Connicpu/thermostat/README.md

# Thermostat V3

Shared as-is — not seeking contributions or pull requests.

ESP32-C6 Zigbee thermostat for single-stage HVAC (R/C/W/Y/G), with e-paper display, SHT40 temperature/humidity sensor, and triac outputs. Designed for JLCPCB assembly.

## Gallery

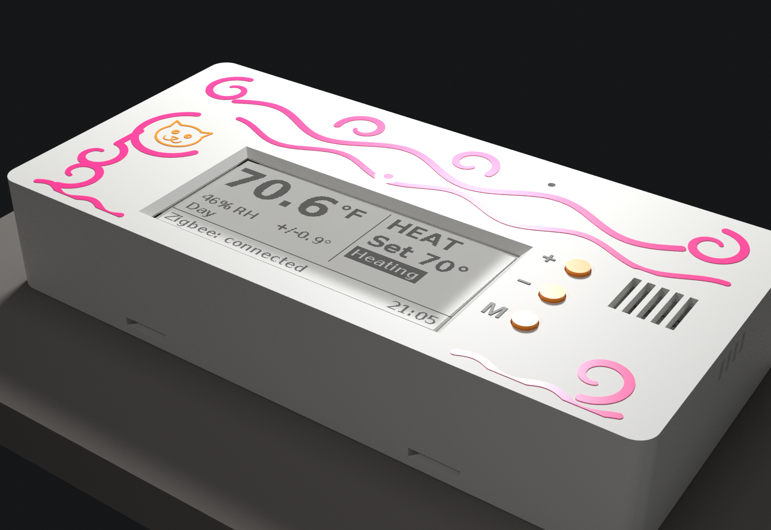
[picture p1: renders/v3-assembled.png]
Assembled V3 case — home screen at 70.6 °F, heating to 70°, Zigbee connected, 21:05 (Day)


On-device screens (296×128 e-paper, shown at 2×; °F):

| Home | Menu |
|---|---|
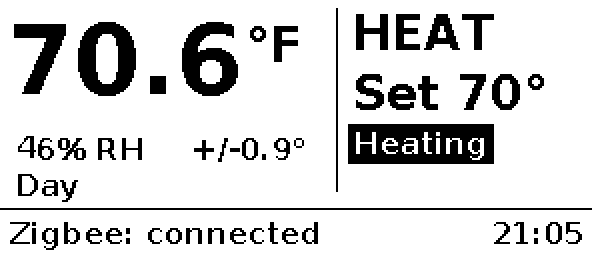
[picture p2: firmware/docs/display_preview.png]
home screen, 21:05
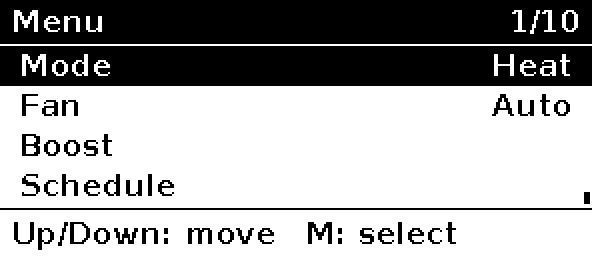
[picture p3: firmware/docs/display_menu_main.png]
main menu
|  |  |
| **Schedule** | **Boost to** |
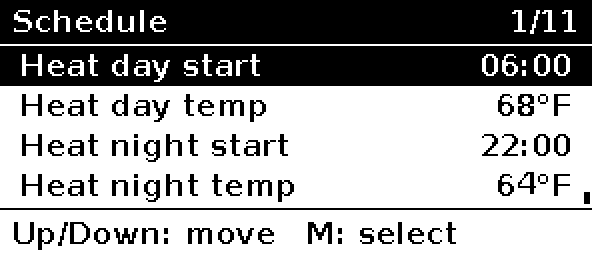
[picture p4: firmware/docs/display_menu_schedule.png]
schedule menu
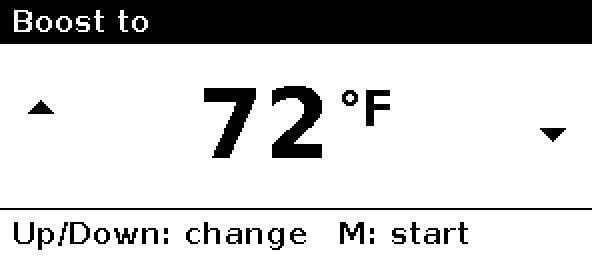
[picture p5: firmware/docs/display_menu_boost_target.png]
boost to target
|  |  |

Home Assistant Lovelace card ([install](firmware/ha/lovelace-card/README.md)):

| Heat, day (light) | Cool, night (dark) | Timed heat boost (dark) |
|---|---|---|
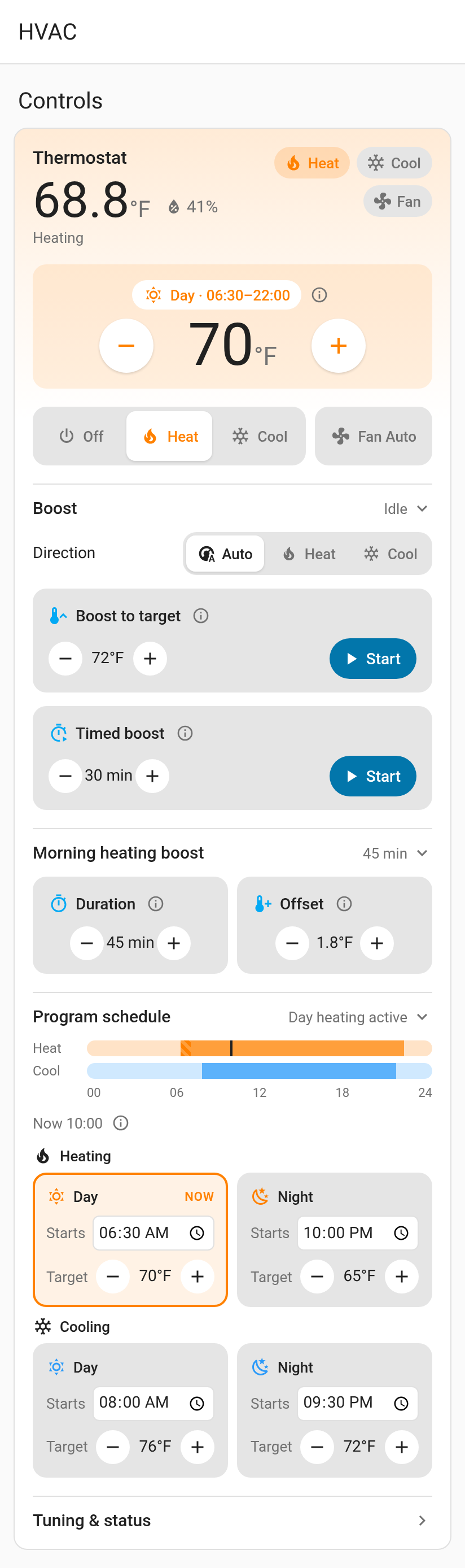
[picture p6: firmware/ha/lovelace-card/screenshots/heat-day-light.png]
card, heating by day, light theme
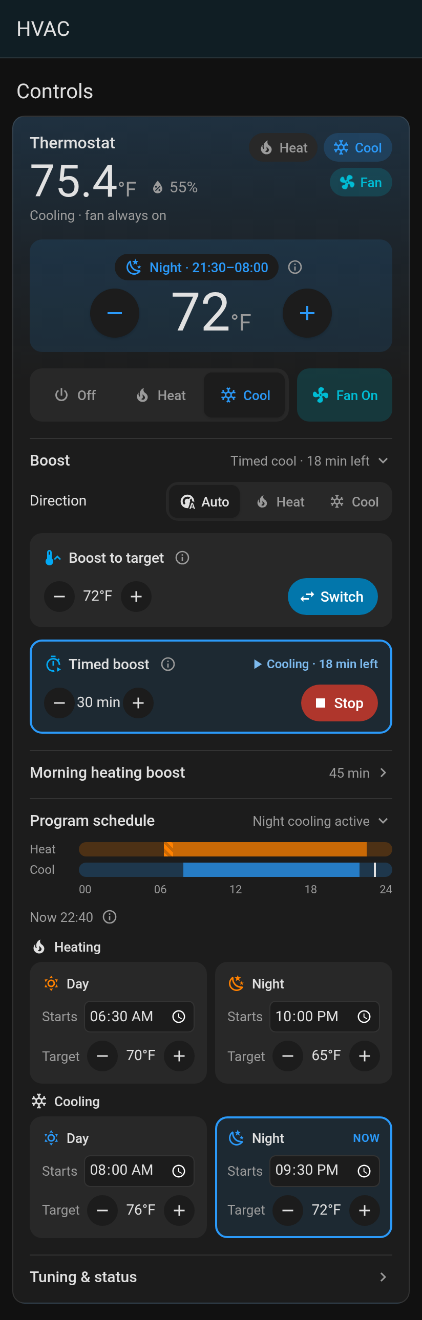
[picture p7: firmware/ha/lovelace-card/screenshots/cool-night-dark.png]
card, cooling at night, dark theme
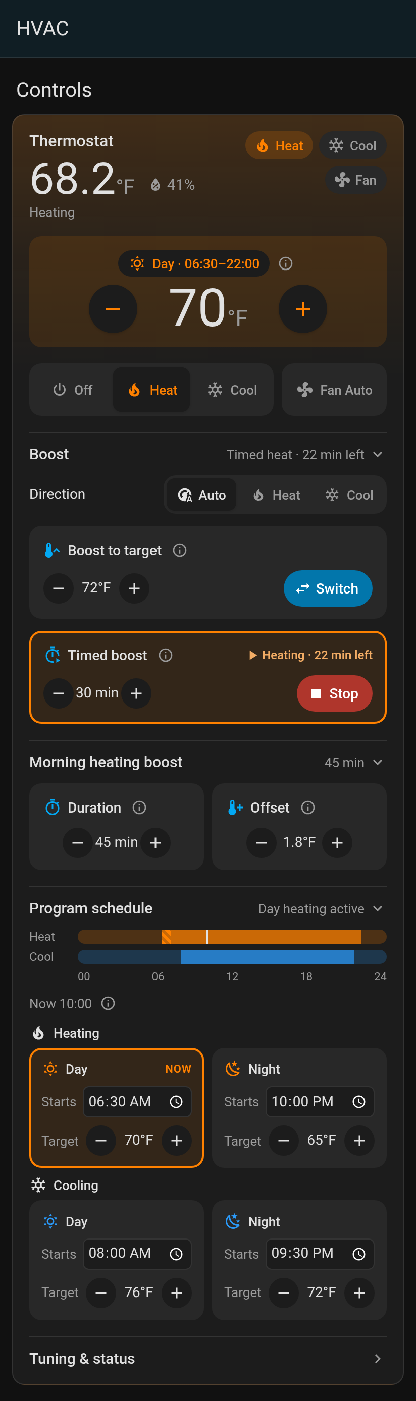
[picture p8: firmware/ha/lovelace-card/screenshots/heat-boost-dark.png]
card, timed heat boost running, dark theme
|  |  |  |

More: case renders in [case/](case/), every menu screen in [firmware/README.md](firmware/README.md).

## Case

The case (`case/thermostat_case.scad`) is a 147 × 71 × 26.25 mm PETG shell, backplate, and panel carrier for a Bambu P2S with a 0.4 mm nozzle. The carrier holds the display panel with its nominal back 4.45 mm above the board. The panel rests on stops 0.15 mm under that, located by the long-edge fences and the cable-end posts. Four bridges in the shell press the border. The flex plugs into J4 with the display panel seated on the stops. A thin corner can leave J4; the shell comes off, the tail is pressed back in, and the slider is closed. A fingernail shuts the slider on the ear's +x face, and a fingertip on the carrier push opens it toward +x. The shell clips to the backplate. It does not clamp the board. The three buttons snap into the face from the inside and stay in the shell. Each cap is a 65° cone and one 0.40 mm leaf. The leaf is a cantilever, free length 4.35 mm, and it only keeps the cap in the face. The print adds a 0.34 mm nub on the cone top under the free end so the leaf's bed-facing face is a bridge, and that nub is snapped off before the cap goes into the tube. [case/ASSEMBLY.md](case/ASSEMBLY.md) is the build order, the fold dimensions, and the service steps.

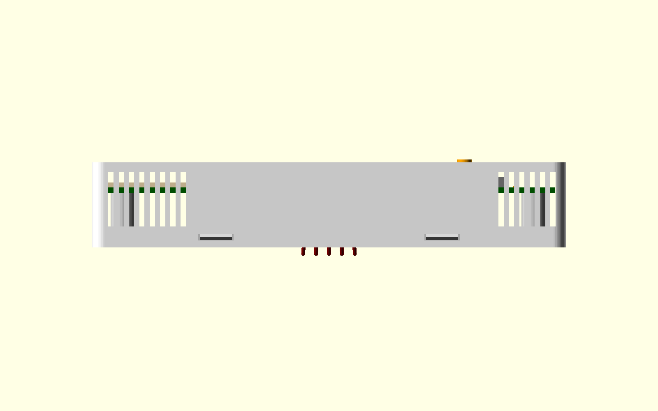
[picture p9: case/case-section-airflow.png]
Section through the sensor duct at the SHT40 (board y = 32). The two ribs divide the rear cavity; the front curtain and partition divide the face side.


Air inside the case is split into three zones:

- **Hot zone** (left). The triacs, the opto drive side, the buck, and the bridge. Slots in the bottom edge and the lower left wall let room air in. Matching slots in the top edge and the upper left wall let it out. A front curtain just left of the display keeps that air from spilling under the panel.
- **Middle zone.** The ESP32-C6, the display, and the wiring hole. This zone has no vents of its own. Close the hole in the wall around the cable with a printed PETG plug so that air stays in the middle zone.
- **Sensor duct** (right). The SHT40 island. Bottom-edge slots and a band of slots on the right wall feed it. The top-edge slots and the front island slots exhaust it. Two ribs on the backplate and a partition in the shell separate it from the middle zone. The backplate under the island is solid, because slots there would face the drywall and open the duct onto the wall.

The ribs stop 0.4 mm short of the board, and above the lip they run out to the lip's outer face so they come within 0.3 mm of the shell. The zone walls keep at least 0.5 mm off the parts, including the USB-C shield legs and locating peg on the back of the board. Front clearances include the ±0.16 mm board-thickness tolerance.

**Expected benefit.** A zonal model puts the triac-induced sensor rise about **10–25% lower** than the same case with one undivided cavity (no ribs, partition, or curtain). That is a model, not a measurement. Most of the remaining error is heat flowing along the PCB ground pour, which a case cannot stop, and the vents themselves carry only a small share of the hot zone's heat. The walls matter more than the hole count: they also help keep wall-cavity air from the wiring hole away from the sensor.

**Check it.** Log a heat call and a cool call against a reference thermometer, with a clamp meter on W, Y, and G. Taping the edge slots removes only the vents, about 6% of the modeled sensor rise; the ribs, partition, and curtain stay, so expect little difference. Measuring what the walls do needs a second print without the ribs, partition, and curtain. The two offsets add, so use only one. `CONFIG_THERMO_SELF_HEAT_OFFSET_C100` is build-time (`menuconfig`, then a reflash) and defaults to 0. ZHA sets the thermostat's LocalTemperatureCalibration attribute, in 0.1 °C steps over ±2.5 °C, applied on top of that build-time offset. About −0.1 °C is an unmeasured guess until a reference-thermometer log exists.

`board.stl` is not in the repo. From the repo root, export the populated board with KiCad 9 (do not pass `--drill-origin`; `scripts/case_fit.py` places the model):

```
kicad-cli pcb export stl -o board.stl --force --cut-vias-in-body kicad/thermostat-v3.kicad_pcb
```

The script header also has the OpenSCAD lines for the assembly-frame `back.stl`, `shell.stl`, `carrier.stl`, and the seated and pressed button meshes it checks against. The flex fold, the tail insertion, the carrier clearances, and the button travel run even when `board.stl` is absent.

- kicad/: KiCad 9 project
- fab/: Gerbers plus JLC BOM/CPL
- part-plan.md: part choices, sources, cost estimate
- v2-original/: the previous V2 design

Warning: don't connect USB while 24VAC is wired unless you use a USB isolator.
First-time flashing on Arch Linux: [docs/flashing-arch.md](docs/flashing-arch.md).

This project is shared as-is. It is not seeking contributions or pull requests.

## License

MIT — see [LICENSE](LICENSE). Third-party notices (Lit, Material Design Icons, DejaVu/Bitstream,
Espressif, Good Display sequences, LCSC STEP models, …) are in [NOTICE](NOTICE).

## Security

This is a DIY thermostat that switches 24 VAC HVAC loads. Treat the Zigbee network perimeter as
the security boundary:

- **OTA is unsigned.** The device accepts Zigbee OTA images and installs them with `esp_ota_*`
  (rollback via pending-verify exists). Anyone who can run an OTA server the device trusts can
  push firmware. There is no image signature check.
- **Join policy is open.** `install_code_policy` is false, so pairing uses the Zigbee 3.0
  well-known trust-center link-key path (normal for Home Assistant / ZHA). Don't leave the
  network open to joining when you aren't pairing.
- **USB Serial/JTAG console** is enabled in `sdkconfig.defaults`. Physical USB access to the
  board gives a console.
- Factory reset from the on-device menu is intentional.

See also [MANUFACTURER_ID.md](MANUFACTURER_ID.md) for the Zigbee manufacturer code (`0x434E`:
this project's DIY code from the quiet `0x3000`–`0x5FFF` band; not CSA-assigned, not certified).

## Third-party / display provenance

E-paper driver sequences in `firmware/components/display/ssd1680.c` follow Good Display's
GDEY029T94 sample/datasheet (not a verbatim copy of their sample tree). Full attribution is
in [NOTICE](NOTICE).
