Connicpu/thermostat/firmware/ha/lovelace-card/README.md

# Connie Thermostat V3 card

A custom Lovelace card for the thermostat, for Home Assistant with ZHA and the
[`connie_thermostat_v3` quirk](../zha_quirk/). It replaces the stock thermostat tile and the plain
number tiles with a single card that covers everything the quirk exposes.

| Light | Dark |
|---|---|
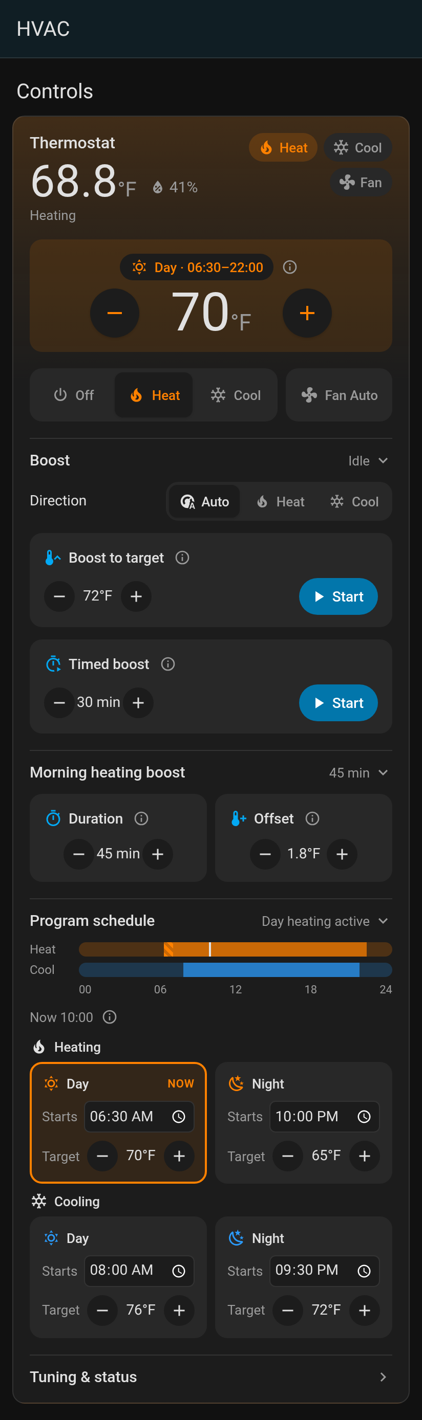
[picture p31: firmware/ha/lovelace-card/screenshots/heat-day-dark.png]
|  |  |
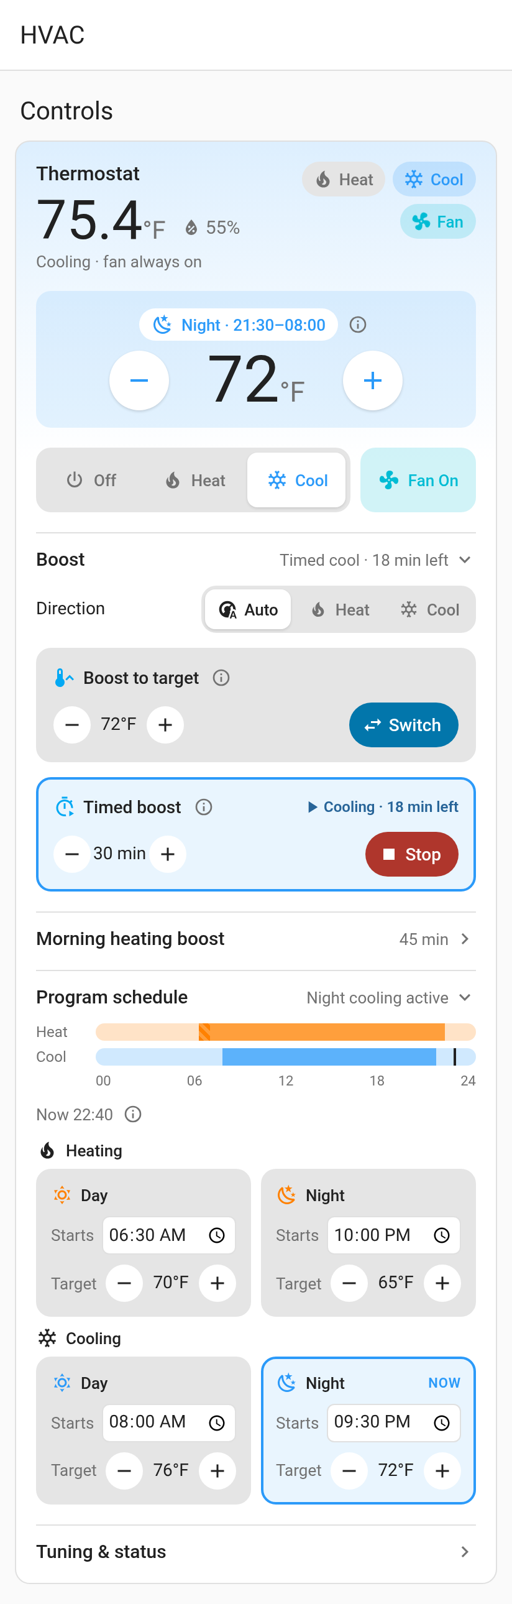
[picture p32: firmware/ha/lovelace-card/screenshots/cool-night-light.png]
|  |  |

## What it shows

* **Room:** temperature and humidity, plus Heat / Cool / Fan chips for the running state (`hvac_action`, fan mode).
* **Setpoint:** − / + buttons with a badge for the active program period (Day, Night, Morning boost, or
  "Day (no clock)") and its hours. The (i) next to the badge names the program value the buttons change,
  e.g. *Changes the Day heating program setpoint*. On the thermostat, the setpoint *is* the current
  period's program temperature. Taps are batched (0.5 s) into one `climate.set_temperature`; an unsent value shows in italics
  with a dotted underline, and screen readers hear "sending…". The value is a keyboard slider: arrows ±1 step,
  PageUp/PageDown ±5, Home/End min/max.
* **Mode:** Off / Heat / Cool only (any Auto / heat_cool is filtered out), plus a **Fan On / Auto** toggle.
* **Boost** (first, starts open): a Direction switch (Auto / Heat / Cool), then one tile per boost.
  *Boost to target* holds the target stepper and its Start button on one line; *Timed boost* does the same with the
  length. A running boost outlines its tile, shows the time left there, and its button turns into Stop.
  The other tile's button reads *Switch*, because the firmware replaces a running boost with a new one
  (`CtrlBoostStart`). Start flushes a not-yet-sent target or length first, so it never starts with a stale
  value. Start, Stop and Direction are disabled while the thermostat is unavailable.
* **Morning heating boost:** two tiles, Duration and Offset, each with its own stepper.
* **Program schedule:** a 24 h timeline for heating and cooling (day solid, night light, morning boost
  hatched, a marker for now). Below it, Day and Night tiles for each mode with the start time and target;
  the tile in use is outlined and tagged NOW.
* **Tuning & status:** temperature swing, temperature offset, program period, last boost result. Starts closed.
* **Help text** sits behind small (i) buttons, so the card stays quiet. Each opens on hover, focus or tap,
  closes on Esc (consumed only when a tooltip was open) or a click elsewhere, opens above its row (the setpoint one opens in place, on click/tap only, and pushes the value down), and is linked with `aria-describedby`.
* **Warnings** always stay visible: device unavailable, no clock yet (holding the day program), and failed boosts (rejected, failsafe, limit).
* **Failed writes:** if Home Assistant rejects a change, or doesn't answer within 10 s, the card drops the
  unsent value, doesn't start a boost that depended on it, and shows an error banner. The banner closes
  by itself after 10 s or with its × (Dismiss error) button.

Boost, Morning heating boost, Program schedule and Tuning & status collapse. The browser remembers
each section on its own for this card's climate entity and restores it when the dashboard is opened
again. Cards for different thermostats remember separately. Two cards or tabs on the same climate
entity each keep their own in-memory open and closed sections until a reload, which restores the
remembered state. `collapsed` adds sections that start closed when nothing is remembered for them;
a remembered choice wins. If storage is unavailable, the choice lasts for this visit and the next
visit uses the defaults.

While the thermostat is actively heating or cooling (its `hvac_action`), the top of the card
gets a soft orange or blue tint, like HA's own thermostat card. Idle, off and fan-only show no tint.

### Units
Temperatures follow Home Assistant's unit system. HA already converts the climate entity and the
temperature-class number entities, e.g. to °F. The swing, the morning-boost offset and the temperature
offset are temperature *differences*, so they have no temperature device class and HA leaves them in °C.
For a °F user the card shows them ×1.8 (0.5 °C → 0.9 °F, 0.1 °C → 0.2 °F) and still writes °C values
in the entity's own step. The offset entity is ZHA's standard *Local temperature calibration* number
(±2.5 °C, step 0.1), not a quirk entity. ZHA turns that number into the raw int8 with `int(°C / 0.1)`,
which is one tenth low for some steps (0.3 °C would be stored as 0.2). The card adds 1e-8 °C away
from zero on the write only, then clamps that number to the entity's −2.5 to 2.5 °C limits. The two
end steps already land on ±25, so they are sent unchanged. The tenth on screen is the tenth stored,
and the shown value stays on the 0.1 °C grid.

## Install

The card is the single file `dist/connie-thermostat-card.js`. Lit and the icons are bundled in, so it
makes no network requests.

**Manual (Lovelace resource)**
1. Copy `dist/connie-thermostat-card.js` to `/config/www/connie-thermostat-card.js`.
2. Go to Settings → Dashboards → ⋮ → Resources → Add resource, enter URL `/local/connie-thermostat-card.js`
   and pick type *JavaScript module*. In YAML mode, add it under `lovelace: resources:` instead.
3. Reload the browser, then edit the dashboard → Add card → **Connie Thermostat V3**.

**HACS (custom repository)**
1. HACS → ⋮ → Custom repositories → `https://github.com/Connicpu/thermostat`, type *Dashboard*.
2. HACS installs `connie-thermostat-card.js` from the **GitHub release asset** (see the root `hacs.json`).
   The release workflow attaches it (see *Releasing*). This repo keeps the card in a subfolder, and HACS
   only looks in the repo root, its `dist/`, or release assets.

## Configure
The visual editor has a device picker, filtered to manufacturer `Connie` / model `thermostat-v3`, a name,
section toggles, and an *Entity overrides* panel. With no device set, the card uses the first Connie
thermostat it finds. Entities are matched on the device by the quirk's `translation_key`, then by
entity_id suffix (e.g. `_day_heating_start`). The editor reports how many of the 25 entities it found.
YAML options are in [`example.yaml`](example.yaml):

| Option | Default | Meaning |
|---|---|---|
| `device_id` | first Connie thermostat-v3 | Device to show |
| `name` | device name | Card title |
| `show_schedule`, `show_morning_boost`, `show_manual_boost`, `show_status` | `true` | Show or hide a section |
| `collapsed` | `[status]` | Sections that start closed (`schedule`, `morning`, `boost`, `status`) when this browser has no remembered choice for them. They can still be opened by tapping, and that choice is what the next visit restores. Listing a section here only adds to the defaults |
| `entities` | auto | Override any discovered entity (keys as in `src/model.js` `ENTITY_KEYS`) |

## Releasing
Push a tag named `card-vX.Y.Z` (e.g. `git tag card-v1.0.0 && git push origin card-v1.0.0`).
`.github/workflows/card-release.yml` runs the tests, checks that `dist/` matches a fresh build, then
attaches `dist/connie-thermostat-card.js` and `dist/THIRD_PARTY_LICENSES.txt` to that tag's GitHub release, creating the release if needed.
The workflow has only `contents: write`, and every action is pinned by SHA. Bump `CARD_VERSION`
(`src/connie-thermostat-card.js`) and `package.json` first. Firmware tags don't trigger it.

**HACS installs from the newest GitHub release in this repo, whatever kind it is.** If a release without
`connie-thermostat-card.js` (e.g. a firmware release) becomes the latest, HACS can't install or update the card.
There is no firmware release workflow today, so this is enforced by hand: every release in this repo must have
`connie-thermostat-card.js` attached. For a manual firmware release, upload `dist/connie-thermostat-card.js`
too (`gh release upload <tag> firmware/ha/lovelace-card/dist/connie-thermostat-card.js`). Any future
firmware release workflow should attach it the same way `card-release.yml` does.

## Develop

```sh
npm ci
npm test              # vitest + happy-dom, mocked hass (test/mock-hass.js)
npm run build         # esbuild -> dist/connie-thermostat-card.js (commit it; CI checks it's up to date)
CHROME_PATH=/usr/bin/google-chrome npm run screenshots
                      # headless Chrome renders demo/ to screenshots/*.png (light + dark, plus boost close-ups),
                      # then opens every tooltip at 412 and 320 px and fails if one leaves the card or
                      # covers its own row's controls, and checks the run chip and Start/Switch/Stop text
                      # reach 4.5:1 contrast in both themes
```

`npm run screenshots` (and its geometry check) needs a local Chrome or Chromium. It uses `CHROME_PATH`, or
`--chrome /path`, and falls back to `/usr/bin/google-chrome`. playwright-core never downloads a browser.

`demo/index.html` loads the built card with the mock hass and HA's default light/dark theme variables.
Serve this folder and open `demo/?theme=dark&scenario=cool-night`. The scenarios are `heat-day`,
`cool-night`, `morning-boost` and `tooltip` (the setpoint tooltip pinned open).

Source: `src/model.js` (discovery, units and schedule maths; no DOM), `src/connie-thermostat-card.js`,
`src/editor.js`, `src/styles.js` and `src/icons.js`.

## License

MIT (repo root). Bundled Lit (BSD-3) and @mdi/js (Apache-2.0 / Pictogrammers) notices ship in `dist/connie-thermostat-card.js`; the full Lit BSD-3 text is in `dist/THIRD_PARTY_LICENSES.txt` (also attached to each card release); see also the repo [NOTICE](../../../NOTICE).

## Changelog

* **1.3.0**: Tuning & status has a temperature offset control. It writes ZHA's Local temperature calibration number, ±2.5 °C in 0.1 °C steps, and shows that difference in the display unit.
* **1.2.0**: text on the card can be selected. Each collapsible section remembers whether it is open or closed, stored in the browser per climate entity, and falls back to the defaults when storage is unavailable.
* **1.1.1**: a running boost tile (and its run chip) uses the heat or cool colour of the boost, with "Heating"/"Cooling" in the chip text; unknown direction keeps the theme accent. Morning boost tiles use the heat colour while running. New heat-boost demo scenario. Run chip and Start/Switch/Stop text meet 4.5:1 contrast in both themes (checked by the screenshot script).
* **1.1.0**: boost redesign (each value sits on the control that sets it; Start/Switch/Stop on the same
  tile); boosts above the schedule; explainers moved into info tooltips; accessible setpoint slider;
  Start waits for pending writes; 10 s service-call timeout; dismissible error banner; heating/cooling
  tint on the top of the card.
* **1.0.0**: first release.
