Connicpu/thermostat/part-plan.md

# Thermostat V3 – Part Plan (current: rev 14, 2026-10-13)
This top section describes the board. The sections under "Change history" further down are kept for traceability; parts named there (BT136S, T435, SMBJ40A, 100 µF bulk, 68 µH / 3 Ω EPD boost, Si1308) are **superseded**.
The authoritative BOM is fab/thermostat-v3-BOM-JLC.csv, with prices and stock in fab/bom_prices.json (JLC API).

## Architecture (current)
- **24VAC input:** R goes through F1 (mSMD050-60V, a 0.5 A 60 V PTC) to the MB10S bridge D1. D1 + goes through R51 (3.3 Ω 0.75 W pulse-proof) to VIN_HV.
  - VIN_HV has D2 (SMBJ40CA TVS), C1/C2/C41/C42 (4.7 µF 100 V X7R 1210) and C43 (47 µF 63 V, 8x9 THT, back side, hand-soldered).
  - D1 − is board GND, so board GND is **not** HVAC C.
- **3.3 V supply:** an LMR16006XDDCR buck (60 V, 0.6 A, 700 kHz) with L1 (22 µH SWPA6045S220MT, Isat 2.2 A), D4 (SS210) and an FB divider of 33k/10k (3.29 V). R50 (100k) pulls EN up to VIN.
- **USB (flash only):** USB-C J2, with VBUS going through D3 (SS210) into VIN_HV, so it can't backfeed from 24 V. D+/D- go to C6 IO13/IO12 with USBLC6 ESD, and CC1/CC2 have 5.1k each.
  - **Never connect USB while 24VAC is wired.** There is a silk warning beside J2 and near the buttons.
- **MCU:** ESP32-C6-WROOM-1-N8, Zigbee sleepy end device.
- **HVAC outputs W/Y/G:** GPIO → 220R → MOC3063S (zero-cross; 10k pull-downs on the drive lines). The opto output gets 100R from R, there's 1k from gate to MT1, and the triac is a **T405-600B** (ST logic-level, IGT 5 mA, IH 10 mA, 4 A 600 V, DPAK; tab = MT2 = R).
  - The RC snubbers (R24/R34/R44 100R + C20/C21/C22 100 nF) are **DNP**.
- **Watchdog:** STWD100NYWY3F, with WDO going to EN. ~EN has a 10k pull-up, so it stays disarmed until firmware drives IO11 low; firmware kicks it on IO10.
- **Display:** GDEY029T94 2.9" (SSD1680) on J4, an AFC07 24-pin 0.5 mm FPC, wired for 4-wire SPI (BS1 to GND).
  - Boost: L2 47 µH (ANR3015T470M), Q1 AO3400A, R16 2.2 Ω RESE, R15 1M gate pull-down, D6-D8 B5819W, C40 4.7 µF 25 V, plus 1 µF 50 V on VSH1/VSH2/VSL/VGH/VGL/VCOM and 1 µF on VDD.
- **Sensor:** SHT40-AD1B (0x44) on a slotted thermal island; only +3V3/GND/SDA/SCL may enter (DRC rule). There's also a Stemma QT port (J3, DNP).
- **UI:** UP/DOWN/MODE buttons (IO4/IO5/IO3), RESET, BOOT (IO9) and a red LED on IO8.
- **Hand-soldered / not assembled by JLC:** J1 (15EDGRC-3.5-05P right-angle header, back side, with the 15EDGK-3.5-05P plug) and C43. J3 is optional.

## Current BOM (JLC assembled; 37 lines)
| Refs | Value | Footprint | LCSC | JLC type | Notes |
|---|---|---|---|---|---|
| R21,R31,R41 | 220R | R_0402_1005Metric | C25091 | basic |  |
| C40 | 4.7uF 25V | C_0805_2012Metric | C1779 | basic |  |
| L2 | 47uH | L_APV_ANR3015 | C7427088 | extended |  |
| C30,C31,C32,C33,C34,C35 | 1uF 50V | C_0603_1608Metric | C15849 | basic |  |
| Q1 | AO3400A | SOT-23_AO3400A | C20917 | basic |  |
| Q2,Q3,Q4 | T405-600B | TO-252_BT136S | C283473 | extended | T405-600B-TR (ST T4 logic-level, IGT 5mA IH 10mA) |
| R2,R5,R6,R7,R8,R9,R11,R12,R20,R30,R40 | 10k | R_0402_1005Metric | C25744 | basic |  |
| C4,C5,C7,C39 | 10uF | C_0603_1608Metric | C19702 | basic |  |
| C3,C8,C10,C11 | 100nF | C_0402_1005Metric | C1525 | basic |  |
| D3,D4 | SS210 | SMA_SS210 | C14996 | basic | SS210 100V 2A Schottky |
| C6,C9,C36,C38 | 1uF | C_0402_1005Metric | C52923 | basic |  |
| SW1,SW2,SW3,SW4,SW5 | TS-1187A-B-A-B | SW_TS1187A | C318884 | basic |  |
| R1 | 33k | R_0402_1005Metric | C25779 | basic |  |
| U1 | LMR16006XDDCR | SOT-23-6_LMR16006 | C87080 | extended |  |
| R23,R33,R43 | 1k | R_0805_2012Metric | C17513 | basic |  |
| J2 | USB-C | USB_C_Receptacle_HRO_TYPE-C-31-M-12 | C165948 | extended |  |
| R22,R32,R42 | 100R | R_0805_2012Metric | C17408 | basic |  |
| U3 | ESP32-C6-WROOM-1-N8 | ESP32-C6-WROOM-1 | C5366877 | extended |  |
| R3,R4 | 5.1k | R_0402_1005Metric | C25905 | basic |  |
| D5 | RED | LED_0603_KT | C2286 | basic |  |
| R13,R14 | 4.7k | R_0402_1005Metric | C25900 | basic |  |
| R50 | 100k | R_0402_1005Metric | C25741 | basic | 0402WGF1003TCE |
| U4 | STWD100NYWY3F | SOT-23-5_STWD100 | C46043 | extended |  |
| U5 | SHT40-AD1B | Sensirion_DFN-4_1.5x1.5mm_P0.8mm_SHT4x_NoCentralPad | C2909890 | extended |  |
| C1,C2,C41,C42 | 4.7uF 100V X7R | C_1210_3225Metric | C381466 | extended | FS32X475K101EGG |
| J4 | 2.9in EPD FPC | FPC24_AFC07 | C262567 | extended |  |
| U6,U7,U8 | MOC3063S | MOC3063S | C77950 | extended |  |
| R16 | 2.2R | R_0603_1608Metric | C22939 | basic |  |
| R15 | 1M | R_0402_1005Metric | C26083 | basic |  |
| D6,D7,D8 | B5819W | SOD-123_B5819W | C8598 | basic |  |
| D1 | MB10S | MBS_MB10S | C2488 | basic |  |
| D2 | SMBJ40CA | SMB_SMBJ40A | C19077590 | preferred-ext | SMBJ40CA (bidirectional, JLC preferred-extended) |
| F1 | 0.5A 60V PTC | F1812_PTC | C70113 | extended | mSMD050-60V |
| R10 | 1k | R_0402_1005Metric | C11702 | basic |  |
| R51 | 3.3R 0.75W pulse | R_1206_3216Metric | C844038 | extended | CRCW12063R30FKEAHP (Vishay pulse-proof, 750 mW) |
| L1 | 22uH | L_Sunlord_SWPA6045S | C83454 | extended | SWPA6045S220MT 22uH Isat 2.2A 89mOhm |
| U2 | USBLC6-2SC6 | SOT-23-6_USBLC6 | C7519 | extended |  |

## Layout rules (kicad/thermostat-v3.kicad_dru)
- `hv_to_lv_clearance`: at least **0.6 mm** between HVAC_*, R_FUSED, VIN_RECT, OPTO_MT2_*, GATE_* and SNUB_* and any other net (IPC-2221B B2, 31-100 V).
- `hv_pour_clearance`: the GND pour stays at least **1.0 mm** from those nets.
- OPTO_GAP_U6/U7/U8: keepouts on both F.Cu and B.Cu over the isolation gap between each opto's output pins (4-6) and LED pins (1-3), x 132.3-137.1 mm. They block tracks, vias and copper pour, so the gap has 0 mm² of copper. `opto_gap_no_lv` remains as a backstop.
- Thermal island: only sensor nets, with traces of 0.25 mm max. Antenna keepout under the C6 antenna.

## Pin map (ESP32-C6-WROOM-1) – matches firmware/main/board.h
| Pin | GPIO | Net |
|---|---|---|
| 8 / 9 / 27 | IO0 / IO1 / IO2 | DRV_W / DRV_Y / DRV_G |
| 4 / 5 / 26 | IO4 / IO5 / IO3 | BTN_UP / BTN_DOWN / BTN_MODE (10k pull-ups) |
| 6 / 7 | IO6 / IO7 | I2C SDA / SCL (4.7k) – SHT40 + Stemma QT |
| 10 | IO8 | LED_STAT (active-low, 10k pull-up, strap) |
| 15 | IO9 | BOOT button (strap) |
| 11 / 12 | IO10 / IO11 | WD_WDI / WD_EN (active-low arm) |
| 13 / 14 | IO12 / IO13 | USB D- / D+ |
| 16–21 | IO18–23 | EPD MOSI, SCK, CS, DC, RST, BUSY |
| 23, 24, 25 | IO15, RXD0, TXD0 | not connected |

## Installation notes
1. Turn off power to the furnace/air handler (24 VAC transformer) before touching the wires.
2. Mount the backplate on the drywall with the anchors, pulling the R, C, W, Y and G wires through the centred hole.
3. **Close the wire hole** with a printed PETG plug around the cable, the same material as the case. Wall-cavity drafts otherwise blow over the SHT40 and skew the reading.
4. Wire the 15EDGK plug: R, C, W, Y, G left to right, as printed on the back silk under J1. Then plug the board in and close the case.
5. Never connect USB while the 24 VAC plug is in, because board GND is the bridge's negative node. Flash on the bench.

---
# Change history (superseded entries; kept for traceability)
## (rev 2 original header and architecture – superseded)
> ## Architecture (as implemented in kicad/thermostat-v3.kicad_sch)
> - **24VAC input:** 24VAC R/C goes through a 0.5 A 60 V PTC (F1), an MB10S bridge (D1) and a 3.3 Ω pulse resistor (R51) to VIN_HV, which has the SMBJ40A TVS (D2), 4× 4.7 µF 100 V ceramics and the 47 µF/63 V rear electrolytic (C43).
> - **3.3 V supply:** an **LMR16006X buck (60 V max, 0.6 A, 700 kHz)** with a 22 µH inductor and SS210 catch diode makes +3V3.
>   - The X (700 kHz) version was chosen over the Y (2.1 MHz) version because the minimum on-time at ~40 V in → 3.3 V out is too short at 2.1 MHz.
> - **USB:** USB-C VBUS goes through a B5819W into VIN_HV (diode-OR; the bridge itself is the other "diode"). USB D+/D- go straight to the C6's native USB, with USBLC6 ESD protection.
> - **MCU:** ESP32-C6-WROOM-1-N8 (Zigbee). **Firmware default: Zigbee end device** (rx-off-when-idle / light-sleep between polls) to limit self-heating. A router role is optional later.
> - **HVAC outputs, ×3 (W, Y, G):**
>   - GPIO → 220R → MOC3063 zero-cross opto (10k pull-down on each drive line, so outputs are off when the GPIO is high-Z)
>   - opto → 100R from R, 1k gate-MT1 → BT136S-600D triac switching R onto W/Y/G
>   - **DNP RC snubber footprint per channel** (100R 0805 + 100 nF 50 V 0805, across MT2–MT1)
> - **Watchdog:** STWD100NY (1.6 s), open-drain WDO wired to ESP EN.
>   - Its ~EN pin has a 10k pull-up, so the watchdog is **disarmed at boot and while flashing**.
>   - Firmware arms it by driving IO11 low and kicks it on IO10.
>   - If firmware hangs → watchdog resets the ESP → GPIOs go high-Z → triacs off.
> - **Display:** 2.9" 296×128 SSD1680 panel (GDEY029T94 / Waveshare 2.9" V2) on a 24-pin 0.5 mm FPC.
>   - Onboard boost per the Waveshare reference schematic: **68 µH**, Si1308EDL, **3 Ω sense resistor (B/W 2.9")**, 10k gate pull-down, 3 Schottky pump diodes (B5819W, which is basic, instead of MBR0530), and 1 µF caps on VSH1/VSH2/VSL/VGH/VGL/VCOM/VDD/VPP.
>   - BS1 is tied to GND (4-wire SPI).
> - **Sensor:** SHT40 on a slotted thermal island (4 slots, power/I2C enter through one bridge, no GND pour on the island), plus a Stemma QT port.
> - **UI:** UP / DOWN / MODE buttons, RESET and BOOT buttons, and one red status LED (IO8; pull-up keeps the strap pin high).
>

## Verified changes since rev 1
| Item | Decision | LCSC | Type | Stock | Unit $ |
|---|---|---|---|---|---|
| Buck | **LMR16006XDDCR** (4–60 V in, 0.6 A, async) | C87080 | ext | 33,642 | 0.57 |
| Buck inductor | SWPA6045S220MT 22 µH, Isat 2.2 A, 89 mΩ, 6×6×4.5 (rev 9; was SWPA4030S220MT C83472) | C83454 | ext | 40,752 | ~0.10 |
| Surge resistor R51 | CRCW12063R30FKEAHP 3.3 Ω 1206 0.75 W pulse-proof (rev 9) | C844038 | ext | 27,862 | ~0.03 |
| Catch diode | SS210 (100 V 2 A) | C14996 | basic | 708,928 | 0.03 |
| Input bulk cap | **100 µF 63 V** 10×10.5 SMD (RVT63V100M10X10) | C51953411 | ext | 26,682 | 0.18 |
| Input ceramic | 2.2 µF 100 V 1206 | C170101 | ext | 166,291 | 0.13 |
| TVS | SMBJ40A (40 V standoff, so a 26–28 VAC line won't conduct) | C114003 | ext | 3,355 | 0.05 |
| PTC | SMD1812P050TF/30 | C12559 | ext | 21,463 | 0.11 |
| EPD boost L | **68 µH** 3×3 (ANR3015T680M) – per Waveshare 2.9" schematic | C7427091 | ext | 4,085 | 0.04 |
| EPD sense R | **3 Ω** 0402 (Waveshare: 3R for 2.9" B/W; 0.47R only for B/C) | C423196 | ext | 36,784 | <0.01 |
| EPD FPC | **Jushuo AFC07-S24FCA-00, bottom contact, flip-lock** (KiCad footprint exists) | C262567 | ext | 49,144 | 0.13 |
| Triac | BT136S-600D TO-252 | C18186224 | ext | 25,450 | 0.10 |
| Watchdog | STWD100NYWY3F (switched from TPS3823 because it has an ENABLE pin, so it doesn't fire during flashing) | C46043 | ext | 21,379 | 0.39 |
| HVAC terminal | 15EDGRC-3.5-05P header (hand-solder) + 15EDGK-3.5-05P plug | C7603439 / C7603433 | ext | 1,234 / 800 | 0.27 / 0.84 |

The full priced BOM is in fab/thermostat-v3-BOM-JLC.csv and fab/bom_prices.json: 38 lines, **18 unique extended parts**.

### FPC contact orientation
- Waveshare's FAQ specifies a "0.5 mm 24-pin rear-flip 2.0H" socket.
- I chose a **bottom-contact** flip connector: with the panel lying face-up on the board's top side and its tail running straight out into the connector, the gold fingers face down (toward the PCB).
- **Before ordering, confirm on a physical panel that the GDEY029T94 fingers are on the side opposite the display face.**
- If they aren't, swap to the double-sided-contact HDGC 0.5K-HX-24PWB (C2919499, 3,685 in stock, contacts on both sides). That part needs a custom footprint.

## Pin map (ESP32-C6-WROOM-1)
| Pin | GPIO | Net |
|---|---|---|
| 8 / 9 / 27 | IO0 / IO1 / IO2 | DRV_W / DRV_Y / DRV_G |
| 4 / 5 / 26 | IO4 / IO5 / IO3 | BTN_UP / BTN_DOWN / BTN_MODE (10k pull-ups) |
| 6 / 7 | IO6 / IO7 | I2C SDA / SCL (4.7k) – SHT40 + Stemma QT |
| 10 | IO8 | LED_STAT (active-low, 10k pull-up, strap) |
| 15 | IO9 | BOOT button (strap) |
| 11 / 12 | IO10 / IO11 | WD_WDI / WD_EN (active-low arm) |
| 13 / 14 | IO12 / IO13 | USB D- / D+ |
| 16–21 | IO18–23 | EPD MOSI, SCK, CS, DC, RST, BUSY |
| 23, 24, 25 | IO15, RXD0, TXD0 | spare / NC |

## Cost estimate – 5 assembled boards + 2 panels
| Item | Basis | USD |
|---|---|---|
| PCB, 2-layer 140×64 mm, qty 5 | JLC standard price for >100 mm boards (estimate) | ~7 |
| PCBA setup + stencil (Economic) | $8 + $1.50 | 9.50 |
| Extended-part feeder fees | 18 × $3 | 54.00 |
| Components ×5 boards | priced from JLC API (bom_prices.json); +~5% for attrition/min-qty | ~53 |
| Solder joints | ~420 joints × 5 × $0.0017 | ~3.60 |
| **JLC subtotal** | | **~127** |
| Shipping to US incl. tariff/duty | **Assumption:** standard/DHL ~$20–30; using $30 | 30 |
| HVAC headers + plugs ×5 | C7603439 + C7603433 at ~$1.11/set; add to the same JLC order as unassembled parts (or LCSC + ~$9 ship) | ~6 (≤15) |
| 2× GDEY029T94 2.9" panels | buy-lcd.com $6.46 each – https://buy-lcd.com/products/29-inch-e-paper-screen-296x128-raspberry-pi-spi-display-gdey029t94 ; shipping not verified, assume ~$10 | ~23 |
| **Total** | | **~$186 (worst case ~$195)** |

Under the $200 target, but with little margin. If needed, these trims save ~$3 per removed extended part:
- Replace the PTC with a 0 Ω jumper (lose fusing).
- Replace the 3 Ω sense resistor with a basic value. Check the boost first.
- Drop U4 (STWD100) and rely on the C6's internal watchdogs plus the default-off pull-downs.

The ESP32 module ($21) and SHT40 ($9.50) dominate the parts cost; SHT40 → AHT20 would save ~$7 at the cost of accuracy.

## Concerns / to verify
1. **USB + 24VAC ground hazard.** Board GND is the bridge's negative node, not HVAC C. Never connect USB to a mains-earthed PC while 24VAC is attached, unless the transformer secondary is floating; one rectifier diode can then conduct through the PC's ground. Flash on the bench, or use a USB isolator. Optionally add a silkscreen warning.
2. **LMR16006 output caps:** 2×10 µF is used. The TI datasheet table may recommend more for 3.3 V at 700 kHz; check and consider 2×22 µF (basic 0805 parts exist).
3. **ESP32-C6-WROOM-1 footprint** is custom (tstat.pretty), built from Espressif datasheet v1.4 Fig. 11-1. The pad rows (±8.75 mm, 1.27 mm pitch, pin 1 7.49 mm from the top) follow the drawing; **the exposed-pad position is approximate.** Verify against Espressif's land-pattern source or JLC's footprint before ordering.
4. **JLC CPL rotations** for the SOT-23, SOT-323, TO-252, SMDIP, FPC and USB-C parts usually need offset fixes. Check them in JLC's placement preview.
5. **Triac leakage:** zero-cross optos plus snubberless triacs leak µA-level current when off; this is normally fine with contactor/relay-based furnace and AC control boards. Snubber footprints are present but not populated (DNP), so they can be fitted if a control board chatters.
6. Firmware must interlock W/Y, enforce minimum compressor off-time, arm the watchdog only after boot, and refresh the e-paper ≥180 s apart (Waveshare guidance) with the panel put to sleep in between.

---
## Rev 3 (phase 4 verification, 2026-10-13 PT)
Verified:
- ESP32-C6-WROOM-1: Espressif datasheet v1.4 (Fig. 11-1 / p.44) vs EasyEDA C5366877 footprint; switched to EasyEDA footprint (EP centre corrected to x-1.5,y+0.42). Module top flush to board edge, antenna keepout zone, no copper under antenna.
- All custom footprints replaced with EasyEDA versions via easyeda2kicad (MOC3063S wide 10.16 mm, terminal drill 1.4 mm, MB10S pinout fixed, etc).
- GDEY029T94 (Good Display datasheet p.7, p.29): contacts on display-face side; FPC folded 180 deg under panel -> contacts face down -> bottom-contact Jushuo AFC07-S24FCA-00 (C262567, 49k stock). Boost per GD reference: 47 uH (C7427088), 2.2 R, 1 M, 4.7 uF 25 V, VPP NC.
- LMR16006 (TI SNVSA24): internal compensation, Vref 0.765 V; 22 uH + 2x10 uF, 33k/10k, 0.1 uF boot OK; Ton(min) margin at 40 V OK. No change.
- CPL rotations: EasyEDA footprints = JLC orientation (0 offset); KiCad USB-C HRO position corrected by local y -1.575 mm (EasyEDA pad comparison); KiCad passives/switch/SHT4x 0.
Results: ERC 0; DRC 0 errors, 0 unconnected, schematic parity clean (104 cosmetic silk warnings + 1 lib_footprint_mismatch warning on U3).
Cost (5 boards): parts $50.59 + 18 extended x $3 = $54 + PCB/assembly setup ~ $22 + shipping ~$30 + terminals ~$6 + panels ~$23 => ~$186.

## Display fit check (2026-10-13 PT)
Source: GD GDEY029T94 datasheet p.7 (mechanical drawing), p.6 (79.0x36.7x1.2, AA 66.896x29.056).
- FPC tail: 12.50 wide, 14.40 free length beyond outline, 24 contacts at 0.5 pitch (span 11.50), contact length 3.66 with stiffener, 0.3 thick; contacts on display-face side. Tail edge is 11.50 mm from the outline edge nearest pin 24; pin 1 is 23.5 mm from that edge.
- Board: J4 at (100,44) rot 90, mouth faces +x at x~103.8, pad 1 y=49.74, pad 24 y=38.24.
- Panel placement (face up, FPC on right edge, 180 deg fold under): outline x 29.46..108.46, y 26.24..62.94, panel bottom 5.0 mm above PCB (M2.5x5 standoffs or case ledge). Bend r~2.15 mm, ~6.8 mm of tail in the bend, ~3.0 mm inserted. Pin 1 / pad 1 y match exactly (49.74). Contacts face down -> bottom-contact AFC07 correct.
- Panel standoff height must be >= ~4.5 mm (MOC3063S optos ~4 mm under the display panel). Every +1 mm of height pulls the tail ~1.6 mm out of the connector. The case nominal back is 4.45 mm above the board. The display panel sits on a stop 0.15 mm under that, and shell bridges press the border. A thin corner can leave J4; reseat is the shell off, the tail pressed back in, and the slider closed.
- No copper change; only the Cmts.User panel outline moved (-0.54, +1.24). Image: fab/display-fit.png

## Rev 4 – JLC upload fixes (2026-10-13 PT)
- CPL/gerber origin: aux/drill/grid origin set at board bottom-left (abs 100,164). Gerbers exported with --use-drill-file-origin, drill with --drill-origin plot, CPL = (x-100, 164-y). Verified: CPL range x 13.5..128, y 3.5..59; U5 pad 1 at (127.3, 32.4) flashes at X127.3 Y32.4 in F_Cu/F_Paste gerbers.
- Switches: EasyEDA footprint for C318884 (TS-1187A-B-A-B, 5.1x5.1 4-pad, pads 1/2 -> pin 1, 3/4 -> pin 2); BOM grouped by LCSC+footprint -> one line "TS-1187A-B-A-B" SW1..SW5.
- Extended->basic swaps: Q1 SI1308EDL (C469327) -> AO3400A (C20917, SOT-23, 30 V/5.7 A, same G/S/D pinout); R16 2.2R 0402 (C25101) -> 2.2R 0603 (C22939); C2 2.2uF 100V (C170101) -> 2.2uF 50V X7R 1206 (C50254, VIN_HV <= ~37 V, TVS standoff 40 V); J3 Stemma QT (C51940130) -> DNP (hand-solder if wanted).
- Kept extended (no basic equivalent with same function): ESP32-C6, SHT40, LMR16006, MOC3063S, BT136S, STWD100, USBLC6, USB-C, FPC conn, 22uH/47uH inductors, SMBJ40A, PTC, 100uF/63V.
- Silkscreen: refs 0.8/0.15 mm auto-placed, footprint silk trimmed at pads/edge; 0 silk DRC warnings. Cat logo + "Connie's Super Awesome Thermostat / VERSION 3.0" on bottom silk.

## Rev 5 – case + rear terminal (2026-10-13 PT)
- J1 -> vertical-entry MX15EDGVC-3.5-05P (C5188321) on the BACK + 15EDGK-3.5-05P plug (C5188252): wires come straight out of the wall into the plug. Hand-soldered; front shows only THT pins (x 4.5-12 mm, clear of panel at x>=29.5).
- C1 100uF/63V 10x10 (10.5 mm tall, overlapped panel corner) -> 22uF/50V 6.3x5.4 (C72505), moved to (24.6,56.2) outside panel. Ripple at ~15 mA input ~5 V; TVS standoff 40 V.
- SHT40 island: rule area ISLAND + kicad_dru rule: only +3V3/GND/I2C_SDA/I2C_SCL tracks (<=0.25 mm) allowed; routing keepout during autoroute. Verified: 8 tracks inside, all sensor nets, 0.2 mm, F.Cu.
- Case: case/thermostat_case.scad (backplate, front shell, button caps), STLs + Bambu P2S 3MF.

## Rev 6 – drywall case, 100 V bulk caps, multi-colour (2026-10-13 PT)
- C1 (22uF/50V e-cap) and C2 (2.2uF/50V) -> 4x 4.7uF 100V X7R 1210 (C381466 FS32X475K101EGG, ~153k stock) as C1,C41,C42 (bulk, left of panel) + C2 (at LMR16006 input). ~3.3 uF each at 34 V DC bias -> ~13 uF; ripple at 15 mA: 0.015/(120 Hz*13 uF) ~ 9.6 V p-p, Vmin ~24 V nominal (~18 V at 20 VAC low line), above LMR16006 4.3 V min. 2.5 mm tall. No basic 63 V+ part exists in this range.
- Case: drywall anchors only, 146 x 70 x 16.8 mm; no USB opening; RESET pinhole only (BOOT needs USB anyway).
- Multi-colour: white shell/backplate, black inlay text, orange cat inlay + button caps, translucent pink LED light pipe; 3MF with per-part filament slots 1-4.

## Rev 7 – centred wire hole, rear right-angle terminal (2026-10-13 PT)
- J1 -> 15EDGRC-3.5-05P-14-00A(H) right-angle header (C7603439, ~1.2k stock) on the BACK at board (70,58), pins along x (pin1 R at x=63 ... pin5 G at x=77), mating face toward -y (toward the centred wire hole). Plug 15EDGK-3.5-05P-14-00A(H) (C7603433). Wire the plug with the backplate on the wall, then plug the board in. Back silk labels R C W Y G under each pin.
- Schematic nets / GPIO map unchanged (firmware pin map above still valid).
- 24VAC nets (HVAC_*, R_FUSED, SNUB_*) are >= 43 mm from the SHT40 island; island crossings still only +3V3/GND/SDA/SCL (0.2 mm).
- Case: standoffs 4 -> 12 mm (header+plug ~10.5 mm), depth 16.8 -> 24.8 mm; centred 25x20 mm wire hole; 146 x 70 mm unchanged; anchors clear.

## Rev 8 - independent review fixes (2026-10-13)
See `review/pcb-review.md` (the review) and `review/rev8-response.md` (the fixes, with full supply calculations).
- **J1 really at board (70,58), B.Cu, mating face toward -y.** Verified in PTH.drl (X63-77, Y6) and in the copper gerbers. `gen_pcb2.py` asserts the position and also sets the aux origin, so regeneration can't revert it.
- **D3:** B5819W 40 V -> SS210 100 V (C14996, basic).
- **F1:** -> mSMD050-60V (C70113).
- **R50:** 100k (C25741) in series with LMR16006 SHDN (new net BUCK_EN).
- **C43:** 47 uF 63 V 8x9 THT (C19270693) on the BACK at (55,58), hand-soldered, excluded from the JLC BOM/CPL. Bulk is now about 59 uF effective. Vmin at 18 VAC and 0.88 W in is about 18 V.
- **Triacs Q2-Q4:** BT136S-600D (sensitive gate) -> **T435-600B** (ST, standard gate IGT 35 mA, Snubberless, 4 A 600 V, C145128). This matches V1's standard-gate BT136-600. The 100R opto feed gives 35 mA gate current at about 8 V instantaneous line voltage.
- **Optos stay MOC3063S (zero-cross), snubbers stay DNP.** Field evidence: the user's working V1 ran the same zero-cross opto family (MOC3033) with no snubbers on this exact HVAC system.
- **Antenna keepout:** widened to x 61-89, y 0-6.4 on both layers. SW1/SW2/R6 moved +2 mm in x (RESET pinhole now at (93,5) in the case).
- **USB-C J2:** moved flush with the board edge (y 60.35). The CPL offset -1.575 mm was re-verified against EasyEDA C165948.
- **GND pour:** custom DRC rule keeps the pour >= 1.0 mm from all 24 VAC/triac/opto-output nets.
- **Test pads (back side, no BOM):** TP1 VIN_HV, TP2 GND, TP3 +3V3, TP4 VBUS.
- **Firmware pins:** unchanged; board.h untouched.
- **Known, accepted:** buck hot loop about 7 mm (not re-laid out). (SMBJ40A clamp and L1 Isat were fixed in rev 9.)

## Rev 9 - supply margin fixes (2026-10-13)
See `review/rev9-notes.md` for calculations and the final review.
- **R51 3.3 Ω 1206 pulse-proof (CRCW12063R30FKEAHP, C844038, extended)** in series from the bridge + (new net VIN_RECT) to VIN_HV (bulk caps, TVS, buck). The TVS now sits behind R51, so a surge that used to push 9.3 A / 64.5 V into it now gives ~5 A / ~58 V at U1 VIN (under the 60 V recommended).
- **L1 -> SWPA6045S220MT (C83454)**, 22 µH, Isat 2.2 A (Irms 1.8 A), 89 mΩ, footprint Inductor_SMD:L_Sunlord_SWPA6045S. Above the LMR16006X 1.2 A typ peak current limit, so a shorted output no longer saturates it. C4/C5 moved 1.3 mm right to make room.
- R50 rotated 180° (EN pad toward U1) so the EN net routes cleanly.
- No basic-part 1206 low-ohm resistor exists at JLC; +1 extended fee (~$3).

## Rev 11 (2026-10-13)
- **Triacs Q2-Q4:** T435-600B (IH 35 mA max) -> **ST T405-600B-TR** (C283473, extended, 5,771 in stock at JLC). It is a 4 A 600 V DPAK part in the same T4 family, with the same pinout (1 = A1/MT1, tab/2 = A2/MT2, 3 = G).
  - IGT is 5 mA max (Q1-Q3), IH 10 mA max, IL 10/15 mA max. The old T435 was 35/35/50.
  - Low-current furnace and air-handler inputs now latch and hold, which V1's BT136 (IH about 15 mA) also managed.
  - Gate drive: the 100R opto feed reaches 5 mA plus the 1.3 mA bled by the 1k gate-MT1 resistor at about 3 V instantaneous, so it has a big margin.
  - Commutation: (dI/dt)c is at least 0.9 A/ms at (dV/dt)c 10 V/us. A 1 A rms 60 Hz load needs 0.53 A/ms, so it can run without a snubber at 24 VAC.
  - Static dV/dt is at least 20 V/us, lower than the T435's 400. The 1k gate-MT1 resistor improves it, and the 24 VAC transformer secondary is a soft source. The snubbers (C20-22, R24/34/44) stay DNP and are available if any false triggering shows up.
  - The MOC3063 stays.
- **C40:** stays 4.7 uF 25 V (C1779, basic). JLC has no basic or preferred 4.7 uF 50 V 0805, and the cheapest extended one (C2903668) would add a $3 loading fee for a margin-only change.
- **L1:** C83454 SWPA6045S220MT has 40,741 in stock (checked 16:3x PT).

## Rev 12 (2026-10-13): cutting JLC loading fees
I checked every extended line against JLC's live library: basic, preferred-extended (no Economic loading fee, per the JLC FAQ), or plain extended.
- **D2:** SMBJ40A C114003 -> **SMBJ40CA C19077590** (preferred-extended, 61k stock). It's the same SMB footprint. Standoff is 40 V, min breakdown 44.4 V, and the clamp is 64.5 V at 9.3 A, the same as the unidirectional part in the positive direction. The R51 surge analysis is unchanged (about 57.7 V at the buck, under its 60 V recommended and 65 V abs max), and so is the ripple. Bidirectional also takes polarity out of the placement check.
- **Kept extended, with no safe basic or preferred equivalent:**
  - C1/C2/C41/C42 4.7 uF 100 V: no basic or preferred cap at 100 V or above.
  - R51: 3.3 R basic resistors are only 250 mW thick film (C17945 isn't basic either). The rms ripple current needs 0.75 W pulse-rated.
  - F1: basic and preferred PTCs are rated 6-30 V; this one needs 60 V.
  - J2: there's no basic or preferred USB-C, and swapping would change the footprint.
  - J4: no preferred 24P 0.5 mm FPC connector.
  - L1: needs Isat of at least 1.6 A, and no basic or preferred power inductor meets it.
  - L2: the only preferred 22-47 uH parts are 5 mA multilayer chips.
  - Q2-Q4 T405, U3 C6 module, U6-U8 MOC3063: locked.
  - U1 LMR16006, U2 USBLC6, U4 STWD100, U5 SHT40: no basic or preferred equivalents.
- **Duplicate values:** none worth merging. The only duplicate is 1k in 0402 and 0805, and both are basic.

## Rev 13 (2026-10-13): second-review fixes (Ferdinand)
- The GND trace through U8's opto isolation gap is removed. GND now connects through the pour and a re-placed stitching via. The new `opto_gap_no_lv` rule and the OPTO_GAP_U6/U7/U8 rule areas keep any LV copper out of those gaps on F.Cu.
- The new `hv_to_lv_clearance` rule (0.6 mm) forced these fixes:
  - Removed redundant GND traces (pour plus stitching vias carry GND instead).
  - Rerouted VIN_RECT left of D1's GND pad.
  - Moved the HVAC_C via, the HVAC_Y via and VIN_HV on B.Cu.
  - Narrowed a 2 mm HVAC_R stub beside C2 to 0.6 mm.
- `hv_pour_clearance` (1.0 mm) is moved to the end of the rules file so it still governs the GND pour.
- Footprints renamed, with identical geometry: TO-252_BT136S -> TO-252-2_TRIAC_DPAK and SMB_SMBJ40A -> D_SMB_TVS. All board footprints are now in sync with tstat.pretty (0 library-mismatch warnings).
- D1 has a custom symbol BRIDGE_MB10S with pin labels matching C2488 (1 = +, 2 = −, 3/4 = ~). The pads are unchanged.
- Added an "! NO USB WITH 24VAC" silk note right beside J2 and the installation notes above (including sealing the wire hole).

## Rev 14 (2026-10-13): Ferdinand re-review of 28d5e9a
- The opto gaps are now F.Cu and B.Cu keepouts that block tracks, vias and pour, so the gap holds 0 mm² of copper on either layer.
  - OPTO_MT2_G was moved out of the U8 gap. Its via is now at (131.9, 143.05) and the B.Cu track runs down to the existing via at (133.316, 145.94).
  - The HVAC_W B.Cu diagonal was routed around the U7 gap through (142, 130) and (124.629, 130).
  - GND is still a single connected cluster.
- HV clearances were raised from 0.6 to 0.8 mm:
  - HVAC_R vs R50 is 0.801 mm, because HVAC_R moved to y = 147.979.
  - HVAC_C vs VIN_HV is 0.800 mm, because VIN_HV on B.Cu moved to x = 114.45.
  - VIN_RECT vs D1's GND pad is 0.825 mm, because a jog was added at x = 116.925.
  - The lowest HV-to-LV clearance left is 0.723 mm (the HVAC_R stub vs C2's GND pad). The rule stays at 0.6 mm.
- Both silkscreen USB warnings are now 1.0 mm tall with a 0.15 mm stroke. The upper one is split onto two lines.
- The gerbers were exported again after a zone refill. The BOM and CPL did not change.
