Connicpu/thermostat/case/case-back-angle.png

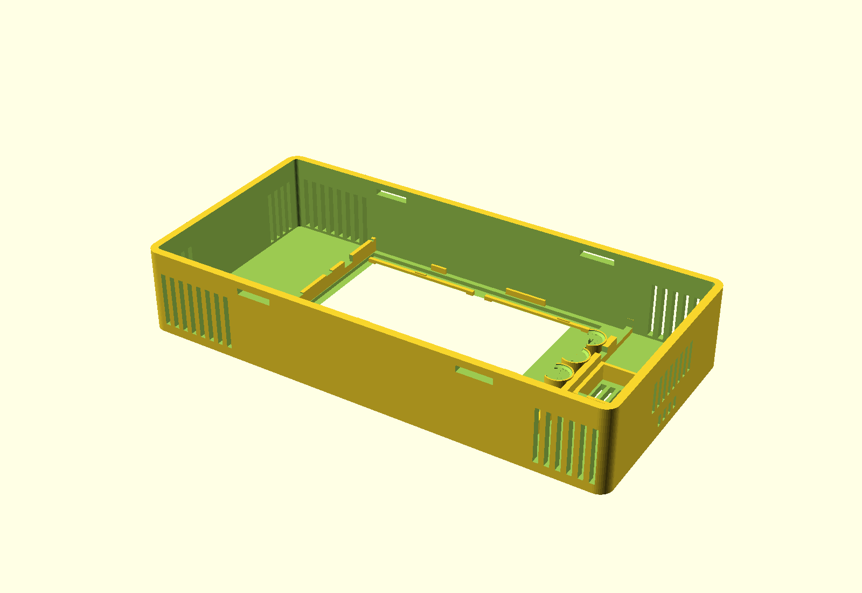
case/case-back-angle.png
