Connicpu/thermostat/case/case-back-section.png

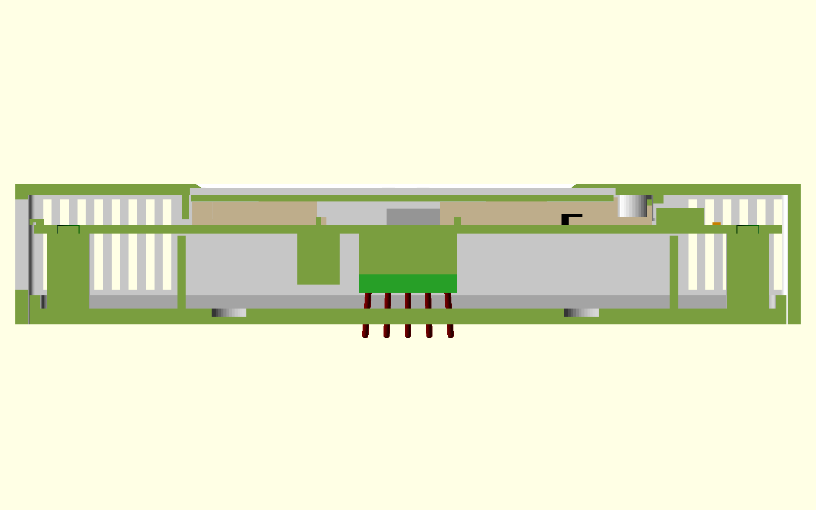
case/case-back-section.png
