Connicpu/thermostat/case/case-back.png

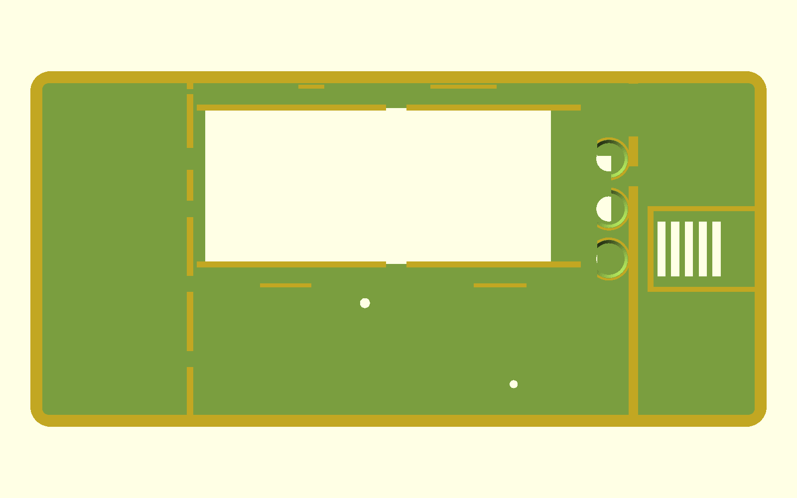
case/case-back.png
