Connicpu/thermostat/case/case-backplate.png

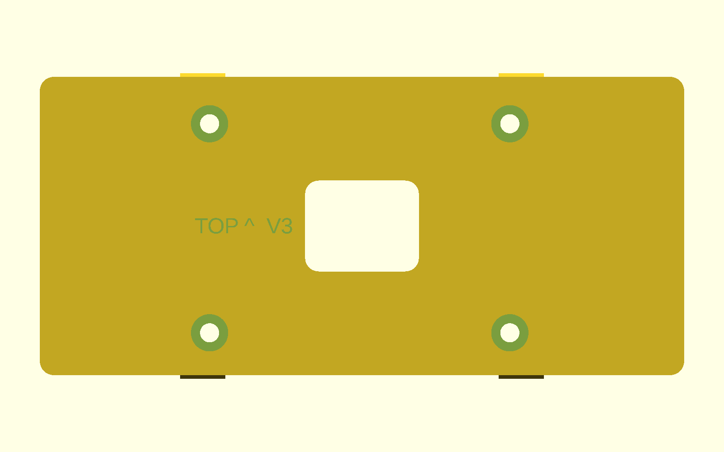
case/case-backplate.png
