Connicpu/thermostat/case/case-curl-zoom.png

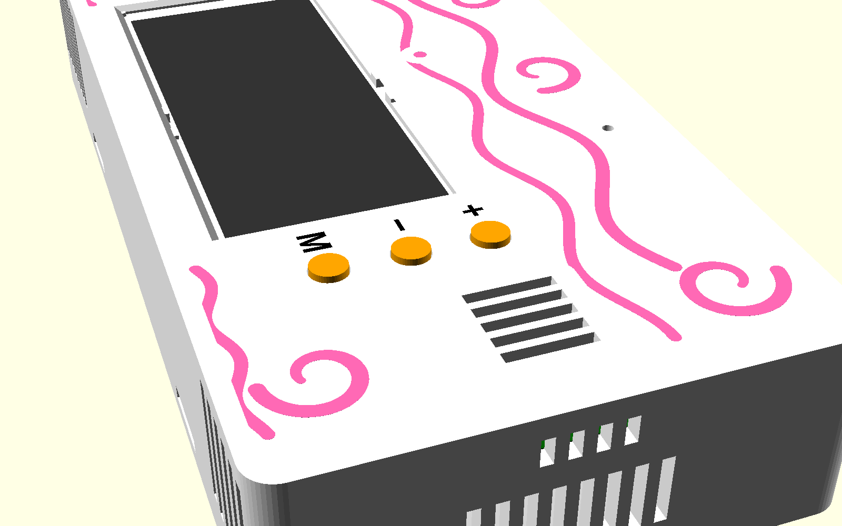
case/case-curl-zoom.png
