Connicpu/thermostat/case/case-exploded.png

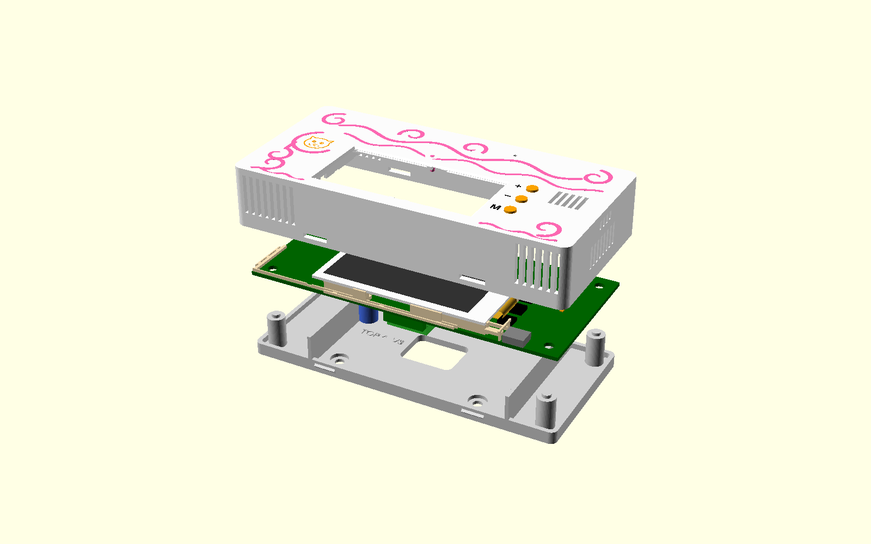
case/case-exploded.png
