Connicpu/thermostat/case/case-front-swirls-bold.png

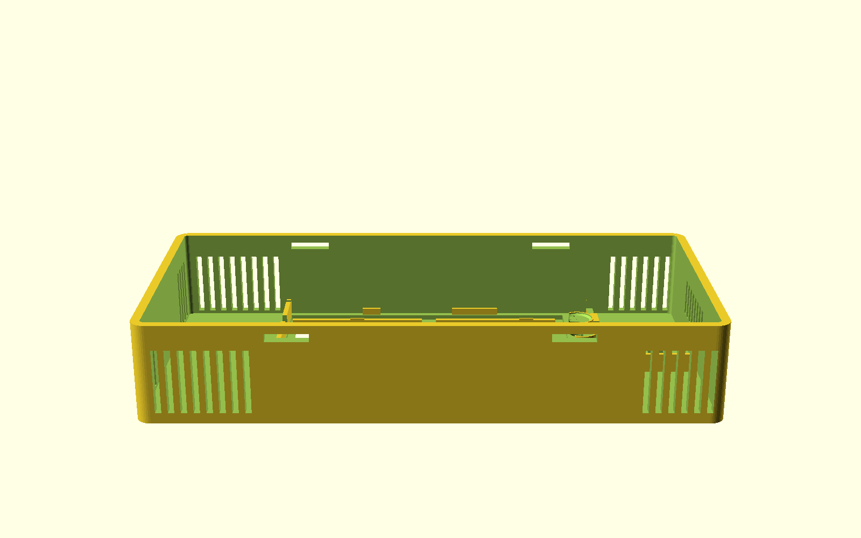
case/case-front-swirls-bold.png
