Connicpu/thermostat/case/case-front-swirls-subtle.png

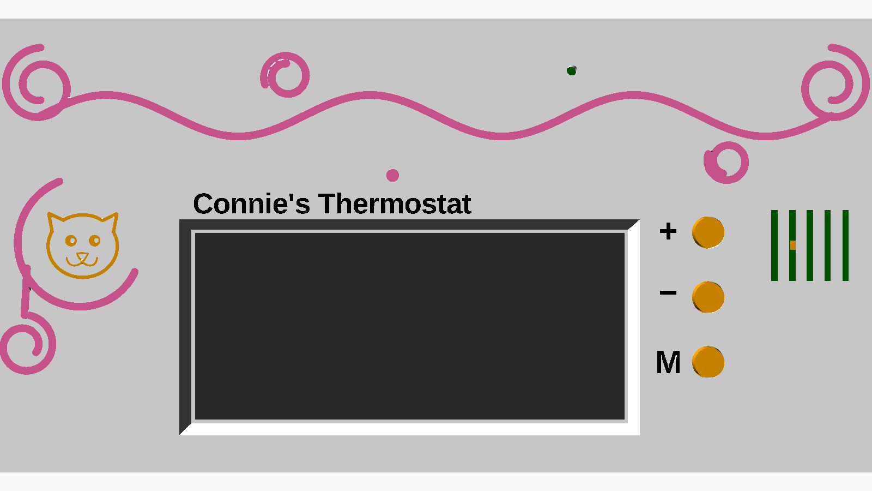
case/case-front-swirls-subtle.png
