Connicpu/thermostat/case/case-front.png

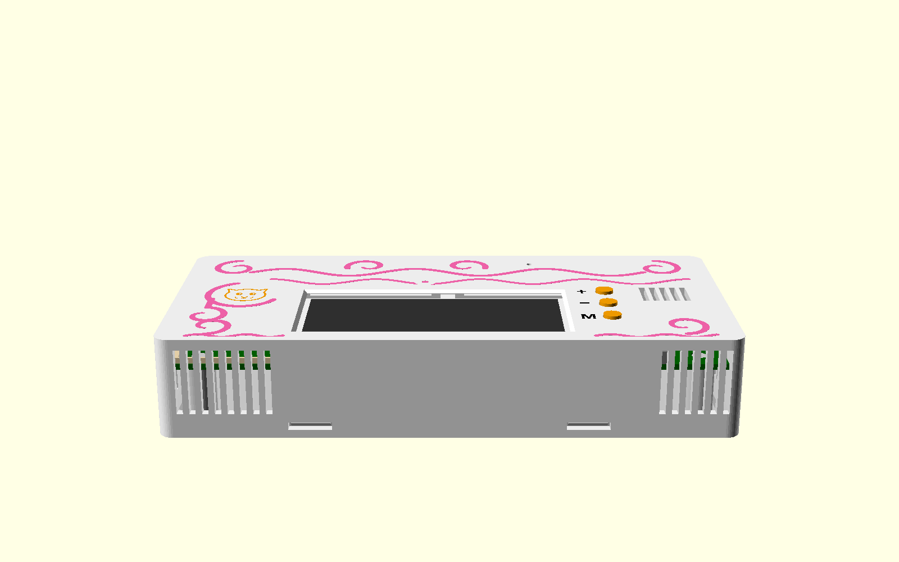
case/case-front.png
