Connicpu/thermostat/case/case-section-hooks.png

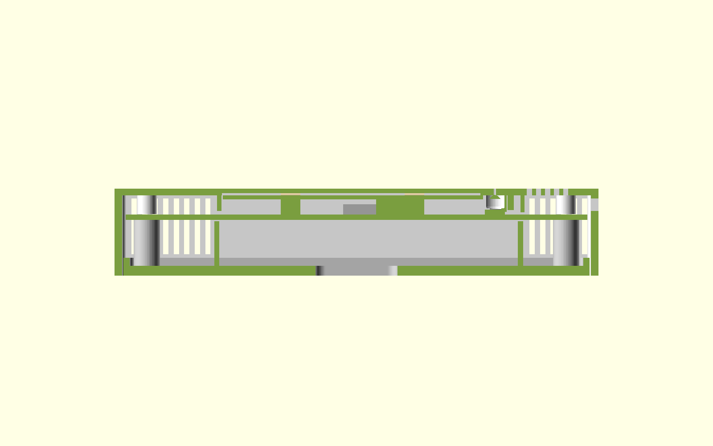
case/case-section-hooks.png
