Connicpu/thermostat/case/case-section-j1-c43.png

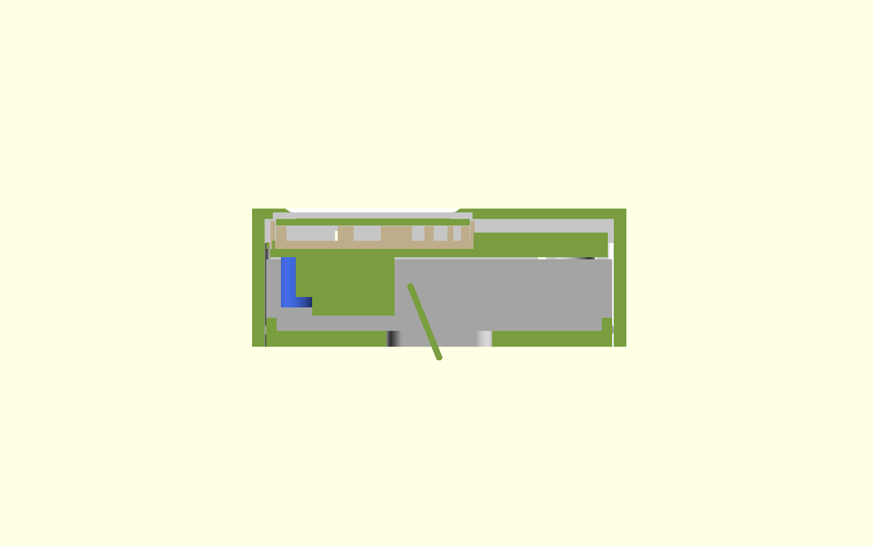
case/case-section-j1-c43.png
