Connicpu/thermostat/case/case-section-j1.png

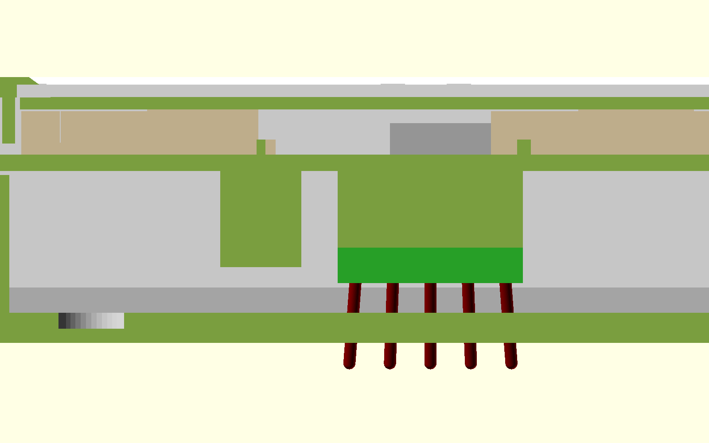
case/case-section-j1.png
