Connicpu/thermostat/case/case-section-j4.png

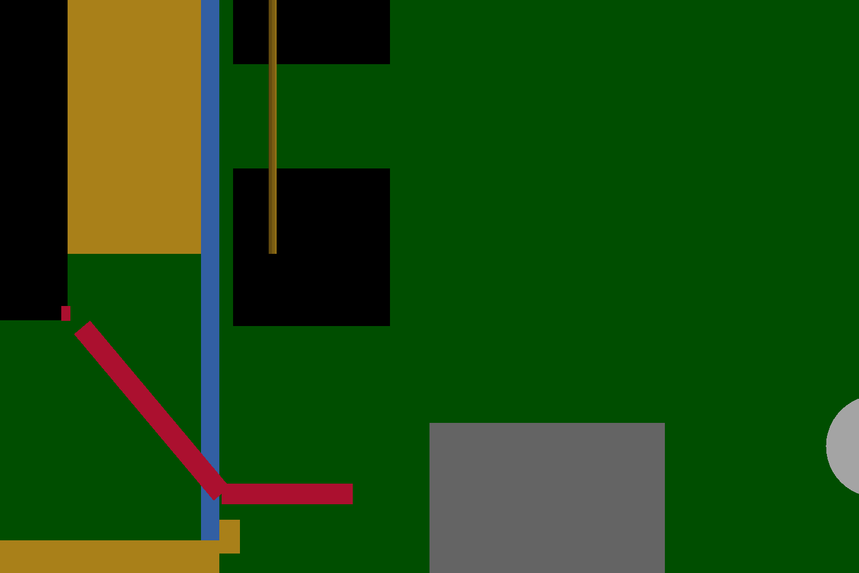
case/case-section-j4.png
