Connicpu/thermostat/case/case-section-release-out.png

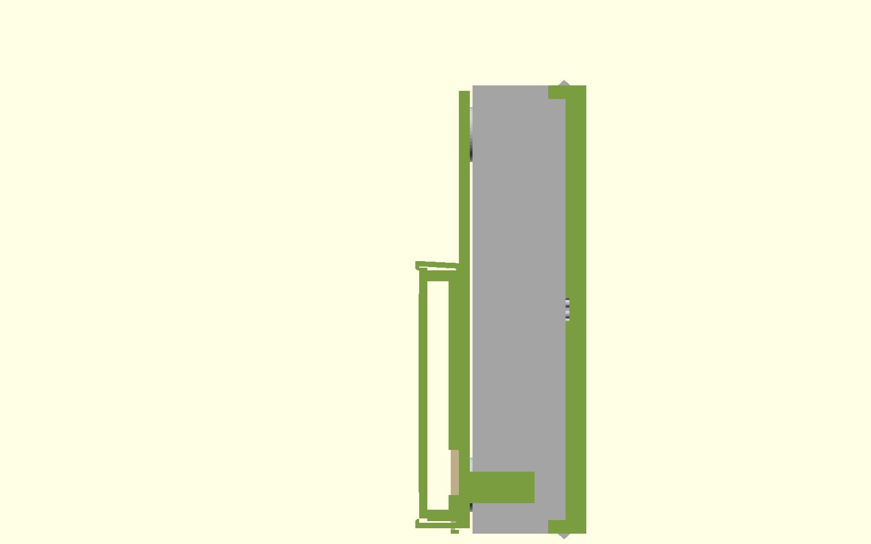
case/case-section-release-out.png
