Connicpu/thermostat/case/case-section-release.png

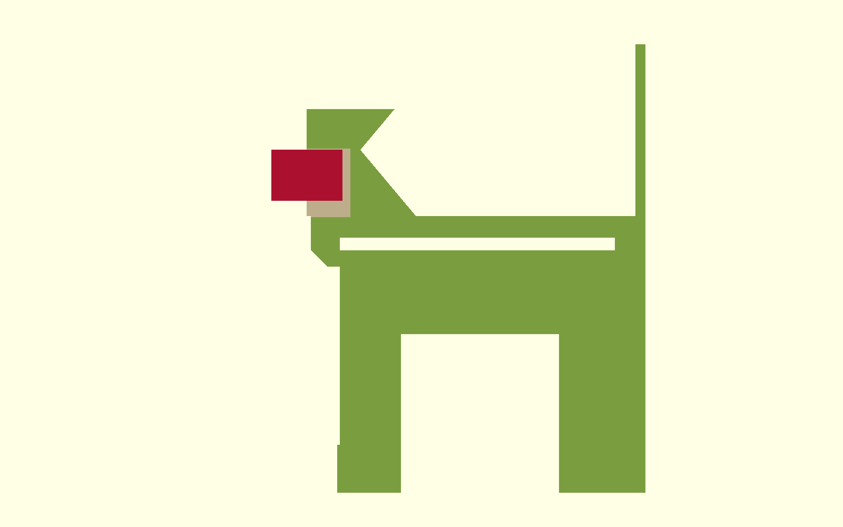
case/case-section-release.png
