Connicpu/thermostat/case/case-snap-window.png

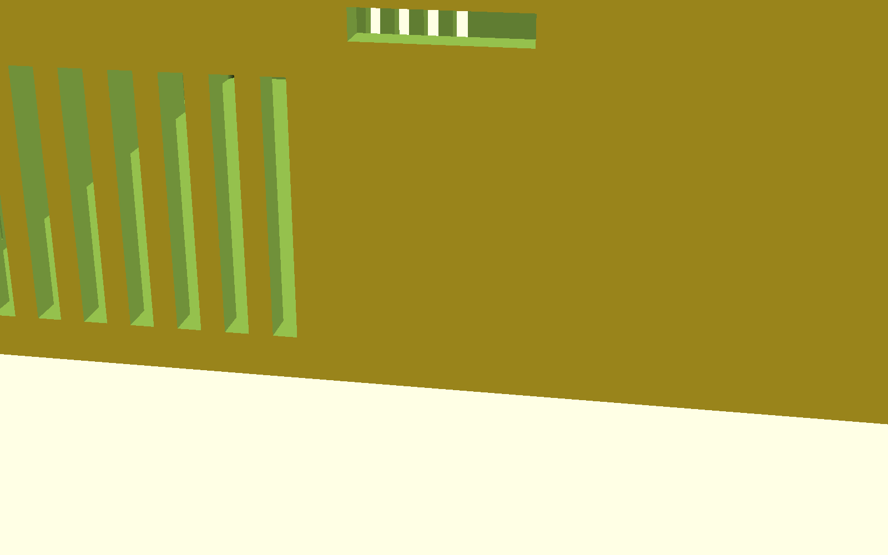
case/case-snap-window.png
