Connicpu/thermostat/docs/case-r7/exploded.png

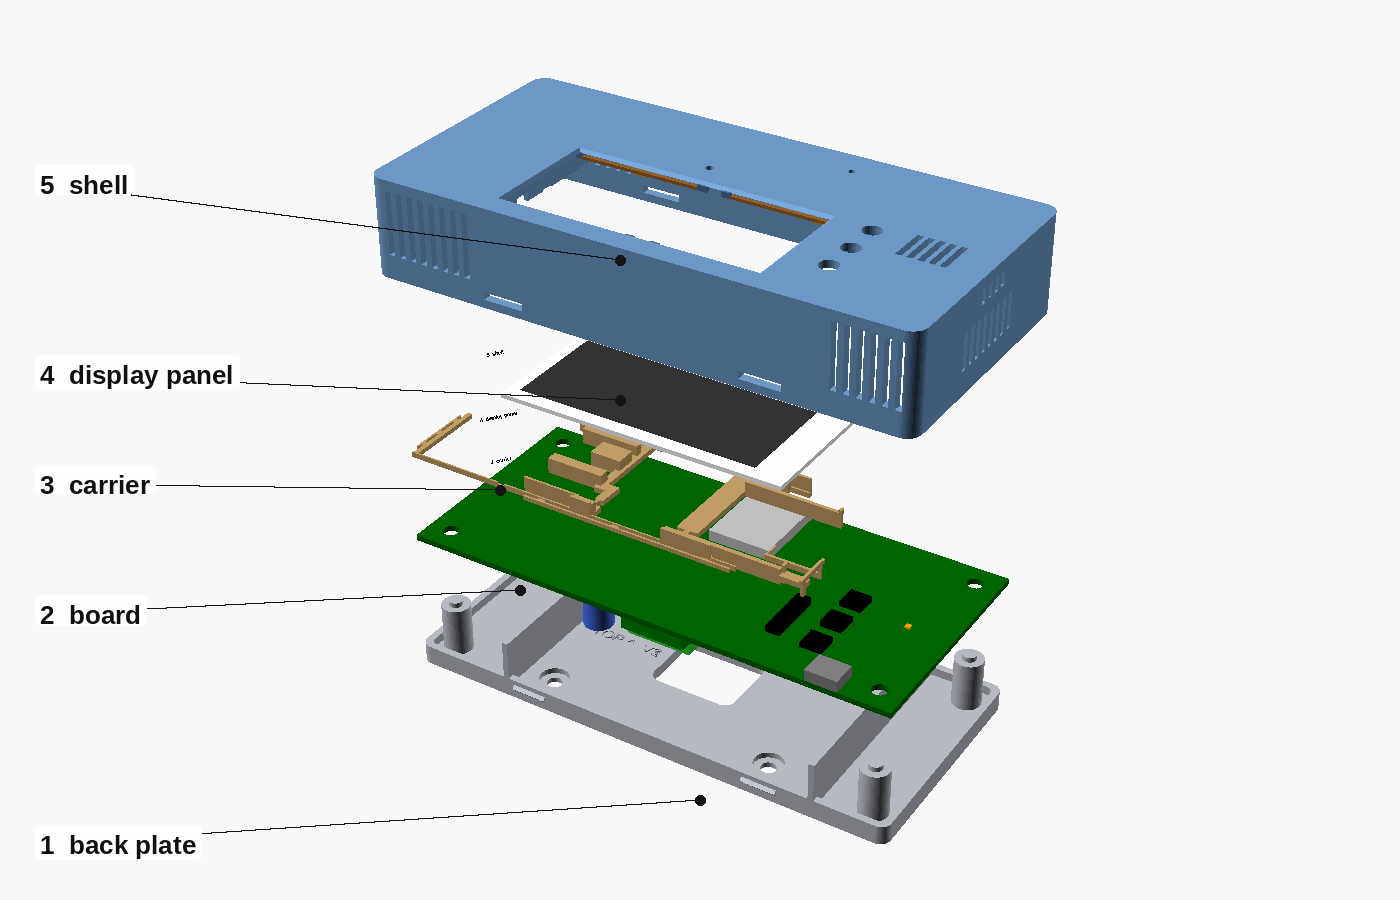
docs/case-r7/exploded.png
