Connicpu/thermostat/docs/case-r7/j4-closeup.png

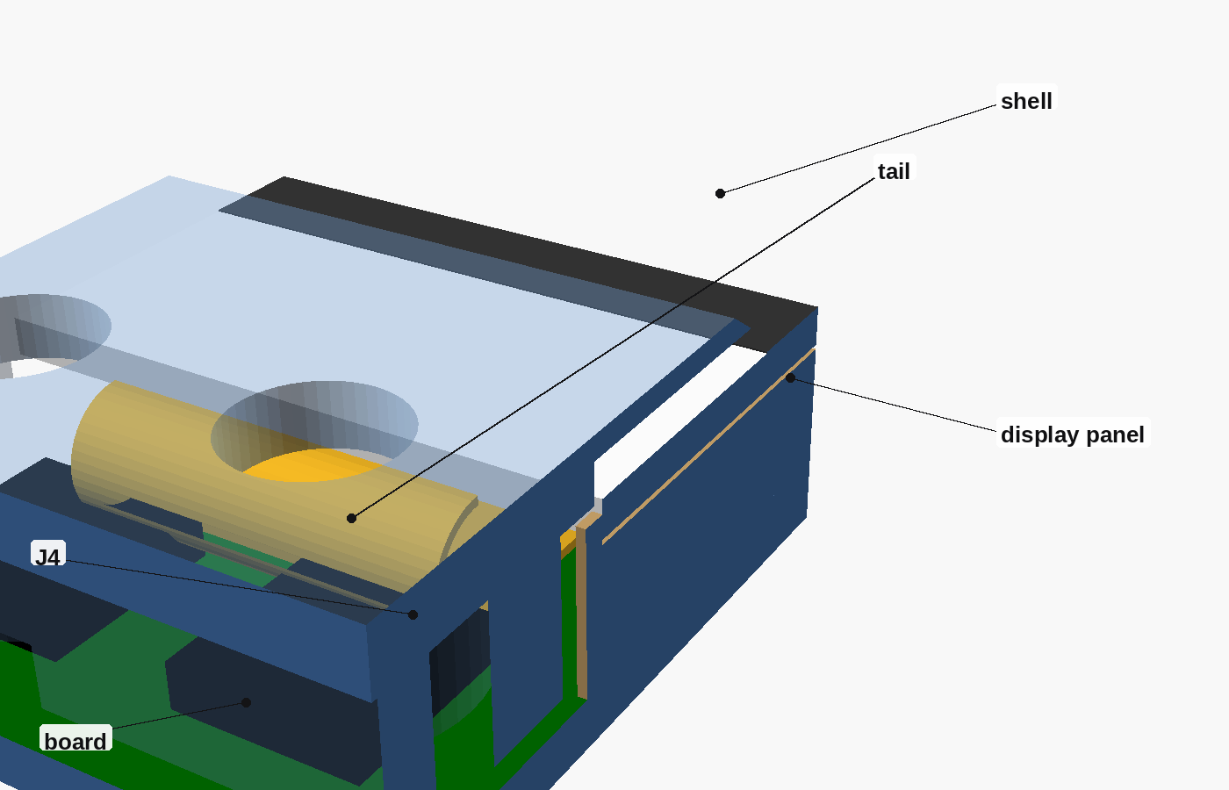
docs/case-r7/j4-closeup.png
