Connicpu/thermostat/docs/case-r7/section-bridge.png

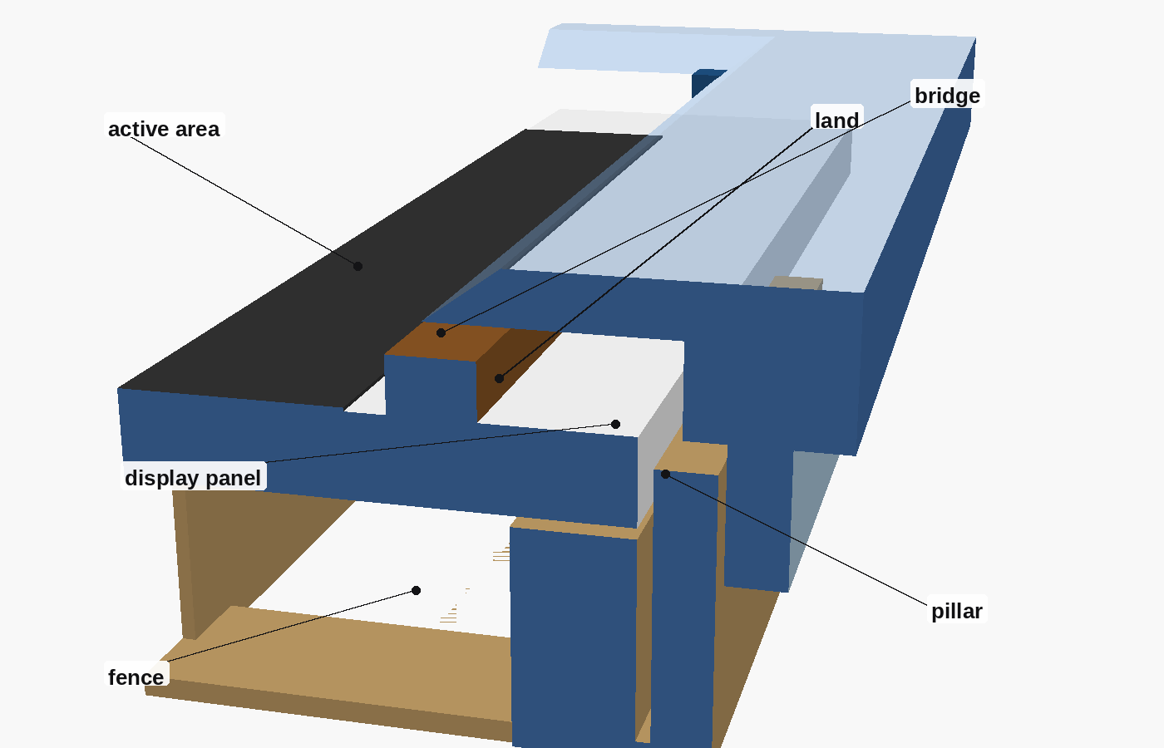
docs/case-r7/section-bridge.png
