Connicpu/thermostat/docs/case-r7/section-j4.png

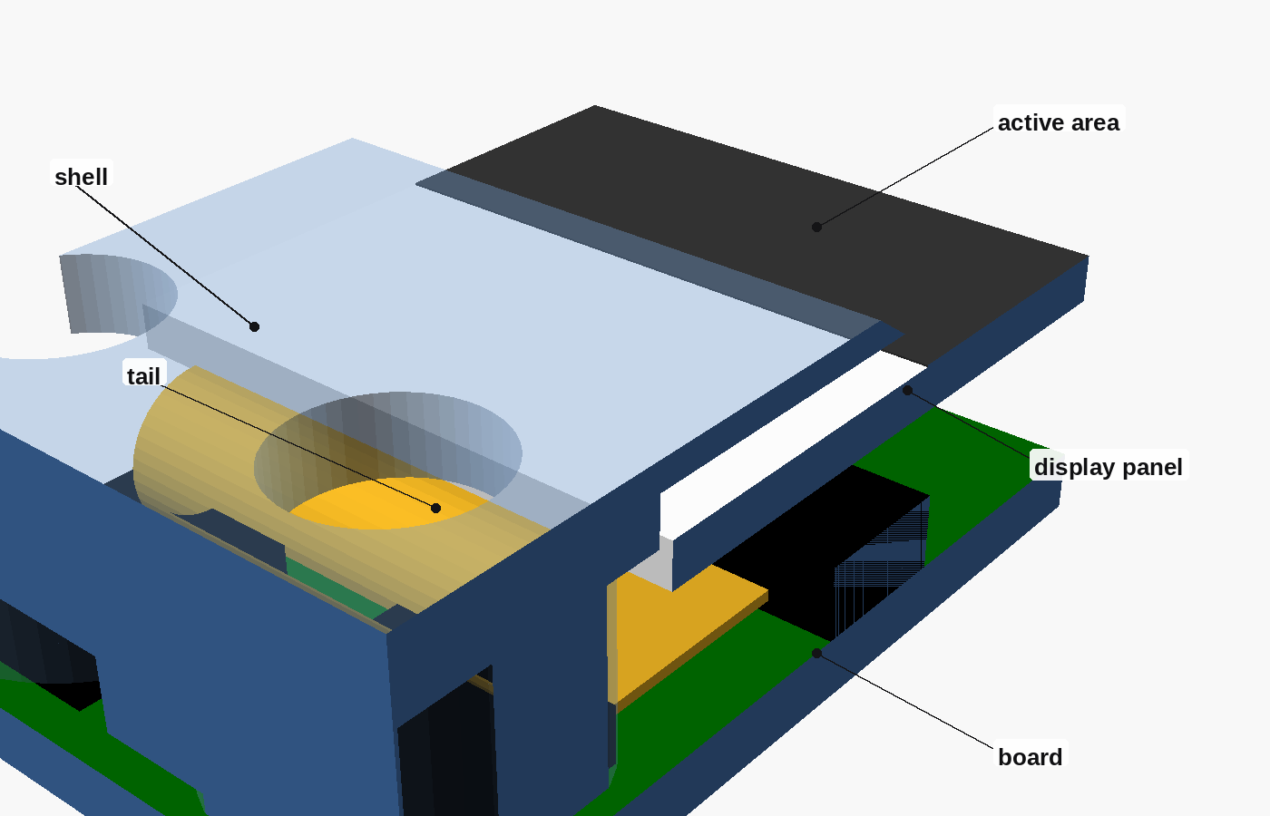
docs/case-r7/section-j4.png
