Connicpu/thermostat/docs/case-r7/section-pillar.png

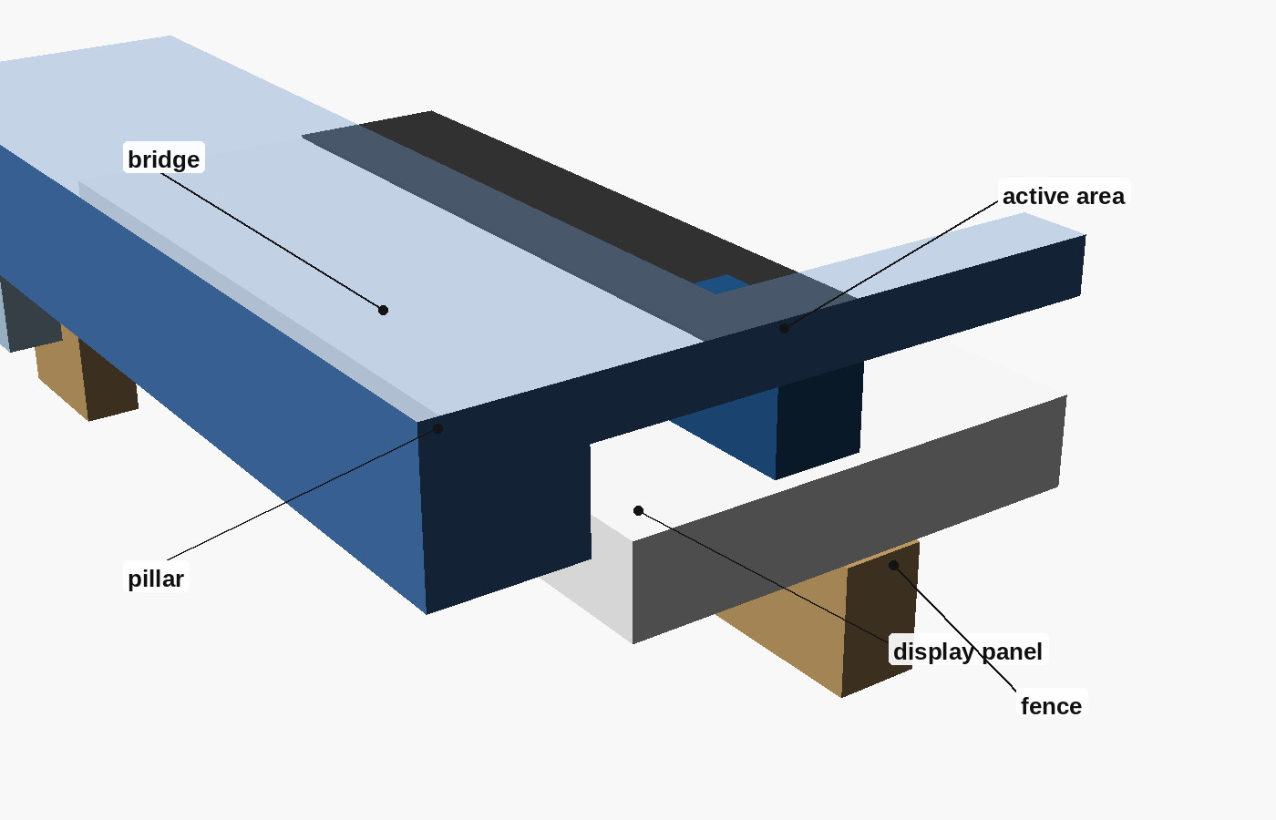
docs/case-r7/section-pillar.png
