Connicpu/thermostat/docs/case-r7/section-u7.png

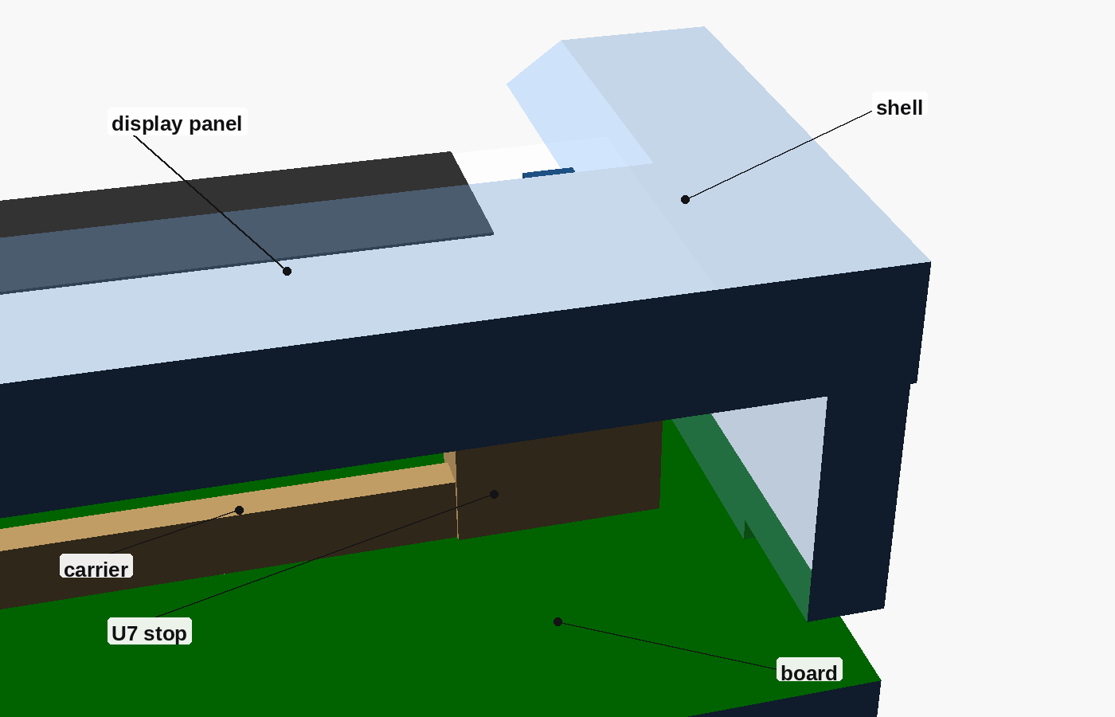
docs/case-r7/section-u7.png
