Connicpu/thermostat/docs/case-r7/shell-hold-plan.png

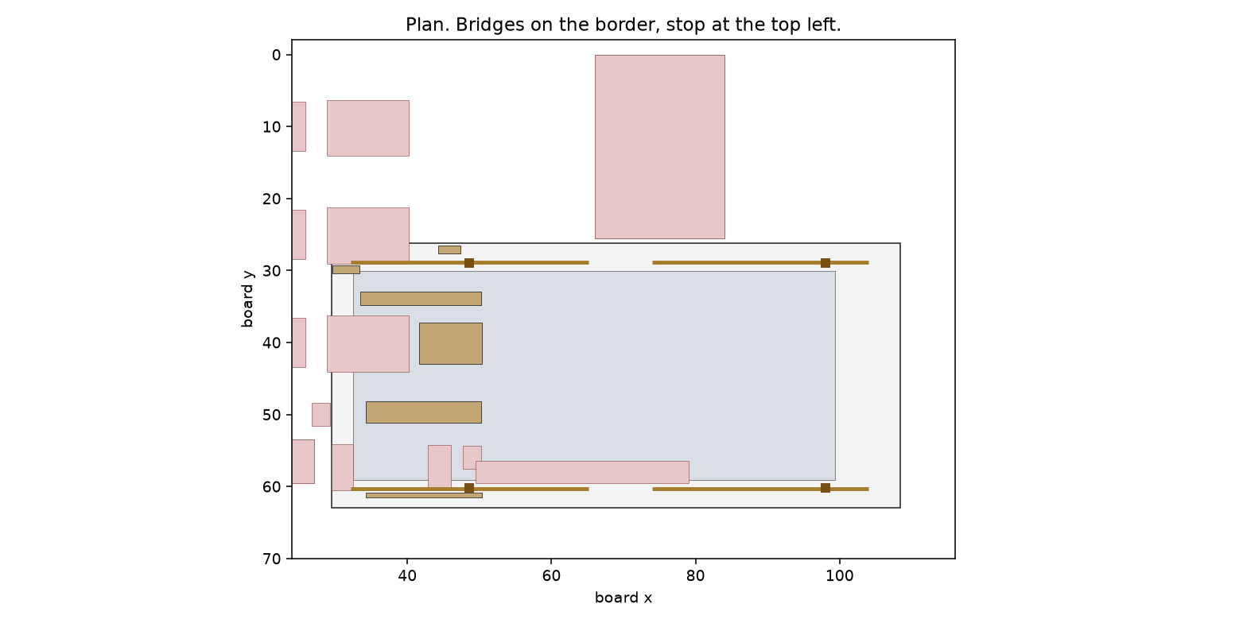
docs/case-r7/shell-hold-plan.png
