Connicpu/thermostat/docs/case-r7/shell-off.png

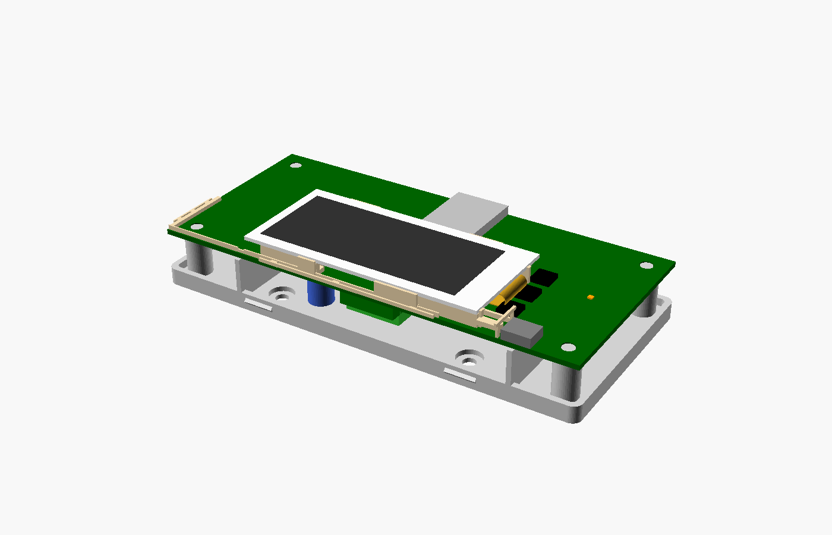
docs/case-r7/shell-off.png
