Connicpu/thermostat/docs/case-r7/shell-on-top.png

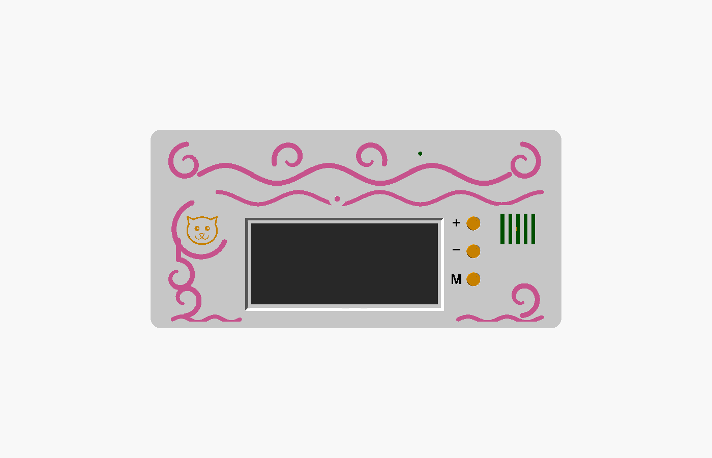
docs/case-r7/shell-on-top.png
