Connicpu/thermostat/fab/display-fit.png

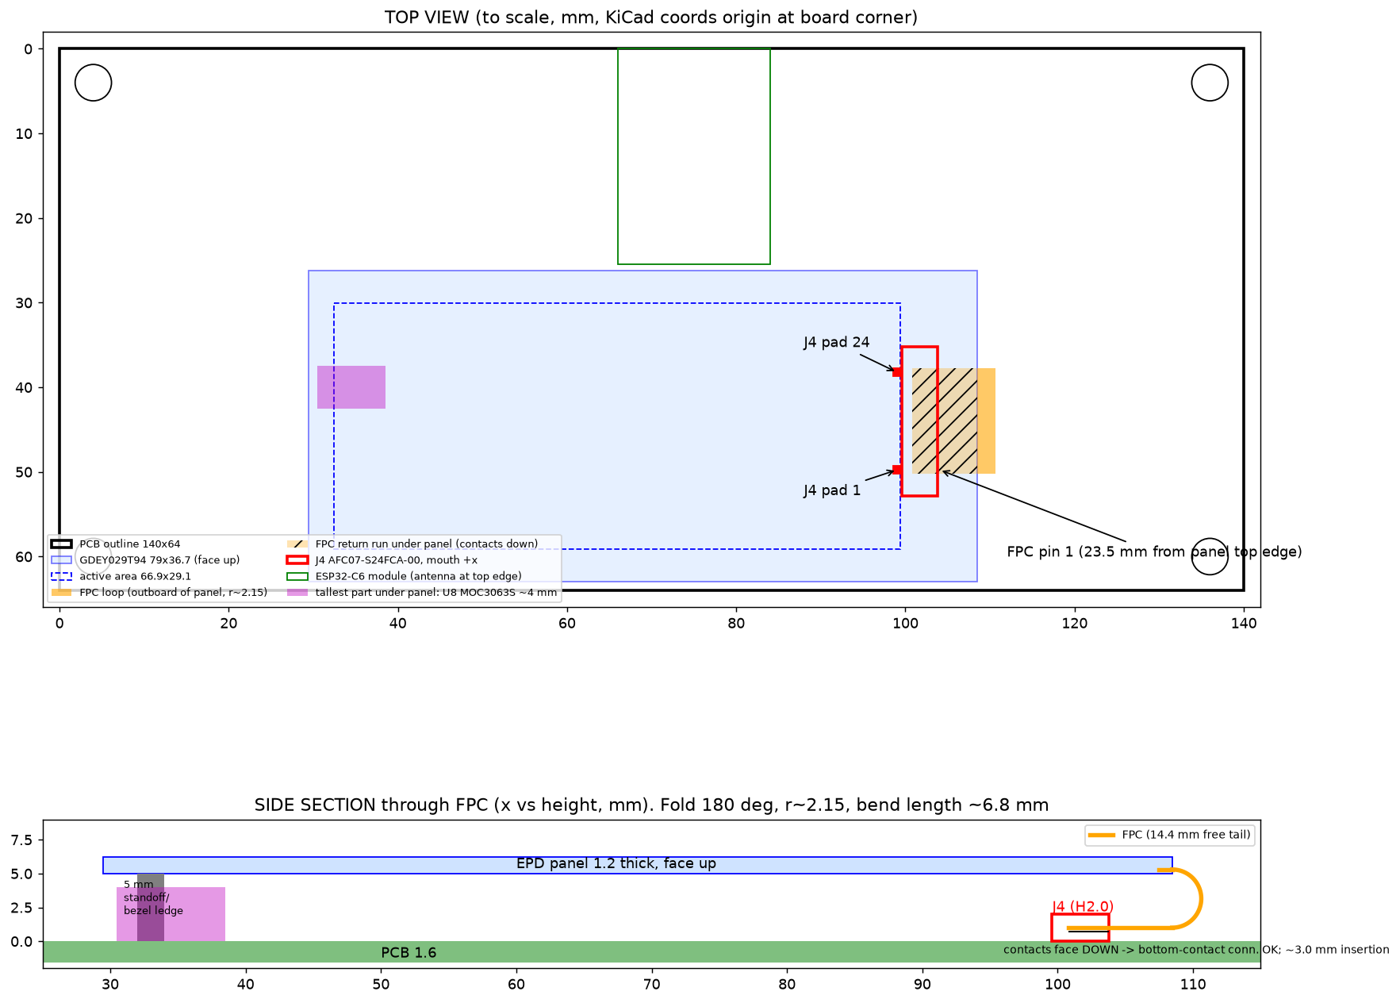
fab/display-fit.png
