Connicpu/thermostat/fab/jlc-placement.png

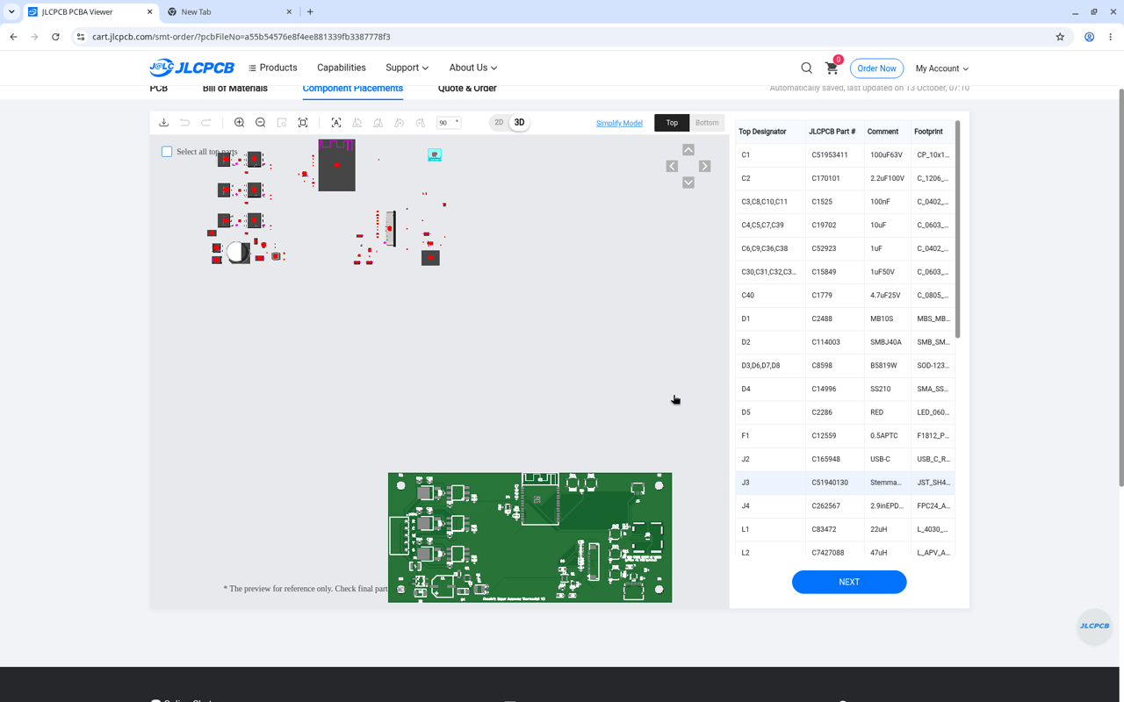
fab/jlc-placement.png
