Connicpu/thermostat/fab/thermostat-v3-3d-bottom.png

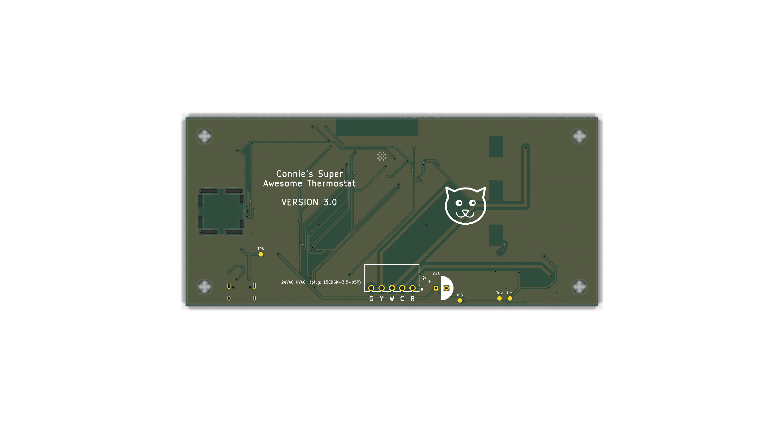
fab/thermostat-v3-3d-bottom.png
