Connicpu/thermostat/fab/thermostat-v3-island-zoom.png

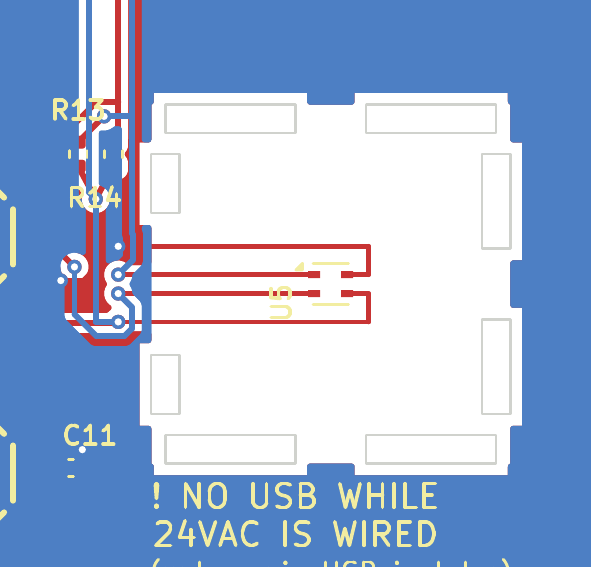
fab/thermostat-v3-island-zoom.png
