Connicpu/thermostat/fab/thermostat-v3-pcb-bottom.png

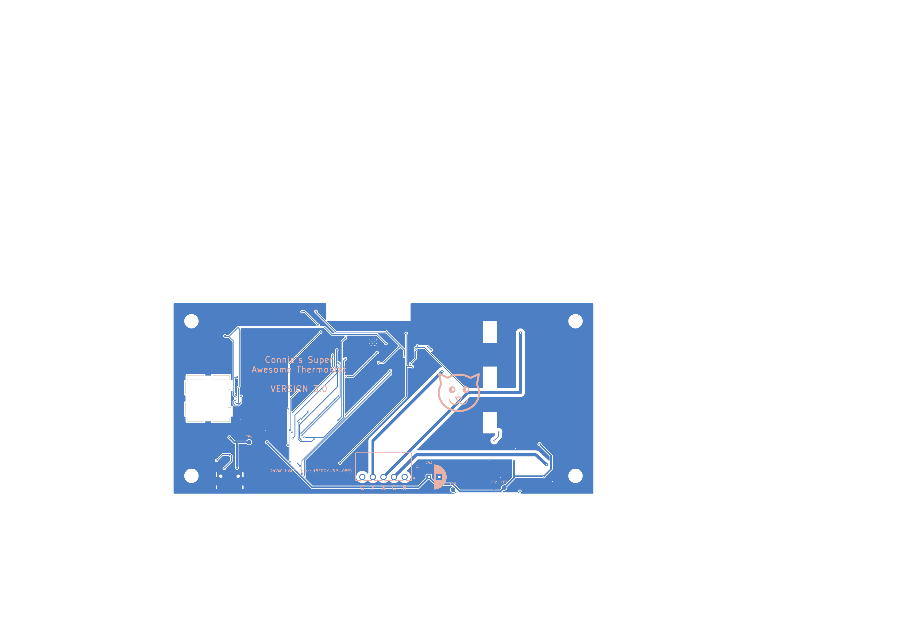
fab/thermostat-v3-pcb-bottom.png
