Connicpu/thermostat/fab/thermostat-v3-pcb-top.png

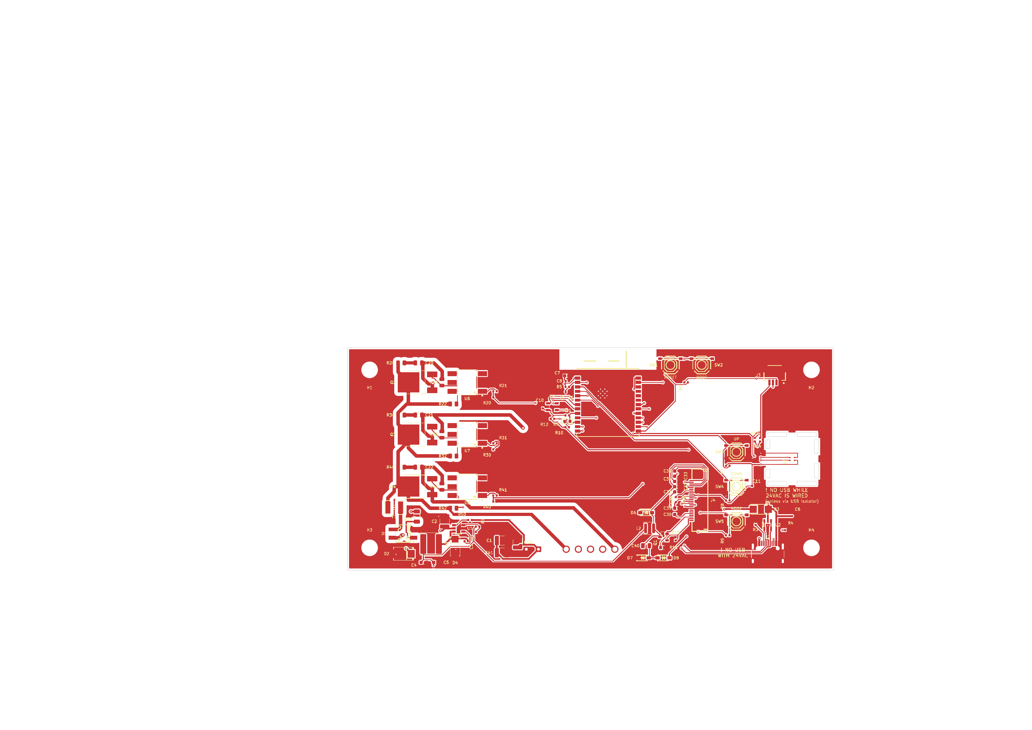
fab/thermostat-v3-pcb-top.png
