Connicpu/thermostat/fab/thermostat-v3-silk-bottom.png

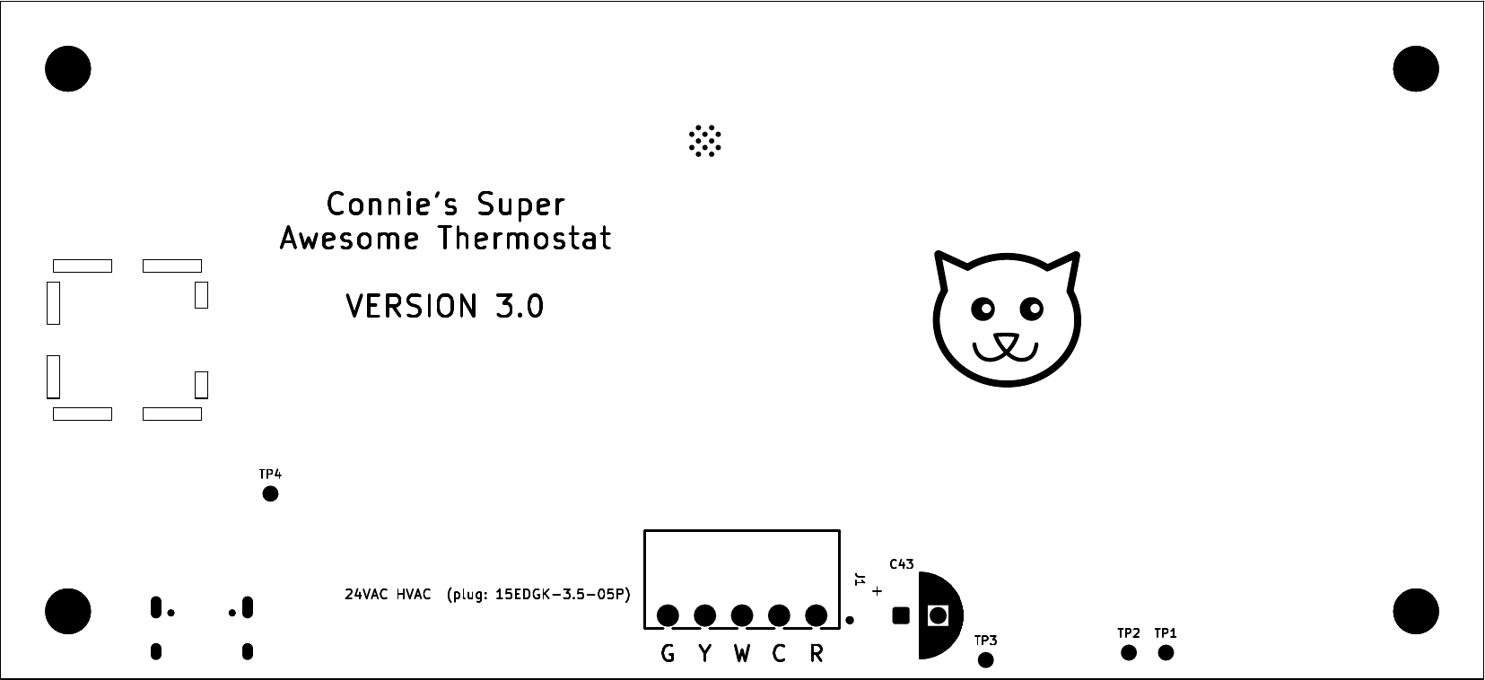
fab/thermostat-v3-silk-bottom.png
