Connicpu/thermostat/fab/thermostat-v3-silk-top.png

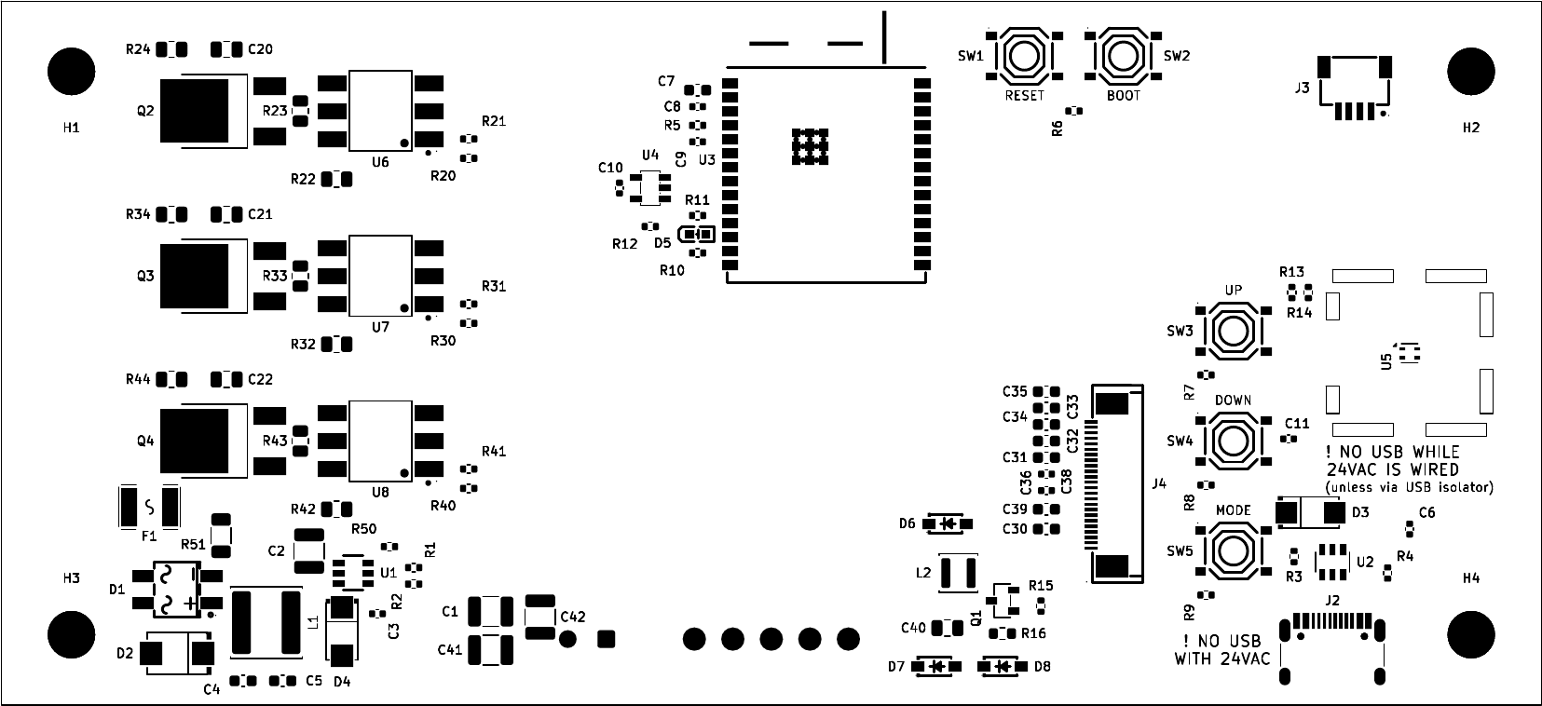
fab/thermostat-v3-silk-top.png
