Connicpu/thermostat/firmware/docs/display_preview_auto_c.png

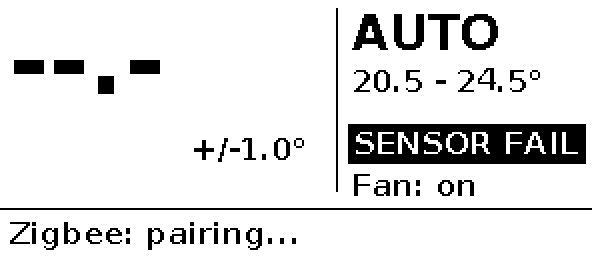
firmware/docs/display_preview_auto_c.png
