Connicpu/thermostat/firmware/ha/lovelace-card/screenshots/closeup-boost-dark.png

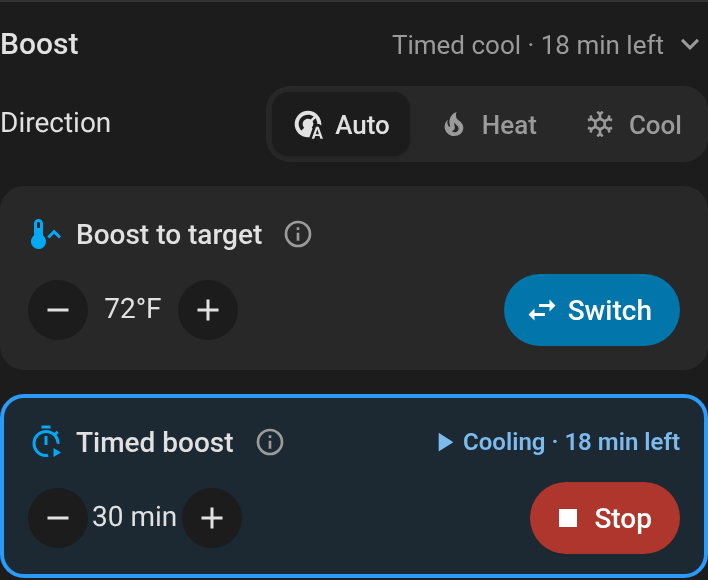
firmware/ha/lovelace-card/screenshots/closeup-boost-dark.png
