Connicpu/thermostat/firmware/ha/lovelace-card/screenshots/closeup-boost-light.png

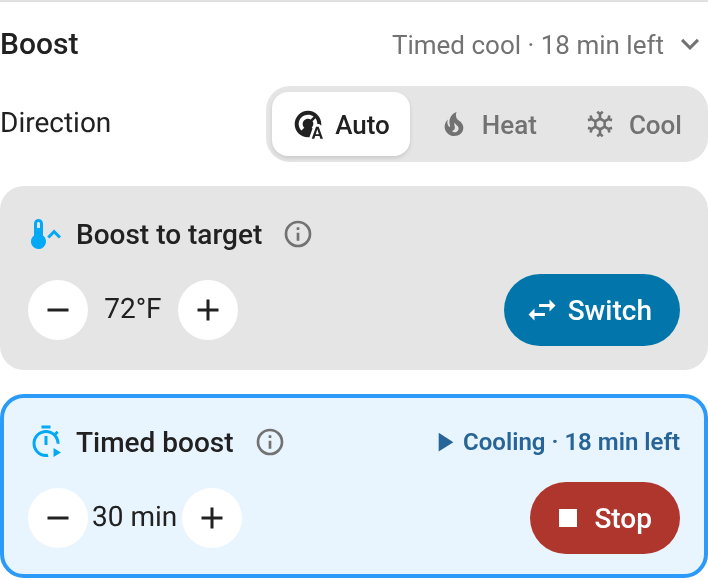
firmware/ha/lovelace-card/screenshots/closeup-boost-light.png
