Connicpu/thermostat/firmware/ha/lovelace-card/screenshots/closeup-morning-boost-dark.png

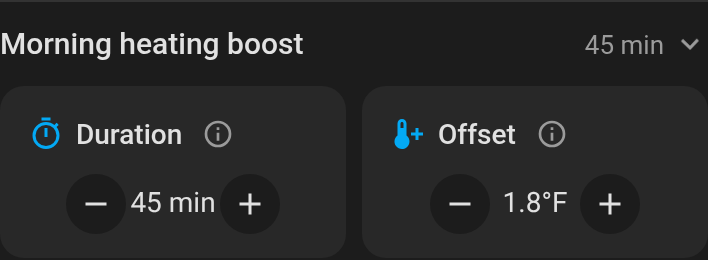
firmware/ha/lovelace-card/screenshots/closeup-morning-boost-dark.png
