Connicpu/thermostat/firmware/ha/lovelace-card/screenshots/closeup-morning-boost-light.png

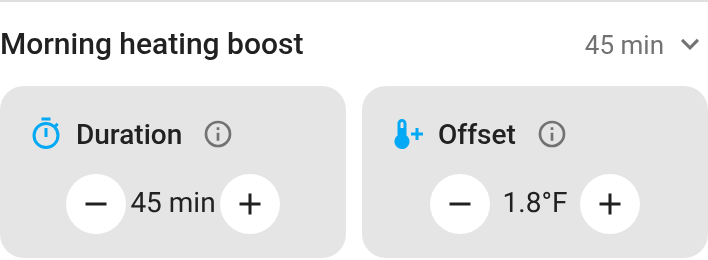
firmware/ha/lovelace-card/screenshots/closeup-morning-boost-light.png
