Connicpu/thermostat/firmware/ha/lovelace-card/screenshots/morning-boost-dark.png

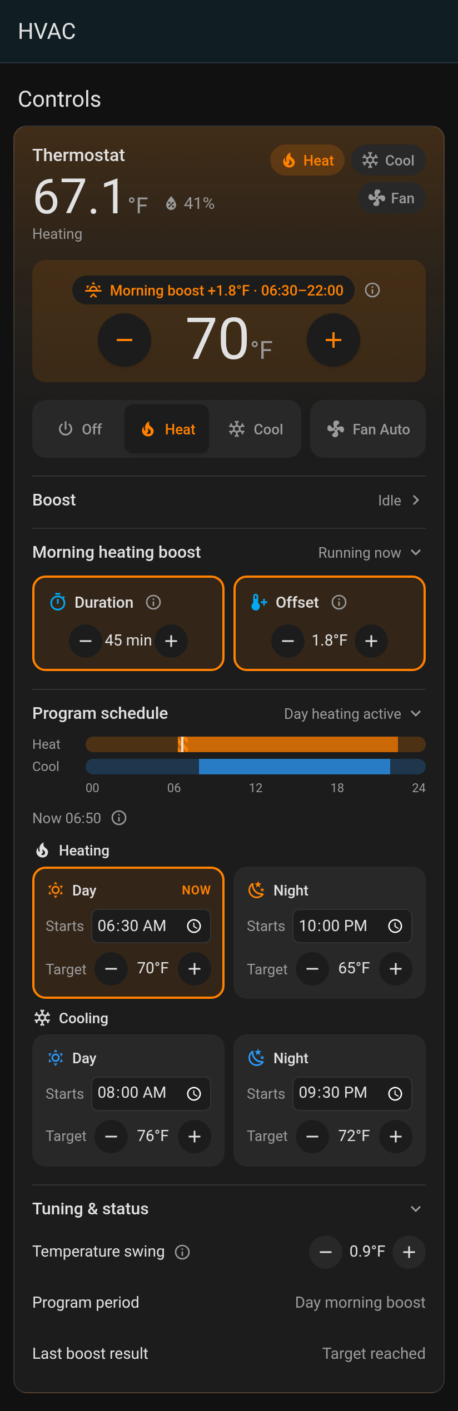
firmware/ha/lovelace-card/screenshots/morning-boost-dark.png
