Connicpu/thermostat/firmware/ha/lovelace-card/screenshots/morning-boost-light.png

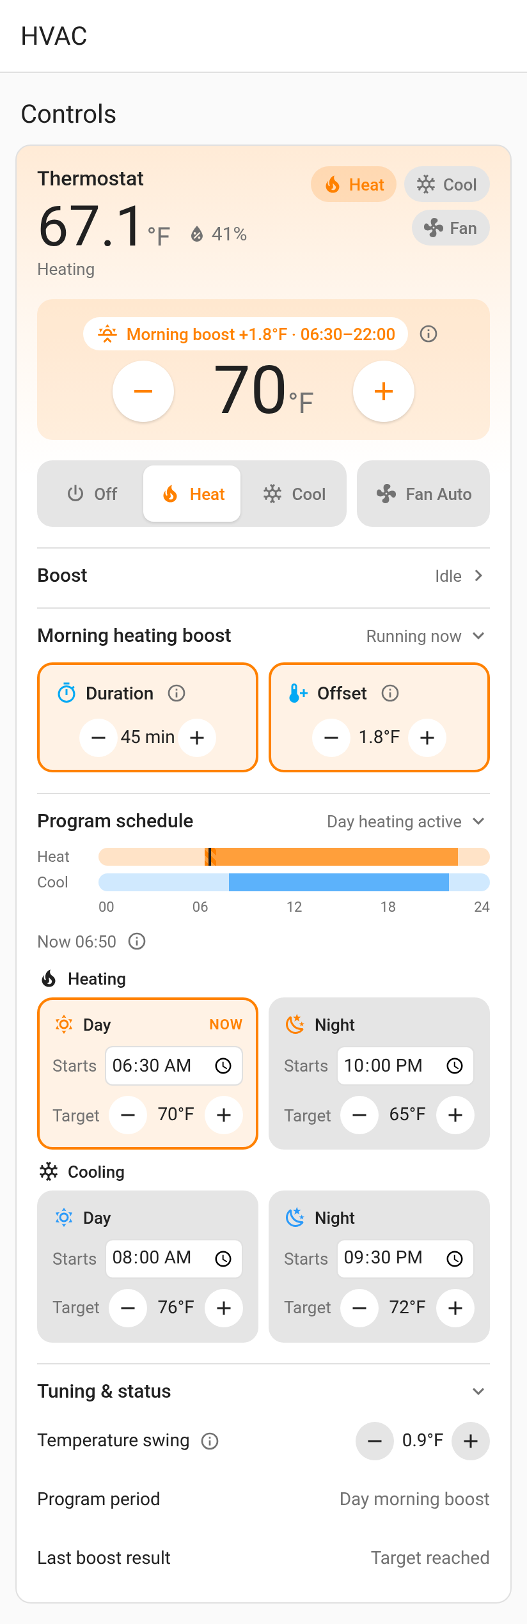
firmware/ha/lovelace-card/screenshots/morning-boost-light.png
