Connicpu/thermostat/firmware/ha/lovelace-card/screenshots/tooltip-dark.png

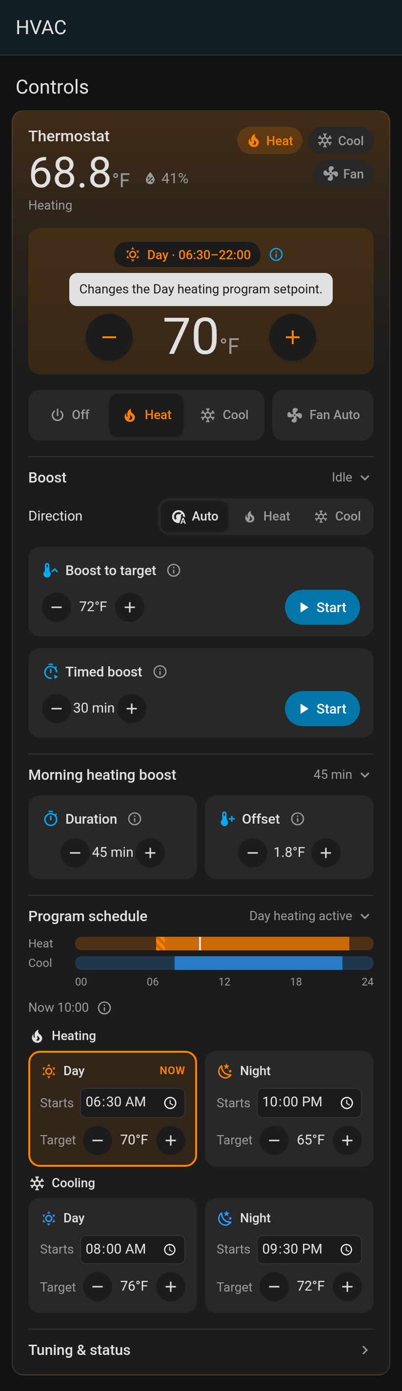
firmware/ha/lovelace-card/screenshots/tooltip-dark.png
