Connicpu/thermostat/firmware/ha/lovelace-card/screenshots/tooltip-light.png

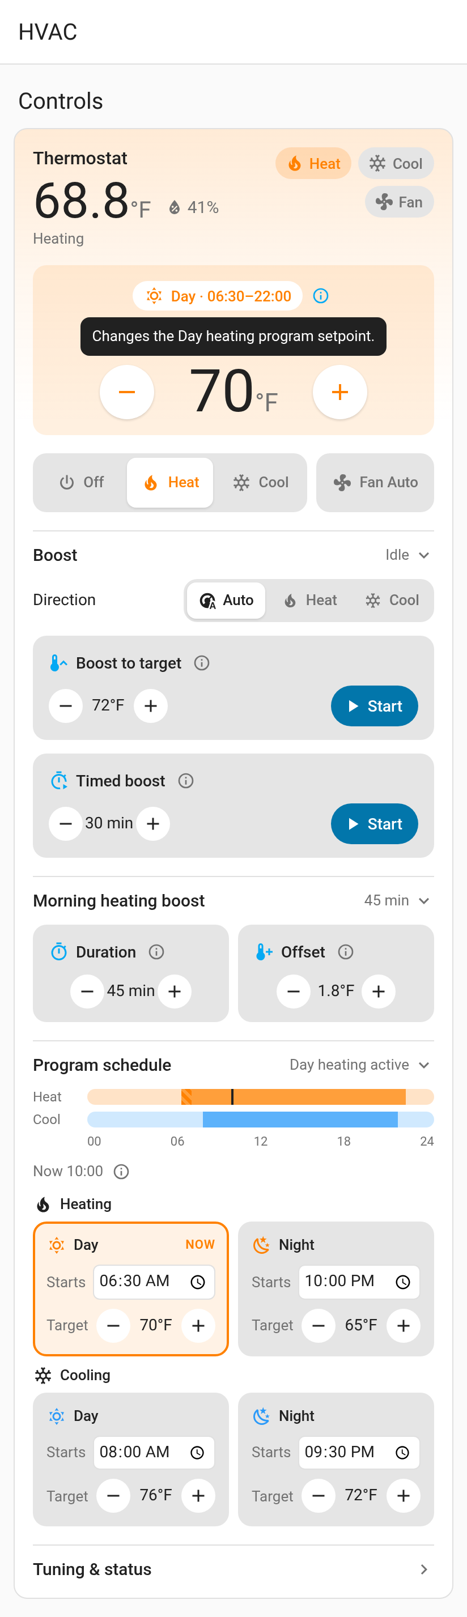
firmware/ha/lovelace-card/screenshots/tooltip-light.png
