Connicpu/thermostat/renders/v3-exploded-34.png

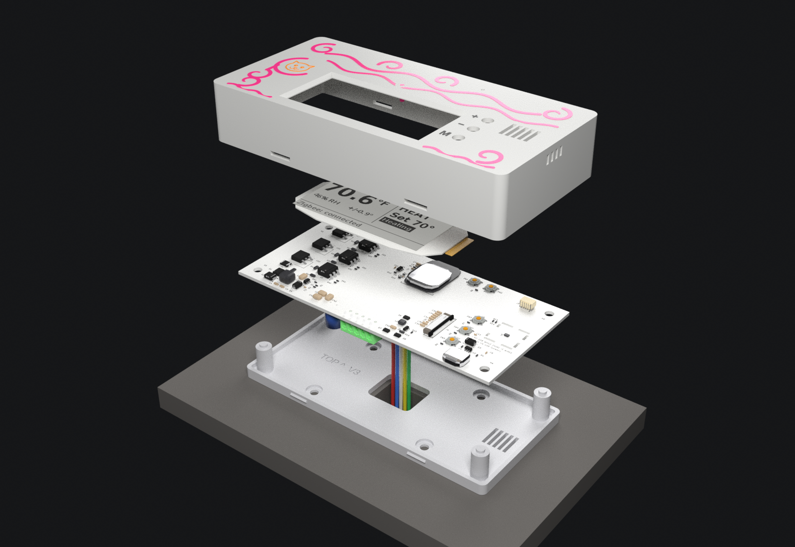
renders/v3-exploded-34.png
