Connicpu/thermostat/renders/v3-exploded-side.png

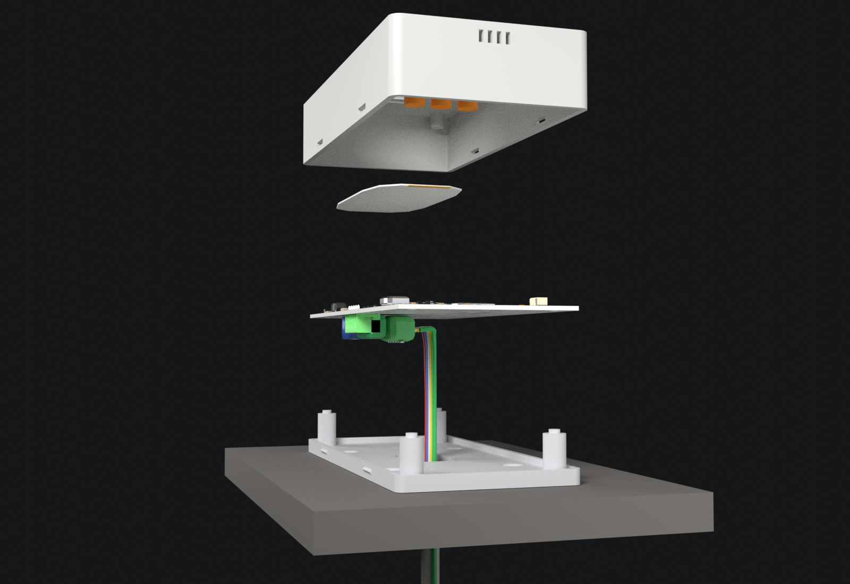
renders/v3-exploded-side.png
