Connicpu/thermostat/review/annot-top.png

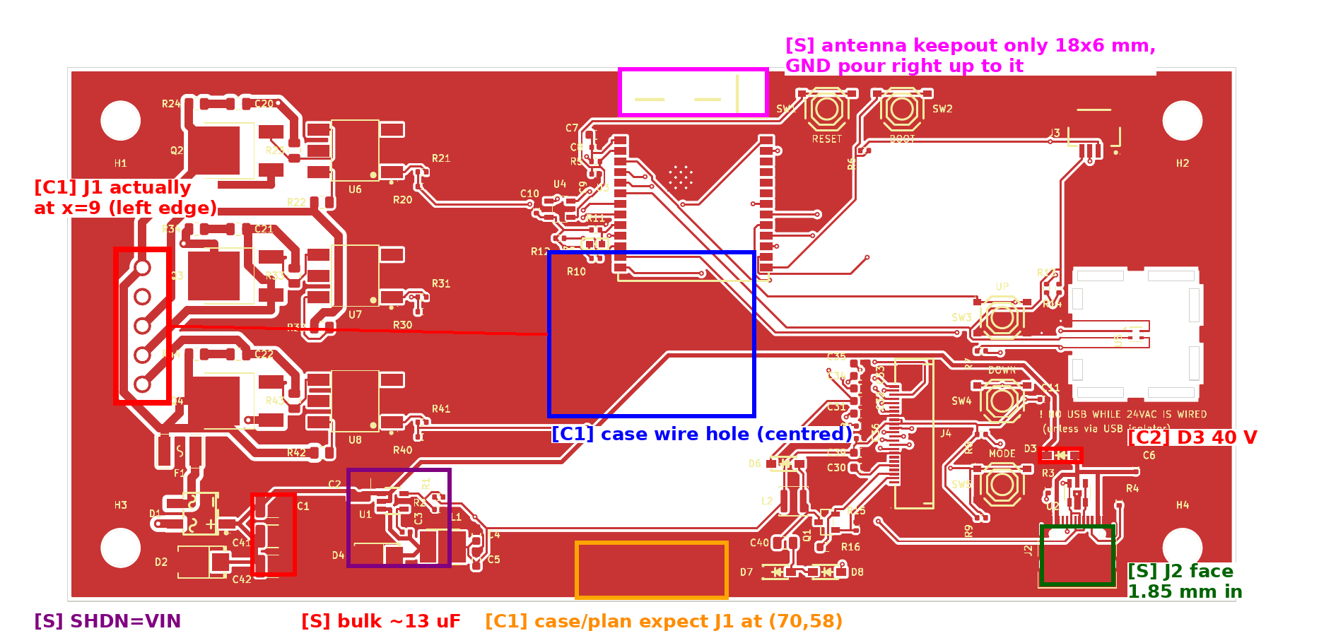
review/annot-top.png
