Connicpu/thermostat/fab/thermostat-v3-BOM-JLC.csv

Comment | Designator | Footprint | LCSC Part #
220R | R21,R31,R41 | R_0402_1005Metric | C25091
4.7uF 25V | C40 | C_0805_2012Metric | C1779
47uH | L2 | L_APV_ANR3015 | C7427088
1uF 50V | C30,C31,C32,C33,C34,C35 | C_0603_1608Metric | C15849
AO3400A | Q1 | SOT-23_AO3400A | C20917
T405-600B | Q2,Q3,Q4 | TO-252-2_TRIAC_DPAK | C283473
10k | R2,R5,R6,R7,R8,R9,R11,R12,R20,R30,R40 | R_0402_1005Metric | C25744
10uF | C4,C5,C7,C39 | C_0603_1608Metric | C19702
100nF | C3,C8,C10,C11 | C_0402_1005Metric | C1525
SS210 | D3,D4 | SMA_SS210 | C14996
1uF | C6,C9,C36,C38 | C_0402_1005Metric | C52923
TS-1187A-B-A-B | SW1,SW2,SW3,SW4,SW5 | SW_TS1187A | C318884
33k | R1 | R_0402_1005Metric | C25779
LMR16006XDDCR | U1 | SOT-23-6_LMR16006 | C87080
1k | R23,R33,R43 | R_0805_2012Metric | C17513
USB-C | J2 | USB_C_Receptacle_HRO_TYPE-C-31-M-12 | C165948
100R | R22,R32,R42 | R_0805_2012Metric | C17408
ESP32-C6-WROOM-1-N8 | U3 | ESP32-C6-WROOM-1 | C5366877
5.1k | R3,R4 | R_0402_1005Metric | C25905
RED | D5 | LED_0603_KT | C2286
4.7k | R13,R14 | R_0402_1005Metric | C25900
100k | R50 | R_0402_1005Metric | C25741
STWD100NYWY3F | U4 | SOT-23-5_STWD100 | C46043
SHT40-AD1B | U5 | Sensirion_DFN-4_1.5x1.5mm_P0.8mm_SHT4x_NoCentralPad | C2909890
4.7uF 100V X7R | C1,C2,C41,C42 | C_1210_3225Metric | C381466
2.9in EPD FPC | J4 | FPC24_AFC07 | C262567
MOC3063S | U6,U7,U8 | MOC3063S | C77950
2.2R | R16 | R_0603_1608Metric | C22939
1M | R15 | R_0402_1005Metric | C26083
B5819W | D6,D7,D8 | SOD-123_B5819W | C8598
MB10S | D1 | MBS_MB10S | C2488
SMBJ40CA | D2 | D_SMB_TVS | C19077590
0.5A 60V PTC | F1 | F1812_PTC | C70113
1k | R10 | R_0402_1005Metric | C11702
3.3R 0.75W pulse | R51 | R_1206_3216Metric | C844038
22uH | L1 | L_Sunlord_SWPA6045S | C83454
USBLC6-2SC6 | U2 | SOT-23-6_USBLC6 | C7519
