Connicpu/thermostat/case/shell_white.stl

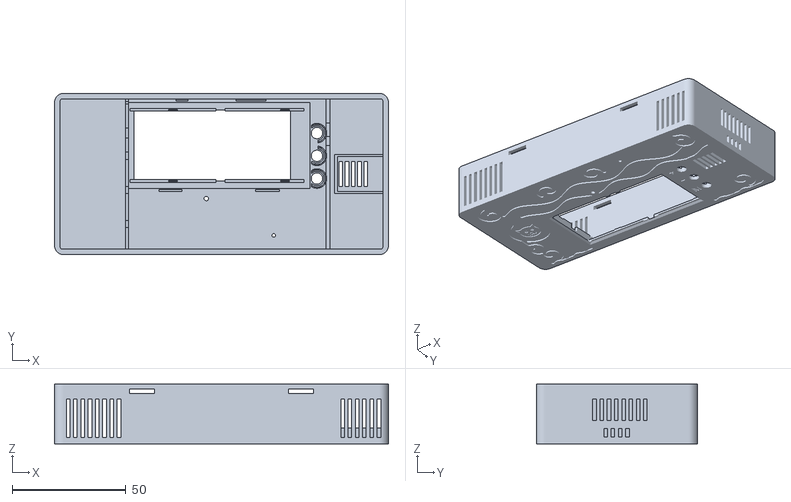
[picture p78: CAD file, 2026-10-29]
case/shell_white.stl
147.0 x 71.0 x 26.2
