Connicpu/thermostat/case/carrier.stl

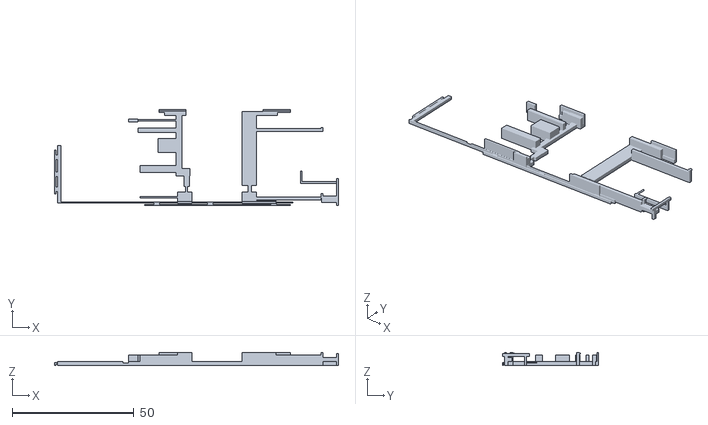
[picture p79: CAD file, 2026-10-29]
case/carrier.stl
116.4 x 39.5 x 5.25
