Connicpu/thermostat/docs/case-r7/carrier.3mf

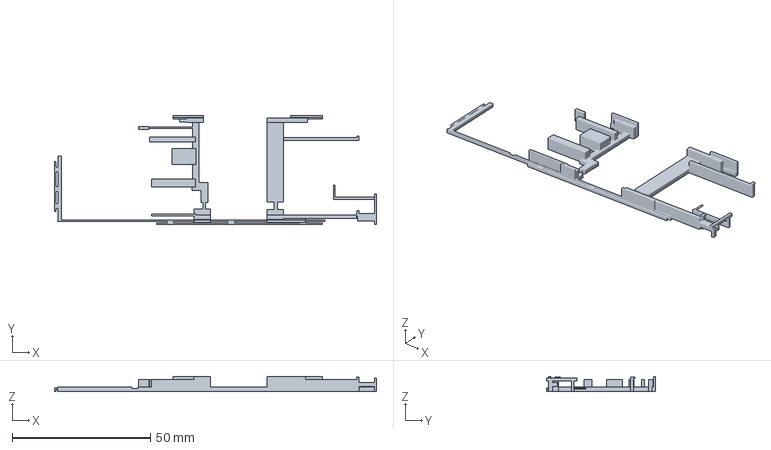
[picture p80: CAD file, 2026-10-29]
docs/case-r7/carrier.3mf
116.4 x 39.5 x 5.25 mm
