Connicpu/thermostat/case/thermostat-case-P2S.3mf

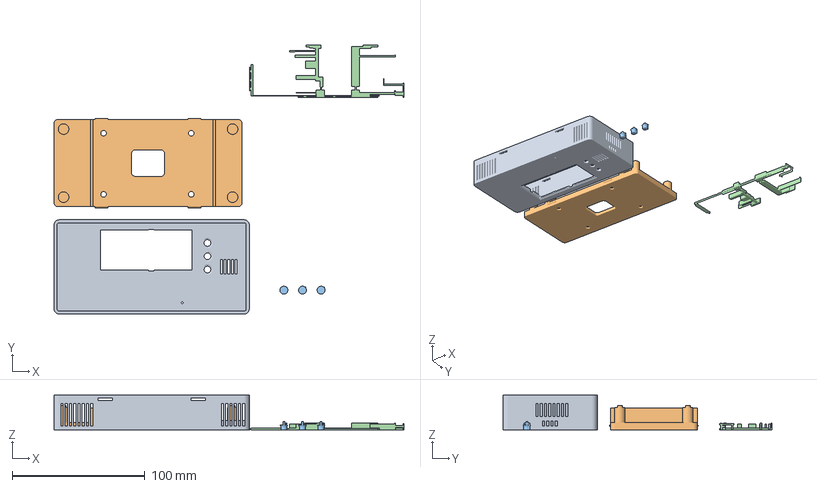
[picture p81: CAD file, 2026-10-29]
case/thermostat-case-P2S.3mf
263.4 x 202.5 x 26.2 mm
front_shell
backplate
button_caps_x3
panel_carrier
