Connicpu/thermostat/docs/case-r7/backplate.3mf

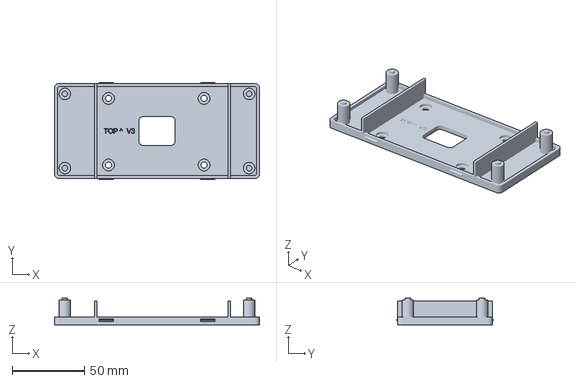
[picture p82: CAD file, 2026-10-29]
docs/case-r7/backplate.3mf
141.6 x 67.2 x 18.4 mm
