Connicpu/thermostat/case/shell_pink.stl

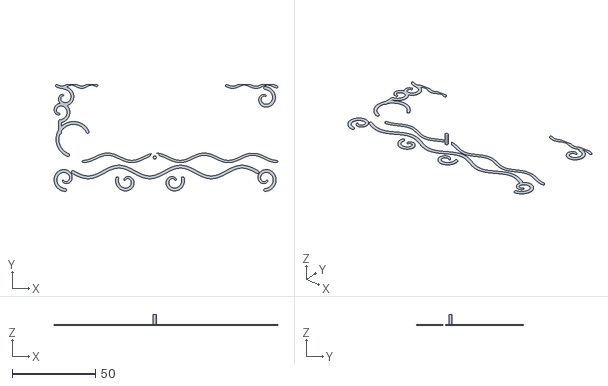
[picture p83: CAD file, 2026-10-27]
case/shell_pink.stl
134.3 x 64.2 x 6.65
