Connicpu/thermostat/docs/case-r7/buttons.3mf

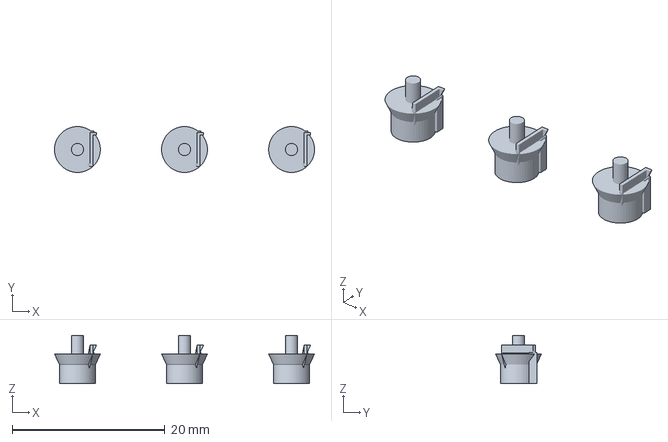
[picture p84: CAD file, 2026-10-29]
docs/case-r7/buttons.3mf
34.0 x 6.00 x 6.32 mm
