Connicpu/thermostat/case/backplate.stl

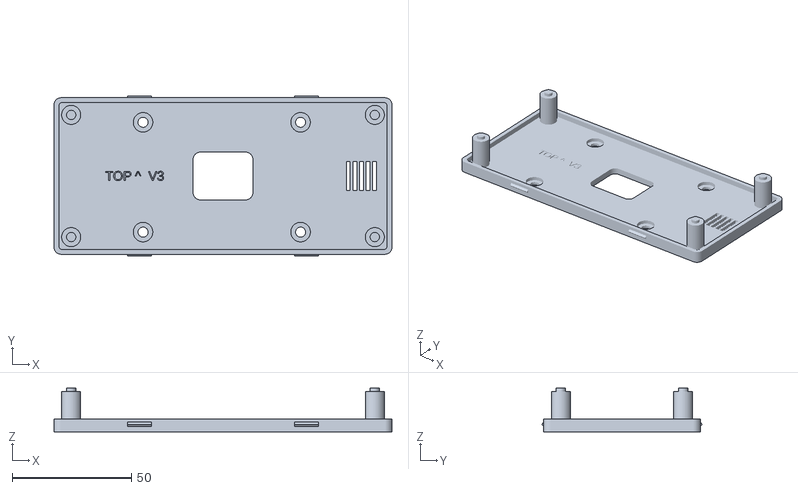
[picture p85: CAD file, 2026-10-13]
case/backplate.stl
141.6 x 67.2 x 18.4
