Connicpu/thermostat/case/shell_black.stl

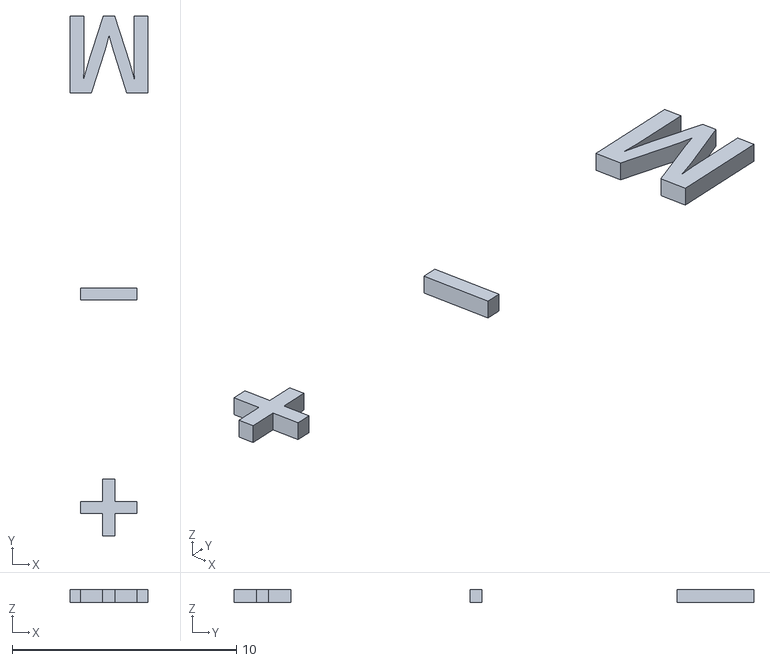
[picture p86: CAD file, 2026-10-13]
case/shell_black.stl
3.50 x 23.2 x 0.6
