Connicpu/thermostat/case/shell_orange.stl

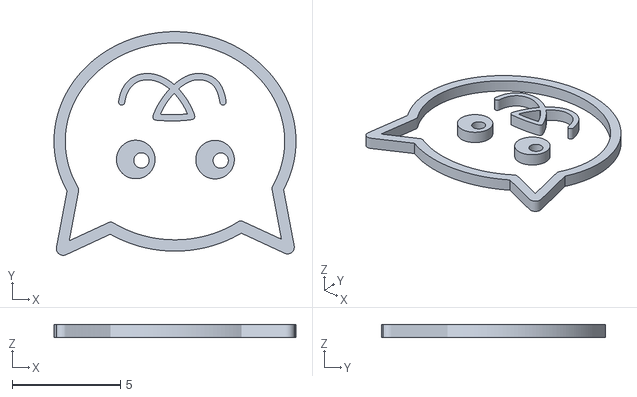
[picture p87: CAD file, 2026-10-13]
case/shell_orange.stl
11.2 x 10.4 x 0.6
