Connicpu/thermostat/case/shell.stl

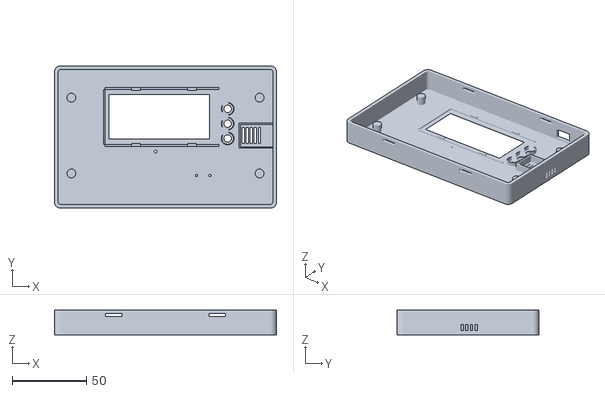
[picture p88: CAD file, 2026-10-13]
case/shell.stl
150.0 x 96.0 x 16.8
