Connicpu/thermostat/case/cat_logo.scad

// V2 cat logo outline (bitmap2component), units mm, centred
cat_w=13.999; cat_h=12.939;
module cat2d(){
 polygon([[-6.434,6.469],[-6.408,6.467],[-6.384,6.463],[-6.361,6.457],[-6.335,6.448],[-6.326,6.445],[-6.320,6.442],[-6.307,6.436],[-6.287,6.427],[-6.260,6.415],[-6.226,6.399],[-6.187,6.381],[-6.141,6.360],[-6.090,6.336],[-6.034,6.310],[-5.972,6.282],[-5.906,6.251],[-5.835,6.219],[-5.761,6.184],[-5.682,6.148],[-5.599,6.110],[-5.514,6.070],[-5.425,6.029],[-5.334,5.986],[-5.240,5.943],[-5.143,5.898],[-5.045,5.853],[-5.025,5.844],[-4.927,5.798],[-4.831,5.753],[-4.737,5.710],[-4.646,5.667],[-4.557,5.626],[-4.471,5.587],[-4.389,5.549],[-4.310,5.512],[-4.235,5.477],[-4.165,5.445],[-4.099,5.414],[-4.037,5.386],[-3.981,5.360],[-3.930,5.336],[-3.884,5.315],[-3.845,5.297],[-3.811,5.281],[-3.784,5.269],[-3.764,5.260],[-3.751,5.254],[-3.745,5.251],[-3.744,5.251],[-3.739,5.252],[-3.727,5.257],[-3.710,5.265],[-3.689,5.276],[-3.664,5.289],[-3.636,5.304],[-3.622,5.312],[-3.401,5.428],[-3.177,5.536],[-2.949,5.637],[-2.719,5.729],[-2.485,5.814],[-2.249,5.891],[-2.010,5.961],[-1.768,6.022],[-1.524,6.075],[-1.277,6.121],[-1.027,6.158],[-0.776,6.188],[-0.706,6.194],[-0.613,6.202],[-0.524,6.209],[-0.437,6.214],[-0.349,6.218],[-0.260,6.221],[-0.168,6.223],[-0.070,6.224],[-0.004,6.224],[0.133,6.224],[0.263,6.221],[0.389,6.216],[0.512,6.209],[0.634,6.200],[0.757,6.189],[0.882,6.175],[0.968,6.165],[1.218,6.129],[1.466,6.085],[1.711,6.033],[1.953,5.973],[2.193,5.906],[2.430,5.830],[2.664,5.747],[2.895,5.656],[3.123,5.557],[3.347,5.450],[3.568,5.336],[3.772,5.223],[3.835,5.186],[5.093,5.770],[5.190,5.815],[5.286,5.860],[5.379,5.903],[5.470,5.945],[5.559,5.986],[5.644,6.026],[5.726,6.064],[5.804,6.100],[5.878,6.134],[5.949,6.167],[6.014,6.197],[6.075,6.225],[6.131,6.251],[6.182,6.275],[6.227,6.296],[6.266,6.314],[6.299,6.329],[6.326,6.341],[6.345,6.350],[6.358,6.356],[6.363,6.359],[6.364,6.359],[6.418,6.375],[6.474,6.384],[6.530,6.385],[6.586,6.377],[6.641,6.362],[6.694,6.339],[6.730,6.318],[6.751,6.302],[6.774,6.282],[6.797,6.258],[6.818,6.234],[6.836,6.211],[6.842,6.202],[6.866,6.158],[6.883,6.115],[6.894,6.069],[6.900,6.021],[6.900,5.991],[6.900,5.932],[6.591,4.299],[6.282,2.666],[6.333,2.568],[6.432,2.369],[6.524,2.166],[6.607,1.961],[6.683,1.754],[6.751,1.545],[6.811,1.334],[6.862,1.121],[6.906,0.908],[6.941,0.692],[6.968,0.476],[6.979,0.364],[6.993,0.150],[6.999,-0.066],[6.998,-0.283],[6.988,-0.499],[6.985,-0.544],[6.965,-0.762],[6.937,-0.979],[6.901,-1.195],[6.857,-1.408],[6.804,-1.621],[6.744,-1.831],[6.675,-2.039],[6.599,-2.245],[6.515,-2.448],[6.423,-2.649],[6.324,-2.847],[6.216,-3.042],[6.102,-3.234],[5.980,-3.423],[5.850,-3.609],[5.797,-3.680],[5.663,-3.853],[5.521,-4.023],[5.373,-4.190],[5.218,-4.352],[5.057,-4.509],[4.892,-4.662],[4.767,-4.769],[4.584,-4.918],[4.396,-5.061],[4.201,-5.199],[4.002,-5.330],[3.797,-5.454],[3.588,-5.572],[3.375,-5.684],[3.158,-5.788],[2.937,-5.885],[2.793,-5.943],[2.559,-6.031],[2.322,-6.111],[2.082,-6.183],[1.840,-6.247],[1.596,-6.303],[1.349,-6.351],[1.101,-6.391],[0.850,-6.423],[0.598,-6.447],[0.447,-6.457],[0.371,-6.461],[0.289,-6.464],[0.203,-6.467],[0.115,-6.468],[0.027,-6.469],[-0.060,-6.469],[-0.144,-6.469],[-0.222,-6.467],[-0.286,-6.465],[-0.489,-6.455],[-0.692,-6.439],[-0.892,-6.419],[-0.979,-6.409],[-1.222,-6.374],[-1.463,-6.332],[-1.701,-6.282],[-1.937,-6.224],[-2.170,-6.160],[-2.399,-6.088],[-2.626,-6.009],[-2.849,-5.923],[-3.069,-5.830],[-3.285,-5.730],[-3.496,-5.624],[-3.704,-5.511],[-3.907,-5.391],[-4.106,-5.265],[-4.300,-5.133],[-4.489,-4.995],[-4.673,-4.850],[-4.851,-4.700],[-5.025,-4.543],[-5.192,-4.381],[-5.354,-4.214],[-5.509,-4.040],[-5.659,-3.862],[-5.738,-3.760],[-5.871,-3.583],[-5.997,-3.401],[-6.116,-3.215],[-6.228,-3.025],[-6.333,-2.831],[-6.431,-2.635],[-6.521,-2.436],[-6.604,-2.235],[-6.679,-2.033],[-6.745,-1.828],[-6.800,-1.637],[-6.853,-1.424],[-6.898,-1.212],[-6.934,-1.000],[-6.963,-0.787],[-6.983,-0.574],[-6.995,-0.361],[-6.999,-0.180],[-6.344,-0.180],[-6.337,-0.388],[-6.323,-0.597],[-6.321,-0.610],[-6.298,-0.814],[-6.267,-1.017],[-6.227,-1.219],[-6.180,-1.418],[-6.124,-1.615],[-6.061,-1.811],[-5.990,-2.004],[-5.911,-2.194],[-5.825,-2.382],[-5.731,-2.566],[-5.631,-2.748],[-5.522,-2.927],[-5.407,-3.102],[-5.285,-3.273],[-5.155,-3.441],[-5.019,-3.605],[-4.876,-3.764],[-4.727,-3.919],[-4.571,-4.070],[-4.408,-4.216],[-4.327,-4.286],[-4.149,-4.429],[-3.967,-4.565],[-3.779,-4.695],[-3.586,-4.819],[-3.389,-4.935],[-3.187,-5.045],[-2.982,-5.148],[-2.772,-5.244],[-2.558,-5.333],[-2.341,-5.414],[-2.120,-5.489],[-1.896,-5.556],[-1.670,-5.615],[-1.440,-5.667],[-1.208,-5.711],[-1.079,-5.732],[-0.900,-5.757],[-0.720,-5.778],[-0.537,-5.794],[-0.349,-5.806],[-0.202,-5.812],[-0.171,-5.812],[-0.134,-5.813],[-0.091,-5.813],[-0.045,-5.814],[0.003,-5.814],[0.052,-5.813],[0.100,-5.813],[0.145,-5.812],[0.186,-5.812],[0.221,-5.811],[0.233,-5.810],[0.312,-5.807],[0.385,-5.803],[0.455,-5.799],[0.525,-5.795],[0.569,-5.791],[0.807,-5.768],[1.042,-5.737],[1.277,-5.698],[1.509,-5.651],[1.738,-5.597],[1.966,-5.534],[2.190,-5.464],[2.411,-5.387],[2.629,-5.302],[2.844,-5.210],[3.055,-5.110],[3.261,-5.004],[3.464,-4.890],[3.476,-4.883],[3.669,-4.764],[3.857,-4.639],[4.040,-4.509],[4.217,-4.372],[4.388,-4.231],[4.553,-4.083],[4.712,-3.931],[4.865,-3.773],[5.011,-3.611],[5.151,-3.443],[5.284,-3.272],[5.410,-3.095],[5.528,-2.914],[5.623,-2.759],[5.727,-2.574],[5.822,-2.385],[5.910,-2.194],[5.991,-2.000],[6.063,-1.802],[6.127,-1.602],[6.183,-1.402],[6.230,-1.205],[6.268,-1.005],[6.299,-0.804],[6.322,-0.602],[6.337,-0.399],[6.343,-0.195],[6.342,0.008],[6.333,0.210],[6.316,0.411],[6.305,0.505],[6.275,0.707],[6.237,0.907],[6.192,1.105],[6.139,1.301],[6.079,1.495],[6.010,1.688],[5.933,1.879],[5.848,2.069],[5.754,2.259],[5.671,2.414],[5.658,2.439],[5.646,2.462],[5.635,2.483],[5.627,2.500],[5.623,2.512],[5.623,2.512],[5.616,2.534],[5.611,2.560],[5.608,2.585],[5.607,2.608],[5.608,2.620],[5.609,2.625],[5.611,2.639],[5.615,2.660],[5.620,2.689],[5.627,2.724],[5.635,2.766],[5.644,2.815],[5.654,2.870],[5.666,2.931],[5.678,2.997],[5.692,3.069],[5.706,3.145],[5.721,3.226],[5.737,3.312],[5.754,3.401],[5.772,3.495],[5.790,3.591],[5.809,3.691],[5.828,3.794],[5.848,3.900],[5.868,4.007],[5.883,4.087],[5.904,4.196],[5.924,4.303],[5.944,4.407],[5.963,4.509],[5.981,4.607],[5.999,4.703],[6.016,4.794],[6.033,4.882],[6.049,4.966],[6.063,5.045],[6.077,5.119],[6.090,5.189],[6.102,5.252],[6.113,5.311],[6.123,5.363],[6.131,5.409],[6.139,5.448],[6.145,5.481],[6.149,5.507],[6.153,5.525],[6.154,5.535],[6.155,5.537],[6.151,5.536],[6.140,5.531],[6.121,5.522],[6.096,5.511],[6.065,5.497],[6.028,5.479],[5.984,5.459],[5.935,5.437],[5.881,5.412],[5.822,5.385],[5.758,5.355],[5.690,5.324],[5.618,5.290],[5.542,5.255],[5.463,5.219],[5.381,5.180],[5.295,5.141],[5.208,5.100],[5.117,5.058],[5.032,5.019],[4.940,4.976],[4.849,4.934],[4.761,4.893],[4.675,4.853],[4.591,4.815],[4.511,4.778],[4.434,4.742],[4.361,4.708],[4.292,4.676],[4.227,4.647],[4.166,4.619],[4.111,4.593],[4.060,4.570],[4.015,4.550],[3.976,4.532],[3.943,4.517],[3.917,4.505],[3.897,4.496],[3.884,4.491],[3.879,4.489],[3.837,4.480],[3.793,4.479],[3.748,4.486],[3.704,4.501],[3.662,4.522],[3.597,4.562],[3.538,4.598],[3.483,4.631],[3.433,4.661],[3.385,4.688],[3.339,4.714],[3.294,4.739],[3.249,4.763],[3.203,4.788],[3.155,4.813],[3.103,4.839],[3.089,4.846],[2.877,4.948],[2.662,5.043],[2.443,5.130],[2.221,5.209],[1.996,5.280],[1.768,5.344],[1.537,5.400],[1.303,5.448],[1.067,5.488],[0.829,5.521],[0.589,5.545],[0.477,5.554],[0.355,5.561],[0.228,5.566],[0.096,5.568],[-0.037,5.569],[-0.172,5.567],[-0.304,5.563],[-0.433,5.557],[-0.557,5.549],[-0.599,5.545],[-0.838,5.521],[-1.076,5.489],[-1.312,5.449],[-1.545,5.400],[-1.776,5.344],[-2.004,5.280],[-2.229,5.209],[-2.452,5.129],[-2.671,5.042],[-2.886,4.948],[-3.099,4.846],[-3.307,4.736],[-3.491,4.631],[-3.520,4.615],[-3.547,4.599],[-3.573,4.585],[-3.595,4.573],[-3.612,4.564],[-3.624,4.559],[-3.625,4.558],[-3.669,4.546],[-3.714,4.542],[-3.759,4.545],[-3.802,4.556],[-3.805,4.557],[-3.811,4.560],[-3.824,4.565],[-3.844,4.575],[-3.871,4.587],[-3.904,4.602],[-3.943,4.620],[-3.988,4.641],[-4.039,4.664],[-4.095,4.690],[-4.156,4.718],[-4.221,4.748],[-4.291,4.780],[-4.364,4.814],[-4.441,4.850],[-4.522,4.887],[-4.606,4.926],[-4.692,4.966],[-4.781,5.007],[-4.872,5.050],[-4.965,5.093],[-4.973,5.096],[-5.066,5.139],[-5.156,5.181],[-5.245,5.223],[-5.331,5.262],[-5.414,5.301],[-5.494,5.338],[-5.571,5.373],[-5.643,5.407],[-5.712,5.439],[-5.776,5.469],[-5.836,5.496],[-5.891,5.522],[-5.941,5.545],[-5.985,5.565],[-6.023,5.583],[-6.055,5.598],[-6.081,5.609],[-6.100,5.618],[-6.112,5.624],[-6.117,5.626],[-6.117,5.626],[-6.116,5.622],[-6.114,5.610],[-6.110,5.590],[-6.105,5.563],[-6.099,5.529],[-6.091,5.488],[-6.082,5.440],[-6.072,5.386],[-6.061,5.327],[-6.049,5.262],[-6.035,5.191],[-6.021,5.116],[-6.006,5.035],[-5.990,4.951],[-5.973,4.862],[-5.956,4.769],[-5.938,4.673],[-5.919,4.574],[-5.900,4.471],[-5.880,4.366],[-5.860,4.259],[-5.842,4.168],[-5.818,4.037],[-5.795,3.915],[-5.773,3.801],[-5.753,3.694],[-5.734,3.594],[-5.717,3.501],[-5.700,3.414],[-5.685,3.335],[-5.671,3.261],[-5.659,3.193],[-5.647,3.131],[-5.637,3.075],[-5.627,3.023],[-5.618,2.976],[-5.611,2.934],[-5.604,2.896],[-5.598,2.863],[-5.592,2.833],[-5.588,2.806],[-5.584,2.783],[-5.580,2.763],[-5.577,2.746],[-5.575,2.731],[-5.573,2.719],[-5.572,2.709],[-5.571,2.700],[-5.570,2.693],[-5.569,2.686],[-5.569,2.681],[-5.569,2.677],[-5.569,2.673],[-5.569,2.669],[-5.569,2.668],[-5.571,2.647],[-5.573,2.627],[-5.578,2.608],[-5.584,2.589],[-5.594,2.567],[-5.606,2.542],[-5.622,2.513],[-5.635,2.490],[-5.731,2.317],[-5.818,2.145],[-5.898,1.974],[-5.953,1.845],[-6.029,1.650],[-6.097,1.453],[-6.156,1.254],[-6.208,1.053],[-6.251,0.851],[-6.286,0.647],[-6.313,0.441],[-6.331,0.235],[-6.342,0.028],[-6.344,-0.180],[-6.999,-0.180],[-6.999,-0.145],[-6.999,-0.054],[-6.996,0.067],[-6.992,0.182],[-6.985,0.292],[-6.977,0.401],[-6.966,0.509],[-6.952,0.619],[-6.936,0.733],[-6.933,0.757],[-6.895,0.972],[-6.850,1.186],[-6.797,1.398],[-6.735,1.609],[-6.665,1.818],[-6.587,2.026],[-6.500,2.233],[-6.405,2.438],[-6.402,2.444],[-6.391,2.467],[-6.377,2.495],[-6.361,2.526],[-6.344,2.560],[-6.326,2.594],[-6.308,2.628],[-6.291,2.660],[-6.276,2.689],[-6.262,2.714],[-6.252,2.732],[-6.250,2.736],[-6.249,2.737],[-6.249,2.738],[-6.249,2.740],[-6.248,2.743],[-6.248,2.746],[-6.249,2.751],[-6.249,2.757],[-6.250,2.765],[-6.252,2.774],[-6.253,2.786],[-6.256,2.800],[-6.258,2.817],[-6.262,2.837],[-6.266,2.860],[-6.270,2.886],[-6.276,2.916],[-6.282,2.950],[-6.289,2.987],[-6.297,3.029],[-6.305,3.076],[-6.315,3.128],[-6.325,3.184],[-6.337,3.246],[-6.350,3.313],[-6.363,3.386],[-6.378,3.466],[-6.394,3.551],[-6.412,3.643],[-6.430,3.742],[-6.450,3.847],[-6.472,3.960],[-6.494,4.080],[-6.518,4.209],[-6.544,4.345],[-6.551,4.380],[-6.859,6.012],[-6.859,6.079],[-6.858,6.116],[-6.856,6.148],[-6.851,6.175],[-6.844,6.201],[-6.833,6.228],[-6.824,6.248],[-6.794,6.299],[-6.759,6.344],[-6.718,6.383],[-6.671,6.415],[-6.620,6.441],[-6.564,6.460],[-6.556,6.462],[-6.537,6.466],[-6.513,6.468],[-6.484,6.469],[-6.467,6.469]]);
 polygon([[0.103,-1.306],[0.310,-1.315],[0.511,-1.328],[0.664,-1.341],[0.720,-1.347],[0.773,-1.353],[0.823,-1.359],[0.870,-1.365],[0.912,-1.370],[0.949,-1.375],[0.980,-1.380],[1.004,-1.385],[1.021,-1.388],[1.027,-1.390],[1.062,-1.407],[1.092,-1.431],[1.116,-1.459],[1.134,-1.492],[1.145,-1.527],[1.148,-1.566],[1.148,-1.576],[1.145,-1.593],[1.139,-1.616],[1.131,-1.646],[1.120,-1.680],[1.107,-1.718],[1.092,-1.760],[1.075,-1.803],[1.058,-1.848],[1.039,-1.893],[1.020,-1.938],[1.011,-1.958],[0.932,-2.125],[0.846,-2.290],[0.752,-2.451],[0.651,-2.608],[0.542,-2.762],[0.427,-2.911],[0.305,-3.056],[0.266,-3.100],[0.212,-3.159],[0.253,-3.194],[0.355,-3.278],[0.456,-3.354],[0.558,-3.422],[0.659,-3.483],[0.759,-3.536],[0.859,-3.581],[0.957,-3.618],[1.055,-3.647],[1.151,-3.667],[1.155,-3.668],[1.220,-3.677],[1.292,-3.682],[1.367,-3.683],[1.443,-3.681],[1.521,-3.675],[1.596,-3.666],[1.668,-3.654],[1.680,-3.651],[1.771,-3.628],[1.856,-3.599],[1.936,-3.564],[2.010,-3.524],[2.080,-3.476],[2.146,-3.423],[2.173,-3.397],[2.229,-3.338],[2.281,-3.274],[2.330,-3.204],[2.374,-3.129],[2.415,-3.047],[2.452,-2.959],[2.486,-2.864],[2.516,-2.762],[2.543,-2.653],[2.568,-2.537],[2.583,-2.447],[2.588,-2.419],[2.593,-2.393],[2.598,-2.370],[2.602,-2.351],[2.605,-2.339],[2.606,-2.337],[2.622,-2.305],[2.645,-2.276],[2.673,-2.253],[2.704,-2.235],[2.739,-2.224],[2.774,-2.220],[2.789,-2.220],[2.827,-2.228],[2.862,-2.243],[2.893,-2.264],[2.919,-2.291],[2.939,-2.322],[2.952,-2.358],[2.957,-2.385],[2.957,-2.401],[2.956,-2.423],[2.953,-2.452],[2.948,-2.486],[2.942,-2.525],[2.935,-2.566],[2.926,-2.611],[2.917,-2.656],[2.908,-2.702],[2.897,-2.748],[2.887,-2.791],[2.879,-2.823],[2.853,-2.918],[2.824,-3.007],[2.793,-3.091],[2.759,-3.172],[2.721,-3.252],[2.671,-3.346],[2.617,-3.433],[2.560,-3.514],[2.498,-3.588],[2.432,-3.657],[2.361,-3.721],[2.355,-3.726],[2.273,-3.789],[2.186,-3.845],[2.094,-3.895],[1.997,-3.937],[1.895,-3.973],[1.791,-4.002],[1.725,-4.016],[1.660,-4.028],[1.593,-4.036],[1.524,-4.042],[1.450,-4.046],[1.370,-4.048],[1.355,-4.048],[1.303,-4.047],[1.259,-4.046],[1.220,-4.045],[1.183,-4.042],[1.148,-4.038],[1.113,-4.033],[1.076,-4.026],[1.035,-4.018],[1.027,-4.017],[0.918,-3.989],[0.808,-3.954],[0.698,-3.911],[0.587,-3.859],[0.475,-3.800],[0.364,-3.733],[0.252,-3.658],[0.140,-3.575],[0.029,-3.485],[-0.008,-3.453],[-0.055,-3.413],[-0.071,-3.427],[-0.179,-3.515],[-0.290,-3.597],[-0.403,-3.673],[-0.518,-3.743],[-0.633,-3.806],[-0.749,-3.862],[-0.865,-3.910],[-0.943,-3.939],[-1.054,-3.973],[-1.166,-4.001],[-1.279,-4.023],[-1.392,-4.039],[-1.503,-4.048],[-1.611,-4.050],[-1.689,-4.048],[-1.809,-4.037],[-1.924,-4.020],[-2.035,-3.996],[-2.140,-3.965],[-2.242,-3.928],[-2.340,-3.883],[-2.434,-3.832],[-2.525,-3.773],[-2.614,-3.707],[-2.619,-3.702],[-2.642,-3.683],[-2.668,-3.659],[-2.697,-3.632],[-2.726,-3.603],[-2.755,-3.574],[-2.782,-3.546],[-2.805,-3.521],[-2.819,-3.504],[-2.894,-3.407],[-2.963,-3.305],[-3.024,-3.198],[-3.080,-3.087],[-3.129,-2.970],[-3.171,-2.847],[-3.207,-2.720],[-3.237,-2.587],[-3.252,-2.509],[-3.258,-2.471],[-3.262,-2.439],[-3.264,-2.414],[-3.265,-2.392],[-3.264,-2.374],[-3.261,-2.358],[-3.255,-2.342],[-3.248,-2.325],[-3.247,-2.322],[-3.228,-2.290],[-3.203,-2.264],[-3.174,-2.244],[-3.143,-2.230],[-3.109,-2.222],[-3.074,-2.221],[-3.039,-2.226],[-3.006,-2.238],[-2.975,-2.257],[-2.956,-2.273],[-2.942,-2.288],[-2.931,-2.303],[-2.921,-2.320],[-2.913,-2.340],[-2.906,-2.363],[-2.900,-2.392],[-2.894,-2.428],[-2.890,-2.452],[-2.872,-2.547],[-2.849,-2.643],[-2.821,-2.739],[-2.788,-2.833],[-2.751,-2.923],[-2.710,-3.009],[-2.666,-3.088],[-2.657,-3.103],[-2.599,-3.190],[-2.537,-3.271],[-2.469,-3.344],[-2.398,-3.410],[-2.322,-3.468],[-2.241,-3.520],[-2.156,-3.565],[-2.066,-3.603],[-1.972,-3.633],[-1.873,-3.657],[-1.810,-3.668],[-1.716,-3.679],[-1.619,-3.683],[-1.519,-3.681],[-1.418,-3.673],[-1.317,-3.658],[-1.218,-3.638],[-1.153,-3.621],[-1.043,-3.586],[-0.932,-3.543],[-0.822,-3.491],[-0.712,-3.433],[-0.602,-3.366],[-0.494,-3.293],[-0.388,-3.213],[-0.373,-3.201],[-0.355,-3.187],[-0.340,-3.174],[-0.328,-3.164],[-0.321,-3.158],[-0.320,-3.156],[-0.321,-3.152],[-0.328,-3.143],[-0.338,-3.130],[-0.349,-3.117],[-0.453,-2.999],[-0.554,-2.875],[-0.651,-2.748],[-0.744,-2.618],[-0.833,-2.485],[-0.917,-2.351],[-0.996,-2.216],[-1.068,-2.080],[-1.135,-1.945],[-1.195,-1.812],[-1.241,-1.695],[-0.845,-1.695],[-0.844,-1.699],[-0.840,-1.711],[-0.832,-1.727],[-0.822,-1.749],[-0.810,-1.775],[-0.797,-1.804],[-0.781,-1.836],[-0.768,-1.862],[-0.694,-2.006],[-0.611,-2.150],[-0.522,-2.293],[-0.427,-2.434],[-0.327,-2.571],[-0.222,-2.704],[-0.152,-2.788],[-0.122,-2.822],[-0.097,-2.850],[-0.077,-2.872],[-0.062,-2.887],[-0.053,-2.896],[-0.048,-2.898],[-0.045,-2.895],[-0.036,-2.887],[-0.024,-2.874],[-0.010,-2.858],[0.000,-2.847],[0.112,-2.718],[0.219,-2.583],[0.320,-2.443],[0.415,-2.299],[0.503,-2.152],[0.584,-2.003],[0.620,-1.931],[0.633,-1.903],[0.647,-1.873],[0.661,-1.844],[0.674,-1.815],[0.686,-1.788],[0.696,-1.764],[0.705,-1.744],[0.711,-1.728],[0.714,-1.719],[0.714,-1.716],[0.710,-1.715],[0.698,-1.713],[0.679,-1.711],[0.656,-1.709],[0.629,-1.706],[0.599,-1.703],[0.567,-1.700],[0.534,-1.697],[0.502,-1.694],[0.472,-1.692],[0.309,-1.681],[0.140,-1.674],[-0.031,-1.670],[-0.201,-1.669],[-0.367,-1.671],[-0.429,-1.673],[-0.457,-1.674],[-0.489,-1.675],[-0.524,-1.677],[-0.561,-1.679],[-0.599,-1.680],[-0.638,-1.682],[-0.676,-1.684],[-0.712,-1.686],[-0.746,-1.688],[-0.776,-1.690],[-0.802,-1.691],[-0.823,-1.693],[-0.837,-1.694],[-0.844,-1.695],[-0.845,-1.695],[-1.241,-1.695],[-1.247,-1.680],[-1.266,-1.629],[-1.274,-1.606],[-1.279,-1.589],[-1.282,-1.575],[-1.284,-1.562],[-1.285,-1.548],[-1.285,-1.530],[-1.285,-1.510],[-1.284,-1.495],[-1.282,-1.484],[-1.278,-1.472],[-1.272,-1.459],[-1.270,-1.454],[-1.250,-1.422],[-1.224,-1.394],[-1.194,-1.373],[-1.181,-1.366],[-1.172,-1.362],[-1.164,-1.359],[-1.156,-1.356],[-1.146,-1.354],[-1.135,-1.352],[-1.121,-1.350],[-1.102,-1.348],[-1.078,-1.346],[-1.049,-1.343],[-1.012,-1.340],[-0.999,-1.339],[-0.772,-1.323],[-0.548,-1.311],[-0.327,-1.305],[-0.110,-1.303]]);
 polygon([[-2.256,2.038],[-2.218,2.038],[-2.182,2.037],[-2.150,2.035],[-2.123,2.033],[-2.109,2.031],[-2.011,2.011],[-1.917,1.984],[-1.826,1.949],[-1.739,1.907],[-1.656,1.857],[-1.577,1.800],[-1.558,1.785],[-1.489,1.723],[-1.424,1.654],[-1.366,1.579],[-1.313,1.500],[-1.268,1.417],[-1.230,1.330],[-1.206,1.265],[-1.184,1.187],[-1.169,1.109],[-1.159,1.029],[-1.154,0.958],[-1.155,0.863],[-1.164,0.770],[-1.180,0.679],[-1.205,0.590],[-1.237,0.501],[-1.263,0.445],[-1.300,0.372],[-1.340,0.306],[-1.383,0.245],[-1.432,0.187],[-1.487,0.130],[-1.490,0.127],[-1.540,0.080],[-1.589,0.040],[-1.639,0.003],[-1.693,-0.031],[-1.722,-0.049],[-1.796,-0.086],[-1.874,-0.119],[-1.956,-0.146],[-2.039,-0.167],[-2.121,-0.182],[-2.149,-0.186],[-2.165,-0.187],[-2.187,-0.188],[-2.214,-0.189],[-2.244,-0.189],[-2.275,-0.189],[-2.305,-0.189],[-2.333,-0.189],[-2.357,-0.189],[-2.375,-0.188],[-2.380,-0.187],[-2.466,-0.175],[-2.554,-0.154],[-2.641,-0.127],[-2.726,-0.094],[-2.806,-0.054],[-2.859,-0.024],[-2.908,0.009],[-2.957,0.046],[-3.007,0.088],[-3.054,0.131],[-3.097,0.174],[-3.134,0.216],[-3.134,0.217],[-3.193,0.297],[-3.244,0.380],[-3.287,0.467],[-3.323,0.557],[-3.352,0.651],[-3.372,0.747],[-3.378,0.784],[-3.381,0.819],[-3.384,0.859],[-3.385,0.903],[-3.385,0.948],[-3.384,0.986],[-2.384,0.986],[-2.382,0.930],[-2.372,0.875],[-2.355,0.821],[-2.331,0.769],[-2.300,0.719],[-2.262,0.674],[-2.248,0.659],[-2.201,0.620],[-2.150,0.588],[-2.095,0.563],[-2.036,0.546],[-2.024,0.543],[-1.998,0.539],[-1.967,0.538],[-1.933,0.537],[-1.900,0.539],[-1.871,0.542],[-1.867,0.543],[-1.809,0.557],[-1.754,0.578],[-1.704,0.607],[-1.657,0.641],[-1.616,0.680],[-1.581,0.725],[-1.551,0.774],[-1.528,0.826],[-1.512,0.882],[-1.503,0.940],[-1.502,0.976],[-1.503,1.013],[-1.506,1.045],[-1.512,1.076],[-1.521,1.109],[-1.543,1.165],[-1.571,1.216],[-1.606,1.263],[-1.646,1.305],[-1.691,1.340],[-1.741,1.370],[-1.794,1.393],[-1.850,1.409],[-1.908,1.417],[-1.941,1.419],[-2.003,1.415],[-2.061,1.403],[-2.117,1.383],[-2.170,1.356],[-2.219,1.321],[-2.250,1.293],[-2.290,1.249],[-2.323,1.201],[-2.349,1.150],[-2.368,1.097],[-2.380,1.042],[-2.384,0.986],[-3.384,0.986],[-3.384,0.992],[-3.381,1.032],[-3.378,1.066],[-3.361,1.162],[-3.336,1.256],[-3.303,1.346],[-3.264,1.432],[-3.218,1.514],[-3.165,1.592],[-3.105,1.666],[-3.040,1.733],[-2.968,1.796],[-2.891,1.852],[-2.858,1.874],[-2.776,1.920],[-2.692,1.958],[-2.604,1.990],[-2.512,2.015],[-2.415,2.033],[-2.393,2.035],[-2.365,2.037],[-2.331,2.038],[-2.295,2.038]]);
 polygon([[2.371,2.049],[2.466,2.040],[2.553,2.025],[2.608,2.012],[2.666,1.994],[2.725,1.972],[2.783,1.948],[2.836,1.922],[2.848,1.916],[2.874,1.901],[2.903,1.883],[2.936,1.862],[2.968,1.839],[2.998,1.817],[3.025,1.797],[3.037,1.787],[3.107,1.722],[3.171,1.652],[3.229,1.577],[3.280,1.497],[3.324,1.412],[3.361,1.324],[3.391,1.232],[3.413,1.138],[3.424,1.074],[3.427,1.045],[3.429,1.011],[3.430,0.972],[3.431,0.932],[3.431,0.892],[3.430,0.855],[3.428,0.823],[3.426,0.808],[3.410,0.709],[3.385,0.614],[3.354,0.523],[3.315,0.435],[3.268,0.351],[3.214,0.272],[3.153,0.196],[3.085,0.125],[3.015,0.062],[2.994,0.047],[2.969,0.028],[2.939,0.009],[2.908,-0.011],[2.877,-0.030],[2.849,-0.047],[2.826,-0.059],[2.737,-0.100],[2.646,-0.132],[2.552,-0.157],[2.456,-0.173],[2.440,-0.175],[2.418,-0.177],[2.391,-0.179],[2.360,-0.180],[2.327,-0.181],[2.295,-0.181],[2.265,-0.181],[2.238,-0.180],[2.218,-0.179],[2.216,-0.179],[2.117,-0.164],[2.021,-0.142],[1.928,-0.112],[1.839,-0.075],[1.753,-0.030],[1.671,0.022],[1.620,0.060],[1.597,0.080],[1.569,0.105],[1.541,0.132],[1.512,0.161],[1.484,0.189],[1.461,0.215],[1.447,0.232],[1.393,0.305],[1.345,0.383],[1.303,0.466],[1.267,0.552],[1.239,0.641],[1.223,0.707],[1.216,0.741],[1.211,0.772],[1.207,0.801],[1.204,0.829],[1.202,0.860],[1.202,0.895],[1.201,0.937],[1.201,0.938],[1.202,0.986],[2.202,0.986],[2.206,0.925],[2.217,0.867],[2.236,0.813],[2.263,0.762],[2.297,0.714],[2.329,0.679],[2.374,0.638],[2.421,0.605],[2.470,0.580],[2.524,0.561],[2.568,0.551],[2.594,0.548],[2.625,0.547],[2.659,0.547],[2.692,0.549],[2.722,0.552],[2.746,0.557],[2.806,0.577],[2.861,0.603],[2.911,0.636],[2.955,0.675],[2.994,0.720],[3.027,0.771],[3.034,0.784],[3.059,0.841],[3.075,0.899],[3.083,0.957],[3.084,1.016],[3.076,1.075],[3.060,1.132],[3.036,1.187],[3.012,1.229],[2.994,1.254],[2.971,1.281],[2.946,1.308],[2.920,1.331],[2.907,1.342],[2.885,1.356],[2.858,1.372],[2.827,1.387],[2.797,1.400],[2.769,1.410],[2.755,1.414],[2.697,1.425],[2.638,1.428],[2.580,1.423],[2.523,1.411],[2.469,1.392],[2.417,1.366],[2.369,1.334],[2.326,1.295],[2.294,1.258],[2.260,1.207],[2.234,1.154],[2.215,1.098],[2.205,1.040],[2.202,0.986],[1.202,0.986],[1.203,1.005],[1.207,1.066],[1.215,1.124],[1.226,1.181],[1.241,1.238],[1.255,1.283],[1.289,1.372],[1.329,1.456],[1.375,1.535],[1.428,1.611],[1.462,1.654],[1.478,1.673],[1.500,1.695],[1.524,1.720],[1.550,1.745],[1.576,1.769],[1.599,1.790],[1.617,1.806],[1.677,1.850],[1.743,1.892],[1.814,1.931],[1.887,1.964],[1.961,1.993],[1.998,2.005],[2.089,2.028],[2.181,2.043],[2.275,2.050]]);
}
