Connicpu/thermostat/case/thermostat_case.scad

// Connie's Super Awesome Thermostat V3 - parametric case (OpenSCAD)
// Units mm. Board coords: origin top-left, x right, y down (same as KiCad, board-relative).
// Case coords: origin outer bottom-left of backplate, X right, Y up, Z out of wall (wall surface Z=0).
// Three air zones: hot, middle, and sensor duct.
part = "assembly";   // backplate | shell | carrier | caps | assembly | exploded | section | section_airflow
explode = 0;         // used by "exploded"
$fn = 48;

// ---------------- parameters ----------------
W = 147; H = 71;            // outer footprint (drywall-anchor version); 1.1 mm board-edge gap all round
wall = 2.4;                 // shell side walls (>=2 mm)
clr = 0.3;                  // fit clearance
plate_t = 3.0;              // backplate thickness
standoff_h = 14.0;          // backplate face -> PCB back, so the 11.1 mm 15EDGK plug and 9.5 mm C43 clear a flat plate and lip
pcb_t = 1.6;
panel_gap = 4.45;           // PCB top to the nominal display panel back. The panel sits on the stop, 0.15 mm under this. See case/ASSEMBLY.md
panel_t = 1.2;
front_t = 2.0;              // front face thickness
BW = 140; BH = 64;          // PCB
OX = 3.5;                   // board left edge in case X
OYT = 3.5;                  // board top edge distance from case top
// derived Z
Z_pcb_b = plate_t + standoff_h;
Z_pcb_t = Z_pcb_b + pcb_t;
Z_panel_b = Z_pcb_t + panel_gap;
Z_in = Z_panel_b + panel_t;          // shell inner face = panel front
Z_out = Z_in + front_t;              // total depth
function cx(x) = OX + x;
function cy(y) = H - OYT - y;

// board features (board coords)
holes = [[6.4,6.4],[133.6,6.4],[6.4,57.6],[133.6,57.6]];
bulk = [53.25,58]; bulk_h = 9.5;          // rear C43 8x9 mm electrolytic (+0.5 lead standoff)
plug_w = 18.3; plug_h = 11.1;        // Degson 15EDGK-3.5-05P: (N-1)*3.5+4.3 wide, 11.1 high, 15.6 deep
plug_y0 = 40.45; plug_y1 = 56.05;    // board-y extent of the mated plug (wire entry at y0, toward the hole)
plug_pocket = 0;                     // no plug pocket; the standoffs clear the plug on a flat plate
term = [70,58];                      // rear RA header J1 pin row centre (pins along x, mating face toward -y)
panel = [29.46,26.24,108.46,62.94];  // GDEY029T94 outline (x0,y0,x1,y1)
aa    = [32.46,30.06,99.36,59.12];   // active area (3.0/3.82 mm margins, FPC end on right)
win_m = 0.5;                         // window margin around active area
// GDEY029T94 tail and Jushuo AFC07-S24FCA-00. Drawing numbers; the fold is derived in case/ASSEMBLY.md.
fpc_free = 14.40;                    // free length past the outline
fpc_wide = 12.50;
fpc_guide = 12.60;                   // DIM B, the applicable FPC-width column. Overall length is 17.60.
fpc_thick = 0.30;
fpc_z_ret = 0.50;                    // lower leg. Side view shows 0.50±0.05; it is not labeled as the centerline
mouth_x = 103.77;                    // J4 silk front face. Mouth faces +x
j4_depth = 3.90;                     // unlabelled side-view run back from j4_front. Not DIM B, not a body depth, not a stroke
j4_front = 102.675;                  // housing face 1.10 mm behind the silk mouth
j4_y0 = 36.0;                        // housing body, not the 17.60 mm overall length
j4_y1 = 52.0;
j4_len = 17.60;                      // overall length, ears included, centered on the tail (board y 35.2–52.8)
j4_h = 2.00;                         // titled housing height, and the STEP/WRL extent. No 2.50 or 2.70 callout is in those files
step_mouth = 1.10;                   // silk mouth minus j4_front, from the STEP block in front of that face
fpc_R = (panel_gap - fpc_z_ret) / 2;
fpc_straight = panel[2] - mouth_x;
fpc_arc = PI * fpc_R;
fpc_ins = fpc_free - fpc_arc - fpc_straight;
// A carrier that prints 0.10 mm tall opens the gap by the same amount.
fpc_ins_hi = fpc_free - PI * (panel_gap + 0.10 - fpc_z_ret) / 2 - fpc_straight;
echo(str("FPC R=", fpc_R, " arc=", fpc_arc, " straight=", fpc_straight, " inserted=", fpc_ins, " at +0.10=", fpc_ins_hi));
assert(fpc_ins > 3.0, "FPC tail insertion is short of the connector minimum");
assert(fpc_ins_hi > 3.0, "a tall carrier print drops the FPC below 3.0 mm");
assert(fpc_ins < 4.2, "FPC tail insertion is long");
// 4.0 mm opto under the display panel. The stop sits sh_drop under Z_panel_b.
// The assert below, once sh_drop exists, keeps a short print off the opto tops.
// The display panel rests on the carrier stops. Bridges in the shell press the border.
// The recess over that border is deep enough for a 0.80 mm beam and a 0.45 mm land,
// and it leaves skin under the face. See case/ASSEMBLY.md.
face_recess = 1.26;
xstop_bite = 0.05;                   // +x posts cross the panel edge by this much, so a short print stops the slide
// The outline is 36.70 mm. The datasheet gives that one width.
// 36.50–36.90 is an assumption around it.
panel_lo = 36.50;
panel_hi = 36.90;
panel_h = 36.70;
fence_air = 0.20;                    // air between a long-edge fence and the outline. The fence does not cross the face.
fence_t = 0.80;
// Shell bridges. A 0.50 mm land, 0.45 mm tall, on a 0.80 x 1.20 beam.
// The carrier stop is sh_drop under Z_panel_b. The free land is sh_R_below
// under the nominal panel front when the shell is at the window centre.
sh_root = 2.40;
sh_t = 0.80;
sh_w = 1.20;
sh_y0 = 2.05;
sh_land0 = 2.47;
sh_land1 = 2.97;
sh_nub_h = 0.45;
sh_nub_len = 4.0;
sh_drop = 0.15;
sh_stop = Z_panel_b - sh_drop;
sh_R_below = 0.30;
sh_R = sh_stop + panel_t - sh_R_below;
sh_bite = 0.10;
sh_loc_gap = 0.10;
sh_loc_t = 0.80;
sh_rib_drop = 1.85;
sh_tie_h = 1.20;
sh_ceil_skin = 0.06;
sh_spans = [
  [29.70, 67.50, 0, 48.60],
  [71.60, 106.40, 0, 98.00],
  [29.70, 67.50, 1, 48.60],
  [71.60, 106.40, 1, 98.00]
];
sh_columns = [
  [29.60, 29.30, 33.40, 30.40],
  [33.50, 33.00, 50.20, 34.80],
  [44.30, 26.50, 47.40, 27.70],
  [41.60, 37.20, 50.40, 43.00],
  [34.20, 48.20, 50.20, 51.20],
  [34.20, 60.90, 50.40, 61.55]
];
sh_ties = [
  [33.40, 29.40, 49.50, 30.05]
];
sh_locs = [
  [42.4, 52.6, 0],
  [85.0, 95.6, 0],
  [50.0, 55.2, 1],
  [76.4, 89.6, 1]
];
assert(panel_gap - sh_drop - 0.10 - 4.0 > 0, "panel stop meets the optos");
// Finger push that opens the J4 slider toward +x. The contact face is the -x
// face of the beam. Section is push_t along x and push_h along z, so the bend
// is in the plane of the layers. push_L is the free length from the anchor to
// the free end of that face. Travel is push_defl. E is snap_E.
push_t = 0.80;
push_h = 1.10;
push_defl = 0.75;
push_face_x = 114.80;
push_face_y0 = 53.70;
push_face_y1 = 64.70;
push_z0 = 3.70;                        // mm above the PCB top
push_z1 = 4.80;
push_root_y = 62.50;
push_L = 8.80;
ear_rear_x = 100.767;                  // high-ear rear, WRL slider, board x
shoe_x0 = 100.05;
shoe_x1 = 100.55;
shoe_y0 = 50.45;
shoe_y1 = 51.75;
shoe_z0 = 0.90;
shoe_z1 = 1.20;
// Backplate clips. The polygon apex is 0.80 mm outside the lip face; ±0.90 mm is the bump's z half-span, not the climb.
// The shell inner face is clr off the lip, so the wall moves snap_bump - clr.
// Free length is that wall from the bump up to the front face, which ties the four walls.
// E = 1.8 GPa. Strain = 1.5 t δ / L^2. The 2.4% gate is the Ultimaker PETG flexural strain, 3.6%, divided by 1.5.
// snap_w is the window the bump seats in, and the local width of wall that climbs it.
snap_bump = 0.80;
snap_z = 3.2;
snap_w = 11;
petg_eps = 0.024;
snap_E = 1800;                       // N/mm^2
snap_defl = snap_bump - clr;
snap_L = Z_in - snap_z;
snap_I = snap_w * wall * wall * wall / 12;
snap_eps = 1.5 * wall * snap_defl / (snap_L * snap_L);
snap_F = 3 * snap_E * snap_I * snap_defl / (snap_L * snap_L * snap_L);
echo(str("CLIP L=", snap_L, " defl=", snap_defl, " strain=", snap_eps, " force_N=", snap_F));
assert(abs(panel_h - (panel[3] - panel[1])) < 1e-6, "panel_h is not the outline");
assert(abs((mouth_x - j4_front) - step_mouth) < 0.02, "STEP mouth block is not 1.10 mm");
assert(snap_defl > 0.20, "backplate bump does not reach the shell wall");
assert(snap_L > 11, "backplate clip wall is too short");
assert(snap_eps < petg_eps, "backplate clip strain is past the PETG flexural limit");
assert(snap_F < 8, "backplate clip takes more than a finger");
push_I = push_h * push_t * push_t * push_t / 12;
push_eps = 1.5 * push_t * push_defl / (push_L * push_L);
push_F = 3 * snap_E * push_I * push_defl / (push_L * push_L * push_L);
echo(str("PUSH L=", push_L, " strain=", push_eps, " force_N=", push_F));
assert(abs((push_root_y - push_face_y0) - push_L) < 0.001, "push_L is not the free length");
assert(push_face_y1 - push_face_y0 >= 11, "slider push face is under 11 mm");
assert(push_eps < petg_eps, "slider push strain is past the PETG flexural limit");
assert(push_F < 8, "slider push takes more than a finger");
btn = [[112,30],[112,40],[112,50]];  // UP DOWN MODE
pin = [[93,5]];                      // RESET pinhole only (BOOT is only useful with USB attached)
led = [63.3,21.2];                   // D5 status LED -> light-pipe hole
usb_x = 121;                         // USB-C centre x (mouth faces board bottom edge)
island = [121,25,135,39];            // SHT40 thermal island
anchors = [[40,12],[106,12],[40,58],[106,58]]; // case XY of 4 drywall-anchor screws
anchor_d = 4.2;  anchor_head_d = 8.2; anchor_head_h = 1.6;   // #6 / M3.5 pan head into plastic anchor
wire_open = [25,20];                 // centred drywall wire hole
inlay_d = 0.6;                       // 3 layers @0.2 mm, flush inlays on the face-down surface
include <cat_logo.scad>
cat_xy = [18.5,35]; cat_s = 0.8;     // orange cat inlay left of the window
include <swirls.scad>
show_title = false;                  // no front title; the swirls use that space
swirl_style = "bold";                // "subtle" | "bold" | "none"
swirl_w = swirl_style=="bold" ? 1.8 : 1.2;   // line width (>=3 extrusion widths at 0.4 nozzle)
swirl_margin = 2.0;                  // clearance to window/buttons/holes/lettering/cat

// ---- airflow zones ----
// Front-face clearances include JLCPCB's ±0.16 mm board thickness. The board sits on the
// standoffs, so a thicker board raises the front face and a thinner one does not move the back.
pcb_tol = 0.16;
part_clr = 0.5;
vslot_w = 1.6; vslot_p = 3.2;        // edge-vent slot / web (1.6 = 4 lines at a 0.4 mm nozzle)
vslot_z = [6.5, 23.4];               // above the 5.5 mm lip, 0.85 mm short of the inner face (Z_in = 24.25)
ribL_bx = [26.8, 28.4];              // rear divider, hot zone | middle
// Rib S is at board x 119.0 so the Ø0.65 J2 peg at board x 118.11 keeps >= 0.5 mm
// (118.8 would leave only 0.37 mm). A notch over the peg would open the duct at the inlet.
// The locating pins are Ø3.9 in Ø4.3 holes, so the board can still shift ±0.2 mm.
// Rib S (board x119.0) does not line up with the front partition, which ends at board x117.8.
// That 1.2 mm offset times the 1.1 mm board-edge gap is an ~1.3 mm² leak around the edge,
// between the sensor duct and the middle zone.
ribS_bx = [119.0, 120.6];            // rear divider, middle | sensor duct
rib_gap = 0.4;                       // rib top -> PCB back. Never let the rib touch the board.
rib_end_y = 2.7;                     // lip outer face; caps the rib out to here above the lip
curtain_bx = [27.7, 29.0];           // front curtain, just left of the panel (the outline starts at x 29.46).
                                     // 0.6 mm clear of L1, so that Y-band can sit down near the board.
// C17408 (R22/R32/R42) max body is 2.15 x 1.40 x 0.65. The left edge sits 0.425 mm
// right of this wall. On a +0.16 mm board a 1.0 mm floor leaves ~0.47 mm at the corner;
// 1.1 mm leaves >=0.5 mm. These three sit between the notches, so the floor is what clears them.
curtain_z_floor = 1.1;
// [board y0, y1, height above the PCB]. Lower everywhere the parts allow; C2 holds 3.4.
curtain_notches = [
  [8.4, 11.6, 1.5],                  // R23 0805 (max ~0.65)
  [23.4, 26.6, 1.5],                 // R33
  [38.4, 41.6, 1.5],                 // R43
  [47.8, 52.2, 3.4]                  // C2 1210 at its 2.7 mm max
];
part_bx = [115.9, 117.8];            // front partition. Overlaps the button tubes (fuses a 0.30 mm sliver).
part_z0 = 1.3;                       // clears a 0.55 mm 0402 with the 0.16 mm board tolerance
part_d3_z = 3.2;                     // D3 SMA; raised past Zt+3.0 so +0.16 mm still leaves 0.5
part_j2_z = 4.0;                     // J2 USB-C body is 3.26
baffle_gap = part_clr + pcb_tol;     // 0.66: still 0.5 mm when the board is thick
baffle_x0 = island[0] - 1.25;        // outer left wall, >=0.5 mm clear of R14
baffle_xi = baffle_x0 + 1.2;         // 1.2 mm wall
L_vx = [for (i = [0:7]) 6.0 + i*vslot_p];                 // hot-zone top/bottom slot centres (case X)
S_vx = [for (i = [0:5]) 126.8 + i*vslot_p];               // sensor slots, all to the right of rib S
L_sy = [7.0, 10.2, 13.4, 16.6, 55.0, 58.2, 61.4, 64.6];   // left wall: low inlet, high exhaust (case Y)
S_sy = [for (i = [0:7]) 23.0 + i*vslot_p];                // right wall, rear, island band (case Y)

// ---------------- helpers ----------------
module rrect(w,h,r){ offset(r) square([w-2*r,h-2*r]); }
module rbox(w,h,d,r){ linear_extrude(d) translate([r,r]) rrect(w,h,r); }
module slot2d(l,w){ hull(){ translate([-l/2+w/2,0]) circle(d=w); translate([l/2-w/2,0]) circle(d=w);} }
// Axis-aligned box in board x/y and case z. cy() flips y, so the box is placed at the larger board y.
module board_box(x0, y0, x1, y1, z0, z1) {
  translate([cx(x0), cy(y1), z0]) cube([x1 - x0, y1 - y0, z1 - z0]);
}
// Rear zone wall. Full height inside the lip; above the lip it reaches the lip's outer face
// so the 2.3 x 11.5 mm end windows against the shell close. Prints upright, no supports.
module zone_rib(bx0, bx1) {
  rw = bx1 - bx0;
  ztop = Z_pcb_b - rib_gap;
  translate([cx(bx0), po + lip_t - 0.2, 0])
    cube([rw, ph - 2*lip_t + 0.4, ztop]);
  translate([cx(bx0), rib_end_y, lip_h])
    cube([rw, lip_t + 0.2, ztop - lip_h]);
  translate([cx(bx0), H - rib_end_y - lip_t - 0.2, lip_h])
    cube([rw, lip_t + 0.2, ztop - lip_h]);
}

// ---------------- backplate ----------------
pw = W-2*wall-2*clr; ph = H-2*wall-2*clr; po = wall+clr;
lip_h = 5.5; lip_t = 2;     // 5.5 mm so rear C43 clears the lip by >= 2 mm with no notch
module backplate(){
  difference(){
    union(){
      // plate (flat, no plug pocket)
      translate([po,po,0]) rbox(pw,ph,plate_t,3);
      // perimeter lip that the shell slides over
      // full height all round, no notch under C43
      translate([po,po,0]) difference(){ rbox(pw,ph,lip_h,3); translate([lip_t,lip_t,-1]) rbox(pw-2*lip_t,ph-2*lip_t,lip_h+2,1.5); }
      // snap bumps (45 deg both sides, print without supports). Base embeds 0.1 mm into the lip so the bumps fuse.
      for(s=[[W/2-35,po,0],[W/2+35,po,0],[W/2-35,H-po,180],[W/2+35,H-po,180]])
        translate([s[0],s[1],3.2]) rotate([0,0,s[2]]) rotate([0,90,0]) linear_extrude(10,center=true) polygon([[0.9,0.1],[0.9,0],[0,-0.8],[-0.9,0],[-0.9,0.1]]);
      // PCB standoffs with locating pins
      for(h=holes) translate([cx(h[0]),cy(h[1]),0]){ cylinder(d=8,h=Z_pcb_b); cylinder(d=3.9,h=Z_pcb_b+pcb_t-0.2); }
      zone_rib(ribL_bx[0], ribL_bx[1]);
      zone_rib(ribS_bx[0], ribS_bx[1]);
    }
    // centred drywall wire hole; wires bend into the rear right-angle plug
    translate([W/2,H/2,-1]) linear_extrude(plate_t+2) offset(3) square([wire_open[0]-6,wire_open[1]-6],center=true);
    // 4 drywall anchor screw holes with pan-head recesses
    for(p=anchors) translate([p[0],p[1],-1]){ cylinder(d=anchor_d,h=plate_t+2); translate([0,0,plate_t+1-anchor_head_h]) cylinder(d=anchor_head_d,h=anchor_head_h+0.01); }
    // no drywall-facing island slots: slots there would open the sensor duct onto the wall
    // label recess sits right of rib L so the rib does not cut it
    translate([W/2-26,H/2,plate_t-0.6]) linear_extrude(1) text("TOP ^  V3",size=3.5,halign="center",valign="center");
  }
}

// ---------------- shell bridges ----------------
function sh_y_edge(which) = which == 0 ? panel[1] : panel[3];
function sh_dir(which) = which == 0 ? 1 : -1;

module sh_pillar_pair(x0, x1, y0, y1, z0, z1) {
  board_box(x0, min(y0, y1), x0 + sh_root, max(y0, y1), z0, z1);
  board_box(x1 - sh_root, min(y0, y1), x1, max(y0, y1), z0, z1);
}
module sh_bridge(x0, x1, which, nubx) {
  edge = sh_y_edge(which);
  dir = sh_dir(which);
  y0 = edge + dir * sh_y0;
  y1 = edge + dir * (sh_y0 + sh_w);
  z0 = sh_R + sh_nub_h;
  z1 = z0 + sh_t;
  board_box(x0 + sh_root - 0.12, min(y0, y1), x1 - sh_root + 0.12, max(y0, y1), z0, z1);
  ny0 = edge + dir * sh_land0;
  ny1 = edge + dir * sh_land1;
  board_box(nubx - sh_nub_len / 2, min(ny0, ny1), nubx + sh_nub_len / 2, max(ny0, ny1), sh_R, z0 + 0.02);
}
module sh_pillars(x0, x1, which) {
  edge = sh_y_edge(which);
  dir = sh_dir(which);
  y0 = edge + dir * sh_y0;
  y1 = edge + dir * (sh_y0 + sh_w);
  z0 = sh_R + sh_nub_h;
  z1 = Z_in + face_recess + sh_bite;
  sh_pillar_pair(x0, x1, y0, y1, z0, z1);
}
module sh_loc(x0, x1, which) {
  edge = sh_y_edge(which);
  dir = sh_dir(which);
  y_fence = edge - dir * (fence_air + fence_t);
  y_near = y_fence - dir * sh_loc_gap;
  y_far = y_near - dir * sh_loc_t;
  z0 = Z_in - sh_rib_drop;
  z1 = Z_in + face_recess + sh_bite;
  board_box(x0, min(y_near, y_far), x1, max(y_near, y_far), z0, z1);
}
module sh_beams() { for (s = sh_spans) sh_bridge(s[0], s[1], s[2], s[3]); }
module sh_pillar_all() { for (s = sh_spans) sh_pillars(s[0], s[1], s[2]); }
module sh_loc_all() { for (s = sh_locs) sh_loc(s[0], s[1], s[2]); }
module sh_added() { sh_beams(); sh_pillar_all(); sh_loc_all(); }

// ---------------- front shell ----------------
module shell_plain(pk=true){   // pk=false: preview only, pockets left solid (inlays sit 0.01 proud) to avoid OpenCSG specks
  difference(){
    union(){
      difference(){
        rbox(W,H,Z_out,4);
        translate([wall,wall,-1]) rbox(W-2*wall,H-2*wall,Z_in+1,1.2);   // r1.2: square PCB corners keep >=1 mm
      }
      // The shell does not clamp the board. The locating pins keep the board, and the
      // bumps on the backplate lip are the only clips.
      // thermal baffle around SHT40 island, open to the right wall
      translate([0,0,Z_pcb_t+baffle_gap]) linear_extrude(Z_in-Z_pcb_t-baffle_gap+0.01) difference(){
        translate([cx(baffle_x0),cy(island[3]+1.6)]) square([W-wall-cx(baffle_x0)+0.5, island[3]-island[1]+3.2]);
        translate([cx(baffle_xi),cy(island[3]+0.6)]) square([W, island[3]-island[1]+1.2]);
      }
      // front curtain, hot zone | panel. Sits near the board, notched up over each part.
      difference(){
        translate([cx(curtain_bx[0]), wall-0.01, Z_pcb_t+curtain_z_floor])
          cube([curtain_bx[1]-curtain_bx[0], H-2*wall+0.02, Z_in-Z_pcb_t-curtain_z_floor+0.01]);
        for (n = curtain_notches)
          translate([cx(curtain_bx[0])-1, cy(n[1]), Z_pcb_t-1])
            cube([curtain_bx[1]-curtain_bx[0]+2, n[1]-n[0], 1+n[2]]);
        // carrier rail crosses the curtain at the board's bottom edge. The rail plugs the lower part.
        translate([cx(curtain_bx[0])-0.4, cy(63.90), Z_pcb_t-1])
          cube([curtain_bx[1]-curtain_bx[0]+0.8, 63.90-62.90, 1+1.55]);
      }
      // front partition, buttons | sensor compartment. Notched over D3 and J2.
      difference(){
        translate([cx(part_bx[0]), wall-0.01, Z_pcb_t+part_z0])
          cube([part_bx[1]-part_bx[0], H-2*wall+0.02, Z_in-Z_pcb_t-part_z0+0.01]);
        translate([cx(part_bx[0])-1, cy(48.5), Z_pcb_t-1]) cube([5, 48.5-44.5, 1+part_d3_z]);
        translate([cx(part_bx[0])-1, cy(65), Z_pcb_t-1]) cube([5, 65-54.5, 1+part_j2_z]);
      }
      // button guide tubes. OD 8.6 stays: it overlaps the partition and keeps the 10 mm pitch.
      for(b=btn) translate([cx(b[0]),cy(b[1]),btn_tube_z0]) cylinder(d=btn_tube_od,h=Z_in-btn_tube_z0);
    }
    // e-paper window with 45deg outward chamfer
    translate([cx(aa[0])-win_m, cy(aa[3])-win_m, Z_in-0.5]) cube([aa[2]-aa[0]+2*win_m, aa[3]-aa[1]+2*win_m, 10]);
    hull(){
      translate([cx(aa[0])-win_m, cy(aa[3])-win_m, Z_in+0.85]) cube([aa[2]-aa[0]+2*win_m, aa[3]-aa[1]+2*win_m, 0.01]);
      translate([cx(aa[0])-win_m-1.6, cy(aa[3])-win_m-1.6, Z_out]) cube([aa[2]-aa[0]+2*win_m+3.2, aa[3]-aa[1]+2*win_m+3.2, 0.01]);
    }
    // The shell clears the display panel, including while it lifts off the backplate clips.
    // The button tubes overlap the cable end of the outline. The cut runs down the tube
    // so the lower wall does not sweep the panel on the way off. The catch stays on the
    // partition side of each bore.
    // +1.20 mm past the outline covers the cable-end posts. They stand in this pocket.
    board_box(panel[0]-0.30, panel[1]-0.30, panel[2]+1.20, panel[3]+0.30, Z_pcb_t+0.50, Z_in-0.02);
    // Fold pocket. The bend bulges past the outline, and the lower leg sits near the board.
    board_box(panel[2]-0.40, 37.40, panel[2]+4.0, 50.60, Z_pcb_t+0.40, Z_in-0.02);
    // Land behind the display panel. The bridges sit in this band.
    board_box(panel[0]-0.30, panel[1]-0.55, panel[2]+0.40, panel[3]+0.55, Z_in-0.02, Z_in+face_recess);
    button_void();
    // RESET pinhole, LED light pipe
    for(p=pin) translate([cx(p[0]),cy(p[1]),Z_in-1]) cylinder(d=1.6,h=10);
    // no USB opening: USB-C is only reachable with the board out of the case (ground-loop hazard)
    // vents: front over island (outlet), right side wall, bottom wall below island
    for(i=[0:4]) translate([cx(island[0]+1.5+i*2.75),cy((island[1]+island[3])/2),Z_in-1]) linear_extrude(10) square([1.6,11],center=true);
    for(i=[0:3]) translate([W-wall-1, cy(island[1]+2+i*3.2)-0.8, Z_pcb_t+1]) cube([wall+2,1.6,Z_in-Z_pcb_t-2]);
    // hot-zone chimney: bottom in, top out, left wall low in / high out
    for (x = L_vx) for (y = [-1, H-wall-1]) translate([x-vslot_w/2, y, vslot_z[0]]) cube([vslot_w, wall+2, vslot_z[1]-vslot_z[0]]);
    for (y = L_sy) translate([-1, y-vslot_w/2, vslot_z[0]]) cube([wall+2, vslot_w, vslot_z[1]-vslot_z[0]]);
    // sensor duct: bottom in, top out, plus right-wall rear slots at the island band
    for (x = S_vx) for (y = [-1, H-wall-1]) translate([x-vslot_w/2, y, vslot_z[0]]) cube([vslot_w, wall+2, vslot_z[1]-vslot_z[0]]);
    for (y = S_sy) translate([W-wall-1, y-vslot_w/2, vslot_z[0]]) cube([wall+2, vslot_w, Z_pcb_b-1-vslot_z[0]]);
    // snap windows matching backplate bumps
    for(x=[W/2-35,W/2+35]) for(y=[-1,H-wall-1]) translate([x-5.5,y,3.2-1.0]) cube([11,wall+2,2.0]);
    // inlay pockets (filled by black text / orange cat bodies)
    if(pk) translate([0,0,Z_out-inlay_d]) linear_extrude(inlay_d+1) { marks2d(); cat_place2d(); swirls2d(); }
    // LED light pipe bore (filled by pink body)
    translate([cx(led[0]),cy(led[1]),Z_in-2]) cylinder(d=2.0,h=10);
  }
}
module shell(pk=true){ union(){ shell_plain(pk); sh_added(); } }

// ---------------- multi-colour bodies ----------------
pv_e = 0.01;   // preview-only: inlays grow 0.01 mm (up + sideways) to avoid z-fighting; STL exports use 0
module marks2d(){
  if(show_title) translate([cx(aa[0]),cy(aa[1])+3.0]) text("Connie's Thermostat",size=3.2,font="Liberation Sans:style=Bold");
  for(i=[0:2]) translate([cx(btn[i][0])-6.2,cy(btn[i][1])]) text(["+","\u2212","M"][i],size=3.6,halign="center",valign="center",font="Liberation Sans:style=Bold");
}
module cat_place2d(){ translate(cat_xy) scale(cat_s) cat2d(); }
// keep-out zones on the front face (2D, case XY)
module face_keepout2d(){
  offset(swirl_margin){
    translate([cx(aa[0])-win_m-1.6, cy(aa[3])-win_m-1.6]) square([aa[2]-aa[0]+2*win_m+3.2, aa[3]-aa[1]+2*win_m+3.2]);  // window incl. chamfer
    for(b=btn) translate([cx(b[0]),cy(b[1])]) circle(d=5.0);
    for(p=pin) translate([cx(p[0]),cy(p[1])]) circle(d=1.6);
    translate([cx(led[0]),cy(led[1])]) circle(d=2.0);
    marks2d(); cat_place2d();
    translate([cx(island[0]+1.5)-1,cy((island[1]+island[3])/2)-6.5]) square([2.75*4+3.6,13]);   // front vents
  }
}
module swirls2d(){
  if(swirl_style!="none") difference(){
    intersection(){ swirl_lines(swirl_style,swirl_w); translate([3,2.5]) square([W-6,H-5]); }
    face_keepout2d();
  }
}
module inlay_pink(e=0){ translate([0,0,Z_out-inlay_d]) linear_extrude(inlay_d+e) offset(delta=e) swirls2d(); }
module inlay_black(e=0){ translate([0,0,Z_out-inlay_d]) linear_extrude(inlay_d+e) offset(delta=e) marks2d(); }
module inlay_orange(e=0){ translate([0,0,Z_out-inlay_d]) linear_extrude(inlay_d+e) offset(delta=e) cat_place2d(); }
module light_pipe(){ translate([cx(led[0]),cy(led[1]),Z_pcb_t+1.0]) cylinder(d=1.95,h=Z_out-Z_pcb_t-1.0); }

// ---------------- buttons ----------------
// TS-1187A-B-A-B. Height code A is 1.5±0.05 mm. The drawing says TRAVEL 0.2±0.1 mm;
// the spec table says 0.25 mm. Force code B is 160 gf. Actuator Ø2.0, body 5.1 square, cover 1.2.
// The stem is Ø1.6 and meets the actuator only. A 65° cone seats in the Ø5 hole, so the cap cannot
// leave through the face. One straight leaf on the partition side carries the catch. The leaf is a
// vertical wall, 0.40 mm thick and 4.50 mm long, so a 0.30 mm bend to pass the lip is under 1% strain.
// Print head-down. The cone, the barb underside, and the root rib are 65° from horizontal. The leaf
// is anchored only at that rib: it is a cantilever, not a bridge between two walls. The print pose
// adds a breakaway tie from the cone up to the free end, so the leaf bottom spans rib to tie and
// the slicer can treat it as a bridge. Snap the tie off before the cap goes into the tube.
// pull is unused. The seated mesh has no tie.
sw_h = 1.50;
sw_top = Z_pcb_t + sw_h;
btn_proud = 0.80;
btn_head_d = 4.70;
btn_hole_d = 5.00;
btn_gap = 0.63;                  // seated stem to the actuator on a nominal board
btn_travel = 1.50;               // cone on the hole, to the catch face on the lip
btn_stem_d = 1.60;
btn_cone_d = 6.00;
btn_cone_ang = 65;               // from horizontal. Steeper than a 60° support threshold.
btn_tube_od = 8.60;
btn_tube_z0 = Z_pcb_t + 0.80;    // wall comes down beside the switch body (half-width 2.55 < bore r 3.85)
btn_bore_d = 7.70;               // r 3.85, 0.45 mm wall inside the Ø8.6 tube
btn_lip_d = 6.30;                // r 3.15
btn_flare = 0;                   // no separate print pose; the leaf is not pre-bent
btn_tip_z = Z_out + btn_proud;
btn_stem_z = sw_top + btn_gap;
btn_shelf_z = Z_pcb_t + 1.90;    // lip face the catch reaches after btn_travel. 20.5 at the nominal stack.
leaf_t = 0.40;
leaf_L = 4.50;                   // wall length. The stem rib clamps the first leaf_root of it.
leaf_root = 0.15;
leaf_defl = 0.30;                // tip moves this far in x to clear the lip
leaf_free = leaf_L - leaf_root;
leaf_eps = 1.5 * leaf_t * leaf_defl / (leaf_free * leaf_free);
echo(str("BTN gap=", btn_gap, " travel=", btn_travel, " stroke=", btn_travel - btn_gap, " leaf_strain=", leaf_eps));
assert(btn_gap >= 0.60 && btn_gap <= 0.70, "button gap is outside 0.60..0.70");
assert(btn_travel >= 1.45 && btn_travel <= 1.55, "button travel is outside 1.45..1.55");
assert(leaf_free >= 4.0, "button leaf is shorter than 4 mm");
assert(leaf_eps < 0.020, "button leaf strain is past the PETG limit");

function zl(zw) = btn_tip_z - zw;

// Straight vertical wall, 0.40 mm in x. Root at the -y end. The rib is a 65° web from the
// stem to that root and stays inside the lip, so only the barb crosses the lip. The barb
// underside is the same 65°. tie adds a nub under the free end for the print only.
module btn_catch(tie=false) {
  x_in = 1.65;
  x_out = x_in + leaf_t;
  y0 = -2.25;
  y1 = y0 + leaf_L;
  z_face = zl(btn_shelf_z + btn_travel);   // board face of the catch. Pressed, this lands on the lip.
  z_bot = z_face - 1.05;                   // above the neck collar, so the collar does not brace the leaf
  translate([x_in, y0, z_bot]) cube([leaf_t, leaf_L, z_face - z_bot]);
  x_root = x_in + leaf_t/2;
  y_root = y0 + leaf_root/2;
  // Outer corner of the root. The rib's shallowest face is the line from that
  // corner down to a pad inside the head, at 72° from horizontal, so a 60°
  // support threshold does not touch it.
  r_out = sqrt(x_out*x_out + y0*y0);
  rib_ang = 72;
  run = z_bot / tan(rib_ang);
  ux = x_root / sqrt(x_root*x_root + y_root*y_root);
  uy = y_root / sqrt(x_root*x_root + y_root*y_root);
  // Pad far enough in that the outer corner, not the centre, is the 72° edge.
  inset = run + (r_out - sqrt(x_root*x_root + y_root*y_root));
  hull() {
    translate([x_root - ux*inset, y_root - uy*inset, 0.15]) cube([0.40, 0.40, 0.30], center=true);
    translate([x_in, y0, z_bot]) cube([leaf_t, leaf_root, z_face - z_bot]);
  }
  x_tip = 2.50;                            // 0.30 mm past the lip's x at y = y1
  dz = (x_tip - x_out) * tan(btn_cone_ang);
  yb = y1 - 0.35;
  translate([0, y1, 0]) rotate([90, 0, 0]) linear_extrude(y1 - yb) polygon([
    [x_out, z_bot],
    [x_out, z_face],
    [x_tip, z_face],
    [x_out, z_face - dz]
  ]);
  // Print tie. The block is buried in the head and the cone. Above the cone's
  // wide end it stands 0.34 mm and overlaps the leaf by 0.06 mm, so the leaf
  // bottom bridges from the root rib onto that nub. One corner of the block
  // also meets the bed outside the head. Snap off the part that stands outside
  // the cone before the cap goes into the tube.
  if (tie)
    translate([x_in - 0.10, y1 - 0.90, 0]) cube([leaf_t + 0.20, 1.05, z_bot + 0.06]);
}

module cap(pull=0, drop=0, tie=false) {
  // 65° from horizontal, so the cone reaches the Ø5 hole's inner corner.
  cone_seat = (btn_hole_d - btn_head_d)/2 * tan(btn_cone_ang);
  cone0 = zl(Z_in + cone_seat);
  cone_h = (btn_cone_d - btn_head_d)/2 * tan(btn_cone_ang);
  cylinder(d=btn_head_d, h=cone0);
  translate([0, 0, cone0]) cylinder(d1=btn_head_d, d2=btn_cone_d, h=cone_h);
  // Collar stays clear of the leaf. The leaf is not fused to it.
  translate([0, 0, cone0 + cone_h - 0.40]) cylinder(d=4.4, h=0.20);
  translate([0, 0, cone0 + cone_h - 0.02]) cylinder(d=btn_stem_d, h=zl(btn_stem_z) - (cone0 + cone_h - 0.02));
  btn_catch(tie);
}

// drop>0 is a press: the body moves toward the board until the catch face meets the lip.
module cap_placed(pull=0, drop=0) {
  for (b = btn)
    translate([cx(b[0]), cy(b[1]), btn_tip_z - drop])
      rotate([180, 0, 0])
        cap(pull, drop);
}

// Face hole, upper bore, lip, and the lead-in from the tube mouth. The FPC pocket
// cuts the panel side of the bore. The catch sits on the partition side, where the lip remains.
// The annulus the catch lands on runs from r 3.15 out to r 3.75 (lip + 1.2 mm).
module button_void() {
  neck_h = 0.35;
  lead_h = 0.45;
  ramp_h = 0.55;
  lip_open = btn_lip_d + 1.20;     // r 3.75 at the shelf, so the  r~3.36 catch has a face to hit
  for (b = btn) translate([cx(b[0]), cy(b[1]), 0]) {
    translate([0, 0, Z_in - 0.01]) cylinder(d=btn_hole_d, h=Z_out - Z_in + 2);
    translate([0, 0, btn_shelf_z + ramp_h]) cylinder(d=btn_bore_d, h=Z_in - btn_shelf_z - ramp_h + 0.02);
    translate([0, 0, btn_shelf_z]) cylinder(d1=lip_open, d2=btn_bore_d, h=ramp_h);
    translate([0, 0, btn_shelf_z - neck_h]) cylinder(d=btn_lip_d, h=neck_h);
    translate([0, 0, btn_shelf_z - neck_h - lead_h]) cylinder(d1=btn_bore_d, d2=btn_lip_d, h=lead_h);
    translate([0, 0, btn_tube_z0 - 0.02]) cylinder(d=btn_bore_d, h=btn_shelf_z - neck_h - lead_h - btn_tube_z0 + 0.06);
  }
}

// ---------------- panel carrier ----------------
// One PETG piece. Feet on the PCB. The display panel rests on the pads at panel_gap.
// Fences stand beside the long edges and stop short of the face. They do not hook the panel.
// dir = +1 is the small-y side of the edge (the top of the panel). depth runs inboard.
module support_pad(x0, x1, edge, dir, depth) {
  y_far = edge + dir * depth;
  board_box(x0, min(edge, y_far), x1, max(edge, y_far), Z_pcb_t, Z_panel_b);
}
// Wall beside a long edge. The low tie crosses under the outline so the fence and the pad
// are one solid. The tie stays below the panel, and the fence does not cross the face.
module edge_fence(x0, x1, edge, dir) {
  z0 = Z_pcb_t;
  z_fence = Z_in - 0.40;                 // 0.40 mm under the shell face; a thick board still leaves air
  y_in = edge - dir * fence_air;         // face toward the panel
  y_out = y_in - dir * fence_t;
  board_box(x0, min(y_in, y_out), x1, max(y_in, y_out), z0, z_fence);
  board_box(x0, min(y_in, edge + dir * 0.40), x1, max(y_in, edge + dir * 0.40), z0, z0 + 1.50);
}
// Printed push. A finger on the -x face drives the shoe toward +x into the high
// ear rear. The display panel stays on the pads. The beam is left of the airflow
// partition and above the USB-C body. The rod runs past the MODE tube.
module slider_push() {
  z_lo = Z_pcb_t + push_z0;
  z_hi = Z_pcb_t + push_z1;
  x1 = push_face_x + push_t;
  board_box(push_face_x, push_face_y0, x1, push_face_y1, z_lo, z_hi);
  board_box(push_face_x, push_root_y, x1, 63.90, Z_pcb_t, z_hi);
  board_box(108.70, 60.70, x1, 63.40, Z_pcb_t + 1.70, Z_pcb_t + 3.20);
  board_box(push_face_x, 54.80, x1, 55.60, Z_pcb_t + 1.20, z_hi);
  // The rod stands on a spine to the bed. The shoe bridges the last few millimetres.
  board_box(shoe_x0, 54.80, x1, 55.60, Z_pcb_t, Z_pcb_t + 1.55);
  board_box(shoe_x0, shoe_y0, shoe_x1, 55.60, Z_pcb_t + shoe_z0, Z_pcb_t + shoe_z1);
}
// Posts on the cable side of the panel. +x is the slide that shortens the tail in J4.
// Each post bites xstop_bite onto the outline and stands in the shell's FPC pocket.
// The bands miss the button tubes (they meet the edge near y 30, 40, and 50) and
// the bend bulge (y 37.75–50.25). -x lengthens the inserted tail. The seated tail
// is already against the mouth, so that direction does not unload the connector.
// The front curtain is 0.46 mm from this edge and is clearance, not a stop.
module panel_xstops() {
  z1 = Z_in - 0.45;   // 0.45 mm under the inner face, so a +0.16 mm board still leaves >0.15 mm
  board_box(82.0, 33.20, panel[2], 34.30, Z_pcb_t, Z_panel_b);
  board_box(panel[2] - xstop_bite, 33.20, panel[2] + 0.80, 34.30, Z_panel_b - 0.40, z1);
  board_box(76.0, 61.20, panel[2], 62.50, Z_pcb_t, Z_panel_b);
  board_box(panel[2] - xstop_bite, 60.40, panel[2] + 0.80, 61.70, Z_panel_b - 0.40, z1);
  // The post footprint continues down to the carrier bottom, so that lip is a column.
  board_box(panel[2], 33.20, panel[2] + 0.80, 34.30, Z_pcb_t, Z_panel_b);
  board_box(panel[2], 60.40, panel[2] + 0.80, 61.70, Z_pcb_t, Z_panel_b);
  // Insertion-depth mark. Each fin starts just outboard of the seated edge,
  // overlaps the post, and runs toward the cable, so the edge lines up with
  // the fin when the tail is home. The fin does not cross the face and does not add bite.
  board_box(panel[2] + 0.05, 32.75, panel[2] + 0.75, 33.25, Z_panel_b + 0.20, Z_panel_b + 0.70);
  board_box(panel[2] + 0.05, 59.70, panel[2] + 0.75, 60.45, Z_panel_b + 0.20, Z_panel_b + 0.70);
}
module carrier() {
  difference() {
  union() {
  z0 = Z_pcb_t;
  // left edge fence, 0.25 mm off the board, tied to the spine so the nozzle keeps the gap
  board_box(-0.80, 42.0, -0.25, 60.0, z0, z0 + 1.15);
  board_box(0.40, 40.0, 1.80, 63.55, z0, z0 + 1.20);
  for (y = [44.0, 51.0, 57.2])
    board_box(-0.80, y, 1.70, y + 1.8, z0 + 0.55, z0 + 1.15);
  // bottom rail. The middle span is the curtain crossing, held to 1.00 mm.
  // One solid from the curtain to the right column. No hook notches.
  board_box(0.35, 63.15, 27.25, 63.60, z0, z0 + 1.50);
  board_box(27.15, 63.15, 29.55, 63.60, z0, z0 + 1.00);
  board_box(29.45, 63.15, 97.0, 63.60, z0, z0 + 1.50);
  board_box(36.0, 64.22, 96.0, 64.78, z0, z0 + 1.15);
  for (x = [40.0, 62.0, 88.0])
    board_box(x, 63.40, x + 2.2, 64.78, z0 + 0.55, z0 + 1.15);
  // spine down to the jog, then east of C42, then between the C43 leads
  board_box(49.00, 27.50, 51.40, 50.50, z0, z0 + 1.50);
  board_box(48.95, 49.50, 54.70, 52.50, z0, z0 + 1.50);
  board_box(52.20, 49.90, 54.60, 56.80, z0, z0 + 1.50);
  board_box(52.85, 56.60, 53.70, 59.40, z0, z0 + 1.50);
  board_box(49.55, 59.15, 55.65, 62.90, z0, z0 + 1.50);
  // right column, passing to the right of J1 pin 5, up under the panel edge
  board_box(76.00, 27.60, 82.00, 56.55, z0, z0 + 1.50);
  board_box(78.55, 56.35, 79.90, 59.50, z0, z0 + 1.50);
  board_box(75.95, 59.25, 82.05, 62.90, z0, z0 + 1.50);
  support_pad(47.0, 53.0, panel[1], +1, 1.65);
  support_pad(76.0, 90.6, panel[1], +1, 1.65);
  support_pad(49.6, 55.6, panel[3], -1, 1.65);
  support_pad(76.0, 82.0, panel[3], -1, 1.65);
  // Top fences sit clear of U7 (x to 40.2) and of the ESP32 module (x 66–84, y to 25.5).
  edge_fence(42.0, 53.0, panel[1], +1);
  edge_fence(84.6, 96.0, panel[1], +1);
  edge_fence(49.6, 55.6, panel[3], -1);
  edge_fence(76.0, 90.0, panel[3], -1);
  for (c = sh_columns)
    board_box(c[0], c[1], c[2], c[3], Z_pcb_t, sh_stop);
  for (c = sh_ties)
    board_box(c[0], c[1], c[2], c[3], Z_pcb_t, Z_pcb_t + sh_tie_h);
  panel_xstops();
  slider_push();
  }
  // Rest surfaces under the outline, brought to the stop. Fences stand outboard of this cut.
  board_box(panel[0] - 0.02, panel[1] - 0.05, panel[2] + 0.02, panel[3] + 0.05,
            sh_stop, Z_panel_b + 0.25);
  }
}
module fpc() {
  zc = Z_pcb_t + fpc_z_ret + fpc_R;
  y0 = 44 - fpc_wide/2;
  y1 = 44 + fpc_wide/2;
  x_end = mouth_x - fpc_ins;
  color("goldenrod") {
    board_box(x_end, y0, panel[2], y1, Z_pcb_t + fpc_z_ret - fpc_thick/2, Z_pcb_t + fpc_z_ret + fpc_thick/2);
    // semicircle bulging to +x. rotate(-90) about X sends local +Z to case +Y and local +Y to case -Z,
    // so the circle centre is placed at local y = -zc.
    translate([0, cy(y1), 0]) rotate([-90, 0, 0]) linear_extrude(fpc_wide)
      translate([cx(panel[2]), -zc]) difference() {
        circle(r = fpc_R + fpc_thick/2);
        circle(r = max(fpc_R - fpc_thick/2, 0.2));
        translate([-fpc_R - 2, -(fpc_R + 1)]) square([fpc_R + 2, 2*fpc_R + 2]);
      }
  }
}

// ---------------- reference geometry (for renders) ----------------
module pcb(){ color("darkgreen") translate([OX,cy(BH),Z_pcb_b]) difference(){ cube([BW,BH,pcb_t]); for(h=holes) translate([h[0],BH-h[1],-1]) cylinder(d=4.3,h=5);} 
  color("silver") translate([cx(66),cy(25.5),Z_pcb_t]) cube([18,25.5,3.1]);                 // ESP32-C6
  color("black") for(b=btn) translate([cx(b[0])-3,cy(b[1])-3,Z_pcb_t]) cube([6,6,1.5]);
  color("green") translate([cx(term[0])-9.15,cy(term[1])-1.2,Z_pcb_b-7.6]) cube([18.3,9.2,7.6]);           // rear RA header 15EDGRC
  color("limegreen") translate([cx(term[0])-plug_w/2,cy(plug_y1),Z_pcb_b-plug_h]) cube([plug_w,plug_y1-plug_y0,plug_h]);      // 15EDGK plug (wire entry faces the hole)
  color("darkred") for(i=[0:4]) hull(){ translate([cx(term[0])-7+i*3.5,cy(plug_y0)+3,Z_pcb_b-5.5]) sphere(d=1.2); translate([W/2-8+i*4,H/2,-2]) sphere(d=1.2);} // wires
  color("gray") translate([cx(usb_x)-4.5,cy(BH),Z_pcb_t]) cube([9,7.3,3.2]);                    // USB-C flush with board edge
  color("black") translate([cx(j4_front - j4_depth), cy(j4_y1), Z_pcb_t])
    cube([j4_depth, j4_y1 - j4_y0, j4_h]);      // J4 housing body, y 36–52, +x face at j4_front
  color("royalblue") translate([cx(bulk[0]),cy(bulk[1]),Z_pcb_b-bulk_h]) cylinder(d=8,h=bulk_h);       // C43 47uF/63V THT, back side
  color("orange") translate([cx(127),cy(32.7),Z_pcb_t]) cube([1.5,1.5,0.5]);                 // SHT40
}
module epd(){ color("white") translate([cx(panel[0]),cy(panel[3]),Z_panel_b]) cube([panel[2]-panel[0],panel[3]-panel[1],panel_t]);
  color([0.2,0.2,0.2]) translate([cx(aa[0]),cy(aa[3]),Z_in-0.05]) cube([aa[2]-aa[0],aa[3]-aa[1],0.1]); }

module flipP(){ translate([0,H,Z_out]) rotate([180,0,0]) children(); }
if(part=="backplate") backplate();
else if(part=="shell_white") flipP() shell();
else if(part=="shell_black") flipP() inlay_black();
else if(part=="shell_orange") flipP() inlay_orange();
else if(part=="shell_pink") flipP() { light_pipe(); inlay_pink(); }
else if(part=="shell") translate([0,H,Z_out]) rotate([180,0,0]) shell();   // print face-down
else if(part=="carrier") carrier();
else if(part=="sh_beams") sh_beams();
else if(part=="sh_pillars") sh_pillar_all();
else if(part=="sh_locs") sh_loc_all();
else if(part=="sh_carrier") carrier();
else if(part=="sh_stock") shell_plain();
else if(part=="sh_shell") shell();
else if(part=="sh_shell_print") translate([0,H,Z_out]) rotate([180,0,0]) shell();
else if(part=="sh_carrier_print") translate([0,0,-Z_pcb_t]) carrier();
else if(part=="sh_stock_print") translate([0,H,Z_out]) rotate([180,0,0]) shell_plain();
else if(part=="caps") for(i=[0:2]) translate([i*14,0,0]) cap(0, 0, true);
else if(part=="assembly"){ color("lightgray") backplate(); pcb(); color("wheat") carrier(); epd(); fpc(); color("white") shell(false); color("black") inlay_black(pv_e); color("orange") inlay_orange(pv_e); color("hotpink") light_pipe(); color("hotpink") inlay_pink(pv_e); color("orange") cap_placed(btn_flare); }
else if(part=="exploded"){ color("lightgray") backplate(); translate([0,0,22]){ pcb(); color("wheat") carrier(); epd(); fpc(); } translate([0,0,64]){ color("white") shell(false); color("black") inlay_black(pv_e); color("orange") inlay_orange(pv_e); color("hotpink") light_pipe(); color("hotpink") inlay_pink(pv_e); color("orange") cap_placed(btn_flare); } }
else if(part=="section") difference(){ union(){ color("lightgray") backplate(); pcb(); color("wheat") carrier(); epd(); fpc(); color("white") shell(false); color("black") inlay_black(pv_e); color("orange") inlay_orange(pv_e); color("hotpink") light_pipe(); color("hotpink") inlay_pink(pv_e); color("orange") cap_placed(btn_flare); }
  translate([-1,-1,-30]) cube([W+2, cy(40), 80]); }   // cut through the DOWN button centre (board y=40), the panel, and the FPC
else if(part=="section_j1") difference(){ union(){ color("lightgray") backplate(); pcb(); color("wheat") carrier(); epd(); color("white") shell(false); }
  translate([-1,-1,-30]) cube([W+2, cy(58)+1, 80]); }   // cut along the J1 pin row / C43 centre (board y=58)
else if(part=="section_j1x") difference(){ union(){ color("lightgray") backplate(); pcb(); color("wheat") carrier(); epd(); color("white") shell(false); }
  translate([cx(term[0]),-1,-30]) cube([W, H+2, 80]); }   // cut across J1 + plug + wire bend (board x=70)
else if(part=="section_airflow") difference(){ union(){ color("lightgray") backplate(); pcb(); color("wheat") carrier(); epd(); color("white") shell(false); color("black") inlay_black(pv_e); color("orange") inlay_orange(pv_e); color("hotpink") light_pipe(); color("hotpink") inlay_pink(pv_e); color("orange") cap_placed(btn_flare); }
  translate([-1, cy(32), -30]) cube([W+2, H, 80]); }   // cut at board y=32, through the SHT40 and both zone ribs
else if(part=="open"){ color("lightgray") backplate(); pcb(); color("wheat") carrier(); epd(); fpc(); }
else if(part=="section_bridge") rotate([-90,0,0]) difference(){ union(){ color("lightgray") backplate(); pcb(); color("wheat") carrier(); epd(); color("white") shell(false); }
  translate([-1,-1,-30]) cube([W+2, cy(28.96), 80]); }
else if(part=="section_pillar") rotate([0,90,0]) difference(){ union(){ color("lightgray") backplate(); pcb(); color("wheat") carrier(); epd(); color("white") shell(false); }
  translate([-30,-1,-30]) cube([cx(30.9)+30, H+2, 80]); }
else if(part=="section_u7") rotate([-90,0,0]) difference(){ union(){ color("lightgray") backplate(); pcb(); color("wheat") carrier(); epd(); color("white") shell(false); }
  translate([-1,-1,-30]) cube([W+2, cy(29.85), 80]); }
else if(part=="section_j4") rotate([-90,0,0]) difference(){ union(){ color("lightgray") backplate(); pcb(); color("wheat") carrier(); epd(); fpc(); color("white") shell(false); }
  translate([-1,-1,-30]) cube([W+2, cy(44), 80]); }
// rear clearance check: tallest rear parts must clear the backplate top (plate_t)
assert(Z_pcb_b-bulk_h>plate_t+1, "C43 hits backplate");
assert(Z_pcb_b-plug_h>plate_t-plug_pocket+1, "J1 plug hits backplate");
// all parts laid out for a 256x256 bed (Bambu P2S), print orientation, no supports
if(part=="plate"){
  translate([5,5,0]) translate([0,H,Z_out]) rotate([180,0,0]) shell();
  translate([5,H+12-(wall+clr),0]) backplate();
  for(i=[0:2]) translate([168+ (i*14), 22, 0]) cap(0, 0, true);
  translate([152, 168, -Z_pcb_t]) carrier();
}
