Connicpu/thermostat/scripts/case_fit_export.scad

include <thermostat_case.scad>
if(which=="b") backplate();
else if(which=="c") carrier();
else shell(false);
