Connicpu/thermostat/(list of files, cad)

Other CAD files:
docs/case-r7/shell.3mf
case/caps.stl
