Connicpu/thermostat/case/case-assembled-zoom.png

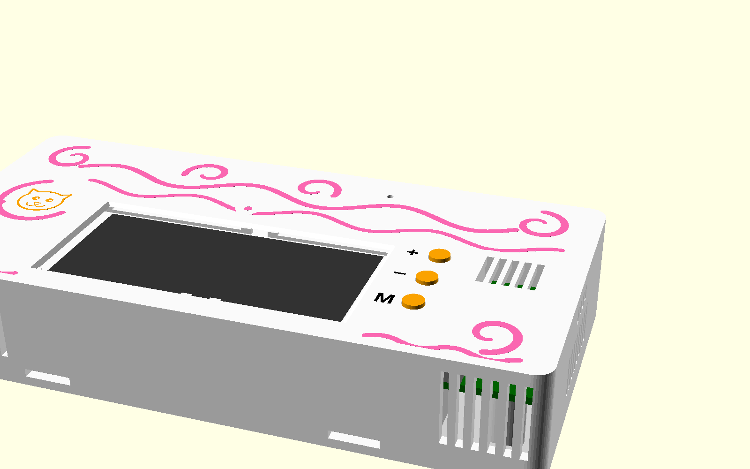
case/case-assembled-zoom.png
