Connicpu/thermostat/case/case-assembled.png

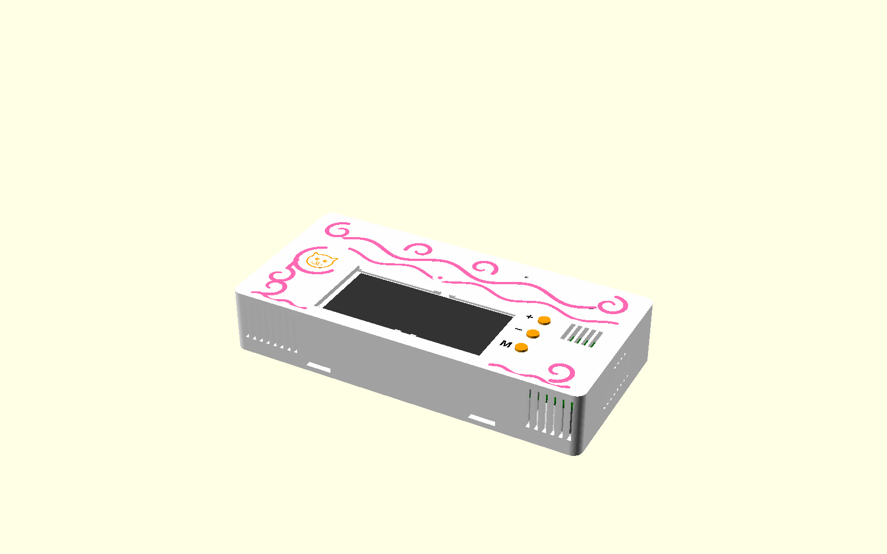
case/case-assembled.png
