Connicpu/thermostat/fab/thermostat-v3-schematic.pdf

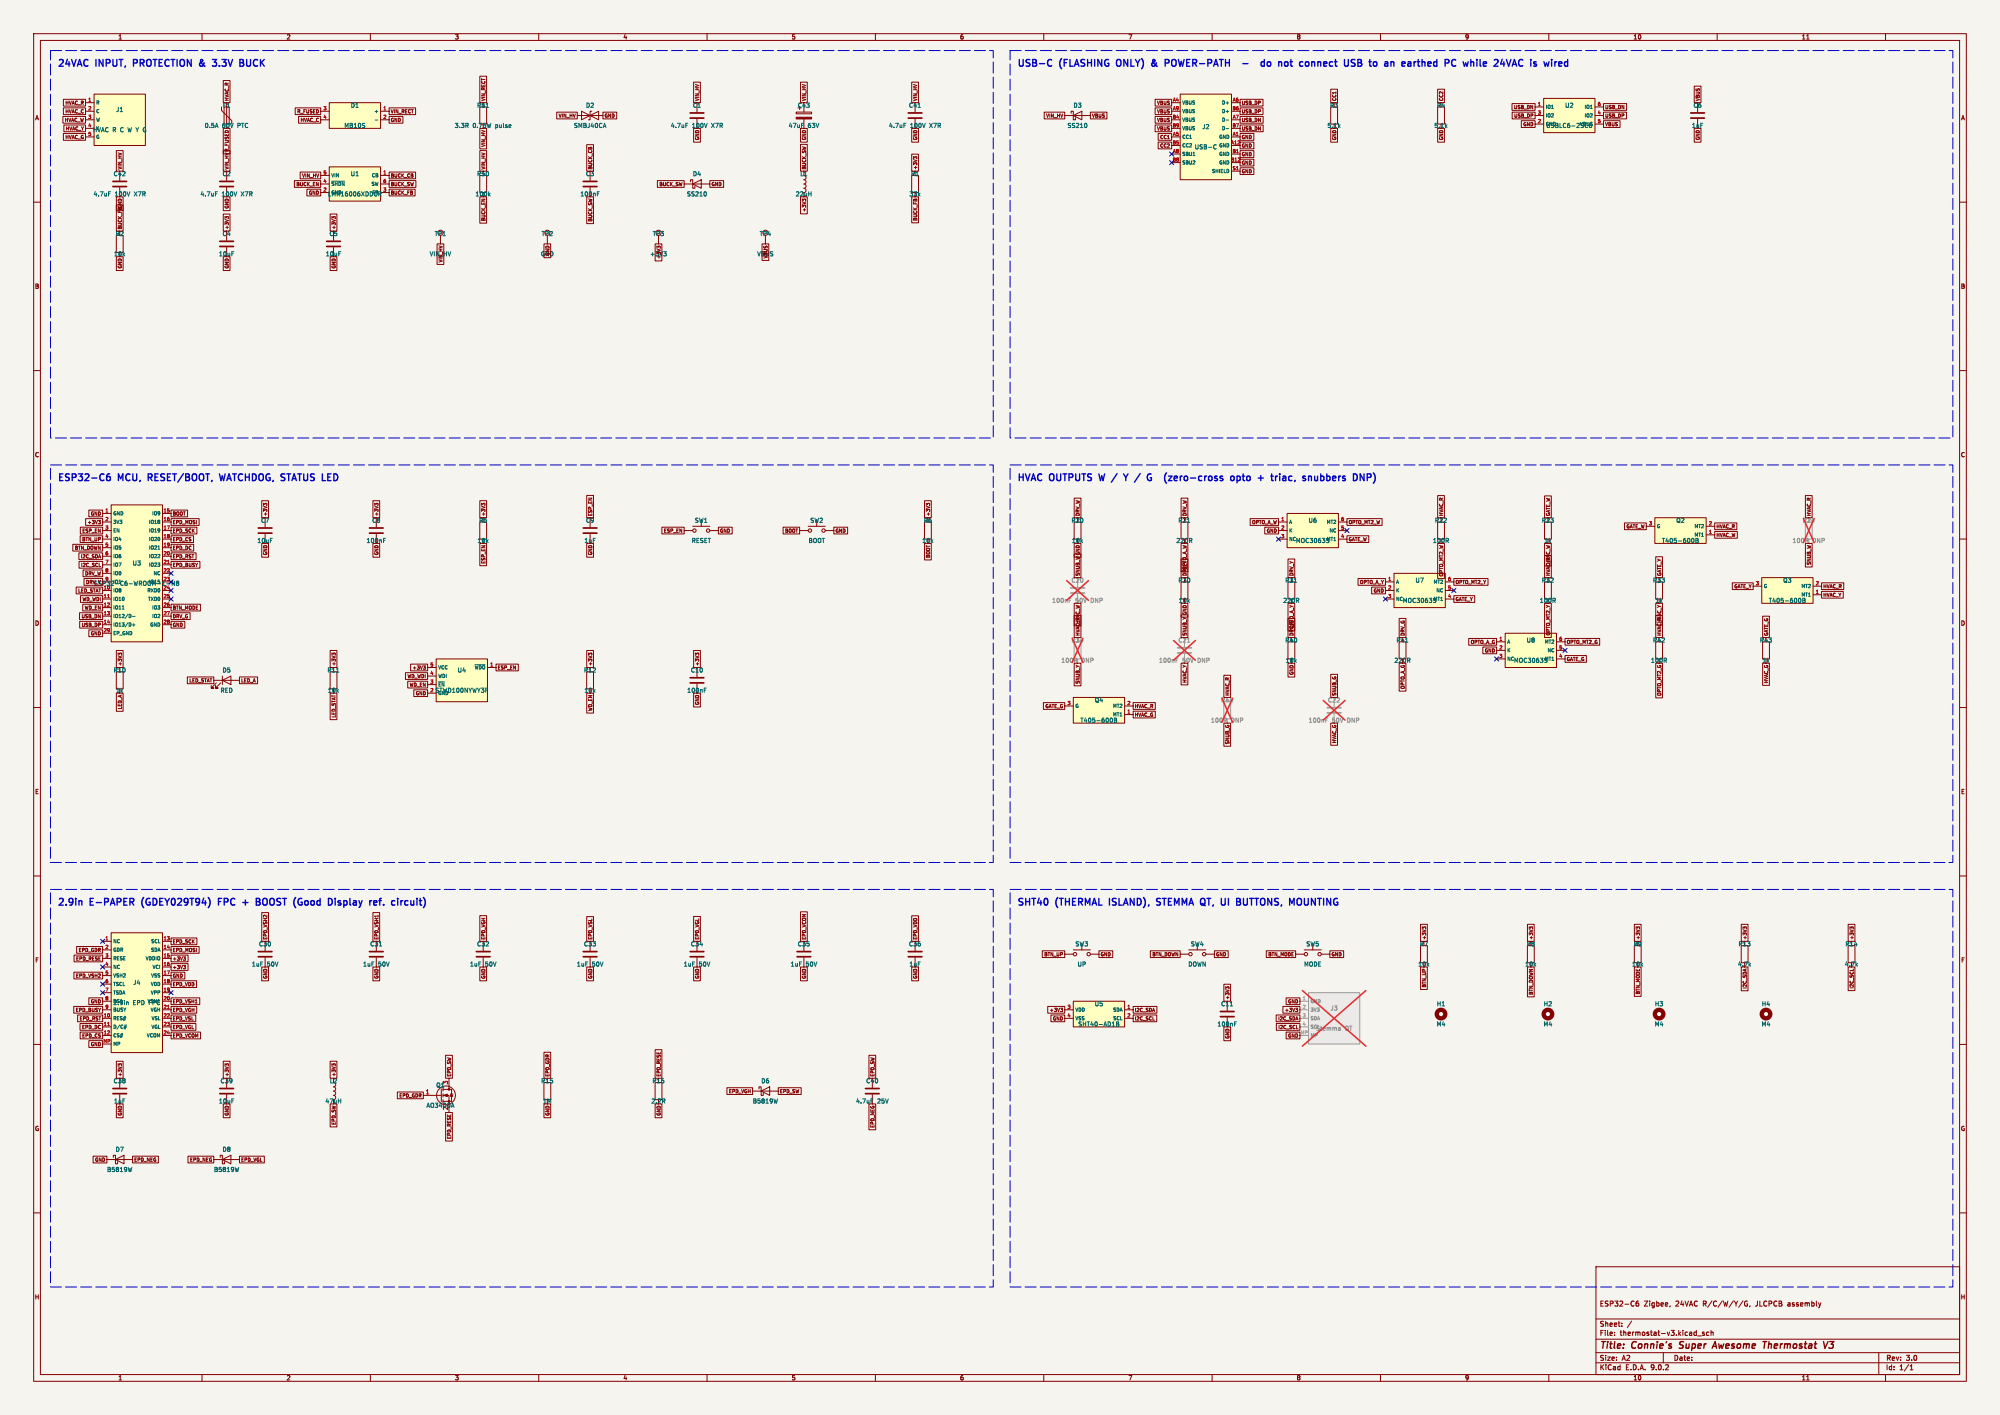
[picture p91: page 1]

NC 1 GDR 2 RESE 3 NC 4 VSH2 5 TSCL 6 TSDA 7 BS1 8 BUSY 9 RES# 10 D/C# 11 CS# 12 MP MP

SHT40 (THERMAL ISLAND), STEMMA QT, UI BUTTONS, MOUNTING

SCL 13 SDA 14 VDDIO 15 VCI 16 VSS 17 VDD 18 VPP 19 VSH1 20 VGH 21 VSL 22 VGL 23 VCOM 24 J4
