Connicpu/thermostat/fab/thermostat-v3-pcb-bottom.pdf

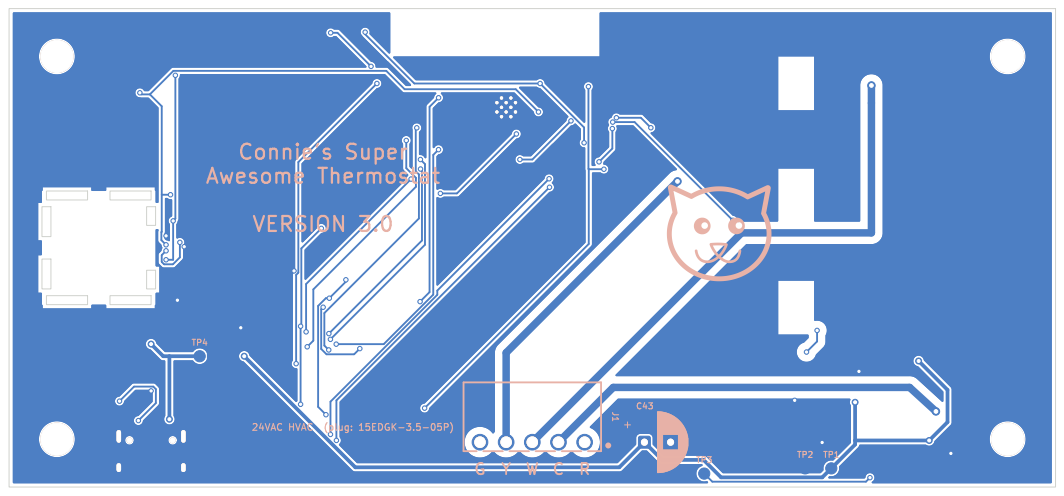
[picture p92: page 1]
