Connicpu/thermostat/fab/thermostat-v3-pcb-top.pdf

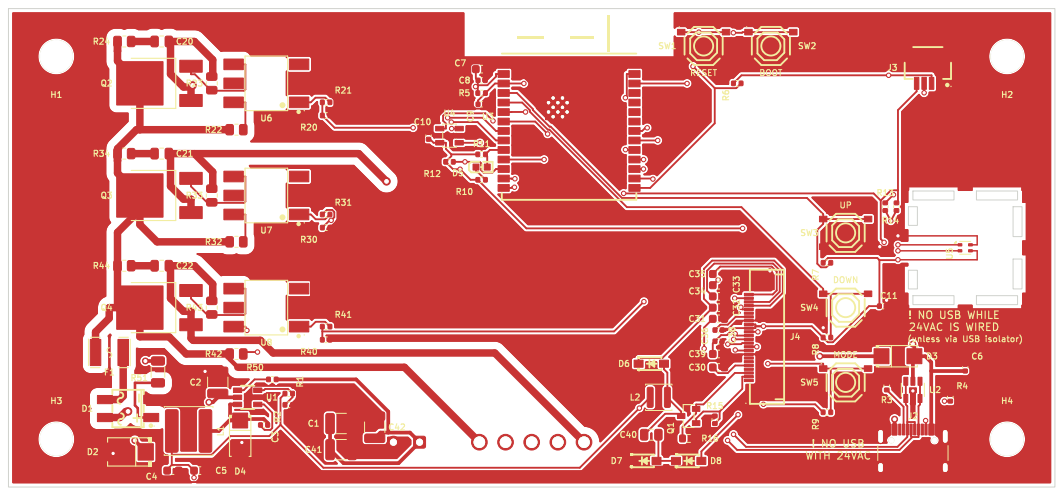
[picture p93: page 1]
