Connicpu/thermostat/kicad/thermostat-v3.kicad_pcb

## KiCad design kicad/thermostat-v3.kicad_pcb (2026-10-14)

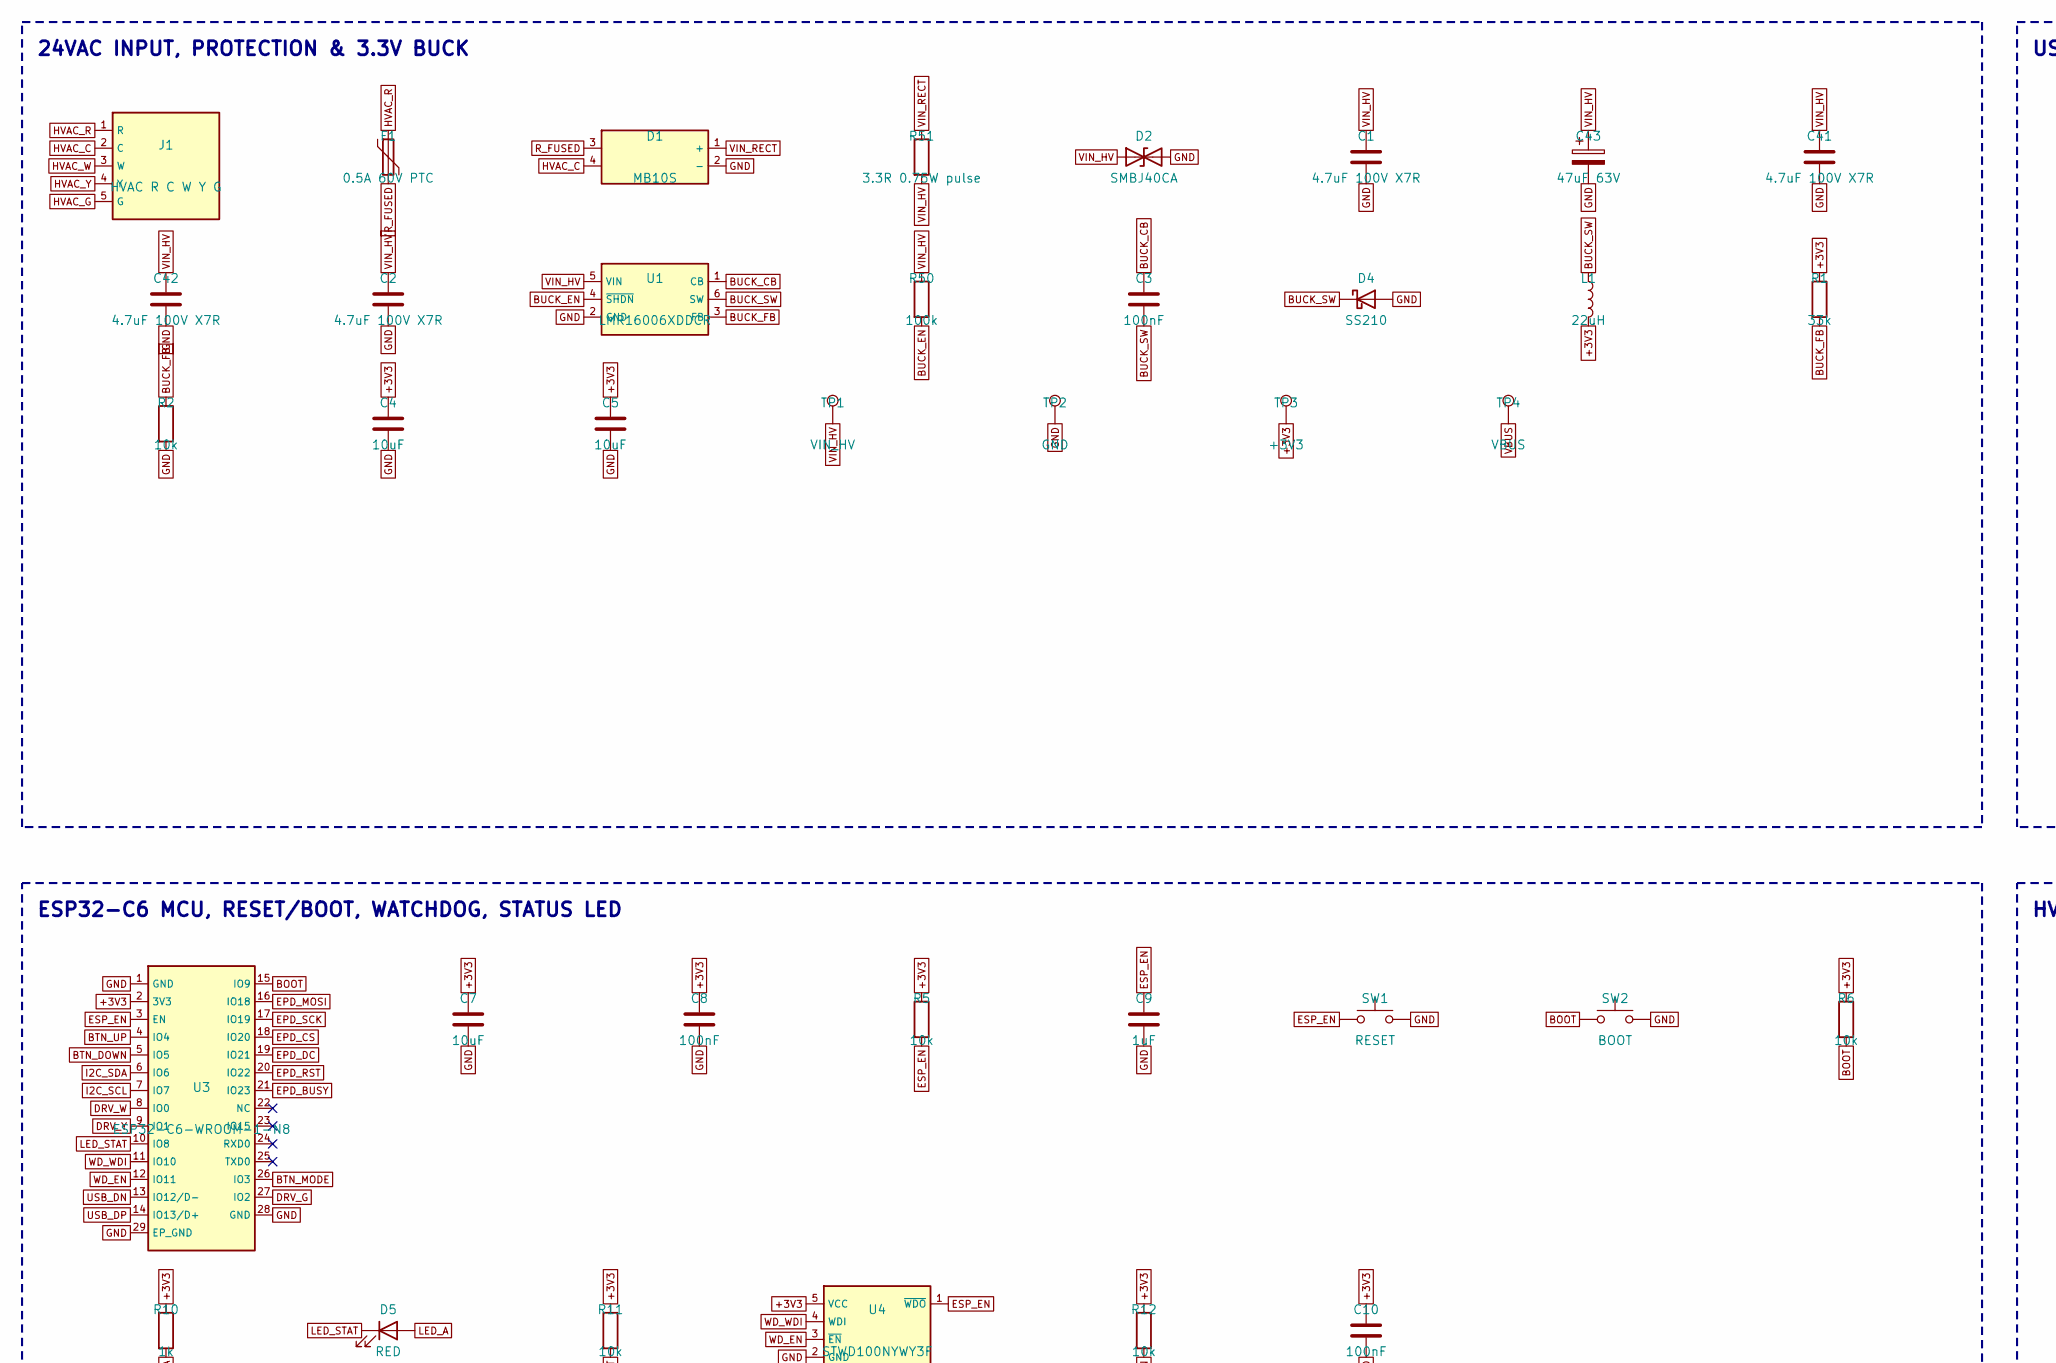
[picture p94: schematic thermostat-v3.kicad_sch, Connie's Super Awesome Thermostat V3, part in row 1, column 1]

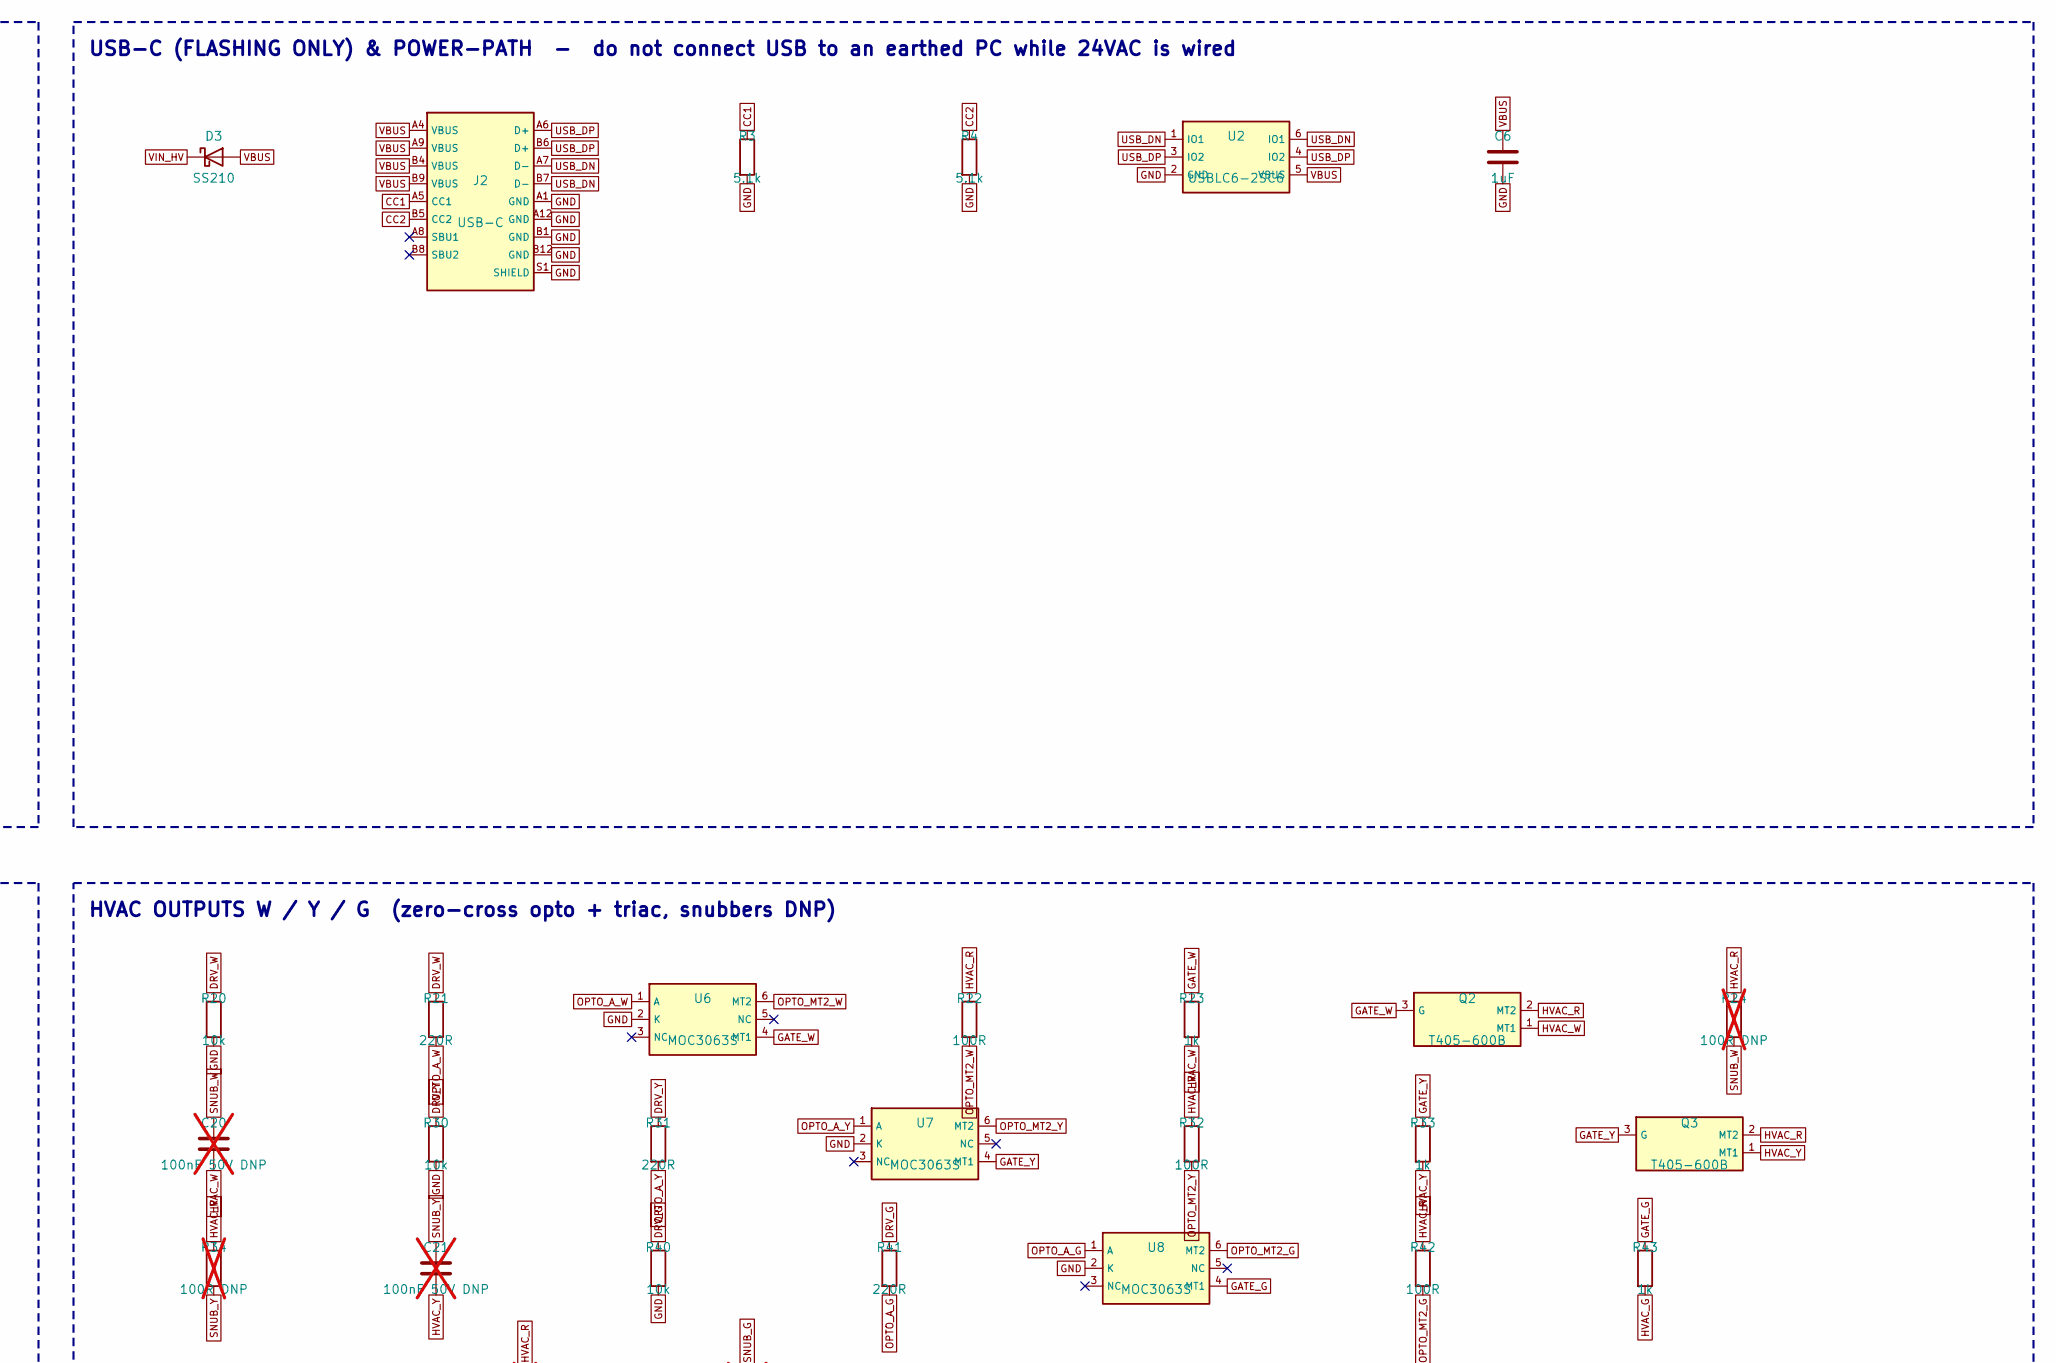
[picture p95: schematic thermostat-v3.kicad_sch, Connie's Super Awesome Thermostat V3, part in row 1, column 2]

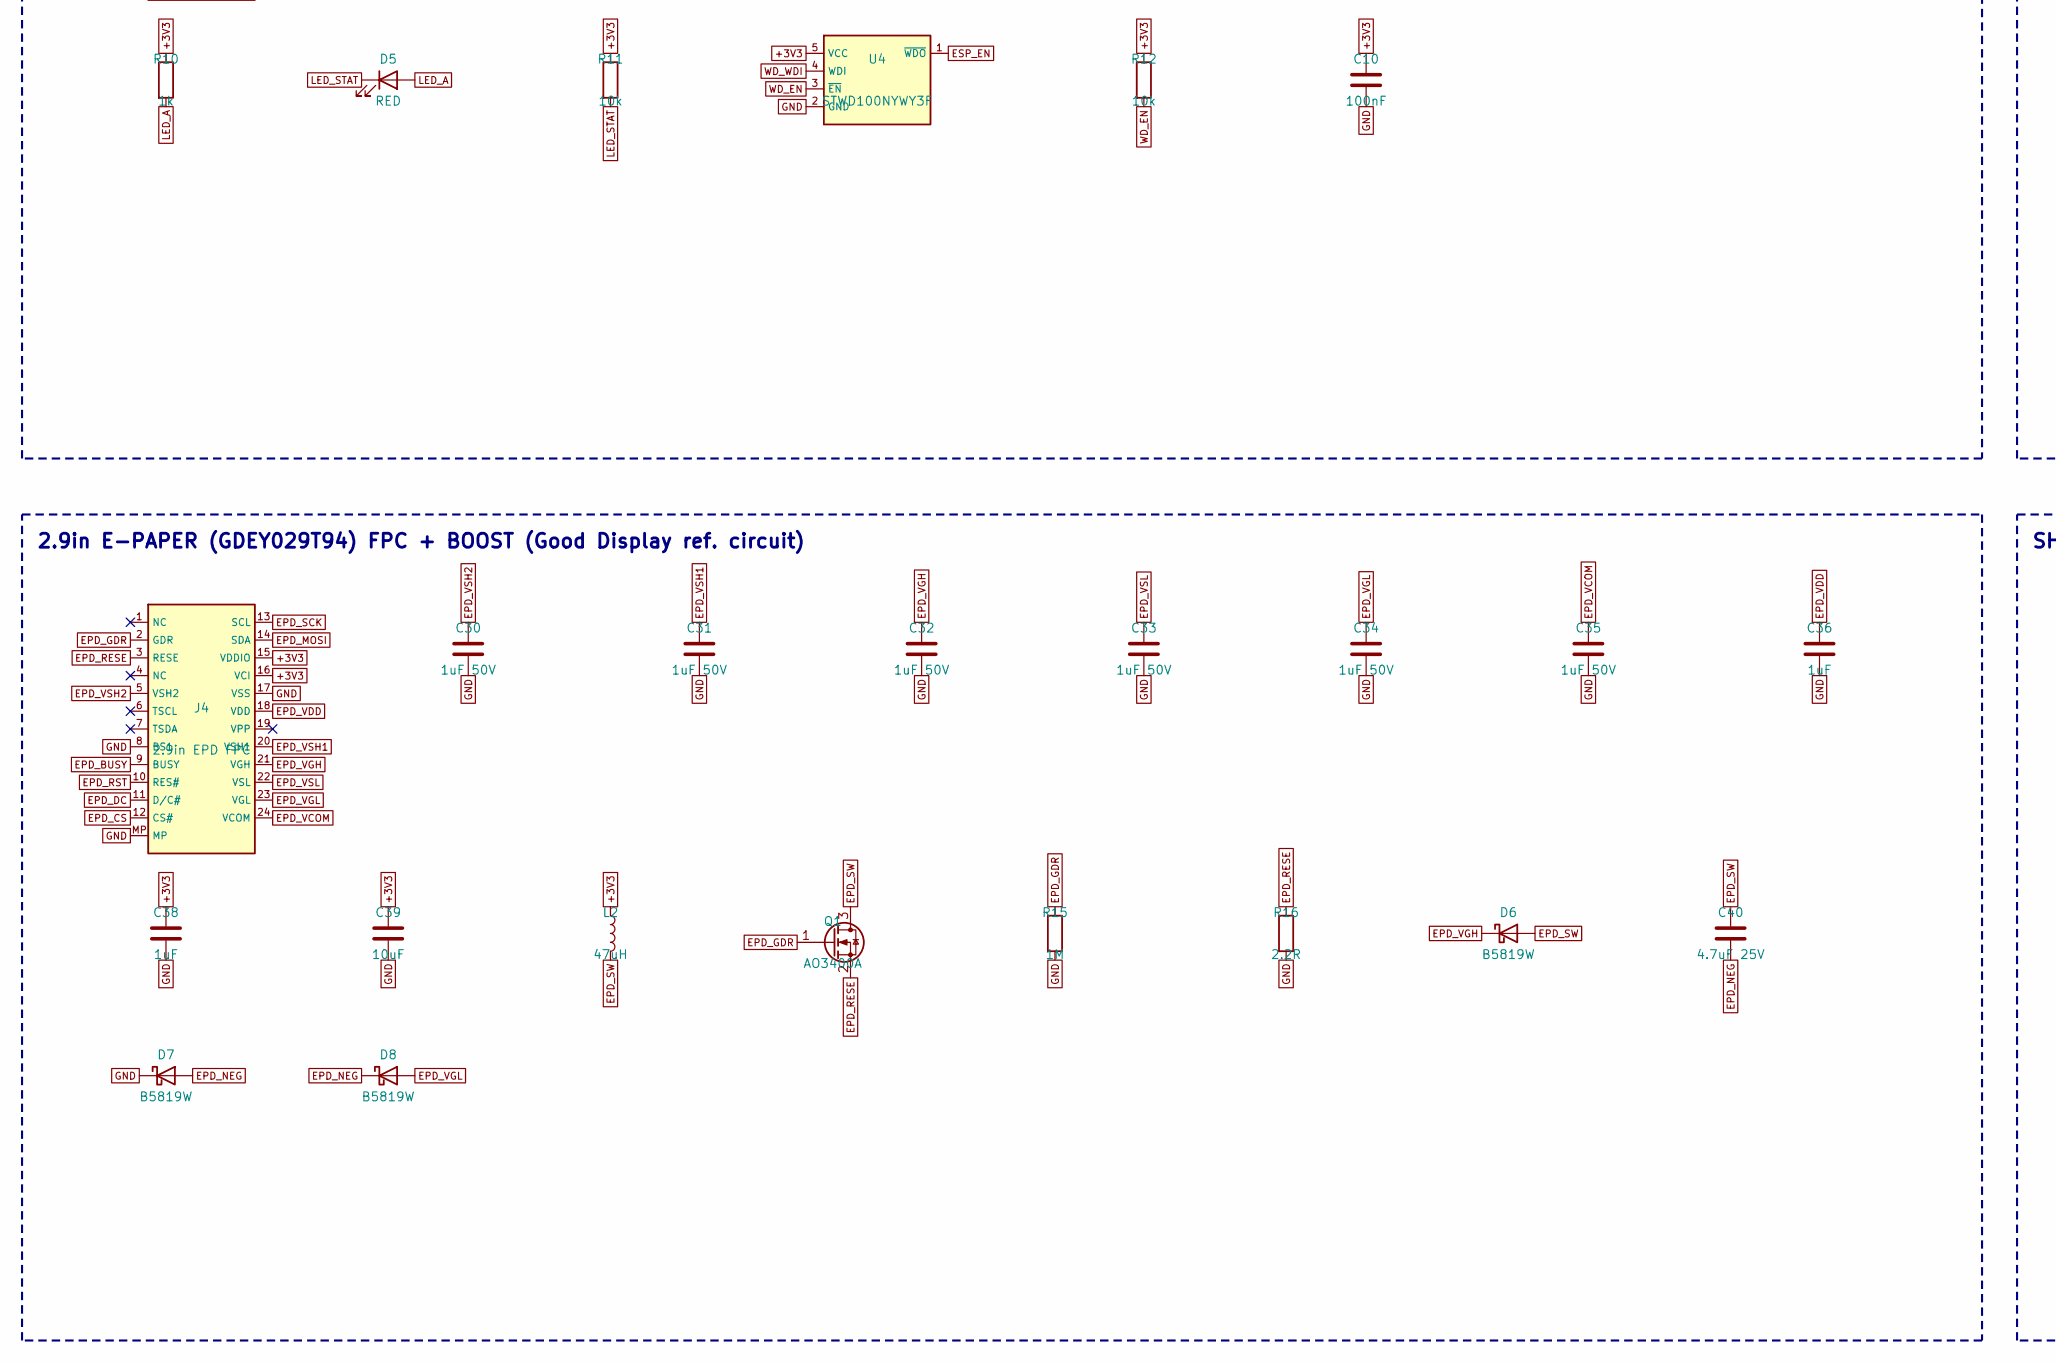
[picture p96: schematic thermostat-v3.kicad_sch, Connie's Super Awesome Thermostat V3, part in row 2, column 1]

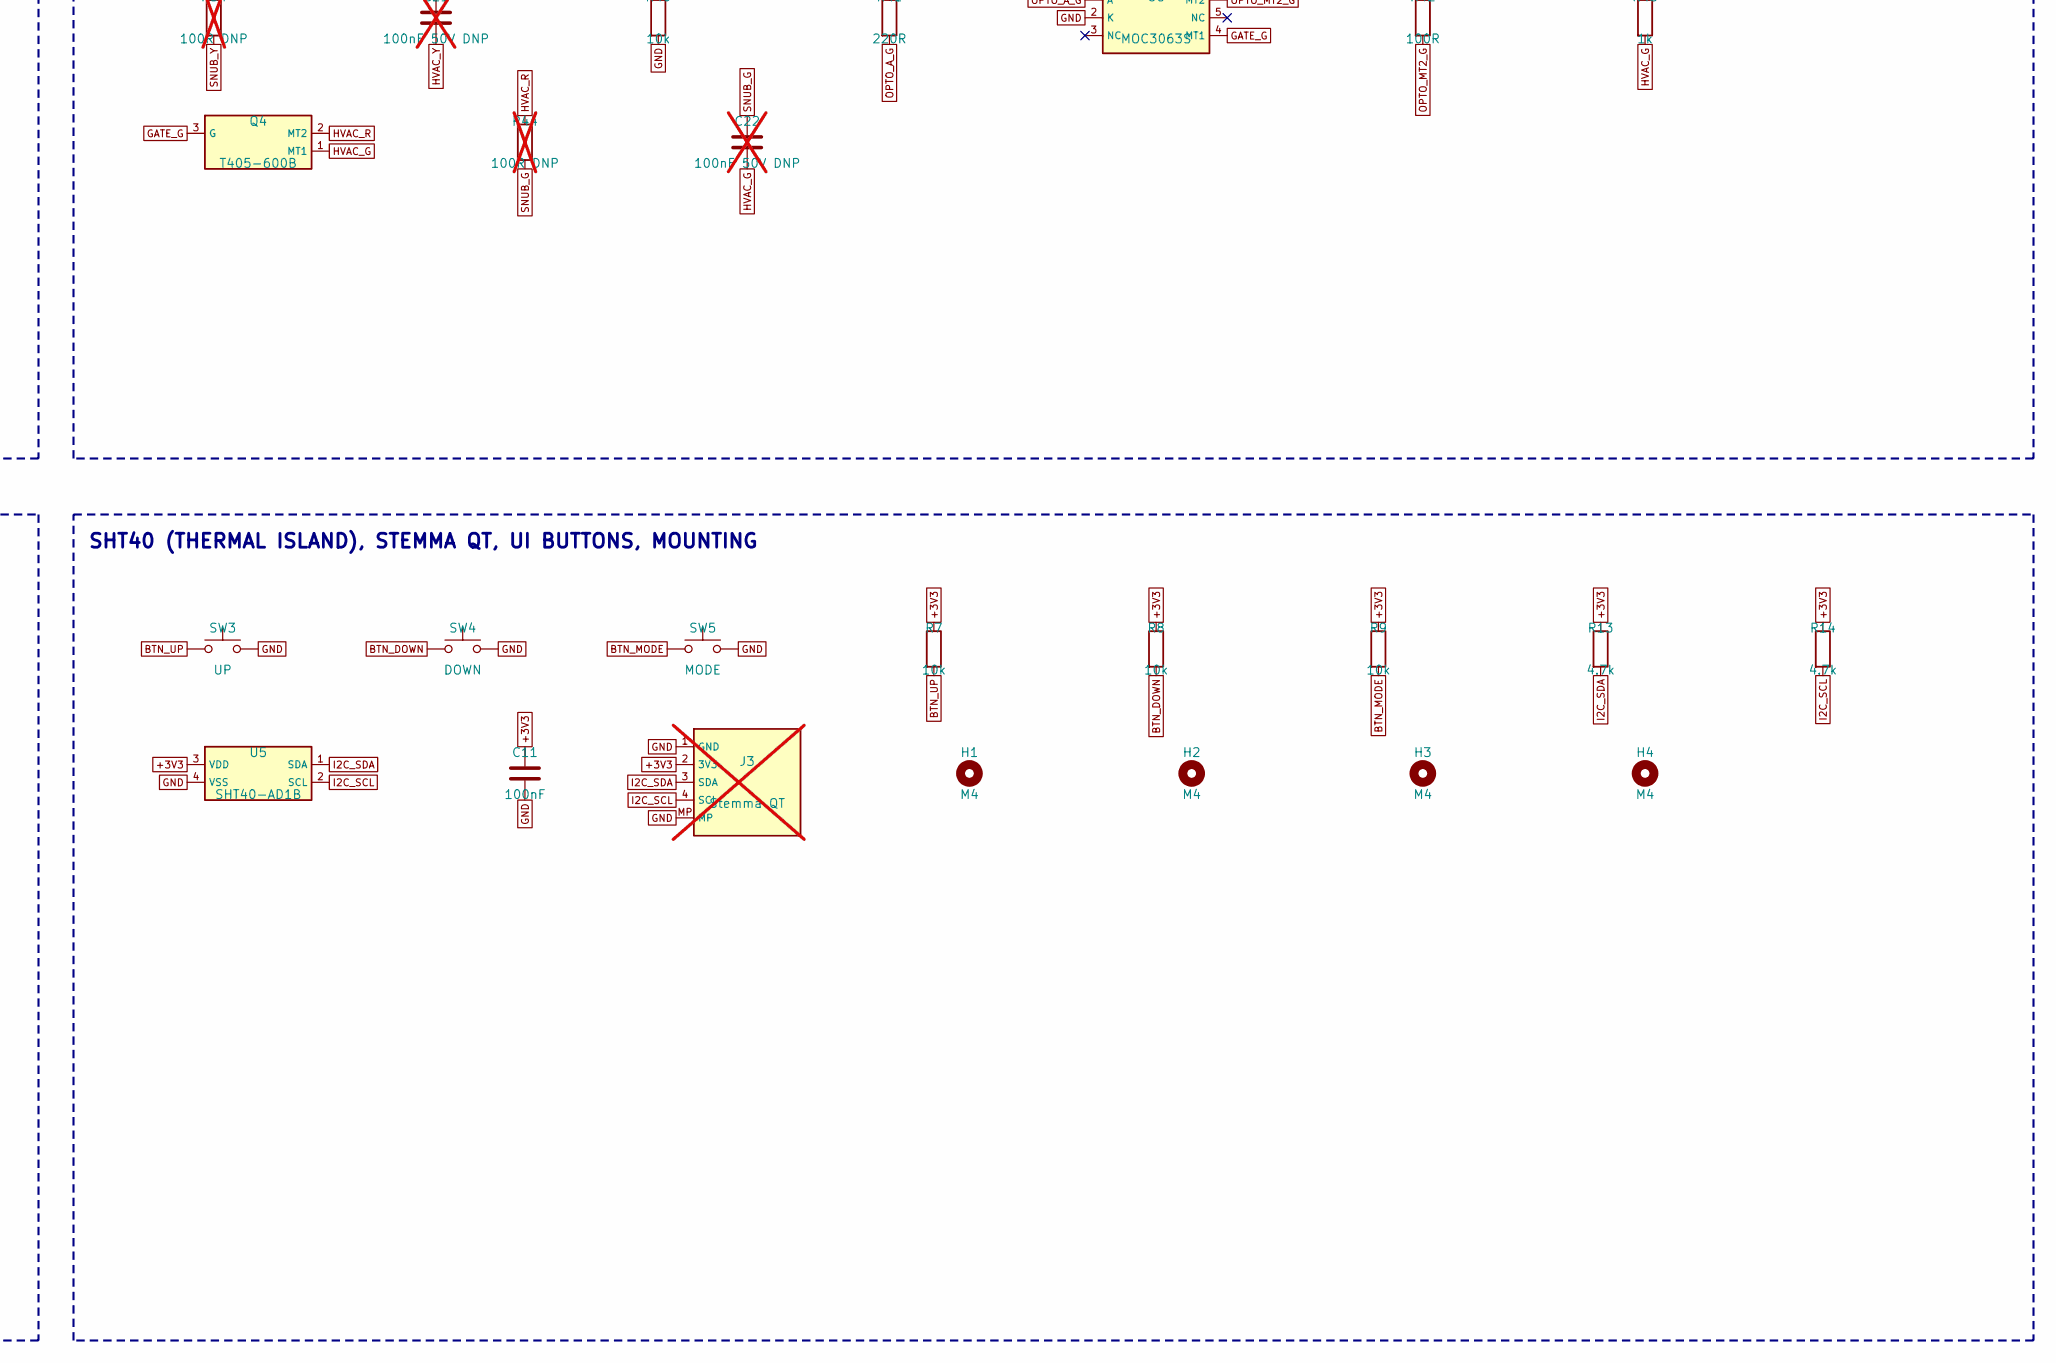
[picture p97: schematic thermostat-v3.kicad_sch, Connie's Super Awesome Thermostat V3, part in row 2, column 2]

Parts:
C1, C2, C41, C42: 4.7uF 100V X7R; C_1210_3225Metric; MPN FS32X475K101EGG; LCSC C381466
C3, C8, C10, C11: 100nF; C_0402_1005Metric; LCSC C1525
C4, C5, C7, C39: 10uF; C_0603_1608Metric; LCSC C19702
C6, C9, C36, C38: 1uF; C_0402_1005Metric; LCSC C52923
C20, C21, C22: 100nF 50V DNP; C_0805_2012Metric; LCSC C49678; not fitted
C30, C31, C32, C33, C34, C35: 1uF 50V; C_0603_1608Metric; LCSC C15849
C40: 4.7uF 25V; C_0805_2012Metric; LCSC C1779
C43: 47uF 63V; CP_Radial_D8.0mm_P3.50mm; MPN JBLH2470M063D090RLM 8x9 THT, BACK side,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; LCSC C19270693
D1: MB10S; MBS_MB10S; LCSC C2488
D2: SMBJ40CA; D_SMB_TVS; MPN SMBJ40CA (bidirectional, JLC preferred-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; LCSC C19077590
D3: SS210; SMA_SS210; MPN SS210 100V 2A Schottky (was B5819W 40V); LCSC C14996
D4: SS210; SMA_SS210; LCSC C14996
D5: RED; LED_0603_KT; LCSC C2286
D6, D7, D8: B5819W; SOD-123_B5819W; LCSC C8598
F1: 0.5A 60V PTC; F1812_PTC; MPN mSMD050-60V; LCSC C70113
H1, H2, H3, H4: M4; MountingHole_4.3mm_M4
J1: HVAC R C W Y G; HVAC_TERM_15EDGRC; MPN 15EDGRC-3.5-05P-14-00A(H) right-angle, 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; LCSC C7603439
J2: USB-C; USB_C_Receptacle_HRO_TYPE-C-31-M-12; LCSC C165948
J3: Stemma QT; JST_SH4_STEMMA; LCSC C51940130; not fitted
J4: 2.9in EPD FPC; FPC24_AFC07; LCSC C262567
L1: 22uH; L_Sunlord_SWPA6045S; MPN SWPA6045S220MT 22uH Isat 2.2A 89mOhm (w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; LCSC C83454
L2: 47uH; L_APV_ANR3015; LCSC C7427088
Q1: AO3400A; SOT-23_AO3400A; LCSC C20917
Q2, Q3, Q4: T405-600B; TO-252-2_TRIAC_DPAK; MPN T405-600B-TR (ST T4 logic-level, IGT 5m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; LCSC C283473
R1: 33k; R_0402_1005Metric; LCSC C25779
R2, R5, R6, R7, R8, R9, R11, R12, R20, R30, R40: 10k; R_0402_1005Metric; LCSC C25744
R3, R4: 5.1k; R_0402_1005Metric; LCSC C25905
R10: 1k; R_0402_1005Metric; LCSC C11702
R13, R14: 4.7k; R_0402_1005Metric; LCSC C25900
R15: 1M; R_0402_1005Metric; LCSC C26083
R16: 2.2R; R_0603_1608Metric; LCSC C22939
R21, R31, R41: 220R; R_0402_1005Metric; LCSC C25091
R22, R32, R42: 100R; R_0805_2012Metric; LCSC C17408
R23, R33, R43: 1k; R_0805_2012Metric; LCSC C17513
R24, R34, R44: 100R DNP; R_0805_2012Metric; LCSC C17408; not fitted
R50: 100k; R_0402_1005Metric; MPN 0402WGF1003TCE; LCSC C25741
R51: 3.3R 0.75W pulse; R_1206_3216Metric; MPN CRCW12063R30FKEAHP (Vishay pulse-proof,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; LCSC C844038
SW1: RESET; SW_TS1187A; LCSC C318884
SW2: BOOT; SW_TS1187A; LCSC C318884
SW3: UP; SW_TS1187A; LCSC C318884
SW4: DOWN; SW_TS1187A; LCSC C318884
SW5: MODE; SW_TS1187A; LCSC C318884
TP1: VIN_HV; TestPoint_Pad_D1.5mm; MPN test pad
TP2: GND; TestPoint_Pad_D1.5mm; MPN test pad
TP3: +3V3; TestPoint_Pad_D1.5mm; MPN test pad
TP4: VBUS; TestPoint_Pad_D1.5mm; MPN test pad
U1: LMR16006XDDCR; SOT-23-6_LMR16006; LCSC C87080
U2: USBLC6-2SC6; SOT-23-6_USBLC6; LCSC C7519
U3: ESP32-C6-WROOM-1-N8; ESP32-C6-WROOM-1; LCSC C5366877
U4: STWD100NYWY3F; SOT-23-5_STWD100; LCSC C46043
U5: SHT40-AD1B; Sensirion_DFN-4_1.5x1.5mm_P0.8mm_SHT4x_NoCentralPad; LCSC C2909890
U6, U7, U8: MOC3063S; LCSC C77950

Connections:
+3V3: C4.1, C5.1, C7.1, C8.1, C10.1, C11.1, C38.1, C39.1, J3.2 (3V3), J4.15 (VDDIO), J4.16 (VCI), L1.2, L2.1, R1.1, R5.1, R6.1, R7.1, R8.1, R9.1, R10.1, R11.1, R12.1, R13.1, R14.1, TP3.1, U3.2 (3V3), U4.5 (VCC), U5.3 (VDD)
BOOT: R6.2, SW2.1, U3.15 (IO9)
BTN_DOWN: R8.2, SW4.1, U3.5 (IO5)
BTN_MODE: R9.2, SW5.1, U3.26 (IO3)
BTN_UP: R7.2, SW3.1, U3.4 (IO4)
BUCK_CB: C3.1, U1.1 (CB)
BUCK_EN: R50.2, U1.4 (~SHDN)
BUCK_FB: R1.2, R2.1, U1.3 (FB)
BUCK_SW: C3.2, D4.1 (K), L1.1, U1.6 (SW)
CC1: J2.A5 (CC1), R3.1
CC2: J2.B5 (CC2), R4.1
DRV_G: R40.1, R41.1, U3.27 (IO2)
DRV_W: R20.1, R21.1, U3.8 (IO0)
DRV_Y: R30.1, R31.1, U3.9 (IO1)
EPD_BUSY: J4.9 (BUSY), U3.21 (IO23)
EPD_CS: J4.12 (CS#), U3.18 (IO20)
EPD_DC: J4.11 (D/C#), U3.19 (IO21)
EPD_GDR: J4.2 (GDR), Q1.1 (G), R15.1
EPD_MOSI: J4.14 (SDA), U3.16 (IO18)
EPD_NEG: C40.2, D7.2 (A), D8.1 (K)
EPD_RESE: J4.3 (RESE), Q1.2 (S), R16.1
EPD_RST: J4.10 (RES#), U3.20 (IO22)
EPD_SCK: J4.13 (SCL), U3.17 (IO19)
EPD_SW: C40.1, D6.2 (A), L2.2, Q1.3 (D)
EPD_VCOM: C35.1, J4.24 (VCOM)
EPD_VDD: C36.1, J4.18 (VDD)
EPD_VGH: C32.1, D6.1 (K), J4.21 (VGH)
EPD_VGL: C34.1, D8.2 (A), J4.23 (VGL)
EPD_VSH1: C31.1, J4.20 (VSH1)
EPD_VSH2: C30.1, J4.5 (VSH2)
EPD_VSL: C33.1, J4.22 (VSL)
ESP_EN: C9.1, R5.2, SW1.1, U3.3 (EN), U4.1 (~WDO)
GATE_G: Q4.3 (G), R43.1, U8.4 (MT1)
GATE_W: Q2.3 (G), R23.1, U6.4 (MT1)
GATE_Y: Q3.3 (G), R33.1, U7.4 (MT1)
GND: C1.2, C2.2, C4.2, C5.2, C6.2, C7.2, C8.2, C9.2, C10.2, C11.2, C30.2, C31.2, C32.2, C33.2, C34.2, C35.2, C36.2, C38.2, C39.2, C41.2, C42.2, C43.2, D1.2 (-), D2.2 (A2), D4.2 (A), D7.1 (K), J2.A1 (GND), J2.A12 (GND), J2.B1 (GND), J2.B12 (GND), J2.S1 (SHIELD), J3.1 (GND), J3.MP, J4.8 (BS1), J4.17 (VSS), J4.MP, R2.2, R3.2, R4.2, R15.2, R16.2, R20.2, R30.2, R40.2, SW1.2, SW2.2, SW3.2, SW4.2, SW5.2, TP2.1, U1.2 (GND), U2.2 (GND), U3.1 (GND), U3.28 (GND), U3.29 (EP_GND), U4.2 (GND), U5.4 (VSS), U6.2 (K), U7.2 (K), U8.2 (K)
HVAC_C: D1.4, J1.2 (C)
HVAC_G: C22.2, J1.5 (G), Q4.1 (MT1), R43.2
HVAC_R: F1.1, J1.1 (R), Q2.2 (MT2), Q3.2 (MT2), Q4.2 (MT2), R22.1, R24.1, R32.1, R34.1, R42.1, R44.1
HVAC_W: C20.2, J1.3 (W), Q2.1 (MT1), R23.2
HVAC_Y: C21.2, J1.4 (Y), Q3.1 (MT1), R33.2
I2C_SCL: J3.4 (SCL), R14.2, U3.7 (IO7), U5.2 (SCL)
I2C_SDA: J3.3 (SDA), R13.2, U3.6 (IO6), U5.1 (SDA)
LED_A: D5.2 (A), R10.2
LED_STAT: D5.1 (K), R11.2, U3.10 (IO8)
OPTO_A_G: R41.2, U8.1 (A)
OPTO_A_W: R21.2, U6.1 (A)
OPTO_A_Y: R31.2, U7.1 (A)
OPTO_MT2_G: R42.2, U8.6 (MT2)
OPTO_MT2_W: R22.2, U6.6 (MT2)
OPTO_MT2_Y: R32.2, U7.6 (MT2)
R_FUSED: D1.3, F1.2
SNUB_G: C22.1, R44.2
SNUB_W: C20.1, R24.2
SNUB_Y: C21.1, R34.2
USB_DN: J2.A7 (D-), J2.B7 (D-), U2.1 (IO1), U2.6 (IO1), U3.13 (IO12/D-)
USB_DP: J2.A6 (D+), J2.B6 (D+), U2.3 (IO2), U2.4 (IO2), U3.14 (IO13/D+)
VBUS: C6.1, D3.2 (A), J2.A4 (VBUS), J2.A9 (VBUS), J2.B4 (VBUS), J2.B9 (VBUS), TP4.1, U2.5 (VBUS)
VIN_HV: C1.1, C2.1, C41.1, C42.1, C43.1, D2.1 (A1), D3.1 (K), R50.1, R51.2, TP1.1, U1.5 (VIN)
VIN_RECT: D1.1 (+), R51.1
WD_EN: R12.2, U3.12 (IO11), U4.3 (~EN)
WD_WDI: U3.11 (IO10), U4.4 (WDI)

Notes on the sheet:
24VAC INPUT, PROTECTION & 3.3V BUCK
USB-C (FLASHING ONLY) & POWER-PATH - do not connect USB to an earthed PC while 24VAC is wired
ESP32-C6 MCU, RESET/BOOT, WATCHDOG, STATUS LED
HVAC OUTPUTS W / Y / G (zero-cross opto + triac, snubbers DNP)
2.9in E-PAPER (GDEY029T94) FPC + BOOST (Good Display ref. circuit)
SHT40 (THERMAL ISLAND), STEMMA QT, UI BUTTONS, MOUNTING

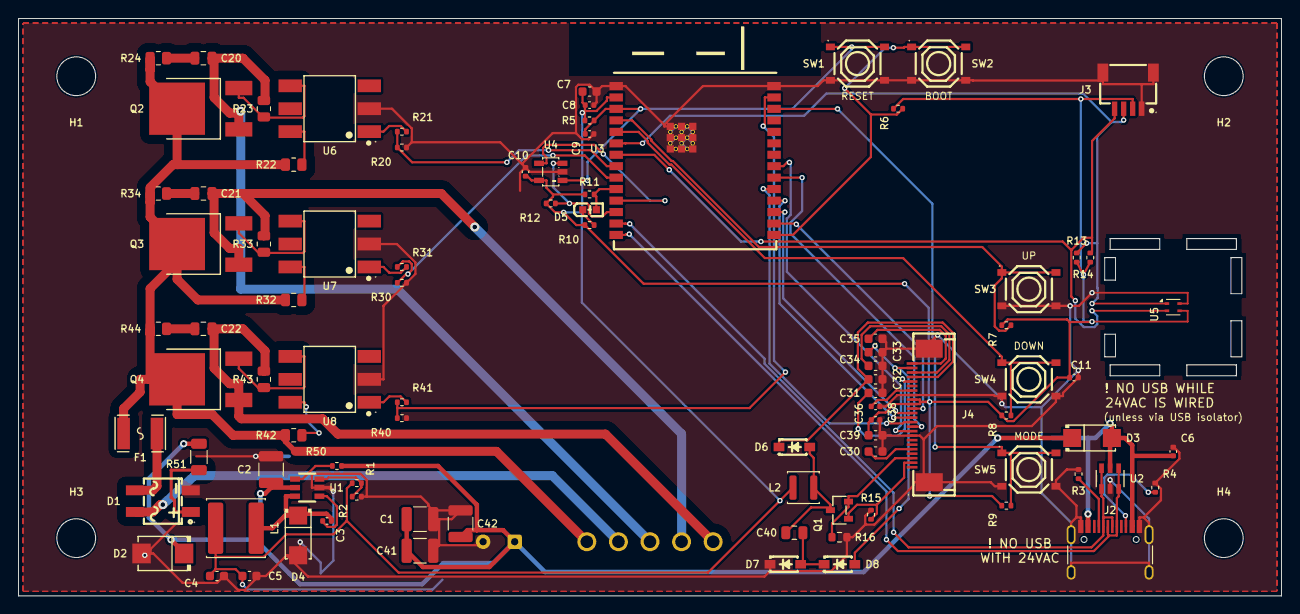
[picture p98: board thermostat-v3.kicad_pcb from above]

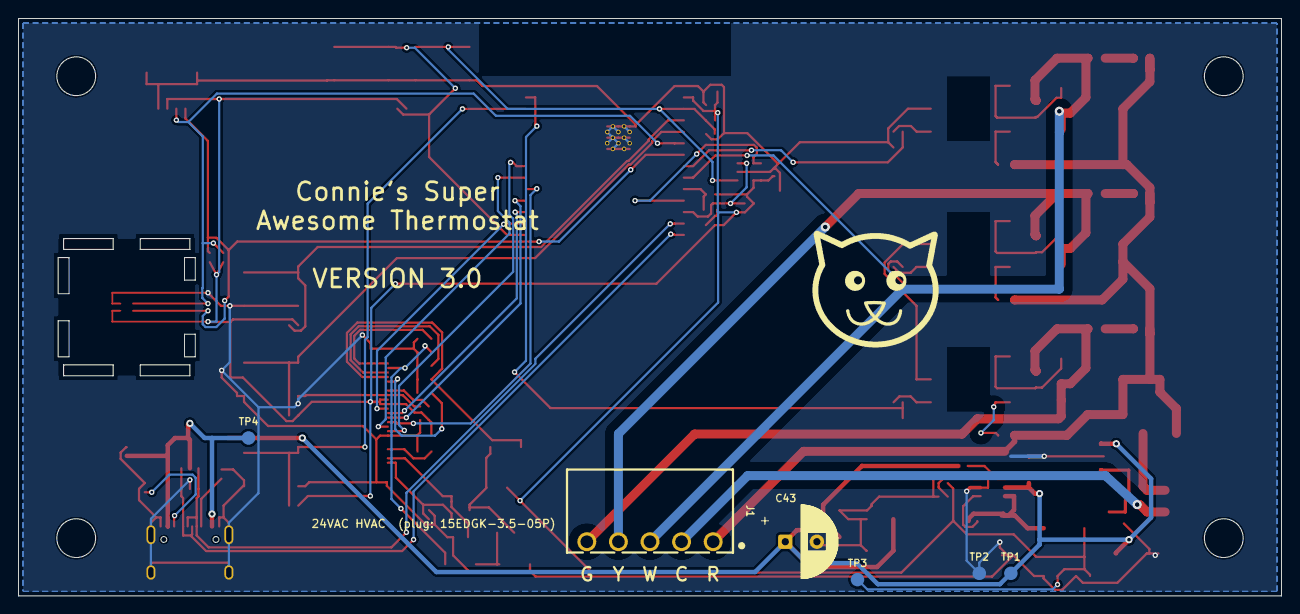
[picture p99: board thermostat-v3.kicad_pcb from below]

Board: 2 copper layers, 140.0 x 64.0 mm, 101 parts (7 on the bottom side), 62 nets.

Other parts of the board:
LOGO1: LOGO; LOGO_CAT
