Connicpu/thermostat/v2-original/Thermostat-V2.kicad_pcb

## KiCad design v2-original/Thermostat-V2.kicad_pcb (2026-10-13)

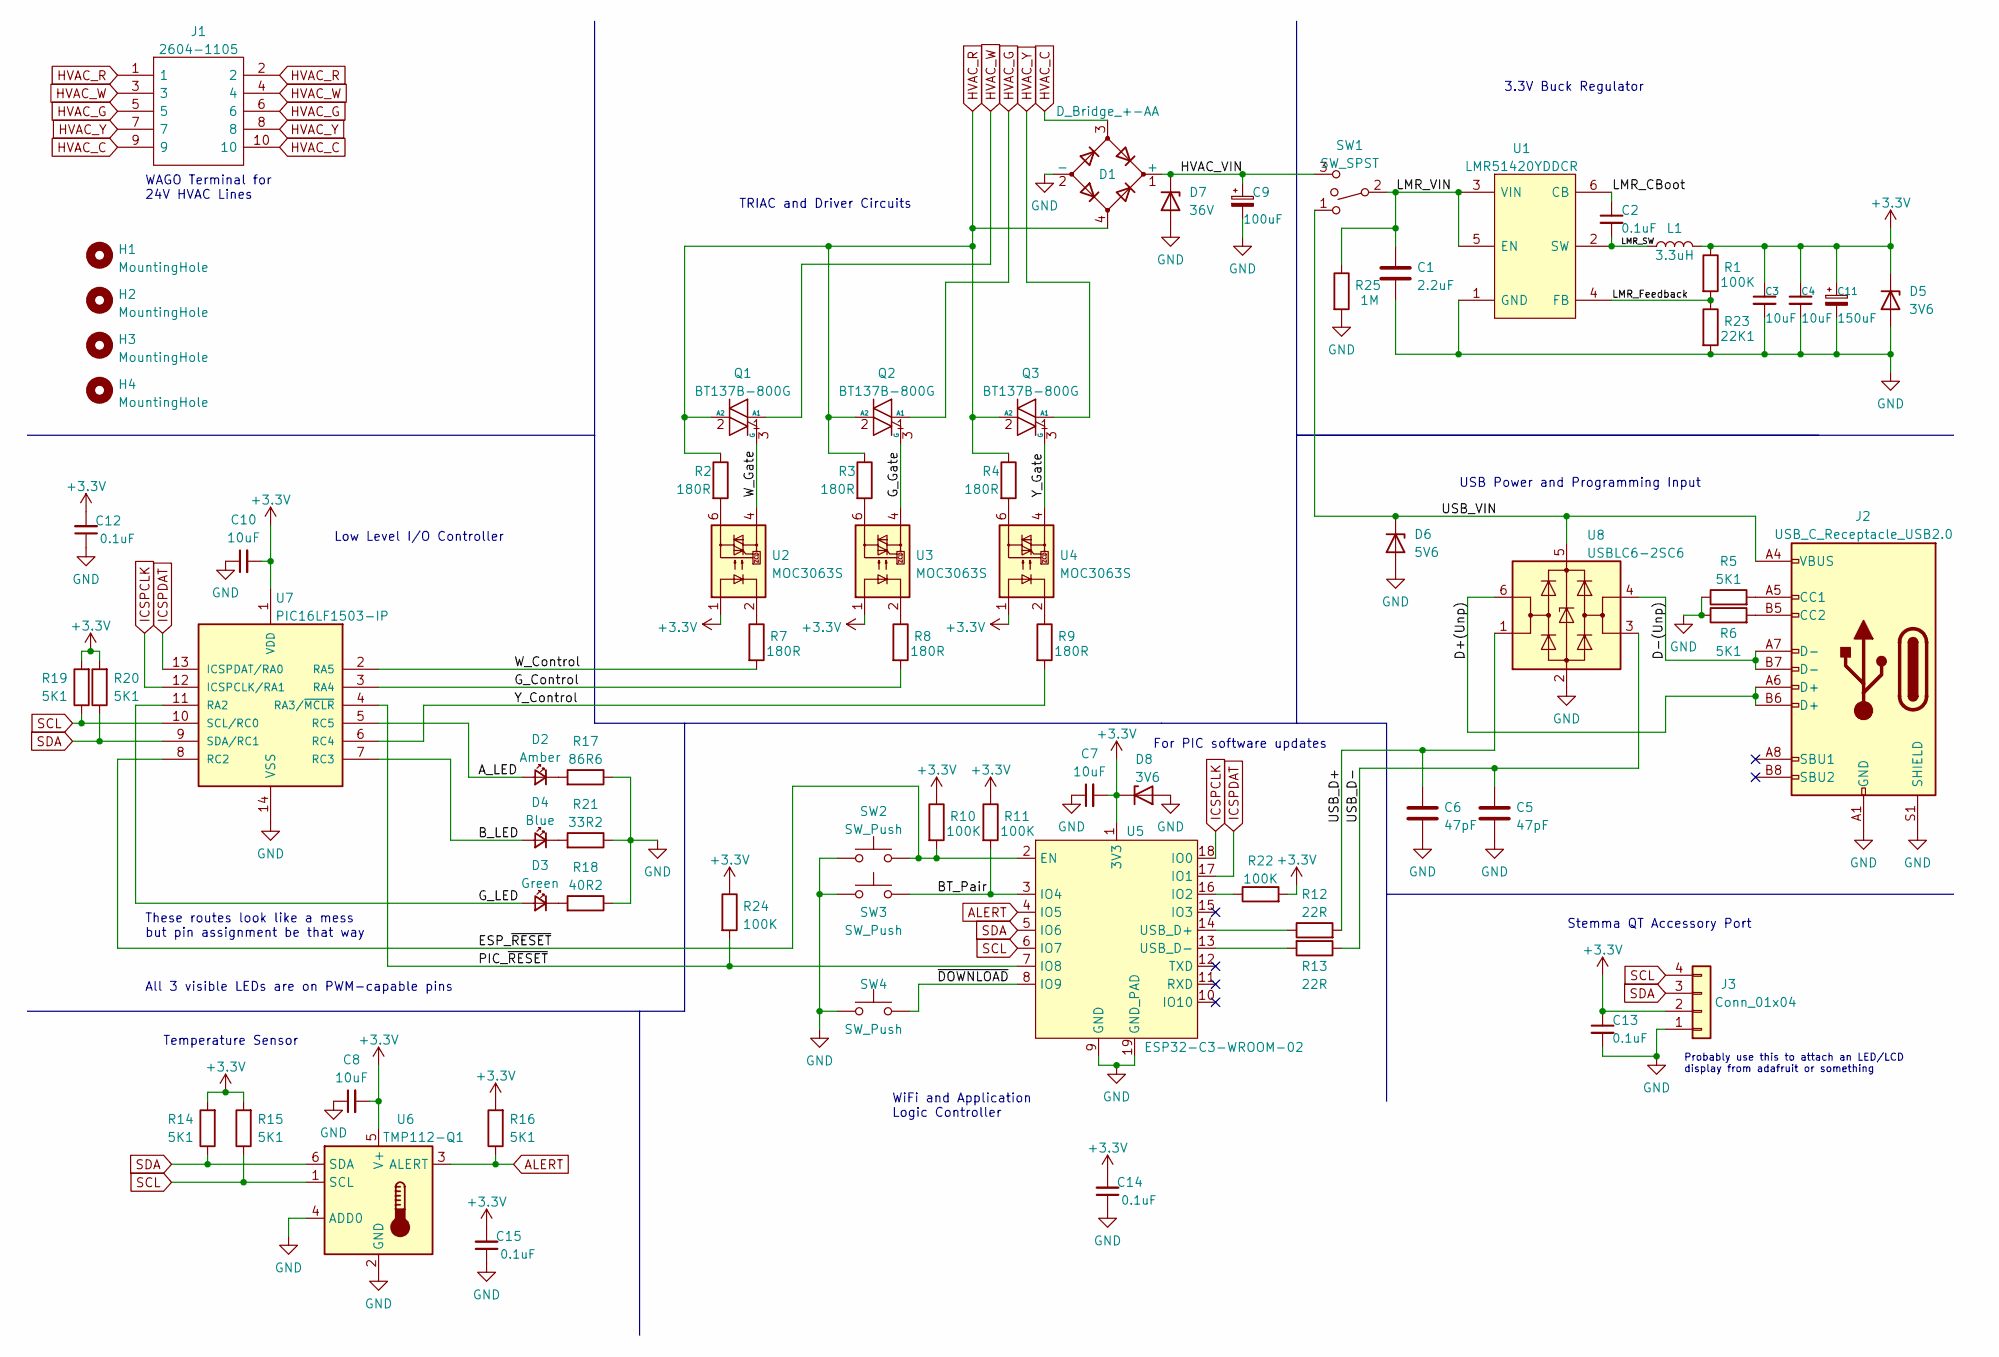
[picture p100: schematic Thermostat-V2.kicad_sch]

Parts:
C1: 2.2uF; C_0603_1608Metric_Pad1.08x0.95mm_HandSolder
C2, C12, C13, C14, C15: 0.1uF; C_0402_1005Metric_Pad0.74x0.62mm_HandSolder
C3, C4, C7, C8, C10: 10uF; C_0805_2012Metric_Pad1.18x1.45mm_HandSolder
C5, C6: 47pF; C_0402_1005Metric_Pad0.74x0.62mm_HandSolder
C9: 100uF; CP_Elec_8x6.9
C11: 150uF; CP_Elec_8x6.9
D1: D_Bridge_+-AA; Diode_Bridge_Diotec_ABS
D2: Amber; D_0603_1608Metric_Pad1.05x0.95mm_HandSolder
D3: Green; D_0603_1608Metric_Pad1.05x0.95mm_HandSolder
D4: Blue; D_0603_1608Metric_Pad1.05x0.95mm_HandSolder
D5, D8: 3V6; SOT-23_Handsoldering
D6: 5V6; SOT-23_Handsoldering
D7: 36V; SOT-23_Handsoldering
H1, H2, H3, H4: MountingHole; MountingHole_4.3mm_M4
J1: 2604-1105; 26041105; Manufacturer_Part_Number 2604-1105
J2: USB_C_Receptacle_USB2.0; USB_C_Receptacle_HRO_TYPE-C-31-M-12
J3: Conn_01x04; JST_SH_SM04B-SRSS-TB_1x04-1MP_P1.00mm_Horizontal
L1: 3.3uH; L_1210_3225Metric_Pad1.42x2.65mm_HandSolder
Q1, Q2, Q3: BT137B-800G; TO-263-2
R1, R10, R11, R22, R24: 100K; R_0201_0603Metric_Pad0.64x0.40mm_HandSolder
R2, R3, R4, R7, R8, R9: 180R; R_0402_1005Metric_Pad0.72x0.64mm_HandSolder
R5, R6, R14, R15, R16, R19, R20: 5K1; R_0402_1005Metric_Pad0.72x0.64mm_HandSolder
R12, R13: 22R; R_0201_0603Metric_Pad0.64x0.40mm_HandSolder
R17: 86R6; R_0402_1005Metric_Pad0.72x0.64mm_HandSolder
R18: 40R2; R_0402_1005Metric_Pad0.72x0.64mm_HandSolder
R21: 33R2; R_0402_1005Metric_Pad0.72x0.64mm_HandSolder
R23: 22K1; R_0402_1005Metric_Pad0.72x0.64mm_HandSolder
R25: 1M; R_0402_1005Metric_Pad0.72x0.64mm_HandSolder
SW1: SW_SPST; 500SSP3S1M6QEA
SW2, SW3, SW4: SW_Push; SW_PUSH_6mm
U1: LMR51420YDDCR; SOP95P280X110-6N; Manufacturer_Part_Number LMR51420YDDCR
U2, U3, U4: MOC3063S; SMDIP-6_W7.62mm
U5: ESP32-C3-WROOM-02; ESP32C3WROOM02N4
U6: TMP112-Q1; SOT-563
U7: PIC16LF1503-IP; DIP-14_W7.62mm_Socket
U8: USBLC6-2SC6; SOT-23-6

Connections:
+3V3: C3.1, C4.1, C7.2, C8.2, C10.2, C11.1, C12.2, C13.1, C14.2, C15.2, D5.3 (K), D8.3 (K), J3.2, L1.2, R1.1, R10.1, R11.1, R14.2, R15.2, R16.2, R19.2, R20.2, R22.2, R24.1, U2.1, U3.1, U4.1, U5.1 (3V3), U6.5 (V+), U7.1 (VDD)
/A_LED: D2.2 (A), U7.5 (RC5)
/BT_Pair: R11.2, SW3.2, U5.3 (IO4)
/B_LED: D4.2 (A), U7.7 (RC3)
/D+(Unp): J2.A6 (D+), J2.B6 (D+), U8.6 (I/O1)
/D-(Unp): J2.A7 (D-), J2.B7 (D-), U8.4 (I/O2)
/ESP_~RESET: R10.2, SW2.2, U5.2 (EN), U7.8 (RC2)
/G_Control: R8.2, U7.3 (RA4)
/G_Gate: Q2.3 (G), U3.4
/G_LED: D3.2 (A), U7.11 (RA2)
/HVAC_VIN: C9.1, D1.1 (+), D7.3 (K), SW1.3
/LMR_CBoot: C2.1, U1.6 (CB)
/LMR_Feedback: R1.2, R23.1, U1.4 (FB)
/LMR_SW: C2.2, L1.1, U1.2 (SW)
/LMR_VIN: C1.1, R25.1, SW1.2, U1.3 (VIN), U1.5 (EN)
/PIC_~RESET: R24.2, U5.7 (IO8), U7.4 (RA3/~MCLR)
/USB_D+: C6.2, R12.2, U8.1 (I/O1)
/USB_D-: C5.1, R13.1, U8.3 (I/O2)
/USB_VIN: D6.3 (K), J2.A4 (VBUS), J2.A9 (VBUS), J2.B4 (VBUS), J2.B9 (VBUS), SW1.1, U8.5 (VBUS)
/W_Control: R7.2, U7.2 (RA5)
/W_Gate: Q1.3 (G), U2.4
/Y_Control: R9.2, U7.6 (RC4)
/Y_Gate: Q3.3 (G), U4.4
/~DOWNLOAD: SW4.2, U5.8 (IO9)
ALERT: R16.1, U5.4 (IO5), U6.3 (ALERT)
GND: C1.2, C3.2, C4.2, C5.2, C6.1, C7.1, C8.1, C9.2, C10.1, C11.2, C12.1, C13.2, C14.1, C15.1, D1.2 (-), D5.1 (A), D6.1 (A), D7.1 (A), D8.1 (A), J2.A1 (GND), J2.A12 (GND), J2.B1 (GND), J2.B12 (GND), J2.S1 (SHIELD), J3.1, R5.1, R6.1, R17.1, R18.1, R21.1, R23.2, R25.2, SW2.1, SW3.1, SW4.1, U1.1 (GND), U5.9 (GND), U5.19 (GND_PAD), U6.2 (GND), U6.4 (ADD0), U7.14 (VSS), U8.2 (GND)
HVAC_C: D1.3, J1.9, J1.10
HVAC_G: J1.5, J1.6, Q2.1 (A1)
HVAC_R: D1.4, J1.1, J1.2, Q1.2 (A2), Q2.2 (A2), Q3.2 (A2), R2.1, R3.1, R4.1
HVAC_W: J1.3, J1.4, Q1.1 (A1)
HVAC_Y: J1.7, J1.8, Q3.1 (A1)
ICSPCLK: U5.18 (IO0), U7.12 (ICSPCLK/RA1)
ICSPDAT: U5.17 (IO1), U7.13 (ICSPDAT/RA0)
unnamed: D2.1 (K), R17.2
unnamed: D3.1 (K), R18.2
unnamed: D4.1 (K), R21.2
unnamed: J2.A5 (CC1), R5.2
unnamed: J2.B5 (CC2), R6.2
unnamed: R2.2, U2.6
unnamed: R3.2, U3.6
unnamed: R4.2, U4.6
unnamed: R7.1, U2.2
unnamed: R8.1, U3.2
unnamed: R9.1, U4.2
unnamed: R12.1, U5.14 (USB_D+)
unnamed: R13.2, U5.13 (USB_D-)
unnamed: R22.1, U5.16 (IO2)
SCL: J3.4, R15.1, R19.1, U5.6 (IO7), U6.1 (SCL), U7.10 (SCL/RC0)
SDA: J3.3, R14.1, R20.1, U5.5 (IO6), U6.6 (SDA), U7.9 (SDA/RC1)

Notes on the sheet:
Stemma QT Accessory Port
Low Level I/O Controller
Temperature Sensor
These routes look like a mess but pin assignment be that way
All 3 visible LEDs are on PWM-capable pins
USB Power and Programming Input
WAGO Terminal for 24V HVAC Lines
WiFi and Application Logic Controller
Probably use this to attach an LED/LCD display from adafruit or something
3.3V Buck Regulator
For PIC software updates
TRIAC and Driver Circuits
