Connicpu/thermostat/v2-original/Thermostat-V2.kicad_pcb

## KiCad design v2-original/Thermostat-V2.kicad_pcb (continued)

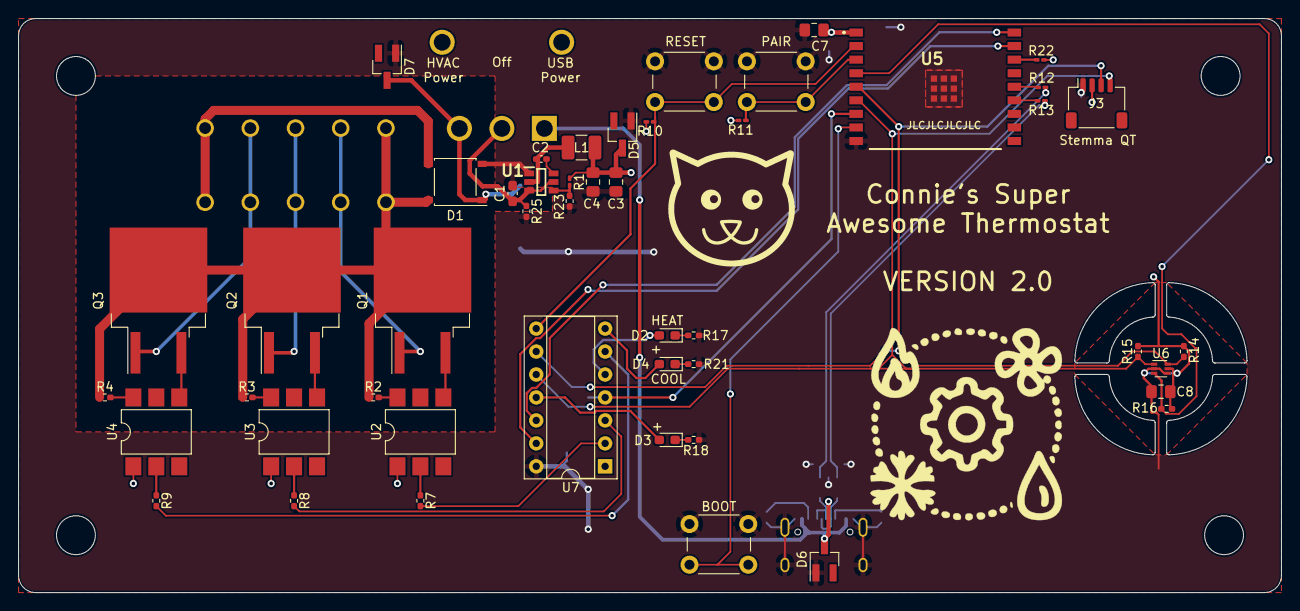
[picture p101: board Thermostat-V2.kicad_pcb from above]

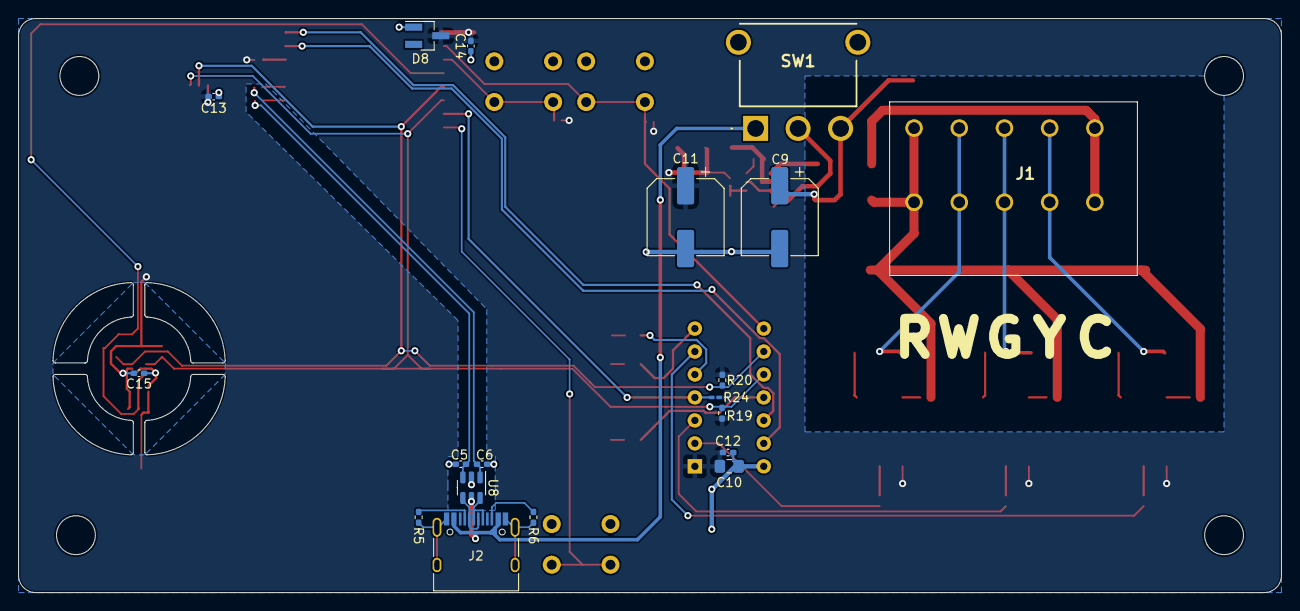
[picture p102: board Thermostat-V2.kicad_pcb from below]

Board: 2 copper layers, 139.7 x 63.5 mm, 71 parts (19 on the bottom side), 49 nets.
