Connicpu/thermostat/firmware/test/hootl/fake/include/driver/gpio.h

/* HOOTL fake GPIO: every output change is written to the trace (fake/periph.c). */
#pragma once
#include <stdint.h>
#include "esp_err.h"
typedef enum
{
    GPIO_NUM_NC = -1,
    GPIO_NUM_0 = 0,
    GPIO_NUM_1,
    GPIO_NUM_2,
    GPIO_NUM_3,
    GPIO_NUM_4,
    GPIO_NUM_5,
    GPIO_NUM_6,
    GPIO_NUM_7,
    GPIO_NUM_8,
    GPIO_NUM_9,
    GPIO_NUM_10,
    GPIO_NUM_11,
    GPIO_NUM_12,
    GPIO_NUM_13,
    GPIO_NUM_14,
    GPIO_NUM_15,
    GPIO_NUM_16,
    GPIO_NUM_17,
    GPIO_NUM_18,
    GPIO_NUM_19,
    GPIO_NUM_20,
    GPIO_NUM_21,
    GPIO_NUM_22,
    GPIO_NUM_23,
    GPIO_NUM_MAX
} gpio_num_t;
typedef enum
{
    GPIO_MODE_DISABLE = 0,
    GPIO_MODE_INPUT = 1,
    GPIO_MODE_OUTPUT = 2,
    GPIO_MODE_OUTPUT_OD = 6,
    GPIO_MODE_INPUT_OUTPUT = 3,
    GPIO_MODE_INPUT_OUTPUT_OD = 7
} gpio_mode_t;
typedef enum
{
    GPIO_PULLUP_DISABLE = 0,
    GPIO_PULLUP_ENABLE = 1
} gpio_pullup_t;
typedef enum
{
    GPIO_PULLDOWN_DISABLE = 0,
    GPIO_PULLDOWN_ENABLE = 1
} gpio_pulldown_t;
typedef enum
{
    GPIO_INTR_DISABLE = 0
} gpio_int_type_t;
typedef struct
{
    uint64_t pin_bit_mask;
    gpio_mode_t mode;
    gpio_pullup_t pull_up_en;
    gpio_pulldown_t pull_down_en;
    gpio_int_type_t intr_type;
} gpio_config_t;
esp_err_t gpio_config(const gpio_config_t *c);
esp_err_t gpio_set_level(gpio_num_t n, uint32_t level);
int gpio_get_level(gpio_num_t n);
esp_err_t gpio_sleep_sel_dis(gpio_num_t n);
