Connicpu/thermostat/firmware/test/host/test_menu.c

/* Host tests for the on-device menu state machine (+ PBM previews of every screen). */
#include "core.h"
#include "tinytest.h"
#include "menu.h"
#include "buttons.h"
#include "font.h"
#include "gfx.h"
#include <stdio.h>
#include <string.h>

static Menu s_m;
static MenuCtx s_c;
static U64 s_t;

/**
 * Fresh menu at the main screen, t = 1 s, and a fixed live context (Heat, joined, °C, default schedule, sample sensor/uptime values).
 */
static void Reset(void)
{
    MenuInit(&s_m);
    s_t = 1000;
    s_c = (MenuCtx){.mode = kCtrlModeHeat,
                    .boostSp = 2200,
                    .boostMinutes = 30,
                    .swing = 50,
                    .fahrenheit = false,
                    .link = kLinkJoined,
                    .pFwVersion = "0.2.0",
                    .rawValid = true,
                    .rawTemp = 2263,
                    .rawRh = 4512,
                    .uptimeS = 2 * 86400 + 3 * 3600 + 7 * 60,
                    .sched = SCHED_CFG_DEFAULT()};
}

/** Send one key event 300 ms after the previous one. Returns the menu action. */
static MenuAction Key(MenuKey k, BtnEvent ev)
{
    s_t += 300;
    return MenuOnKey(&s_m, &s_c, k, ev, s_t);
}

/** Short UP press. Returns the menu action. */
static MenuAction Up(void)
{
    return Key(kMenuKeyUp, kBtnEvPress);
}

/** Short DOWN press. Returns the menu action. */
static MenuAction Down(void)
{
    return Key(kMenuKeyDown, kBtnEvPress);
}

/** Short M press. Returns the menu action. */
static MenuAction Sel(void)
{
    return Key(kMenuKeyM, kBtnEvPress);
}

/** Open the menu (from the main screen) and move the cursor down to main-list row i. */
static void GotoItem(int i)
{
    Sel();
    for (int k = 0; k < i; k++)
        Down();
}

/** On the main screen UP/DOWN/combo are returned to the caller; short M opens the menu. */
static void HomeKeysPassThrough(void)
{
    Reset();
    CHECK_EQ(Up().kind, kMaHomeKey);
    CHECK_EQ(Down().kind, kMaHomeKey);
    CHECK_EQ(Key(kMenuKeyCombo, kBtnEvPress).kind, kMaHomeKey);
    CHECK(MenuIsHome(&s_m));
    MenuAction a = Sel();
    CHECK_EQ(s_m.st, kMsList);
    CHECK(a.redraw);
    CHECK(!MenuIsHome(&s_m));
}

/** The main list wraps both ways, and Back returns home with a full refresh and no action. */
static void NavigationWrapsAndBack(void)
{
    MenuView v;
    Reset();
    Sel();
    CHECK_EQ(s_m.cursor, kMiMode);
    Up(); /* wraps to Back; Clear safe mode is not listed */
    MenuGetView(&s_m, &s_c, &v);
    CHECK_EQ(v.sel, v.nRows - 1);
    CHECK_EQ(s_m.cursor, kMiBack);
    Down();
    CHECK_EQ(s_m.cursor, kMiMode);
    for (int i = 0; i < kMiCount && s_m.cursor != kMiBack; i++)
        Down();
    CHECK_EQ(s_m.cursor, kMiBack);
    MenuAction a = Sel();
    CHECK(MenuIsHome(&s_m));
    CHECK(a.fullRefresh);
    CHECK_EQ(a.kind, kMaNone);
}

/** MENU_TIMEOUT_MS without a key returns home without saving the edit; MenuTick() at home is a no-op. */
static void TimeoutDiscardsEdit(void)
{
    Reset();
    GotoItem(kMiSwing);
    Sel();
    CHECK_EQ(s_m.st, kMsEditSwing);
    Up();
    Up();
    CHECK_EQ(s_m.edit, 70);
    CHECK_EQ(MenuTick(&s_m, s_t + MENU_TIMEOUT_MS - 1).kind, kMaNone);
    CHECK(!MenuIsHome(&s_m));
    MenuAction a = MenuTick(&s_m, s_t + MENU_TIMEOUT_MS);
    CHECK(MenuIsHome(&s_m));
    CHECK_EQ(a.kind, kMaNone); /* nothing saved */
    CHECK(a.fullRefresh);
    CHECK_EQ(MenuTick(&s_m, s_t + 3 * MENU_TIMEOUT_MS).kind, kMaNone); /* no-op at home */
}

/**
 * Regression (HOOTL menu_navigation_buttons): opening the menu long after the last key must not time out on the next tick.
 */
static void OpenAfterLongIdleDoesNotTimeOut(void)
{
    Reset();
    s_t += 10 * MENU_TIMEOUT_MS;
    Sel();
    CHECK(!MenuIsHome(&s_m));
    CHECK_EQ(MenuTick(&s_m, s_t + 1).kind, kMaNone);
    CHECK(!MenuIsHome(&s_m));
    Sel();
    CHECK_EQ(s_m.st, kMsEditMode);
}

/**
 * The app samples the clock, then a key stamps lastKeyMs from a later NowMs(), then MenuTick
 * runs on the earlier sample. That sample is not idle: unsigned subtraction must not underflow
 * and close the menu.
 */
static void TickBeforeLastKeyDoesNotClose(void)
{
    Reset();
    Sel();
    CHECK(!MenuIsHome(&s_m));
    CHECK_EQ(MenuTick(&s_m, s_t - 1).kind, kMaNone);
    CHECK(!MenuIsHome(&s_m));
    CHECK_EQ(MenuTick(&s_m, s_t + MENU_TIMEOUT_MS - 1).kind, kMaNone);
    CHECK(!MenuIsHome(&s_m));
    MenuAction a = MenuTick(&s_m, s_t + MENU_TIMEOUT_MS);
    CHECK(MenuIsHome(&s_m));
    CHECK_EQ(a.kind, kMaNone);
}

/** The mode editor cycles Heat -> Cool -> Off (no Auto), wraps, and saves with M. */
static void EditModeSaves(void)
{
    Reset();
    GotoItem(kMiMode);
    Sel();
    CHECK_EQ(s_m.st, kMsEditMode);
    Up(); /* Heat -> Cool */
    Up(); /* -> Off (there is no Auto) */
    MenuAction a = Sel();
    CHECK_EQ(a.kind, kMaSetMode);
    CHECK_EQ(a.value, kCtrlModeOff);
    CHECK_EQ(s_m.st, kMsList);
    GotoItem(0); /* (already in list; sel opens Mode again) */
    CHECK_EQ(s_m.st, kMsEditMode);
    Up();
    Up();
    Up();
    Up(); /* Heat -> wraps past Off -> Cool */
    CHECK_EQ(Sel().value, kCtrlModeCool);
}

/** The fan editor toggles Auto/On, saves, and reopens at the current value. */
static void EditFanToggles(void)
{
    Reset();
    s_c.fan = kCtrlFanAuto;
    GotoItem(kMiFan);
    Sel();
    CHECK_EQ(s_m.st, kMsEditFan);
    MenuView v;
    MenuGetView(&s_m, &s_c, &v);
    CHECK(strcmp(v.big, "Auto") == 0);
    Up();
    MenuGetView(&s_m, &s_c, &v);
    CHECK(strcmp(v.big, "On") == 0);
    MenuAction a = Sel();
    CHECK_EQ(a.kind, kMaSetFan);
    CHECK_EQ(a.value, kCtrlFanOn);
    CHECK_EQ(s_m.st, kMsList);
    s_c.fan = kCtrlFanOn;
    MenuGetView(&s_m, &s_c, &v);
    CHECK(strcmp(v.value[kMiFan], "On") == 0);
    Sel(); /* cursor still on Fan: reopen, starts at On */
    Down();
    CHECK_EQ(Sel().value, kCtrlFanAuto);
}

/** Open the Schedule submenu and the editor for schedule item `it`. */
static void OpenSchedItem(int it)
{
    GotoItem(kMiSched);
    Sel();
    for (int k = 0; k < it; k++)
        Down();
    Sel();
}

/** The schedule list shows all 10 items with formatted values plus Back, and wraps to Back. */
static void ScheduleListShowsAllKnobs(void)
{
    Reset();
    GotoItem(kMiSched);
    Sel();
    CHECK_EQ(s_m.st, kMsSched);
    MenuView v;
    MenuGetView(&s_m, &s_c, &v);
    CHECK_EQ(v.nRows, kSchedItCount + 1);
    CHECK(strcmp(v.value[kSchedItDayHeatStart], "06:00") == 0);
    CHECK(strcmp(v.value[kSchedItNightHeatStart], "22:00") == 0);
    CHECK(
        strcmp(
            v.value[kSchedItDayHeat],
            "20.0"
            "\x7f"
            "C") == 0);
    CHECK(strcmp(v.value[kSchedItBoostMin], "120 min") == 0);
    CHECK(
        strcmp(
            v.value[kSchedItBoostOfs],
            "+0.5"
            "\x7f"
            "C") == 0);
    CHECK(strcmp(v.label[kSchedItCount], "Back") == 0);
    Up(); /* wraps to Back */
    CHECK_EQ(s_m.scursor, kSchedItCount);
    Sel();
    CHECK_EQ(s_m.st, kMsList);
}

/** Start times step by 15 min, snap odd stored minutes to the grid and wrap around midnight both ways. */
static void ScheduleTimeStepsWrap(void)
{
    Reset();
    OpenSchedItem(kSchedItDayHeatStart);
    CHECK_EQ(s_m.st, kMsEditSched);
    CHECK_EQ(s_m.edit, 360);
    Up();
    MenuView v;
    MenuGetView(&s_m, &s_c, &v);
    CHECK(strcmp(v.big, "06:15") == 0);
    MenuAction a = Sel();
    CHECK_EQ(a.kind, kMaSetSched);
    CHECK_EQ(a.item, kSchedItDayHeatStart);
    CHECK_EQ(a.value, 375);
    CHECK_EQ(s_m.st, kMsSched); /* back to the schedule list */
    /* midnight wrap both ways; odd stored minute snaps to the 15-min grid */
    Reset();
    s_c.sched.nightCoolStart = 1432; /* 23:52 -> 23:45 */
    OpenSchedItem(kSchedItNightCoolStart);
    CHECK_EQ(s_m.edit, 1425);
    Up();
    CHECK_EQ(s_m.edit, 0);
    MenuGetView(&s_m, &s_c, &v);
    CHECK(strcmp(v.big, "00:00") == 0);
    Key(kMenuKeyDown, kBtnEvPress);
    CHECK_EQ(s_m.edit, 1425);
}

/**
 * Schedule temperatures step 0.5 °C (1 °F) within 10..32 °C; boost minutes and offset clamp to their ranges; °F shows the offset converted.
 */
static void ScheduleTempAndBoostClamps(void)
{
    Reset();
    OpenSchedItem(kSchedItNightHeat);
    CHECK_EQ(s_m.edit, 1800);
    Down();
    CHECK_EQ(s_m.edit, 1750); /* 0.5 °C steps */
    for (int i = 0; i < 40; i++)
        Key(kMenuKeyDown, kBtnEvRepeat);
    CHECK_EQ(s_m.edit, 1000); /* setpoint range like Zigbee */
    CHECK_EQ(Sel().value, 1000);
    Reset();
    OpenSchedItem(kSchedItDayCool);
    for (int i = 0; i < 40; i++)
        Key(kMenuKeyUp, kBtnEvRepeat);
    CHECK_EQ(s_m.edit, 3200);
    Reset();
    OpenSchedItem(kSchedItBoostMin);
    for (int i = 0; i < 30; i++)
        Up();
    CHECK_EQ(s_m.edit, SCHED_BOOST_MAX_MIN);
    for (int i = 0; i < 30; i++)
        Down();
    CHECK_EQ(s_m.edit, 0);
    MenuView v;
    MenuGetView(&s_m, &s_c, &v);
    CHECK(strcmp(v.bigUnit, "off") == 0);
    CHECK_EQ(Sel().value, 0);
    Reset();
    OpenSchedItem(kSchedItBoostOfs);
    CHECK_EQ(s_m.edit, 50);
    Up();
    CHECK_EQ(s_m.edit, 60); /* 0.1 °C steps */
    for (int i = 0; i < 40; i++)
        Up();
    CHECK_EQ(s_m.edit, SCHED_BOOST_OFS_MAX);
    for (int i = 0; i < 40; i++)
        Down();
    CHECK_EQ(s_m.edit, 0);
    /* °F: temps step 1 °F, offset shown converted */
    Reset();
    s_c.fahrenheit = true;
    OpenSchedItem(kSchedItDayHeat);
    Up();
    CHECK_EQ(s_m.edit, MenuStepTemp(2000, 1, true));
    Reset();
    s_c.fahrenheit = true;
    OpenSchedItem(kSchedItBoostOfs);
    MenuGetView(&s_m, &s_c, &v);
    CHECK(strcmp(v.big, "0.9") == 0); /* 0.5 °C = 0.9 °F difference */
}

/** Timing out in a schedule editor returns home without an action. */
static void ScheduleEditTimeoutDiscards(void)
{
    Reset();
    OpenSchedItem(kSchedItDayHeat);
    Up();
    Up();
    MenuAction a = MenuTick(&s_m, s_t + MENU_TIMEOUT_MS);
    CHECK_EQ(a.kind, kMaNone);
    CHECK(MenuIsHome(&s_m));
}

/**
 * Every schedule editor driven to its maximum yields a value SchedSanitize() leaves unchanged (the menu never produces an out-of-range value).
 */
static void ScheduleActionRoundtrip(void)
{
    CtrlParams p = CTRL_PARAMS_DEFAULT();
    SchedCfg c = SCHED_CFG_DEFAULT();
    for (int it = 0; it < kSchedItCount; it++)
    {
        Reset();
        OpenSchedItem(it);
        for (int i = 0; i < 200; i++)
            Key(kMenuKeyUp, kBtnEvRepeat);
        MenuAction a = Sel();
        CHECK_EQ(a.kind, kMaSetSched);
        SchedSet(&c, (SchedItem)a.item, a.value);
        SchedCfg before = c;
        SchedSanitize(&p, &c);
        CHECK(memcmp(&before, &c, sizeof c) == 0); /* menu never produces an out-of-range value */
    }
}

/** Parse a difference shown as "0.5" or "-1.2" into tenths. Returns false if that isn't the shape. */
static bool ParseTenths(const char *pS, int *pOut)
{
    int sign = 1;
    if (*pS == '-')
    {
        sign = -1;
        pS++;
    }
    if (pS[0] < '0' || pS[0] > '9' || pS[1] != '.' || pS[2] < '0' || pS[2] > '9' || pS[3] != '\0')
        return false;
    *pOut = sign * ((pS[0] - '0') * 10 + (pS[2] - '0'));
    return true;
}

/**
 * The offset editor steps 0.1 °C, clamps to ±2.5 °C, saves tenths, and discards on timeout.
 * °F rounds each step to the nearest 0.1 °F (half away from zero) and every step changes the number.
 */
static void EditOffsetStepsAndRounds(void)
{
    MenuView v;
    Reset();
    s_c.calib = 15; /* 0.15 °C snaps to 0.2 °C on the way in */
    GotoItem(kMiOffset);
    Sel();
    CHECK_EQ(s_m.st, kMsEditOffset);
    CHECK_EQ(s_m.edit, 20);
    Sel(); /* save and return to the list, then reopen on a negative off-grid value */
    s_c.calib = -15;
    Sel();
    CHECK_EQ(s_m.edit, -20);
    Sel();
    s_c.calib = -40;
    Sel();
    CHECK_EQ(s_m.edit, -40);
    MenuGetView(&s_m, &s_c, &v);
    CHECK(strcmp(v.big, "-0.4") == 0);
    Up();
    MenuGetView(&s_m, &s_c, &v);
    CHECK(strcmp(v.big, "-0.3") == 0);
    MenuAction a = Sel();
    CHECK_EQ(a.kind, kMaSetOffset);
    CHECK_EQ(a.value, -3);
    CHECK_EQ(s_m.st, kMsList);
    MenuGetView(&s_m, &s_c, &v);
    CHECK(
        strcmp(
            v.value[kMiOffset],
            "-0.4\x7f"
            "C") == 0); /* live context, not the unsaved edit */
    s_c.calib = -30;
    MenuGetView(&s_m, &s_c, &v);
    CHECK(
        strcmp(
            v.value[kMiOffset],
            "-0.3\x7f"
            "C") == 0);

    s_c.calib = 0;
    Sel();
    for (int i = 0; i < 40; i++)
        Up();
    CHECK_EQ(s_m.edit, MENU_CALIB_MAX);
    CHECK_EQ(Sel().value, 25);
    s_c.calib = MENU_CALIB_MAX;
    Sel();
    for (int i = 0; i < 60; i++)
        Down();
    CHECK_EQ(s_m.edit, MENU_CALIB_MIN);
    CHECK_EQ(Sel().value, -25);

    s_c.calib = 0;
    Sel();
    Up();
    CHECK_EQ(s_m.edit, MENU_CALIB_STEP);
    a = MenuTick(&s_m, s_t + MENU_TIMEOUT_MS);
    CHECK(MenuIsHome(&s_m));
    CHECK_EQ(a.kind, kMaNone);
    CHECK(a.fullRefresh);

    Reset();
    s_c.fahrenheit = true;
    s_c.calib = MENU_CALIB_MIN;
    GotoItem(kMiOffset);
    Sel();
    int prev = -1000;
    for (;;)
    {
        MenuGetView(&s_m, &s_c, &v);
        int shown = 0;
        CHECK(ParseTenths(v.big, &shown));
        CHECK(shown > prev);
        prev = shown;
        if (s_m.edit == MENU_CALIB_MAX)
            break;
        Up();
    }
    MenuGetView(&s_m, &s_c, &v);
    CHECK(strcmp(v.big, "4.5") == 0);
    s_m.edit = 10;
    MenuGetView(&s_m, &s_c, &v);
    CHECK(strcmp(v.big, "0.2") == 0); /* 0.18 °F rounds to 0.2 */
    s_m.edit = -10;
    MenuGetView(&s_m, &s_c, &v);
    CHECK(strcmp(v.big, "-0.2") == 0);
    s_m.edit = 30;
    MenuGetView(&s_m, &s_c, &v);
    CHECK(strcmp(v.big, "0.5") == 0); /* 0.54 °F rounds to 0.5 */
    s_m.edit = -30;
    MenuGetView(&s_m, &s_c, &v);
    CHECK(strcmp(v.big, "-0.5") == 0);
    s_c.fahrenheit = false;
    s_m.edit = -10;
    MenuGetView(&s_m, &s_c, &v);
    CHECK(strcmp(v.big, "-0.1") == 0);

    Reset();
    s_c.calib = 100;
    Sel();
    MenuGetView(&s_m, &s_c, &v);
    CHECK(
        strcmp(
            v.value[kMiOffset],
            "+1.0\x7f"
            "C") == 0);
}

/** The swing editor clamps to CTRL_SWING_MIN..MAX in 0.1 °C steps and saves. */
static void EditSwingClamps(void)
{
    Reset();
    GotoItem(kMiSwing);
    Sel();
    for (int i = 0; i < 20; i++)
        Up();
    CHECK_EQ(s_m.edit, CTRL_SWING_MAX);
    for (int i = 0; i < 20; i++)
        Key(kMenuKeyDown, kBtnEvRepeat);
    CHECK_EQ(s_m.edit, CTRL_SWING_MIN);
    Up();
    MenuAction a = Sel();
    CHECK_EQ(a.kind, kMaSetSwing);
    CHECK_EQ(a.value, 20);
}

/** The units editor toggles to °F and saves value 1. */
static void EditUnits(void)
{
    Reset();
    GotoItem(kMiUnits);
    Sel();
    Down();
    MenuAction a = Sel();
    CHECK_EQ(a.kind, kMaSetUnits);
    CHECK_EQ(a.value, 1);
}

/**
 * Boost to target (0.5 °C / 1 °F steps) and boost for N minutes (15 min grid, 15..120) start the right actions and return home.
 */
static void BoostTargetAndTimed(void)
{
    Reset();
    GotoItem(kMiBoost);
    Sel();
    CHECK_EQ(s_m.st, kMsBoost);
    Sel(); /* To target */
    CHECK_EQ(s_m.st, kMsEditBoostSp);
    Up();
    Up();
    MenuAction a = Sel();
    CHECK_EQ(a.kind, kMaBoostTarget);
    CHECK_EQ(a.value, 2300);
    CHECK(MenuIsHome(&s_m) && a.fullRefresh);

    s_c.fahrenheit = true; /* 1 °F steps */
    GotoItem(kMiBoost);
    Sel();
    Sel();
    Up();
    a = Sel();
    CHECK_EQ(a.value, 2278); /* 72 F -> 73 F (22.78 C) */

    s_c.boostMinutes = 37; /* from HA: snaps to the 15 min grid */
    GotoItem(kMiBoost);
    Sel();
    Down();
    Sel();
    CHECK_EQ(s_m.st, kMsEditBoostMin);
    CHECK_EQ(s_m.edit, 30);
    for (int i = 0; i < 10; i++)
        Up();
    CHECK_EQ(s_m.edit, 120);
    for (int i = 0; i < 10; i++)
        Down();
    CHECK_EQ(s_m.edit, 15);
    Up();
    a = Sel();
    CHECK_EQ(a.kind, kMaBoostTimed);
    CHECK_EQ(a.value, 30);
}

/** "Cancel boost" is only listed while a boost runs; without one the third row is Back. */
static void BoostCancelOnlyWhenActive(void)
{
    Reset();
    GotoItem(kMiBoost);
    Sel();
    Down();
    Down(); /* To target, For N, Back */
    Sel();
    CHECK_EQ(s_m.st, kMsList); /* that was Back */
    s_c.boostActive = true;
    Sel(); /* Boost again (cursor still on Boost) */
    CHECK_EQ(s_m.st, kMsBoost);
    Down();
    Down();
    MenuAction a = Sel();
    CHECK_EQ(a.kind, kMaBoostCancel);
    CHECK(MenuIsHome(&s_m));
}

/**
 * Clear safe mode is listed only while safe mode is on, just before Back. M opens the confirm
 * screen; M again emits kMaClearSafeMode, and any other key or the 10 s timeout returns home
 * without clearing.
 */
static void ClearSafeModeConfirm(void)
{
    MenuView v;
    Reset();
    Sel();
    MenuGetView(&s_m, &s_c, &v);
    CHECK_EQ(v.nRows, kMiCount - 1);
    CHECK(!strcmp(v.label[v.nRows - 2], "Device info"));
    CHECK(!strcmp(v.label[v.nRows - 1], "Back"));
    for (int i = 0; i < v.nRows; i++)
        CHECK(strcmp(v.label[i], "Clear safe mode") != 0);
    Up();
    CHECK_EQ(s_m.cursor, kMiBack);

    s_c.safeMode = true;
    MenuGetView(&s_m, &s_c, &v);
    CHECK_EQ(v.nRows, kMiCount);
    CHECK(!strcmp(v.label[kMiClearSafe], "Clear safe mode"));
    CHECK(!strcmp(v.label[kMiBack], "Back"));
    CHECK_EQ(v.sel, kMiBack); /* still on Back; Clear safe mode is the row above it */
    Up();
    CHECK_EQ(s_m.cursor, kMiClearSafe);
    MenuGetView(&s_m, &s_c, &v);
    CHECK_EQ(v.sel, kMiClearSafe);
    CHECK(!strcmp(v.label[v.sel], "Clear safe mode"));

    Sel();
    CHECK_EQ(s_m.st, kMsClearSafe);
    MenuGetView(&s_m, &s_c, &v);
    CHECK_EQ(v.kind, kViewWarning);
    CHECK_EQ(v.nRows, 3); /* title plus three lines; the last glyph row ends at y=112 */
    CHECK(!strcmp(v.label[0], "Clear safe mode, restart?"));
    CHECK(!strcmp(v.label[1], "M confirms"));
    CHECK(!strcmp(v.label[2], "Other key cancels"));
    CHECK(46 + (v.nRows - 1) * 24 + kFontSmall.height <= GFX_H);
    CHECK(GfxTextWidth(&kFontMed, v.title) <= GFX_W);
    for (int i = 0; i < v.nRows; i++)
        CHECK(GfxTextWidth(&kFontSmall, v.label[i]) <= GFX_W);

    CHECK_EQ(Up().kind, kMaNone);
    CHECK_EQ(s_m.st, kMsList);
    CHECK_EQ(s_m.cursor, kMiClearSafe);
    Sel();
    CHECK_EQ(Down().kind, kMaNone);
    CHECK_EQ(s_m.st, kMsList);
    Sel();
    CHECK_EQ(Key(kMenuKeyM, kBtnEvHold).kind, kMaNone);
    CHECK_EQ(s_m.st, kMsList);
    CHECK(!s_m.swallowM);
    Sel();
    CHECK_EQ(Key(kMenuKeyCombo, kBtnEvPress).kind, kMaNone);
    CHECK_EQ(s_m.st, kMsList);
    CHECK_EQ(s_m.cursor, kMiClearSafe);
    Down();
    Sel(); /* Back returns to the main screen */
    CHECK(MenuIsHome(&s_m));

    s_c.safeMode = true;
    Sel(); /* opening the menu starts at Mode */
    for (int i = 0; i < kMiClearSafe; i++)
        Down();
    CHECK_EQ(s_m.cursor, kMiClearSafe);
    Sel();
    CHECK_EQ(MenuTick(&s_m, s_t + MENU_TIMEOUT_MS - 1).kind, kMaNone);
    CHECK_EQ(s_m.st, kMsClearSafe);
    MenuAction a = MenuTick(&s_m, s_t + MENU_TIMEOUT_MS);
    CHECK(MenuIsHome(&s_m));
    CHECK_EQ(a.kind, kMaNone);
    CHECK(a.fullRefresh);

    Sel();
    for (int i = 0; i < kMiClearSafe; i++)
        Down();
    CHECK_EQ(s_m.cursor, kMiClearSafe);
    Down();
    CHECK_EQ(s_m.cursor, kMiBack);
    Up();
    CHECK_EQ(s_m.cursor, kMiClearSafe);
    Sel();
    a = Sel();
    CHECK_EQ(a.kind, kMaClearSafeMode);
    CHECK(MenuIsHome(&s_m));
    CHECK(a.fullRefresh);
}

/**
 * Holding M on the Zigbee screen pairs once and swallows the rest of that hold; a short M just goes back.
 */
static void ZigbeeHoldToPair(void)
{
    Reset();
    GotoItem(kMiZigbee);
    Sel();
    CHECK_EQ(s_m.st, kMsZigbee);
    MenuAction a = Key(kMenuKeyM, kBtnEvHold);
    CHECK_EQ(a.kind, kMaPair);
    CHECK(MenuIsHome(&s_m));
    /* the rest of that hold must not escalate into the home pairing/reset path */
    CHECK_EQ(Key(kMenuKeyM, kBtnEvLong).kind, kMaNone);
    CHECK_EQ(Key(kMenuKeyM, kBtnEvWarn).kind, kMaNone);
    CHECK_EQ(Key(kMenuKeyM, kBtnEvVlong).kind, kMaNone);
    CHECK_EQ(s_m.st, kMsHome);
    Key(kMenuKeyM, kBtnEvRelease);
    Sel();
    CHECK_EQ(s_m.st, kMsList); /* normal again */
    /* short M on the Zigbee screen goes back, no pairing */
    Reset();
    GotoItem(kMiZigbee);
    Sel();
    CHECK_EQ(Sel().kind, kMaNone);
    CHECK_EQ(s_m.st, kMsList);
}

/** FNV-1a over the frame. Two cursor positions that look the same hash the same. */
static U32 FrameSum(const GfxFb *pFb)
{
    U32 h = 2166136261u;
    for (int i = 0; i < EPD_FB_SIZE; i++)
    {
        h ^= pFb->buf[i];
        h *= 16777619u;
    }
    return h;
}

/** Write the frame as a plain PBM (P1). Defined with the other previews. */
static void WritePbm(const GfxFb *pFb, const char *pName);

/**
 * The value is drawn right-aligned, ending 10 px in from the panel. It has to start to the right
 * of the label, or the 32-character counter row runs off the 296 px glass and covers the label.
 */
static void RowFits(const MenuView *pV, int i)
{
    int labelEnd, valueW, valueX;
    if (!pV->value[i][0])
        return;
    labelEnd = 10 + GfxTextWidth(&kFontSmall, pV->label[i]);
    valueW = GfxTextWidth(&kFontSmall, pV->value[i]);
    valueX = GFX_W - 10 - valueW;
    CHECK(valueX >= 0);
    CHECK(valueX + valueW <= GFX_W - 10);
    CHECK(valueX >= labelEnd + 4);
}

/**
 * Device info leads with firmware and the sensor counters, then raw temperature, humidity and uptime.
 * It is a list: four rows visible, cursor drawn, Up/Down scrolls the rest into view.
 */
static void InfoScreen(void)
{
    const char *name[] = {
        "menu_info_row0.pbm",
        "menu_info_row1.pbm",
        "menu_info_row2.pbm",
        "menu_info_row3.pbm",
        "menu_info_row4.pbm",
        "menu_info_row5.pbm",
        "menu_info_row6.pbm",
    };
    MenuView v;
    U32 sum[7];
    Reset();
    s_c.sensorOk = 12;
    s_c.sensorMeas = 3;
    s_c.sensorReset = 7;
    s_c.sensorCrc = 9;
    s_c.sensorRetry = 4;
    s_c.sensorRst = 5;
    s_c.sensorGap = 2;
    GotoItem(kMiInfo);
    Sel();
    CHECK_EQ(s_m.st, kMsInfo);
    MenuGetView(&s_m, &s_c, &v);
    CHECK_EQ(v.kind, kViewList);
    CHECK_EQ(v.nRows, 7);
    CHECK(!strcmp(v.label[0], "Firmware"));
    CHECK(!strcmp(v.value[0], "0.2.0"));
    CHECK(!strcmp(v.label[1], "Sensor ok/err"));
    CHECK(!strcmp(v.value[1], "12/19"));
    CHECK(!strcmp(v.label[2], "Meas/rst/CRC"));
    CHECK(!strcmp(v.value[2], "3/7/9"));
    /* Up on the top row stays put. A missing guard wraps the U8 cursor to the bottom. */
    CHECK_EQ(s_m.scursor, 0);
    Up();
    MenuGetView(&s_m, &s_c, &v);
    CHECK_EQ(s_m.scursor, 0);
    CHECK_EQ(v.sel, 0);
    CHECK(!strcmp(v.label[3], "Retry/rst/gap"));
    CHECK(!strcmp(v.value[3], "4/5/2"));
    CHECK(!strcmp(
        v.value[4],
        "22.63\x7f"
        "C"));
    CHECK(!strcmp(v.value[5], "45.12%"));
    CHECK(!strcmp(v.value[6], "2d 03:07"));
    /* Every cursor position is a different frame, and the inverted row is actually drawn. */
    for (int sel = 0; sel < 7; sel++)
    {
        static GfxFb s_fb;
        DisplayModel m;
        int local = sel < 4 ? sel : 3;
        int y = 23 + local * 20;
        MenuGetView(&s_m, &s_c, &v);
        CHECK_EQ(v.kind, kViewList);
        CHECK_EQ(v.sel, sel);
        memset(&m, 0, sizeof m);
        m.view = v;
        DisplayRender(&s_fb, &m);
        WritePbm(&s_fb, name[sel]);
        sum[sel] = FrameSum(&s_fb);
        CHECK(GfxGet(&s_fb, 2, y));
        CHECK(!GfxGet(&s_fb, 2, sel == 0 ? 43 : 23));
        if (sel + 1 < 7)
            Down();
    }
    for (int i = 0; i < 7; i++)
        for (int j = i + 1; j < 7; j++)
            CHECK(sum[i] != sum[j]);
    Down();
    MenuGetView(&s_m, &s_c, &v);
    CHECK_EQ(v.sel, 6);
    /* The view clamps sel, so an off-by-one that walks scursor to INFO_ROWS still looks selected. */
    CHECK_EQ(s_m.scursor, 6);
    /* 99999 is still the full decimal. One more digit is abbreviated, and a full U32 (and the
     * ok/err sum of three of them, which is past 2^32) stays on the panel beside its label. */
    s_c.sensorOk = 99999u;
    s_c.sensorMeas = 99999u;
    s_c.sensorReset = 99999u;
    s_c.sensorCrc = 99999u;
    s_c.sensorRetry = 99999u;
    s_c.sensorRst = 99999u;
    s_c.sensorGap = 99999u;
    MenuGetView(&s_m, &s_c, &v);
    CHECK(!strcmp(v.value[1], "99999/299k"));
    CHECK(!strcmp(v.value[2], "99999/99999/99999"));
    CHECK(!strcmp(v.value[3], "99999/99999/99999"));
    for (int i = 0; i < v.nRows; i++)
        RowFits(&v, i);
    s_c.sensorOk = 100000u;
    s_c.sensorMeas = 100000u;
    s_c.sensorReset = 1000000u;
    s_c.sensorCrc = 10000000u;
    s_c.sensorRetry = 999999u;
    s_c.sensorRst = 9999999u;
    s_c.sensorGap = 1000000000u;
    MenuGetView(&s_m, &s_c, &v);
    CHECK(!strcmp(v.value[1], "100k/11M"));
    CHECK(!strcmp(v.value[2], "100k/1.0M/10M"));
    CHECK(!strcmp(v.value[3], "999k/9.9M/1.0B"));
    s_c.sensorOk = 0xffffffffu;
    s_c.sensorMeas = 0xffffffffu;
    s_c.sensorReset = 0xffffffffu;
    s_c.sensorCrc = 0xffffffffu;
    s_c.sensorRetry = 0xffffffffu;
    s_c.sensorRst = 0xffffffffu;
    s_c.sensorGap = 0xffffffffu;
    MenuGetView(&s_m, &s_c, &v);
    CHECK(!strcmp(v.value[1], "4.2B/12.8B"));
    CHECK(!strcmp(v.value[2], "4.2B/4.2B/4.2B"));
    CHECK(!strcmp(v.value[3], "4.2B/4.2B/4.2B"));
    for (int i = 0; i < v.nRows; i++)
        RowFits(&v, i);
    /* 999,999,999 is the top of the whole-millions form. */
    s_c.sensorOk = 999999999u;
    s_c.sensorMeas = 999999999u;
    s_c.sensorReset = 0;
    s_c.sensorCrc = 0;
    s_c.sensorRetry = 0;
    s_c.sensorRst = 0;
    s_c.sensorGap = 0;
    MenuGetView(&s_m, &s_c, &v);
    CHECK(!strcmp(v.value[1], "999M/999M"));
    CHECK(!strcmp(v.value[2], "999M/0/0"));
    CHECK(!strcmp(v.value[3], "0/0/0"));
    for (int i = 0; i < v.nRows; i++)
        RowFits(&v, i);
    /* 17 visible characters. The git suffix stays; a semver that already fits is kept whole. */
    s_c.pFwVersion = "0.3.0-g7c9d421-dirty";
    MenuGetView(&s_m, &s_c, &v);
    CHECK(!strcmp(v.value[0], "g7c9d421-dirty"));
    RowFits(&v, 0);
    s_c.pFwVersion = "0.3.0-g7c9d421";
    MenuGetView(&s_m, &s_c, &v);
    CHECK(!strcmp(v.value[0], "0.3.0-g7c9d421"));
    s_c.pFwVersion = "0.3.0-abcdefghijklmnopqrstuvwxyz";
    MenuGetView(&s_m, &s_c, &v);
    CHECK(!strcmp(v.value[0], "jklmnopqrstuvwxyz"));
    /* 18 characters, no hyphen: the column keeps the last 17, not the first 17. */
    s_c.pFwVersion = "abcdefghijklmnopqr";
    MenuGetView(&s_m, &s_c, &v);
    CHECK(!strcmp(v.value[0], "bcdefghijklmnopqr"));
    /* A 17-character suffix fills the column exactly. */
    s_c.pFwVersion = "0.3.0-abcdefghijklmnopq";
    MenuGetView(&s_m, &s_c, &v);
    CHECK(!strcmp(v.value[0], "abcdefghijklmnopq"));
    /* 20 characters and a trailing hyphen: the suffix is empty, so the column keeps the last 17. */
    s_c.pFwVersion = "abcdefghijklmnopqrs-";
    MenuGetView(&s_m, &s_c, &v);
    CHECK(!strcmp(v.value[0], "defghijklmnopqrs-"));
    s_c.pFwVersion = NULL;
    MenuGetView(&s_m, &s_c, &v);
    CHECK(!strcmp(v.value[0], ""));
    s_c.pFwVersion = "";
    MenuGetView(&s_m, &s_c, &v);
    CHECK(!strcmp(v.value[0], ""));
    s_c.pFwVersion = "0.2.0";
    /* Leave and reopen so the cursor starts at the top again. Four Downs reach raw temp. */
    Sel();
    CHECK_EQ(s_m.st, kMsList);
    Sel();
    CHECK_EQ(s_m.st, kMsInfo);
    Down();
    Down();
    Down();
    Down();
    MenuGetView(&s_m, &s_c, &v);
    CHECK_EQ(v.sel, 4);
    Up();
    MenuGetView(&s_m, &s_c, &v);
    CHECK_EQ(v.sel, 3);
}

/**
 * Drive the real button debouncer with MODE held for `ms` (released afterwards if `release`)
 * and feed its events to the menu, counting pair and factory-reset actions.
 *
 * Returns the last action that did something or asked for a redraw.
 */
static MenuAction HoldM(int ms, bool release, int *pNPair, int *pNReset)
{
    Btn b;
    BtnInit(&b, false);
    for (int t = 0; t < 50; t += BTN_TICK_MS)
        BtnTick(&b, false); /* key seen released after boot */
    MenuAction last = {0};
    for (int t = 0; t < ms + (release ? 200 : 0); t += BTN_TICK_MS)
    {
        BtnEvent e = BtnTick(&b, t < ms);
        s_t += BTN_TICK_MS;
        if (e == kBtnEvNone)
            continue;
        MenuAction a = MenuOnKey(&s_m, &s_c, kMenuKeyM, e, s_t);
        if (a.kind == kMaPair)
            (*pNPair)++;
        if (a.kind == kMaFactoryReset)
            (*pNReset)++;
        if (a.kind != kMaNone || a.redraw)
            last = a;
    }
    return last;
}

/**
 * MODE hold thresholds on the main screen: menu, nothing, pair banner, pair at release, reset warning, cancel, factory reset; holds inside the menu are harmless.
 */
static void ModeHoldTimings(void)
{
    int p, r;
    MenuView v;
    Reset();
    p = r = 0;
    HoldM(800, true, &p, &r); /* short press: menu */
    CHECK_EQ(s_m.st, kMsList);
    CHECK_EQ(p, 0);

    Reset();
    p = r = 0;
    HoldM(3000, true, &p, &r); /* 3 s: nothing */
    CHECK(s_m.st == kMsHome && p == 0 && r == 0);

    Reset();
    p = r = 0;
    HoldM(5200, false, &p, &r); /* reach 5 s: banner, no pairing yet */
    CHECK_EQ(s_m.st, kMsHoldPair);
    CHECK_EQ(p, 0);
    MenuGetView(&s_m, &s_c, &v);
    CHECK_EQ(v.kind, kViewHomeBanner);

    Reset();
    p = r = 0;
    HoldM(6500, true, &p, &r); /* release between 5 and 8 s: pair once */
    CHECK_EQ(p, 1);
    CHECK_EQ(r, 0);
    CHECK_EQ(s_m.st, kMsHome);

    Reset();
    p = r = 0;
    MenuAction a = HoldM(8200, false, &p, &r); /* 8 s: warning, full refresh */
    CHECK_EQ(s_m.st, kMsHoldReset);
    CHECK(a.fullRefresh);
    CHECK_EQ(p, 0);
    MenuGetView(&s_m, &s_c, &v);
    CHECK_EQ(v.kind, kViewWarning);

    Reset();
    p = r = 0;
    a = HoldM(12000, true, &p, &r); /* release before 15 s: cancelled, screen restored */
    CHECK_EQ(p, 0);
    CHECK_EQ(r, 0);
    CHECK_EQ(s_m.st, kMsHome);
    CHECK(a.fullRefresh);

    Reset();
    p = r = 0;
    HoldM(15100, true, &p, &r); /* 15 s: reset, never pairing */
    CHECK_EQ(r, 1);
    CHECK_EQ(p, 0);

    Reset();
    p = r = 0; /* holds inside the menu do nothing dangerous */
    Sel();
    HoldM(16000, true, &p, &r);
    CHECK(p == 0 && r == 0 && s_m.st == kMsList);
}

/** MenuStepTemp() snaps to the 0.5 °C grid and steps 1 °F in Fahrenheit. */
static void StepTemp(void)
{
    CHECK_EQ(MenuStepTemp(2010, 1, false), 2050);
    CHECK_EQ(MenuStepTemp(2000, -1, false), 1950);
    CHECK_EQ(MenuStepTemp(2000, 1, true), 2056); /* 68 F -> 69 F */
}

/* ---- previews ---- */

/**
 * Write the frame as a plain PBM (P1) image for visual review; silently skipped if the file can't be opened.
 */
static void WritePbm(const GfxFb *pFb, const char *pName)
{
    FILE *pF = fopen(pName, "w");
    if (!pF)
        return;
    fprintf(pF, "P1\n%d %d\n", GFX_W, GFX_H);
    for (int y = 0; y < GFX_H; y++)
    {
        for (int x = 0; x < GFX_W; x++)
            fputc(GfxGet(pFb, x, y) ? '1' : '0', pF);
        fputc('\n', pF);
    }
    fclose(pF);
}

/** Render the current menu view over a fixed home model and save it as a PBM preview. */
static void Shot(const char *pName)
{
    static GfxFb s_fb;
    DisplayModel m;
    memset(&m, 0, sizeof m);
    m.tempValid = true;
    m.temp = 2150;
    m.rhValid = true;
    m.rh = 4500;
    m.s = (CtrlSettings){.mode = kCtrlModeHeat, .fan = kCtrlFanAuto, .heatSp = 2100, .coolSp = 2450};
    m.link = kLinkJoined;
    m.schedState = 1; /* clock synced: Day */
    m.fahrenheit = s_c.fahrenheit;
    m.swing = s_c.swing;
    MenuGetView(&s_m, &s_c, &m.view);
    DisplayRender(&s_fb, &m);
    /* nothing drawn past the right edge in list/text screens except highlight/scroll marks */
    WritePbm(&s_fb, pName);
}

/** Reset() for the docs previews: same context in °F, so every screenshot uses one unit. */
static void PreviewReset(void)
{
    Reset();
    s_c.fahrenheit = true;
}

/**
 * Render PBM previews of every menu screen (written to the working directory) and check the main list row count.
 */
static void RenderMenuPreviews(void)
{
    PreviewReset();
    Sel();
    Shot("menu_main.pbm");
    for (int i = 0; i < 5; i++)
        Down();
    Shot("menu_main_scrolled.pbm");
    PreviewReset();
    GotoItem(kMiMode);
    Sel();
    Shot("menu_mode.pbm");
    PreviewReset();
    s_c.boostActive = true;
    GotoItem(kMiBoost);
    Sel();
    Shot("menu_boost.pbm");
    Sel();
    Shot("menu_boost_target.pbm");
    PreviewReset();
    GotoItem(kMiBoost);
    Sel();
    Down();
    Sel();
    Shot("menu_boost_minutes.pbm");
    PreviewReset();
    GotoItem(kMiSwing);
    Sel();
    Shot("menu_swing_f.pbm");
    PreviewReset();
    s_c.calib = -120; /* -1.2 °C, which rounds to -2.2 °F */
    GotoItem(kMiOffset);
    Sel();
    Shot("menu_offset_f.pbm");
    PreviewReset();
    GotoItem(kMiUnits);
    Sel();
    Shot("menu_units.pbm");
    PreviewReset();
    GotoItem(kMiSched);
    Sel();
    Shot("menu_schedule.pbm");
    for (int i = 0; i < 5; i++)
        Down();
    Shot("menu_schedule_scrolled.pbm");
    PreviewReset();
    OpenSchedItem(kSchedItDayHeatStart);
    Shot("menu_schedule_time.pbm");
    PreviewReset();
    OpenSchedItem(kSchedItNightHeat);
    Shot("menu_schedule_temp.pbm");
    PreviewReset();
    OpenSchedItem(kSchedItBoostMin);
    Shot("menu_schedule_boost.pbm");
    PreviewReset();
    OpenSchedItem(kSchedItBoostOfs);
    Shot("menu_schedule_offset.pbm");
    PreviewReset();
    GotoItem(kMiZigbee);
    Sel();
    Shot("menu_zigbee.pbm");
    PreviewReset();
    GotoItem(kMiInfo);
    Sel();
    Shot("menu_info.pbm");
    PreviewReset();
    s_m.st = kMsHoldPair;
    Shot("menu_hold_pair.pbm");
    PreviewReset();
    s_m.st = kMsHoldReset;
    Shot("menu_reset_warning.pbm");
    PreviewReset();
    s_c.safeMode = true;
    GotoItem(kMiClearSafe);
    Sel();
    Shot("menu_clear_safe.pbm");
    /* every label/value must fit: check the text in the list view is not clipped into the value column */
    Reset();
    Sel();
    MenuView v;
    MenuGetView(&s_m, &s_c, &v);
    CHECK_EQ(v.nRows, kMiCount - 1); /* Clear safe mode is hidden */
    CHECK(!strcmp(v.label[v.nRows - 1], "Back"));
}

/** Run every menu test; exit status 1 if any failed (tinytest DONE()). */
int main(void)
{
    RUN(HomeKeysPassThrough);
    RUN(NavigationWrapsAndBack);
    RUN(TimeoutDiscardsEdit);
    RUN(OpenAfterLongIdleDoesNotTimeOut);
    RUN(TickBeforeLastKeyDoesNotClose);
    RUN(EditModeSaves);
    RUN(EditFanToggles);
    RUN(ScheduleListShowsAllKnobs);
    RUN(ScheduleTimeStepsWrap);
    RUN(ScheduleTempAndBoostClamps);
    RUN(ScheduleEditTimeoutDiscards);
    RUN(ScheduleActionRoundtrip);
    RUN(EditSwingClamps);
    RUN(EditOffsetStepsAndRounds);
    RUN(EditUnits);
    RUN(BoostTargetAndTimed);
    RUN(BoostCancelOnlyWhenActive);
    RUN(ClearSafeModeConfirm);
    RUN(ZigbeeHoldToPair);
    RUN(InfoScreen);
    RUN(ModeHoldTimings);
    RUN(StepTemp);
    RUN(RenderMenuPreviews);
    DONE();
}
