Connicpu/thermostat/firmware/test/hootl/scenarios.py

"""HOOTL scenarios. Every scenario also runs the W/Y/G safety monitor (hootl.safety_monitor).

Conventions: times are virtual ms after the first power-on. The coordinator is
up and permits joining unless a scenario says otherwise ("zb coord down").
Default settings: mode OFF, day heat 20.0 °C, day cool 24.5 °C, swing 0.5 °C.
"""
from hootl import scenario, SEC, MIN, HOUR, W, Y, G, WDI, WDEN

OFF, COOL, HEAT = 0, 3, 4
LINK_OFFLINE, LINK_PAIRING, LINK_JOINED, LINK_LOST, LINK_FAULT = range(5)


def heating(s, temp=1800, t=5 * SEC):
    s.temp(0, temp)
    s.mode(t, HEAT)


def ui_heat(s, temp=1800, t=5 * SEC):
    """Select HEAT with the buttons only (M menu, M edit Mode, UP = HEAT, M save)."""
    s.temp(0, temp)
    for k, b in enumerate(("mode", "mode", "up", "mode")):
        s.press(t + k * SEC, b, 200)


def cooling(s, temp=2700, t=5 * SEC):
    s.temp(0, temp)
    s.mode(t, COOL)


def heats(r, after, before=None, msg="W should come on"):
    r.check(any(r.pin(W, t) for t in range(after, before or after + 1, 250)) or r.rises(W, after, before), msg)


def w_on_between(r, t0, t1):
    return r.high_ms(W, t0, t1) > 0


# =============================================================================
# 0. basics
# =============================================================================

@scenario("boot_idle", until=2 * MIN)
def boot_idle(s):
    """Cold boot, mode OFF: config loaded, outputs off, joins, screen drawn."""
    s.temp(0, 2100)
    def check(r):
        r.expect(r"EVT cfg loaded")
        r.expect(r"EVT link 2", before=10 * SEC, msg="joins the coordinator")
        r.expect(r"EVT ctrl fault=OK", before=10 * SEC)
        r.expect(r"EPD refresh n=1 .*ink=([1-9]\d*)", before=5 * SEC, msg="first screen drawn")
        r.check(r.high_ms(W, 0, 2 * MIN) + r.high_ms(Y, 0, 2 * MIN) + r.high_ms(G, 0, 2 * MIN) == 0, "all outputs off")
    return check


@scenario("heat_cycles_room_model", until=3 * HOUR)
def heat_cycles(s):
    """Heat mode against a room model: W cycles around 20 °C; min on/off and fan run-on hold."""
    s.room(0, 1800, 1000, heat=40, leak=2)
    s.mode(5 * SEC, HEAT)
    def check(r):
        on = r.rises(W)
        r.check(len(on) >= 3, f"heating should cycle (W rises {on})")
        r.check(on[0] >= 60 * SEC, "heat min off after boot")
        temps = [int(x.split("= ")[1]) for t, x in r.find_all(r"ZB attr 0x0402/0x0000 = ", after=HOUR)]
        r.check(temps and min(temps) > 1900 and max(temps) < 2100, f"holds 20 °C +-1 (got {min(temps)}..{max(temps)})")
        r.check(r.high_ms(Y, 0, 3 * HOUR) == 0, "no cooling in heat mode")
    return check


@scenario("cool_cycles_room_model", until=3 * HOUR)
def cool_cycles(s):
    """Cool mode against a hot room: Y cycles, G always with Y, 5 min compressor off time."""
    s.room(0, 2700, 3200, cool=40, leak=2)
    s.mode(5 * SEC, COOL)
    def check(r):
        on = r.rises(Y)
        r.check(len(on) >= 3, f"cooling should cycle ({on})")
        r.check(on[0] >= 5 * MIN, "compressor waits 5 min after boot")
        r.check(r.high_ms(W, 0, 3 * HOUR) == 0, "no heat in cool mode")
    return check


@scenario("changeover_heat_to_cool", until=40 * MIN)
def changeover(s):
    """Heating, then mode -> COOL with a hot room: Y waits for the 5 min changeover gap."""
    s.temp(0, 1800)
    s.mode(5 * SEC, HEAT)
    s.temp(10 * MIN, 2800)
    s.mode(10 * MIN, COOL)
    def check(r):
        w_off = r.find(r"^GPIO 0 0$", after=2 * MIN)
        y_on = r.rises(Y)
        r.check(w_off and y_on, "W off then Y on")
        r.check(y_on[0] - w_off >= 5 * MIN, "changeover gap")
    return check


@scenario("fan_on_and_auto", until=10 * MIN)
def fan_on(s):
    """Fan ON with mode OFF runs G alone; back to AUTO stops it."""
    s.temp(0, 2100)
    s.fan(30 * SEC, True)
    s.fan(5 * MIN, False)
    def check(r):
        r.check(r.pin(G, 1 * MIN) == 1, "G on with Fan ON")
        r.check(r.pin(G, 6 * MIN) == 0, "G off with Fan AUTO")
        r.check(r.high_ms(W, 0, 10 * MIN) + r.high_ms(Y, 0, 10 * MIN) == 0, "no W/Y")
    return check


@scenario("menu_navigation_buttons", until=2 * MIN)
def menu_nav(s):
    """Buttons only: M opens the menu, M edits Mode, UP changes it, M saves -> mode leaves OFF."""
    s.temp(0, 2100)
    s.press(10 * SEC, "mode", 200)
    s.press(12 * SEC, "mode", 200)
    s.press(14 * SEC, "up", 200)
    s.press(16 * SEC, "mode", 200)
    def check(r):
        r.expect(r"EPD refresh", after=10 * SEC, before=12 * SEC, msg="menu drawn")
        sp = r.setpoint()
        r.check(sp["mode"] == HEAT, f"OFF -> UP -> HEAT from the menu ({sp})")
        r.expect(r"NVS set tstat/cfg3", after=16 * SEC, msg="saved")
    return check


@scenario("menu_temperature_offset", until=1 * MIN)
def menu_offset(s):
    """Menu Offset, next to Swing. Each UP adds 0.1 °C; M saves it.

    The reported room temperature rises by that same 0.1 °C, and Device info's raw
    reading does not. A second step saves 2.
    """
    s.temp(0, 2100)
    s.set(0, "sht.noise", 0)  # the 0.1 °C step has to be exact, not buried in sensor noise
    t = 10 * SEC
    s.press(t, "mode", 200)  # open the menu
    for i in range(5):       # Mode, Fan, Boost, Schedule, Swing -> Offset
        s.press(t + (i + 1) * SEC, "down", 200)
    s.press(t + 6 * SEC, "mode", 200)  # edit
    s.press(t + 7 * SEC, "up", 200)    # 0 -> +0.1 °C
    s.press(t + 8 * SEC, "mode", 200)  # save, back to the list
    s.press(t + 9 * SEC, "mode", 200)  # edit again from the saved offset
    s.press(t + 10 * SEC, "up", 200)   # +0.2 °C
    s.press(t + 11 * SEC, "mode", 200) # save
    for i in range(3):                 # Units, Zigbee, Device info
        s.press(t + (12 + i) * SEC, "down", 200)
    s.press(t + 15 * SEC, "mode", 200) # open Device info
    def check(r):
        r.expect(r"ZB attr 0x0201/0x0010 = 1", after=t + 8 * SEC, msg="first tenth republished")
        r.expect(r"ZB attr 0x0201/0x0010 = 2", after=t + 11 * SEC, msg="second tenth republished")
        r.expect(r"ZB report 0x0201/0x0010", after=t + 8 * SEC, msg="ZHA does not poll this attribute")
        r.expect(r"NVS set tstat/cfg3", after=t + 8 * SEC, msg="saved")
        temps = [int(x.split("= ")[1]) for _, x in r.find_all(r"ZB attr 0x0201/0x0000 = ")]
        temps = [v for v in temps if v != -32768]  # invalid until the first reading
        r.check(len(temps) >= 3, f"local temperature published ({temps})")
        base = temps[0]
        r.check(all(v == base for v in temps[:-2]), f"steady before the offset changes ({temps})")
        r.check(temps[-2] == base + 10, f"+0.1 °C raises the reported temperature by 0.1 °C ({temps})")
        r.check(temps[-1] == base + 20, f"the next 0.1 °C does it again ({temps})")
        raws = [int(x.split("=")[1]) for _, x in r.find_all(r"EVT raw temp=", after=t + 15 * SEC)]
        r.check(raws == [base], f"raw temperature stays {base} with calibration removed ({raws})")
    return check


@scenario("home_up_down_setpoint", until=2 * MIN)
def home_updown(s):
    """Main screen in HEAT: UP raises, DOWN lowers the heat setpoint one step each."""
    heating(s, 2100)
    s.press(20 * SEC, "up", 100)
    s.press(30 * SEC, "down", 100)
    s.press(40 * SEC, "down", 100)
    def check(r):
        a, b, c = r.setpoint(25 * SEC)["heat"], r.setpoint(35 * SEC)["heat"], r.setpoint(45 * SEC)["heat"]
        r.check(a > 2000 and b == 2000 and c < 2000, f"setpoints {a} {b} {c}")
    return check


@scenario("remote_auto_write_refused", until=1 * MIN)
def auto_refused(s):
    """ZHA writes SystemMode=Auto (1): refused, attribute put back to HEAT."""
    heating(s)
    s.mode(20 * SEC, 1)
    def check(r):
        r.expect(r"unsupported system mode 1 ignored")
        r.expect(r"ZB attr 0x0201/0x001c = 4", after=20 * SEC + 1, msg="real mode re-published")
        r.check(r.setpoint()["mode"] == HEAT, "stays in HEAT")
    return check


@scenario("remote_setpoint_clamped", until=1 * MIN)
def sp_clamped(s):
    """A remote heat setpoint of 40 °C is clamped into the allowed range."""
    heating(s)
    s.heat_sp(20 * SEC, 4000)
    def check(r):
        r.check(r.setpoint()["heat"] <= 3200, f"clamped ({r.setpoint()})")
    return check


@scenario("schedule_morning_boost_mocked_time", until=4 * HOUR)
def sched_boost(s):
    """Clock 05:30: night 18 °C until 06:00, then day 20 °C + 0.5 °C morning boost for 2 h, then 20 °C."""
    heating(s, 1950)
    s.clock(0, 5, 30)
    def check(r):
        r.check(r.setpoint(20 * MIN)["heat"] == 1800 and r.setpoint(20 * MIN)["sched"] == 2, "night program")
        r.check(r.setpoint(40 * MIN)["heat"] == 2050 and r.setpoint(40 * MIN)["sched"] == 3, "day + boost")
        r.check(r.setpoint(3 * HOUR)["heat"] == 2000 and r.setpoint(3 * HOUR)["sched"] == 1, "day after boost")
        r.check(not w_on_between(r, 5 * MIN, 29 * MIN), "no heat at night (19.5 > 18)")
        r.check(w_on_between(r, 31 * MIN, 60 * MIN), "boost heats")
    return check


@scenario("timed_boost_combo", until=30 * MIN)
def timed_boost(s):
    """UP+DOWN together starts a timed boost; it heats even at setpoint and ends by itself."""
    heating(s, 2000)
    s.at(2 * MIN, "btn up press"); s.at(2 * MIN + 50, "btn down press")
    s.at(2 * MIN + 300, "btn up release"); s.at(2 * MIN + 300, "btn down release")
    def check(r):
        r.expect(r"boost cmd 2 -> result", after=2 * MIN)
        r.check(w_on_between(r, 2 * MIN, 10 * MIN), "boost heats")
    return check



@scenario("boost_switch_timed_heat_to_target_cool", until=40 * MIN)
def boost_switch(s):
    """A timed heat boost is replaced by a cool-to-target boost (the card's "Switch"): W stops,
    Y starts only after the changeover / compressor min-off, never together (safety monitor)."""
    heating(s, 2000)
    boost = "0xfc57"
    s.zb(1 * MIN, f"write {boost} 0x0002 u8 1")          # direction heat
    s.zb(1 * MIN + 100, f"write {boost} 0x0001 u16 30")  # 30 min
    s.zb(1 * MIN + 200, f"write {boost} 0x0003 u8 2")    # start timed
    s.zb(8 * MIN, f"write {boost} 0x0002 u8 2")          # direction cool
    s.zb(8 * MIN + 100, f"write {boost} 0x0000 s16 1800")
    s.zb(8 * MIN + 200, f"write {boost} 0x0003 u8 1")    # start to target: replaces the timed boost
    def check(r):
        r.expect(r"boost cmd 2 -> result 1", after=1 * MIN, before=2 * MIN, msg="timed heat boost started")
        r.check(w_on_between(r, 1 * MIN, 8 * MIN), "timed heat boost runs W")
        r.expect(r"boost cmd 1 -> result 1", after=8 * MIN, before=9 * MIN, msg="cool-to-target boost replaced it")
        t_w_off = next((t for t in range(8 * MIN, 40 * MIN, 250) if not r.pin(W, t)), None)
        r.check(t_w_off is not None, "W drops after the switch")
        r.check(r.high_ms(Y, 8 * MIN, 40 * MIN) > 0, "the cool boost runs Y")
        t_y_on = next((t for t in range(8 * MIN, 40 * MIN, 250) if r.pin(Y, t)), None)
        r.check(t_y_on is not None and t_w_off is not None and t_y_on > t_w_off, "Y only after W is off")
        r.check(r.high_ms(W, (t_y_on or 40 * MIN), 40 * MIN) == 0, "no W while the cool boost runs")
    return check

# =============================================================================
# 1. watchdogs, resets, boot loops
# =============================================================================

@scenario("stwd100_missed_kick_resets", until=3 * MIN, max_boots=2)
def stwd_missed(s):
    """Main loop hangs after the STWD100 is armed: it resets the chip in ~1.6 s; outputs off; next boot normal."""
    heating(s)
    s.set(0, "hang.boots", 1)
    s.set(0, "hang.after", 70 * SEC)
    def check(r):
        r.check(r.resets and r.resets[0][1] == "STWD100", f"STWD100 reset ({r.resets})")
        hang = r.expect(r"HANG app task")
        kick = r.last(r"^GPIO 10 ", before=hang + 1)[0]
        r.check(1590 <= r.resets[0][0] - kick <= 1700, f"reset {r.resets[0][0] - kick} ms after the last WDI edge (tWD 1.6 s)")
        heats(r, 3 * MIN - 1, msg="heating resumes after the reboot")
    return check


@scenario("task_wdt_before_stwd_armed", until=1 * MIN, max_boots=2)
def twdt(s):
    """Hang before the STWD100 is armed (t < 10 s): the task watchdog (5 s) resets instead."""
    s.temp(0, 2100)
    s.set(0, "hang.boots", 1)
    s.set(0, "hang.after", 3 * SEC)
    def check(r):
        r.check(r.resets and r.resets[0][1] == "TASK_WDT", f"{r.resets}")
    return check


@scenario("reset_mid_cool_keeps_compressor_off_time", until=30 * MIN, max_boots=2)
def reset_mid_cool(s):
    """Power cut while cooling: after reboot Y stays off >= 5 min (monitor), then cools again."""
    cooling(s)
    s.at(8 * MIN, "power cycle")
    def check(r):
        r.check(r.pin(Y, 8 * MIN - 1) == 1, "cooling before the reset")
        boot2 = r.boot_times[1]
        rises = r.rises(Y, after=boot2)
        r.check(rises and rises[0] - boot2 >= 5 * MIN, f"Y after reboot at {rises}")
    return check


@scenario("reset_mid_heat_keeps_heat_off_time", until=10 * MIN, max_boots=2)
def reset_mid_heat(s):
    """STWD100 reset while heating: W off through reset, back on >= 60 s after boot."""
    heating(s)
    s.set(0, "hang.boots", 1)
    s.set(0, "hang.after", 3 * MIN)
    def check(r):
        boot2 = r.boot_times[1]
        r.check(r.pin(W, boot2) == 0, "W low at reset")
        rises = r.rises(W, after=boot2)
        r.check(rises and rises[0] - boot2 >= 60 * SEC, f"W after reboot {rises}")
    return check


@scenario("boot_loop_enters_safe_mode", until=50 * MIN, max_boots=7)
def boot_loop(s):
    """Power-on + 4 STWD100 resets = 5 counted boots: the 5th stays up in SAFE MODE (outputs off,
    no STWD100), retries a normal boot after 30 min and heats again."""
    heating(s)
    s.set(0, "hang.boots", 4)
    s.set(0, "hang.after", 20 * SEC)
    def check(r):
        r.check(len(r.resets) >= 5, f"resets {r.resets}")
        t = r.expect(r"EVT safe mode: 5 resets")
        r.check(r.high_ms(W, t, t + 29 * MIN) == 0, "no heat in safe mode")
        r.never(r"arming STWD100", after=t, before=t + 29 * MIN)
        r.expect(r"EVT safe mode: retrying a normal boot", after=t + 29 * MIN)
        heats(r, 50 * MIN - 1, msg="heats after leaving safe mode")
    return check


# =============================================================================
# 2. SHT40
# =============================================================================

def sensor_fault(name, mode, doc, extra=None, recover=True):
    @scenario("sht40_" + name, until=20 * MIN, doc=doc)
    def fn(s):
        heating(s)
        s.fan(5 * SEC, True)                    # failsafe must stop even the Fan ON blower
        if extra:
            extra(s)
        s.set(3 * MIN, "sht.mode", mode)
        if recover:
            s.set(8 * MIN, "sht.mode", 0)
        def check(r):
            r.check(r.pin(W, 3 * MIN - 1) == 1 and r.pin(G, 3 * MIN - 1) == 1, "heating with fan before the fault")
            t = r.expect(r"EVT ctrl fault=SENSOR FAIL", after=3 * MIN, before=3 * MIN + 40 * SEC)
            r.check(r.high_ms(W, t + 1, 8 * MIN) + r.high_ms(G, t + 1, 8 * MIN) + r.high_ms(Y, t + 1, 8 * MIN) == 0,
                    "failsafe: everything off, including Fan ON")
            r.expect(r"EVT link 2", msg="Zigbee unaffected")
            if recover:
                ok = r.expect(r"EVT ctrl fault=OK", after=8 * MIN)
                r.check(ok - 8 * MIN >= 2 * 2000, "recovery only after 3 good readings")
                heats(r, 20 * MIN - 1, msg="heating resumes")
        return check
    return fn


sensor_fault("nak", 1, "SHT40 stops ACKing: failsafe (all off incl. Fan ON) within the 15 s timeout; recovers")
sensor_fault("bus_stuck_timeout", 2, "I2C bus stuck (every transfer times out): failsafe, bus resets, recovery")
sensor_fault("crc_error", 3, "every reading fails CRC: failsafe; recovery after 3 good readings")
sensor_fault("intermittent_100pct", 5, "intermittent NAK at 100%", extra=lambda s: s.set(0, "sht.p", 100))
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
