Connicpu/thermostat/(commit log)

2026-10-13 Thermostat V3: ESP32-C6 Zigbee, e-paper, JLC-ready
2026-10-13 V3 rev4: fix CPL/gerber origin, switch BOM grouping, basic-part swaps, silkscreen cleanup, cat logo
2026-10-13 V3 rev5: rear vertical HVAC terminal, low-profile C1, SHT40 island net rule, 3D-printable case (OpenSCAD/STL/3MF)
2026-10-13 V3 rev6: drywall-anchor case (146x70), multi-colour AMS parts + 3MF, no USB opening, 100V X7R bulk caps
2026-10-13 V3 rev7: rear right-angle HVAC terminal beside centred wire hole, deeper case standoffs
2026-10-13 Case: parametric pink swirl inlays (subtle default, bold variant)
2026-10-13 Case: bold open-spiral swirls default, drop front title text
2026-10-13 Case: fix non-manifold rib corner, preview-only inlay offset (no z-fighting), zoom render
2026-10-13 Rev 8: review fixes - J1 really at (70,58) rear, D3 SS210 100V, F1 60V PTC, SHDN 100k, C43 47uF/63V rear THT, T435-600B standard-gate triacs, antenna keepout, USB-C flush, 1mm HV pour clearance, test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
2026-10-13 Rev 9: R51 3.3R pulse-proof series resistor (bridge->bulk, TVS clamp ~58V at U1), L1 SWPA6045S220MT 22uH Isat 2.2A; regenerated fab (DRC/ERC 0); final review notes; exploded case+PCB renders
2026-10-13 Case fit check vs rev9 board: 1.1 mm board-edge gap (W/H 147x71, inner r1.2), lip notch under C43, 1.2 mm pocket under 15EDGK plug (11.1 mm), panel_gap 5.2 for L1, label moved out of wire hole, fix C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
2026-10-13 Rev 10: L1 moved off the EPD footprint (buck stage shifted left, hot loop ~6 mm^2), protected pre-routes; case +2 mm standoffs, pocket/notch removed, lip 5.5, panel_gap 5.0; fit check, STL/3MF/render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
2026-10-13 Firmware: configurable temperature swing (0.1-1.0 C, default 0.5) via ZHA/Z2M, NVS, e-paper
    - control: swing replaces fixed 0.3 C hysteresis; ctrl_set_swing/ctrl_clamp_swing; 6 new host tests
    - settings: NVS blob v3 with migration from v2
    - zigbee: manuf attr 0xFC57/0x0010 (uint16, 0.01 C), clamped on write
    - display: +/-swing next to RH
    - ZHA quirk: Temperature swing config number; Z2M: temperature_swing
    - dashboard: slider tile under the thermostat card; docs
2026-10-13 Renders: assembled 3/4 front view of closed V3 case on drywall
    Adds an 'assembled' view to renders/render.py (zero explode, EPD
    preview texture from firmware/docs, 1600x1100 Cycles) and saves
    renders/v3-assembled.png for Connie's pre-order review.
2026-10-13 Renders: fix washed-out lighting and colour management
    AgX MHC + bright world/area lights were flattening whites and
    crushing pink/orange PLA (exploded swirls rendered near-black).
    Switch to Standard, low world, key/fill with sun contact shadow,
    darker drywall, fix flush-inlay normals/z-fight, and drive the
    e-paper preview as sRGB emission. Re-rendered assembled + both
    exploded views.
2026-10-13 Renders: EPD preview fills the GDEY029T94 active area
    Blender 4.x plane size=1 is 1x1 mm, but the screen plane was still
    scaled by half (old 2x2 assumption), so display_preview.png covered
    only ~1/4 of the AA. Scale to the full 66.9x29.06 mm active area,
    apply scale into the mesh, and re-render assembled + exploded views.
    Case window is AA+0.5 mm (matches); preview is full-bleed 296x128.
2026-10-13 Firmware: on-device menu (mode, boost, swing, units, Zigbee, info) + 5/8/15 s M-hold pairing/reset
    - ui/menu.c: pure menu + hold state machine, 10 s idle timeout, edits discarded on timeout
    - buttons: HOLD 1.5 s / LONG 5 s / WARN 8 s / VLONG 15 s, RELEASE after a hold; pairing on release 5-8 s
    - display: list/value/text/warning views, full refresh on menu exit/warning (full_epoch); °C home setpoint fits
    - settings: NVS v4 adds display units (migrates v2/v3)
    - zigbee: boost setpoint/duration/swing changed on-device are written + reported; FW_VERSION 0.2.0
    - tests: test_menu (13), updated button timings; docs/display_menu_*.png previews; README
2026-10-13 Rev 11: Q2-Q4 T435-600B -> T405-600B-TR (C283473, IH 10 mA); refresh bom_prices; regen fab
2026-10-14 Rev 13: Ferdinand review fixes - opto-gap + 0.6mm HV/LV clearance rules and reroutes, neutral footprint names, MB10S symbol pins, USB silk note, part-plan rewrite
2026-10-14 rev 14: opto gaps F+B keepouts (0 mm² copper), HV clearances to 0.8 mm, 1.0 mm USB warnings, fresh gerbers
2026-10-14 fw 0.2.1: confirm current image when rollback is impossible
2026-10-14 fw 0.3.0: day/night program schedule with morning heat boost, Zigbee Time sync, fan mode in menu, remove Auto mode
    - schedule.c (pure, host-tested): separate heat/cool day/night periods (may cross midnight),
    morning heat boost (default +0.5 C for 120 min from day heat start 06:00), time unknown -> hold day
    - main setpoint (device or HA) edits the current program period, persisted (NVS blob v5, v2-v4 migrate)
    - 0xFC57 attrs 0x0020-0x0029 (RW, persisted, reported) + 0x002A schedule state; ZHA quirk + z2m updated
    - Time cluster client: LocalTime read from coordinator on join, hourly resync
    - Auto system mode and deadband removed; Auto writes refused and mode re-published
    - Fan On/Auto editabl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
2026-10-14 ZHA climate: off/heat/cool only via quirk; on-device schedule editor
    - quirk replaces Thermostat cluster: ControlSequenceOfOperation read as 0x06 so ZHA's own
    table yields [cool, heat, off]; Auto system_mode writes refused; tests incl. ZHA climate entity
    - dashboard card hvac_modes [off, heat, cool]; README documents routes and tradeoffs
    - menu Schedule submenu: all 10 knobs (HH:MM 15-min steps wrapping midnight, 0.5 C / 1 F temps,
    boost 0-240 min / 0-3.0 C), same clamps as Zigbee, persisted + reported; host tests + previews
2026-10-14 Address Ferdinand's v0.3.0 review; settings layout v1 without legacy migrations
    - settings: one versioned blob {version, persist_t} under the stable key "cfg", layout
    version 1 (nothing shipped: v2-v4 migrations dropped); unknown version/size -> defaults.
    Pure codec in main/settings_codec.c + host tests (test_settings)
    - schedule: morning boost clamped to end at night heating start, never fires when day and
    night heating start are equal; OFF mode reports the heating program's period
    - time sync: require plausible year (2024-2100) and TimeStatus Master/Synchronized when
    returned; retry backoff 1/2/5 min then hourly (pure zb_time.c + test_zb_time)
    - quirk docstring describes the Thermo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
2026-10-14 WIP zigbee: pure join/rejoin retry policy (backoff, flap protection, stall check) + host tests; not yet wired into zb_thermostat.c
2026-10-14 HOOTL: deterministic host simulation of the real firmware + 91 fault scenarios
    - test/hootl: real firmware sources built for the host against fake ESP-IDF/FreeRTOS
    (virtual-time cooperative kernel) and the real esp-zigbee-lib headers; models for
    SHT40 (fault injection + room model), STWD100, SSD1680 framebuffer capture, buttons,
    NVS, OTA slots/bootloader rollback, task WDT and a lowest-layer esp_zb fake.
    - hootl.py runner: seeded, per-scenario timeouts, reset/relaunch on the same state
    file, structured-log assertions and a W/Y/G safety monitor on every scenario.
    - Firmware fixes found by the scenarios: no ESP_ERROR_CHECK reboot loops (radio, NVS,
    outputs, UI); radio-fault link stat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
2026-10-14 Review fixes (Ferdinand): settled/debounced output readback with re-test, boot-loop counting, single trial boot
    1. hvac_outputs: verify the previous command on the next pass (>= 1 ms settle, past the
    C6 input synchroniser), fault only after 2 consecutive mismatches (gpio write errors
    stay immediate), raise G before Y and never Y without G, timed re-test after 10 min
    (> every min-off) while pads read all-off, max 3 per boot; cfg failure permanent.
    Fake models the synchroniser delay (stale same-instant reads) and read glitches;
    the old immediate readback fails heat/cool cycling under this model.
    2. Boot-loop guard ignores ESP_RST_SW (OTA, factory reset, safe-mode retry), counts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
2026-10-14 style: rename all own C code to project naming conventions
    - core.h fixed-width typedefs (U8..I64, F32, F64) replace stdint/float/double
    - PascalCase functions/types, camelCase locals/params/fields, s_/g_ scope
    prefixes, p pointer prefix, kCamelCase constants and enum values
    - vendor (ESP-IDF, esp-zigbee, FreeRTOS) names, Zigbee IDs, NVS keys and
    log strings unchanged; behavior-neutral (code size identical, rodata -8 B
    from __func__ strings)
    - tools/check_naming.py (libclang) wired into the CI host job
    - gen_font.py emits new names; README Code style section; quirk test reads
    renamed enum constants
2026-10-14 docs: Doxygen block comment on every struct and function
    Every struct and every function in our own C code (firmware, host tests,
    HOOTL fakes) now has a /** */ block comment: the full doc on the header
    prototype for public functions (brief on the definition), and the full doc
    on the definition for static functions. Comments were written from the code
    and two stale ones corrected along the way: HvacOutputsSet() returns the
    commanded state, not the pad readback, and the display_model.h banner field
    note was attached to the wrong field.
    tools/check_docs.py (libclang, same scope and databases as check_naming.py)
    fails CI when any struct or function lacks the block. The README Code style
    section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
2026-10-14 docs: prose-only doc comments (no Doxygen tags); check_docs rejects tags
    Connie prefers plain sentences over @brief/@param/@return clutter. Every
    tagged /** */ block is rewritten as flowing prose covering the same
    purpose, parameters, return value, units, side effects and locking.
    check_docs.py now also fails on any Doxygen tag in a doc block; README
    Code style updated.
2026-10-14 style: clang-format Allman/4-space (Microsoft base, pinned 19.1.7)
    Add firmware/.clang-format based on clang-format's Microsoft style
    (Allman braces, 4-space indent, ColumnLimit 120) with overrides for
    uniform braces on case/union, indented case labels, no include sorting,
    no comment reflow, and left-aligned macro backslashes. Single-statement
    if/for/while put the body on the next line (AllowShortIfStatementsOnASingleLine:
    Never).
    tools/format.sh formats our C (main/, components/, test/; excludes
    font_data.c). CI pins clang-format==19.1.7 and runs --dry-run -Werror.
    README Code style documents the rules.
    Behavior-neutral: ELF .text/.data/.bss unchanged (499220/104253/486967).
2026-10-14 style: case labels at switch column; one arg per line on long calls
    Connie's follow-up on style/clang-format:
    - IndentCaseLabels: false
    - AlignAfterOpenBracket: AlwaysBreak, BinPackArguments/Parameters: false
    (and AllowAll*OnNextLine: false) so a call that doesn't fit becomes
    one argument per line after the '('.
    TRY() in zb_thermostat.c stringifies its argument into the log; wrapping
    those manufacturer-attr calls would put a space after '(' into .rodata, so
    that block stays clang-format off. ELF text/data/bss match 8700012
    (499220/104253/486967); .text differs only by __LINE__ immediates.
2026-10-14 tidy: delete dead code
    HvacOutputsGet(), TempToDisplay() (FormatTemp() does the same math),
    BOARD_GPIO_BOOT and CtrlNextMode() had no callers. The CtrlNextMode
    checks go from the control test; its CtrlModeValid checks (old Auto
    0x01 rejected) stay, as ModeValid. No behavior change.
2026-10-14 tidy: fix stale deadband comments
    Describe the independent heat/cool setpoints as they are now rather than
    as the absence of a removed deadband. Comments only.
2026-10-14 tidy: share Clamp16 as a static inline in core.h
    control.c and schedule.c each had an identical private Clamp16(). No
    behavior change.
2026-10-14 tidy: share NowMs as a static inline in core.h
    main.c, display.c and zb_thermostat.c (as MonoMs) each had the same
    esp_timer millisecond wrapper. core.h now provides one, guarded by
    __has_include("esp_timer.h") so the pure-logic host tests, which have
    no esp_timer, still build. No behavior change.
2026-10-14 tidy: assert the UI callback and drop the duplicate LED latch
    UiInit() asserts cb instead of checking s_cb on every event. The LED is
    already latched high before gpio_config(), so the second
    gpio_set_level(BOARD_GPIO_LED, 1) after it is removed.
2026-10-14 ha: custom Lovelace card for the thermostat V3
    Single-file LitElement card (esbuild bundle in dist/, Lit and MDI paths
    inlined, no runtime network). Shows room temp/humidity and running
    state, the setpoint labelled with the program period it edits,
    Off/Heat/Cool and Fan On, the day/night schedule with a 24 h timeline,
    morning boost, manual boost and status. Entities are auto-discovered
    from the device by quirk translation_key, then entity_id suffix. Comes
    with a visual editor, vitest tests on a mocked hass, and a demo page
    with light/dark screenshots.
2026-10-14 card: make the setpoint a keyboard slider; focus rings on all buttons
    The setpoint value is role=slider (tabindex 0, aria-valuenow/min/max from
    min_temp/max_temp, aria-valuetext like '70 °F, Day heating'). Arrows step
    ±1, PageUp/PageDown ±5, Home/End go to min/max, all via _stepSetpoint().
    .fanbtn and .sec-h get the shared :focus-visible outline.
2026-10-14 card: review nits
    Debounce writes 500 ms (was 900). Unsent values are italic with a dotted
    underline, and their aria-label ends in 'sending…'. Remove the unused
    _fmtTemp(). README documents every option, including collapsed.
2026-10-14 ci: attach the card bundle to a GitHub release on card-v* tags
    Runs the tests, checks dist/ is fresh, then creates or updates the tag's
    release with dist/connie-thermostat-card.js. Workflow permissions are
    {}, the job gets contents: write only, checkout doesn't persist
    credentials, and actions are pinned by SHA. Documented in the card README.
2026-10-14 card: help text in (i) tooltips; boost sections above the schedule
    The setpoint caption, timeline legend and row help lines move into small
    info buttons. A tooltip opens on hover or focus and pins on click/tap;
    Esc or a click elsewhere closes it. Each is linked by aria-describedby,
    and the setpoint slider is described by its tooltip. Warnings stay
    visible banners. Boost and Morning heating boost now come before
    Program schedule, and Boost starts open.
2026-10-14 card: tooltips open above their row and stay inside the card
    The pinned setpoint tooltip covered the value and the + button. Every
    tooltip is now positioned against its row (.row/.legend/.setpoint),
    opens upward, and is at most as wide as the row. The setpoint one spans
    the setpoint box. npm run screenshots now opens each tooltip at 412 and
    320 px and fails if one leaves the card or covers its own controls.
    Also: Esc only stops propagation when it closed a tooltip (capture
    phase, so HA dialogs still get it otherwise), the period badge reads
    'Morning boost +1.8°F' (°C offset ×1.8 for °F users), a dark tooltip
    screenshot, and a stray indent fixed in styles.js.
2026-10-14 card: boost values live on the controls that use them
    Boost is now a Direction switch plus two tiles. 'Boost to target' and
    'Timed boost' each hold their value stepper and their Start button on
    one line. A running boost outlines its tile, shows the time left there,
    and its button becomes Stop (the separate Cancel button and the direction
    select are gone). Morning heating boost becomes two tiles, Duration and
    Offset, each with its own stepper. Tiles are role=group, labelled by
    their title. Start buttons say what they start, e.g. 'Start boost to 72°F'.
    The setpoint tooltip now opens in the flow under the badge, so it no
    longer covers the header's 'Heating ·' line. The geometry check also
    fa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
2026-10-14 card: boost review fixes (switch, offline, flush, click-only setpoint tip)
    - The firmware replaces a running boost when another starts
    (CtrlBoostStart: 'A running boost is replaced'), so while one runs the
    other tile's button reads 'Switch' (e.g. 'Switch to boost to 72°F').
    - Start, Stop and Direction are disabled while the thermostat is
    unavailable.
    - Start first flushes a still-debounced set_value for its own value, then
    presses. Its label uses the pending value, so it never starts with a
    stale target or length.
    - The in-flow setpoint tooltip opens on click/tap only, so hovering no
    longer shifts the −/+ row under the pointer. Floating tips still peek
    on hover and focus.
    -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
2026-10-14 hootl: scenario for switching a timed heat boost to a cool-to-target boost
    Covers the card's Switch path: the second start replaces the running boost,
    W drops before Y starts, and the safety monitor (interlock, changeover,
    min on/off) stays clean. Test-only.
2026-10-14 card: tint the top while actively heating or cooling
    Like HA's thermostat card: a low-alpha color-mix gradient of --ct-heat or
    --ct-cool, keyed on hvac_action (not the selected mode), fading out below
    the setpoint. No tint for idle, off, fan-only or unavailable.
2026-10-14 card: 10 s service-call timeout, dismissible error banner; v1.1.0
    Service calls race a 10 s timeout; no answer counts as a failure (banner,
    optimistic value dropped, dependent boost not started). Mode, fan and
    boost-direction calls now report failures too. The error banner gets a
    'Dismiss error' button, and disconnectedCallback clears its timer.
    Bump to 1.1.0 and add a changelog to the README.
2026-10-14 card: running boost tile uses the boost's heat/cool colour
    The running tile's outline, wash and run chip follow the boost direction
    (--ct-heat / --ct-cool, from the boost state) instead of the theme accent;
    an unknown direction keeps the accent. Colour is not the only cue: the run
    chip now reads 'Heating · 22 min left' / 'Cooling · Running', next to the
    header meta. Running morning-boost tiles use the heat colour.
    Adds a heat-boost demo scenario (full card + boost close-up, both themes)
    and includes it in the tooltip geometry check.
2026-10-14 card: contrast fixes for the run chip and boost buttons
    Run chip text is mixed 55% toward the text colour (border keeps the full
    heat/cool colour). Start/Switch use the primary colour darkened 30%, Stop the
    error colour darkened 20%, so white text clears 4.5:1 in both themes.
    Pins the quirk's BoostState names (Cooling_to_target -> cool, etc.) in a test.
    The screenshot script now measures chip and button contrast (WCAG, layers
    composited through the shadow roots) and fails below 4.5:1.
2026-10-15 docs: MANUFACTURER_ID research - no hobbyist range; suggest 0x434E
    Shared CSA/Matter ID space: assigned codes in 0x1000-0x19xx, CSA 0xC5Ax,
    test vendors 0xFFF1-0xFFF4 (dev only), reserved 0xFFF5-0xFFFF. 0x3000-0x5FFF
    is empty in zigbee-herdsman's database and the live Matter DCL registry.
    Recommend switching to 0x434E now (no devices in the field). Firmware still
    uses 0x131B.
2026-10-15 zigbee: own DIY manufacturer code 0x434E (replaces Espressif sample 0x131B)
2026-10-15 docs: README gallery (case render, device screens, HA card)
2026-10-15 display: show 24h HH:MM on the home status bar
    When the Zigbee clock is known, right-align 24-hour HH:MM on the home
    status bar and drop it if a fault or long banner would collide. Clock
    and sensor updates share one background slot: the next local minute
    once the clock is known, otherwise 3 minutes. A full de-ghost waits
    until 3 hours and 40 partials have both elapsed, with the 6 hour cap
    kept, so once-a-minute partials do not flash every 20 updates.
2026-10-15 docs: show 24h HH:MM on home gallery and hero
    Regenerate the boost home previews from the host renderer with a synced
    21:05, and composite that clock onto the assembled case hero. The root
    gallery stays °F in the 2×2 screen grid. The unsynced cool/°C fault
    screen and the colliding banner still omit the digits.
2026-10-16 docs: add Arch flashing guide and fix pairing/ZHA text
    The guide follows CI (ESP-IDF v5.3.2), the locked 1.6.x Zigbee
    libraries, join backoff, button holds, and the quirk install steps.
    firmware/README pairing no longer says 10 s / 3 s, and ZHA always
    says to install the quirk.
2026-10-17 ci: smoke-boot the PM-off image under esp32sim
    Boot the variant image in esp32sim and fail on panic, reset, a second
    ROM boot, or a control task that stops logging. Ignore a display
    heartbeat stamped after the app task sampled the clock, so the stall
    check cannot wrap into a false fault.
2026-10-17 ci: point the stall comment at SensorRead and refresh the boot log
    The heartbeat can land ahead of the app task's clock sample while a
    failing SensorRead is in progress. Record the PM-off boot from this
    branch, and leave the cache steps on their implicit success check.
2026-10-17 Split the case into hot, middle, and sensor air zones.
    The triac end gets a chimney and the SHT40 end gets a bottom-fed duct.
    Rib S moves to board x119.0-120.6 so the USB-C rear peg and shield legs
    keep 0.5 mm, and both ribs close the end windows over the lip. The
    modeled cut in triac-induced sensor rise is about 10-25%, not measured.
2026-10-17 Raise the curtain so the 0805s beside it keep 0.5 mm.
    C17408's max body is 2.15 x 1.40 x 0.65 mm, and a 1.0 mm floor leaves about 0.47 mm at the corner on a thick board, so the floor is 1.1 mm. case_fit now checks those three parts and fails on interference. The airflow notes no longer treat taped vents as the old case, or -0.1 C as the configured offset.
2026-10-17 Describe both temperature-offset routes, and use only one.
    The build-time Kconfig offset and ZHA's LocalTemperatureCalibration add, so the notes no longer tell you to set the unmeasured -0.1 C guess through ZHA. case_fit's -0.05 mm slack is only for the designed board kiss.
2026-10-18 Ignore fw-v tags the image check would reject.
    Only fw-vX.Y.Z and fw-vX.Y.Z-rcN name the app version; fw-v0.3.1b and
    fw-v0.3.1-beta warn and fall back to version.txt plus the hash. Watch HEAD
    so a branch switch reconfigures with the reflog off. Document clearing a
    cached PROJECT_VER, since idf.py rejects -U, and note how the PM-off
    fixture was recorded.
2026-10-25 Make the temperature offset adjustable from the menu and the card.
    The menu Offset item, next to Swing, edits LocalTemperatureCalibration in 0.1 °C steps and saves through the same path as a Zigbee write. ZHA already exposes that attribute as a config number, so the quirk does not add a second one. Card 1.3.0 adds the control in Tuning & status and biases the write so ZHA's int(°C / 0.1) stores the tenth that was pressed.
2026-10-25 Keep temperature-offset writes inside ±2.5 °C.
    The card clamps the calibration nudge to the entity limits, so the end steps are accepted. The offset scenario checks that each 0.1 °C step moves the reported temperature the same way and that the raw reading does not, and a second step saves 2.
2026-10-27 Ignore a menu tick sampled before the key that opened the screen.
    The app samples the clock, then HandleButton stamps lastKeyMs from a later NowMs(), then MenuTick runs on that earlier sample. Unsigned subtraction underflows, so the menu closes at once on every screen. A tick earlier than the last key is not idle.
2026-10-27 Add a menu item that clears safe mode.
    Clear safe mode is listed just before Back only while the boot-loop guard is holding the outputs off. Confirming clears the boot counter and restarts; any other key returns to the list, and the menu timeout leaves without clearing.
    The host test joins the two confirm labels. Each label slot is 28 bytes, so the buffer is both slots: 27 characters, a space, 27 characters, and the NUL.
2026-10-27 Pin the failed-clear banner and cover an NVS open that fails.
    The status-bar band, native columns 0..23 of every row, after a clear that does not commit differs from the band before the menu opened. Before the menu that band is "SAFE MODE: repeated resets". After the failed clear it is "SAFE MODE: clear not saved", and that band is pinned. A confirm whose NVS open fails stays up, says the clear was not saved, and leaves the count at 5. The boot site keeps that count in a U8.
2026-10-27 Retry failed sensor reads and show the fault counters.
    Each cycle tries the SHT40 three times, about 20 ms apart, with a bus reset and a soft reset between tries. An acknowledged soft reset waits 2 ms. The failsafe timeout is 15 s, about seven samples at the 2 s period, and it still drops every output immediately. One invalid sample does not clear the recovery streak when the last good reading is still inside 4 s. Before the first reading, the screen says Starting sensor... for 10 s and the outputs stay off. The counters are on Device info and in an EVT line. There is no diagnostics cluster to publish them on.
2026-10-27 Size the device-info counters for a full U32.
2026-10-27 Hold Starting sensor... until the fault clears or 10 s.
    The line follows the sensor-timeout fault, not the first temperature. It ends when that fault clears or when 10 s have passed since boot, whichever comes first. A missed cycle zeroes the recovery streak again. Each failed try still resets the bus and sends 0x94, about 20 ms apart, so one bad transfer does not wait for the next 2 s read. Those retries are not a fix for a sensor that stays failed for minutes. The counters, split into measurement failures and soft-reset or bus-reset failures, are what a power-cycle log is for. Device info scrolls, with a cursor on every row.
2026-10-27 Repaint sensor faults promptly and keep the counters on the panel.
    The Device info value column was 33 characters, which grew AppTask and FactoryReset past the 4096 B stack. Factory reset overflowed; main had 52 B free there. The column is 18 characters now, and a count above 99999 is shortened so three of them fit the 296 px row. The app stack is 5248 B. With the sensor absent, esp32sim reports 1668 B free at boot, 1668 B on Device info, and 1092 B at factory reset.
    Starting sensor... and a sensor fault set the urgent refresh on the edge, so the glass updates in about half a second instead of waiting for the clock minute or the 3 min slot. A healthy sensor with no clock leaves the starting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
2026-10-27 Limit fault and starting-line repaints with a token bucket.
    A sensor-fault or Starting-sensor edge paints on the button path only while a token is left. The bucket holds 3 and gains one token every 60 s, and it never holds more than the burst. The latches still move when the bucket is empty, so the same edge is not painted again on the next loop. The starting line and a fault that appears or clears inside the same minute each take a token.
    HOOTL counts the refreshes. A sensor that is dead for 15.3 s and alive for 6.1 s, repeating, paints 10 times in 10 min. One out-of-range sample then three good ones, on an 8 s period, paints 12. A healthy sensor with no clock still paints twice, and a fau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
2026-10-27 Retry a sensor-edge paint when a token is available.
    The fault and starting-line latches move only when a token is spent. An empty bucket leaves the edge pending, and the next loop paints it as soon as a token returns. A frame that already matches the glass gives the token back. The bucket size is EDGE_PAINT_BURST.
    The glass catches up within a minute. The longest hold is 55.0 s for a dead/alive flap that ends healthy, and 53.0 s for an out-of-range flap, with the clock set or not. Both flaps paint 13 times in 10 min with no clock.
    Without a clock a flap is 62 partials in 60 min: the burst of 3, then one a minute. With the clock set the minute rollover still paints, so the same flap is 122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
2026-10-27 Cover the sensor-edge token return and the long version tail.
    The range flap with the clock set at 45 s, held out of range at 240 s and healthy at 250 s, returns a token charged to a frame the glass already shows. The OK at 254 s paints on the button path, and that run is 6 refreshes after 230 s. Device info keeps the last 17 characters of a 20-character version that ends in a hyphen. A flapping sensor with the clock set is up to 122 partials in 60 min.
2026-10-27 Make the token-return scenario fail when the token stays spent.
    The range flap continues from 270 s to 400 s. The OK at 254 s still refreshes by 254.5 s, and the run is 6 refreshes after 230 s. The Idle edge at 302 s is one of those six, and it spends a token a matching frame put back. The wear table says up to 122 partials with the clock set, the same bound as the prose.
2026-10-27 Hold the e-paper on a carrier so the flex can be latched on the bench.
    The panel, the carrier, and the board go together before the shell does.
    The tail is inserted and the latch closed in the open, then the shell
    only clamps the board and snaps onto the backplate.
2026-10-27 Snap the three face buttons into the shell so they stay with the cover.
    Each cap seats on a cone in the Ø5 hole and clicks behind a lip on the
    partition side. The stem still reaches the tact switch, and the caps
    go in from the inside before the shell meets the board.
2026-10-27 Give the panel hooks and the button leaves a free length PETG can bend.
    Hook beams are free for 5.4 mm with a 45 degree lead-in, 1.32% strain and 2.81 N. The button leaf is one 0.40 mm wall, 0.95% at a 0.30 mm insertion. A 4.6 mm panel gap puts 3.27 mm of tail in the slide-lock connector. case_fit.py checks strain, force, contact length, and the button tolerance stack.
2026-10-27 Give the panel a tool slot so one edge can be released, and print the button leaves without supports.
    Each hook beam has a slot at the shelf. Holding both hooks of one long edge out 0.32 mm takes 2.81 N each, then the glass slides sideways and lifts. The button leaf is a cantilever. A breakaway pillar and a 72 degree root let the caps slice with no support from 30 to 60 degrees. The shell and the hook shelves still take support, and that support comes off before assembly.
2026-10-27 Thin the hook beams so a service release stays under 2% strain.
    The glass needs the freed edge held out by its width minus the 36.06 mm shelf span: 0.44 to 0.84 mm, and 0.89 mm with 0.05 mm of air. A 0.42 mm beam is at 1.92% and 1.13 N per hook at that hold-out. Each hook has a 1.30 mm window and a wall facing the glass, so a 1.0 mm blade can push the beam. The service order opens the J4 slider before the glass moves.
2026-10-27 Lean the J4 pick through the side gap, and name the slider directions.
    The pick is a 66 degree blade with a handle along +x. case_fit sweeps that tool from shut to open and fails if it comes within 0.20 mm of the carrier, the fold, the glass, or the shell. A straight shaft through the fold is the control. Open is +x and shut is -x. The print-error lip row, the 0.10 to 0.60 mm slide, and the slot path are in the fit script.
2026-10-27 Hook the J4 slider open and lift the glass with no sideways slide.
    The pick is a 0.80 by 0.45 mm shim. Service rotates it about the elbow from -28 degrees, 0.60 mm high, then lowers the lip onto the pull face and pulls +x by 0.85 mm. case_fit gates that contact and the sweep against the carrier, the fold, the glass, and J2. The shell is off and is not a gate. A straight +x shove of the seated hook hits the fold. 55 degrees hits J2 and 90 degrees hits the carrier. The stroke is the 0.85 mm latch projection. The free pull is 2.09 mm, and a longer stroke fails. Release holds both edges out 0.595 mm and lifts. Sideways travel is 0, which fits the guide play. The strain gate is Ultimaker PETG fle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
2026-10-27 Hook the J4 ear and check the assumed stroke from 0.85 mm to 1.30 mm.
    The tongue's +x face bears on the upper ear's -x face at x 102.775, in the 0.10 mm slot in front of the housing at 102.675. DIM E is 5.20 and DIM F is 6.45. The 0.85 mm callout is the solder-tab foot, and the drawing states no stroke, so the gate walks the pull from 0.85 mm through 1.30 mm. Mesh samples are seeded. The -0.10 mm guide stack stays printed.
2026-10-27 Rest the display panel on the carrier and clip the shell only to the backplate.
    The panel sits on the pads. Long-edge fences and the cable-end posts locate it, and there is no hook and no release step. The shell snaps only to the backplate bumps. The climb is 0.50 mm over 21.2 mm, 0.40% strain and 3.59 N, inside the 2.4% PETG gate. The shell stays clear of the panel, the fold, and the board while it lifts off. A fingertip shuts the J4 slider with the panel held up. The captive button leaves stay, because they only keep the caps in the shell.
2026-10-27 Record the J4 height from the STEP and drop the unconfirmed side-view pair.
    The WRL in the repo is 17.60 by 5.20 by 2.00 mm. DIM B stays 12.60. The 3.90 mm side-view run leaves 1.30 mm when it is taken off DIM E, and the STEP block in front of the housing face stays 1.10 mm.
2026-10-27 Bound the panel float and record the seated slider pose.
    The shell skin leaves 0.19–1.21 mm of rise, and a tall print allows 0.07 mm before the tail drops under 3.0 mm. The fit now fails that float, including a 1.0 mm recess, and it gates the fingernail shut on the seated panel. Opening the slider by finger is reported as not achievable. The shell stays clear of the panel until Connie picks a stop.
2026-10-27 Add the insertion-depth marks and quote the float that fails.
    The fins join the cable-end posts, so the carrier stays one solid. Nominal rise leaves 2.17 mm of tail inserted, and the tight rise on a tall print leaves 2.81 mm. The fit still fails that gate. The exploded preview shows the marks.
2026-10-27 Hold the display panel with a carrier lip and open J4 by finger.
    The lip sits 0.20 mm above the panel and the shell does not touch it. The gap is 4.45 mm, so a tall print plus that rise still leaves 3.03 mm of tail in J4, and a short print leaves 0.35 mm over the optos. A fingertip on the carrier push drives the slider toward +x while the panel stays seated. The press is 0.28 N and 1.16% strain.
2026-10-29 Show the display panel from the front of each cut.
    The section views face the cut from above, with the panel, fence, bridge, and land in frame. An exploded stack and a J4 close-up sit beside them.
2026-10-29 Set the land 0.30 mm under the panel front and print that shell.
    The beam is flush with the nominal front. The fit checks the whole display panel outside the land boxes, and both checkers require the shell to be one body. A thick corner stays at 1.18% strain.
2026-10-29 Print the current shell from docs/case-r7/shell.3mf and seed the bridge checker.
    shell.3mf carries case/shell_white.stl with a stock P2S slice: Generic PETG, Textured PEI, 0.20 mm layers, 15% infill. shell_hold_check.py samples the shell from fixed seeds, so the border reading repeats run to run. case-section-j1.png is the close view of the J1 pin-row cut, with C43, the header, the plug and the backplate.
